1979711854/riscv-cpu-fpga/doc/board/README.md

# 本地板实测证据（盘古 MES2L676-200HP）

> 采集方式：`scripts\serial_monitor.ps1 -Port COM4`
> （COM4 = `Silicon Labs CP210x USB to UART Bridge`，板载 USB-UART；COM12/COM13 是 JTAG 下载器的 FTDI 通道）
>
> 板上资源：`clk=D18`(27MHz 晶振)、`resetn=C22`、`UART=B24/C24`、LED/KEY 见
> `pds/RV32I_1/RV32I_1.fdc` 头部注释。

> [!] **当前口径（2026-10-17）：`feat/mem128k` 交付 = rev1028 单一位流 `b45941d6`**
> 76.5052 MHz（`STATIC_RATIO0=15.0`）+ 顺序双发射 + `EARLY_LD` + `LANEB_MEM=1`、Cache 全关、`A_EXT=0`；
> 每迭代 **217,036.1** 拍（仿真 217,088）⇒ **主分 4.6075 CoreMark/MHz**、经典分 **352.5**
> （ITER=3900，`Total ticks 846,440,591` = 11.0638 s），四 CRC `e9f5/e714/1fd7/8e3a`；
> CPU 域 **+0.304 ns / 0 失败端点（21,135）/ Fmax 78.3269**、LUT **7,740**、`All Constraints Met`。
> 日志 `uart_20261017_190201.txt`；**唯一数字源** `doc/reports/2026-10-17_delivery_rev1028.md`。
> **更优候选 rev1029（`c642c0ac`：LUT 6,932、指标③ +11.7%、拍数逐位不变、已上板）在 `feat/lut`，未合并。**

> **[OK] 2026-10-19 T7 演示线（分支 `feat/coremark-display`）**：combined 位流
> **`6E2D6020…`**（17:01:11，boot + CoreMark + RT，48,270 行 / 24,135 字），76.5052 MHz、
> CPU 域 **+0.304 ns / 0 失败端点（21,135）/ Fmax 78.3269**；RT-Thread 堆 **1,440B**；
> 裸机 CoreMark **352.5**（`Total ticks 846,440,591`，四 CRC 全对）。
> 日志 `uart_20261019_184426.txt`：标题/菜单/AI 完整一局约 195 s 无 TRAP、堆恒定 1440B；
> 复位问题未复现；`vblank timeout` 每次 boot 都打印但画面正常（STATUS 位误报）。
> **注意：RT 终端屏是邮箱成绩重放，不是 RT-Thread 跑 CoreMark。**

> [!] **下面是 2026-10-16 的历史口径（rev1027 / 85.0051 MHz / `c6af65be` / 391.66 分）—— 只作对照，禁止引用到交付页**
> **历史口径（2026-10-16，rev1027 = 1 档）：85.0051 MHz + 顺序双发射 + `EARLY_LD` + A1（乘法器 II=1）
> + RAS(16)/BTB(256) + **`LANEB_MEM=1`（lane B 放 load）**，**A 扩展默认关（`A_EXT=0`）**、Cache 全关** ——
> 每迭代 **217,036.1** 拍（仿真 217,088）⇒ **[OK] 已板上实测 `391.66` 分**（ITER=4332，
> `Total ticks 940,200,316` = **11.0605 s**，四 CRC `e9f5/e714/1fd7/8e3a` 与仿真**逐位一致**、
> `Correct operation validated`，日志 `uart_20261016_155605.txt`；位流 **`c6af65be`** / `RTL=0x20261027`，
> PDS CPU 域 **+0.277 ns / Fmax 87.0549 MHz**，布局**钉 `gplace_seed 5`**）。
> ⇒ **主分（CoreMark/MHz）从 4.3555 升到 4.6064（+5.76%）**；同次运行的经典分从 370.31 升到
> 391.66（= 效率 × 主频，**参考口径、非主分**；赛题公式 `Score = Iterations ÷ Total_ticks`
> 直算主频约掉，见任务书 v12 §0.1）。
> **[OK] 演示档也已切到 1 档（2026-10-16 16:30）—— 两个交付档现在同为 rev1027 / `LANEB_MEM=1`**：
> 位流 **`e51ac9e5`**（`RTL=0x20261027`，CPU 域 **+0.277 ns / Fmax 87.0549 MHz**，同样钉 `gplace_seed 5`），
> 上板四条判据全过（banner / render+AI 两条线程 / `[hb]` 5000→50000 无断 / **真按键接 HDMI 下完一局
> 判出 `WHITE wins`**、`D18` 常亮、显示正常），日志 **`uart_20261016_163009.txt`**（333 行）。
> 0 档演示档 `1e2075e6`（rev1023）降为历史参照，**别再烧**。
>
> **[OK] 2026-10-16 深夜：T6 整合后重出演示档 —— `e51ac9e5` → `5909a2d0`**。
> 队友 T6 改了 gomoku 固件（`mem.hex` 21046→**22028** 行）⇒ 演示档必须重出。
> **[!] 重出前先把 A1（lane B 放 store）从树里退回** —— A1 虽判【不采纳】但实现留在树里，
> 而关档只折叠 FF、没折叠逻辑 ⇒ 净表 LUT +122 ⇒ **钉住的 `gplace_seed 5` 余量作废**
> （实测 `+0.277 → −0.156 ns`，85 MHz 下 5 个失败端点）⇒ 直接重出会出**时序不过**的位流。
> 退回后 **`5909a2d0`**（2026-10-16 23:18:53 综合）：CPU 域 **+0.277 ns / 0 端点（19,114）/
> Fmax 87.0549 MHz**、LUT **7,767**（历史记 7,753，差 14 = 报数抖动）/ FF 3,691 —— **与 `c6af65be` 逐位相同**。
> **`e51ac9e5` 降为"T6 前的前一档"**（16:30 那次上板四条判据全过，留作 T6 前的历史对照）。
> **[ ] `5909a2d0` 板上待验**：原四条判据 + **T6 新增两条**（标题屏竖排菜单可见、↑/↓ 移光标、←/→ 改值；
> 棋盘外框 + 坐标轴 A-O / 1-15、落子后最后一手有红标）。
> **[!] 位流 md5 不是布局指纹**：同一布局两次构建 md5 就不同（`9b58e84c`/`28f8ae6b`、
> `2e966285`/`c1b7e279`/`c6af65be`），而 `RTL` 自证行与 `9b58e84c` **同为 `0x20261027`**
> ⇒ 判"板上烧的是哪颗"**只能靠 md5 + 日志时间**，不能靠 `RTL=` 行。
>
> [!] **上一代口径（2026-10-15，rev1023 = 0 档）：85.0051 MHz + 顺序双发射 + 任务C `EARLY_LD` + A1（乘法器 II=1）
> + RAS(16)/BTB(256)，**A 扩展默认关（`A_EXT=0`）**、Cache 全关** ——
> 每迭代 **229,597** 拍 ⇒ **[OK] 已板上实测 370.31 分**（ITER=4332，
> 跑分档位流 `55fae69e` / `RTL=0x20261023`，日志 `uart_20261015_234123.txt`）。
> 两个交付位流都已板上验证：跑分档 **`55fae69e`**（370.31 分）、
> 演示档 **`1e2075e6`**（RT-Thread 五子棋，四条判据 + HDMI 显示全过，日志 `uart_20261015_233418.txt`）。
> （PLL `STATIC_RATIO0` = 13.5；`cpu_top.v` 的 `DUAL_ISSUE = 1`、`EARLY_LD = 1`、
> `DCACHE_EN` / `ICACHE_EN` 默认 0；见 `doc/board_bringup.md`）。
> [!] **灯（`cpu_top_board.v:178-182`，`DEBUG_LED=1`）**：`led[0]`=pll_locked(**D19**)、
> `led[1]`=video_locked(**D18**)、`led[2]`=done(**D13**)。
> **注意：`D13`(done) 只在跑分档跑完后亮；RT-Thread 演示档不会亮，别误判成挂了。**
> （`D:\riscv-cpu-fpga` 存档仓的 `CLAUDE.md` 约定 26 写的是两年前的 "`led[1]=done`"，
> 那是 62MHz 时代的口径 —— **本仓的约定 26 是对的，别去"修"本仓的**。）
> **下面各节的 MHz 数、位流 md5、以及"当前设计"这类措辞，按【当时那一代】理解。**
>
> **最新两代（2026-10-11/12，本节顶部已单列）**：
> - 85.0051 MHz 双发射 + `EARLY_LD`：CoreMark **351.86**（ITER=4116），位流 `2ddaf32f`（无 Cache）
>   / **`2f7a4d0a`（只开 D-Cache，分数完全相同 —— **评估档**（提交档 = Cache 全关 @85.0051，见论文框架 §0.1））**，日志 `uart_20261011_225624.txt` /
>   `uart_20261012_002541.txt`
> - **I+D Cache 全开 @76.5052 MHz：CoreMark 325.96（A1 后，ITER=3800，位流 `da8ffd31`）；A1 前 313.63 / 位流 `c6b12d95`**，日志 `uart_20261012_155934.txt` / `uart_20261013_195230.txt`
> - ⚠️ I+D 的**前一版 `fa957dbd` 板上失败**（含 bug，只有 banner 循环）：
>   日志 `uart_20261012_010314.txt` / `_010344.txt`
>
> **最新一代（2026-10-14 13:59）**：**RT-Thread + I+D Cache @76.5052 MHz，位流 `90944754`（`RTL=0x20261019`）
> —— 两条根因修完后的第一颗带 Cache 位流，上板串口侧通过**（见本节顶部那节）**。
>
> **最新一代（2026-10-14 18:49）**：**裸机五子棋（T2/T3 菜单+HUD）@76.5052 MHz，位流 `dd4fecb4`
> （`RTL=0x20261019`，+0.773ns/0 端点）—— 两局实测 + 串口 29 快照复盘全合法**（见本节顶部那节）。
>
> 更早的各代见下方各节与 `doc/reports/2026-10-04_coremark_score.md`。

## 【[OK] T7 combined 三路径 + 渲染修复（2026-10-19 18:49，R5）

- 位流 **`6E2D6020…`**（17:01:11，combined：boot + CoreMark + RT），76.5052 MHz；
  RT-Thread 固件 build 16:49:39，`[boot] heap = 1440 bytes`。
- 日志 `uart_20261019_184426.txt`（372 行）：
  - 全日志**无 TRAP**；标题屏、菜单、子菜单、对局正常；
  - AI vs AI `NORMAL vs NORMAL` 完整一局约 **195 s**，每手 depth=4、0.3~1.9 s，
    `[hb]` 每 5 s 不断，**堆恒定 1440B**；
  - 官方 CoreMark：`Total ticks 846440591`、四 CRC 全对、354 iter/s；
  - 多次复位（对局后 / CoreMark 后 / 演示屏后）均正常回到标题页，
    **上次“只有背景色”未复现**；
  - `[!] vblank timeout` 每次 boot 都打印但画面正常 ⇒ **STATUS 位误报**。
- 修复：菜单最后一项金线改画 `row+1`；最后一手棋子用真实黑/白格 + 右上红三角
  （专用 tile 249/252），不再出现木色缺角。
- 关联日志：`uart_20261019_163401.txt`（首次 CoreMark + 演示屏）、
  `uart_20261019_163603.txt`（EASY/NORMAL 对局）。

## 【[ ] 1 档演示档 · **T6 版**重出（2026-10-16 23:18 综合）—— **板上待验**

> 位流 `rtthread_dual_noaext_ms_earlyld_a1_ras_btb_gomoku_g3_lanebmem_85mhz_rev1027_seed5pin_5909a2d0.sbit`
> （md5 **`5909a2d0`**，`RTL=0x20261027`，`LANEB_MEM=1`、Cache 全关、85.0051 MHz，
> **PDS CPU 域 +0.277 ns / 0 端点（19,114）/ Fmax 87.0549 MHz**，布局钉 `gplace_seed 5`；
> `scripts\build_bitstream.ps1 rtthread` 于 23:18:53 出，固件 **`mem.hex` 22028 行 / 11014 字**、sha256 守卫通过）。
> **与跑分档 `c6af65be` 同净表同种子**（LUT 7,767 / FF 3,691 / +0.277 ns 三个数逐位相同）。
> **[!] 烧之前核 md5 = `5909a2d0`**，并把 `generate_bitstream\cpu_top_board.sbit` 与
> `bitstreams\..._5909a2d0.sbit` 对一下 —— 约定 23：那个固定文件名看不出里面是哪一版。

| 判据 | 期望 |
|---|---|
| 版本自证 | `[build] FW=RTTHREAD-GOMOKU-G3 **RTL=0x20261027**` ✓（**rev1027 的 rtthread 位流现在有两颗**：本颗与 T6 前的 `e51ac9e5`，`RTL=` 行分不出来 —— 要靠 **T6 的菜单措辞**区分：新版打 `left/right = change value`，旧版打 `left/right = OK`）|
| 两条线程 | `[boot] gomoku render thread running` + `[boot] gomoku ai thread running` |
| 心跳 | `[hb] alive` 5000→50000 **十条无断** |
| 真下棋 | 接 HDMI 真按键下完一局判出 **`WHITE wins`**；`D18` 常亮、显示正常 |
| **T6 新增①** | **标题屏竖排菜单可见**；↑/↓ 移光标、←/→ 改值、长按确认进 HUMAN 子菜单 |
| **T6 新增②** | **棋盘外框 + 坐标轴（A-O / 1-15）**显示正常；落子后**最后一手有红标** |

> 灯：`D19`(pll_locked) / `D18`(video_locked) 常亮；**`D13`(done) 本变体不亮，别误判**。

## 【[OK] 1 档演示档（RT-Thread 五子棋）上板（2026-10-16 16:30）—— **四条判据全过**（**T6 前的前一档**）

> 位流 `rtthread_dual_noaext_ms_earlyld_a1_ras_btb_gomoku_g3_lanebmem_85mhz_rev1027_seed5pin_e51ac9e5.sbit`
> （md5 **`e51ac9e5`**，`RTL=0x20261027`，`LANEB_MEM=1`、Cache 全关、85.0051 MHz，
> **PDS CPU 域 +0.277 ns / 0 端点（19,114）/ Fmax 87.0549 MHz**，布局钉 `gplace_seed 5`；
> `scripts\build_bitstream.ps1 rtthread` 于 16:19:57 出，固件 `mem.hex` 21046 行 / 10523 字、sha256 守卫通过）。
> 日志 **`uart_20261016_163009.txt`**（333 行，16:30:10–16:31:10）。
> **这一版让"1 档统一定版"成立**：跑分档与演示档现在同为 rev1027 / `LANEB_MEM=1` 的同一份 `rtl/**`。

| 判据 | 实测 |
|---|---|
| 版本自证 | `[build] FW=RTTHREAD-GOMOKU-G3 **RTL=0x20261027**`（app 侧 `FW=GOMOKU RTL=0x20261027` 一致）✓ —— **rev1027 的 rtthread 位流只有这一颗**，旧档 `1e2075e6` 是 rev1023（会打 `0x20261023`）⇒ 自证即"烧对了" |
| render 线程 | `[boot] gomoku render thread running` ✓ |
| AI 线程 | `[boot] gomoku ai thread running` ✓ |
| 心跳（`[hb]`） | `uptime 5000 → 50000 ticks` 共 **10 条、每 5 s 一条、单调递增、无断** ✓（AI 思考 286~609 ms 期间照常）|
| **真按键 + HDMI 下完一局** | 串口镜像：光标 `H8→I8→J8→K8→L8→L9→L10` 逐步移动 + 落子 + AI 应手，**判出 `WHITE wins`**；回 `title` 后**第二局又开了**（`menu=MODE→DIFFICULTY→COLOR→start, level=NORMAL you=BLACK`）✓；**用户接 HDMI 显示器显示正常、`D18`(led[1]=video_locked) 常亮** ✓ |
| 灯 | `D19`(pll_locked) / `D18`(video_locked) 常亮；**`D13`(led[2]=done) 本变体不会亮，别误判** |

> **1 档功能仿真（顺手补上从 P3 起挂账的回归）**：`scripts\gomoku\run_sim.ps1`（端到端，真 CPU + 真 PPU）
> 首行自证 `SIM CONFIG: DUAL_ISSUE=1 EARLY_LD=1 LANEB_MEM=1` ⇒ **6/6 checks、`=== PASS ===`**
> （2026-10-16，24 min 墙钟；日志 `doc/reports/2026-10-16_gomoku_g3_lanebmem1_sim.txt`）。
> ⇒ 1 档现在"仿真 + 跑分上板 + 演示上板"三处证据齐了。

> [!] 同一日志第 31 行的 `[!] vblank timeout -- video not running (check D18 video_locked)`
> 仍是**已知假超时**（0 档 `1e2075e6` 的同款日志也有这句，而当时 D18 亮、画面正常）——**判据看 D18，不看这句话**。
> [!] **应用侧旁证（非受控测量）**：同一开局位置 `nodes=1287 depth=4`，本颗（rev1027 / 1 档 / 85.0051 MHz）
> 是 `t=569ms`；0 档 rev1019 的 RT-Thread 档（76.5052 MHz）是 `t=672ms`。含主频 +11.1% 与 lane B 的效率收益，
> 也含 RT-Thread 调度噪声 ⇒ **只当"应用侧也更快"的旁证，别当性能数字引用**。

## 【[OK] 1 档（lane B 放 load）跑分档上板（2026-10-16 15:56）—— **391.66 分**

> 位流 `coremark_dual_noaext_ms_earlyld_a1_ras_btb_lanebmem_85mhz_rev1027_seed5pin_c6af65be.sbit`
> （md5 **`c6af65be`**，`RTL=0x20261027`，`LANEB_MEM=1`、Cache 全关、85.0051 MHz，
> **PDS CPU 域 +0.277 ns / 0 端点（19,114）/ Fmax 87.0549 MHz**，布局钉 `gplace_seed 5`）。
> 日志 **`uart_20261016_155605.txt`**（20 行，一次跑完）。
> 这一版是 **1 档（`LANEB_MEM=1`）第一次上板**，也是 P3.5/P3.6 的交付候选。

| 判据 | 实测 |
|---|---|
| 版本自证 | 首行 `[build] FW=COREMARK RTL=0x20261027` ✓（**与 `9b58e84c` 同 REV，靠 md5 区分**）|
| `Total ticks` | **940,200,316** ÷ 85,005,100 = **11.0605 s** ⇒ **391.66 CoreMark**（经典分；**主分 = 10⁶ ÷ 217,036.1 = 4.6076 CoreMark/MHz**，`Iterations 4332`）|
| 拍/迭代 | **217,036.1**（仿真 217,088 ⇒ **−0.0239%**，在 ±0.04% 模型口径内 ✓）|
| `Correct operation validated` | ✓ |
| **四 CRC** | **`e9f5 / e714 / 1fd7 / 8e3a`** —— 与 0 档仿真/实测**逐位一致**（`crcfinal 0xa996` 亦同，因为 ITER 相同）✓ |
| 有效性 | 真实秒数 11.0605 s **≥ 10 s** ✓（余量 10.6%，0 档是 17.0%）|
| 得分对照 | **391.66 vs 0 档 370.31 ⇒ +5.76%**（同为 85.0051 MHz；主分口径 4.6076 vs 4.3555 CoreMark/MHz）|

> [!] 口径细节：日志里的 `Iterations/Sec 393` 是 `HAS_FLOAT=0` 的**整数截断假值**
> （4332 ÷ 截断成 11 的秒数），**真实得分 391.66**；`Total time (secs) 11` 同理。
> [!] 计时区间与 0 档完全一致（同一份 CoreMark 固件、ITER=4332），所以 940,200,316 与
> 994,412,748 的差**全是流水线效率**（每迭代 217,036 vs 229,551 拍），**不含任何提频**。

## 【[OK] CoreMark 跑分档对齐 rev1023 上板（2026-10-15 23:41）—— **370.31 分**

> 位流 `coremark_dual_noaext_ms_earlyld_a1_ras_btb_85mhz_rev1023_55fae69e.sbit`
> （md5 **`55fae69e`**，Cache 全关、85.0051MHz、CPU 域 +0.330ns/0 端点，ITER=4332）。
> 日志 **`uart_20261015_234123.txt`**（20 行）。

| 判据 | 实测 |
|---|---|
| 版本自证 | 首行 `[build] FW=COREMARK RTL=0x20261023` ✓ |
| `Total ticks` | **994,412,748** ÷ 85,005,100 = **11.6983 s** ⇒ **370.31 CoreMark**（`Iterations 4332`）|
| `Correct operation validated` | ✓ |
| **四 CRC** | **`e9f5 / e714 / 1fd7 / 8e3a`** —— 与仿真**逐位一致** ✓（最硬的判据）|
| 拍/迭代 | **229,550.5**（仿真 229,597，差 **−0.0203%**，在 ±0.04% 抖动内）|

> `crcfinal 0xa996` **不要比** —— 它是跨迭代累加器，必随 ITER 变（约定 29）。
> 日志里的 `Iterations/Sec 393` 与 `Total time (secs) 11` 都是 `HAS_FLOAT=0` 的**整数截断**，别用。

**意义**：在这之前，板上已验证的最好成绩是 `f64b977`（**rev1022、A 扩展还在**）的 370.23。
本颗把**新的生产口径**（rev1023 / `A_EXT=0`，省 441 LUT / 224 FF）也钉在了板上 ——
分数 370.23 → **370.31** 的 +0.02% 是**抖动**（两代在仿真里周期数逐位相同），
**不是性能变化**。此前的口径分裂就此消除：跑分档与演示档现在**同 RTL、同 DESIGN_REV**。

## 【[OK] RT-Thread 五子棋演示档对齐 rev1023 上板（2026-10-15 23:34）—— **应用场景必备项闭环**

> 位流 `rtthread_dual_noaext_ms_earlyld_a1_ras_btb_gomoku_g3_85mhz_rev1023_1e2075e6.sbit`
> （md5 **`1e2075e6`**，Cache 全关、85.0051MHz、CPU 域 +0.330ns/0 端点）。
> 日志 **`uart_20261015_233418.txt`**（58 行）。

**背景**：上一颗演示档 `176e0028` 是 **rev1022、A 扩展还在**的 RTL，而跑分档已走到
`55fae69e`（rev1023 / `A_EXT=0`）。**直接验 `176e0028` 等于验一颗不交付的位流** ——
正是 rev1017→rev1019 那次踩过的坑。故按新 RTL 重出本颗再验。
**`176e0028` 自此作废，不要再烧。**

| 判据 | 实测 |
|---|---|
| 版本自证 | 首行 `[build] FW=RTTHREAD-GOMOKU-G3 **RTL=0x20261023**` ✓（读 `mimpid`，运行时取 ⇒ 位流权威自证，不是烧成旧的） |
| render 线程 | `[boot] gomoku render thread running` ✓ |
| AI 线程 | `[boot] gomoku ai thread running` ✓ |
| 心跳 | `[hb] alive, uptime 5000 → 25000 ticks` 五条、每 5 s 一条、**单调递增、无断** ✓（`[hb]` 能挤进来 = render 没独占 CPU，**这正是 G3 的前提**） |
| **显示侧** | **用户接 HDMI 显示器下棋正常；板上 `D18`（led[1]=`video_locked`）常亮** ✓ |
| 交互 | 菜单真的走通：`menu=MODE` → `menu=DIFFICULTY` → `menu=COLOR` → `start, level=EASY you=BLACK`；串口棋盘镜像渲染出完整 15×15 + `cursor=H8 you=BLACK turn=BLACK` ✓ |

**[OK] `[!] vblank timeout` 就此定案为【假超时】**：本颗日志同样打这句（第 31 行，
字面是 `video not running`），而 **D18 亮着、显示器画面正常** ⇒ 它**不是"显示坏了"**，
而是软件采样粒度问题（`rt_thread_mdelay(1)` ≈ 1 ms 采样去看 62.7 µs 的 vsync 脉冲，
见本节 T1/G3 那节的完整机制与 A/B/C 三个处理方案）。**判据看 D18，不看这句话。**

**灯**：`D19`(led[0]=pll_locked) 与 **`D18`(led[1]=video_locked) 常亮**；
**`D13`(led[2]=done) 本变体不会亮，别误判**。

## 【[OK] 裸机五子棋 T2/T3 整合版上板（2026-10-14 18:49 / 18:53 两局）—— CPU 侧无问题

> 位流 `gomoku_dual_aext_ms_earlyld_a1_76mhz_rev1019_dd4fecb4.sbit`（md5 `dd4fecb4`，
> Cache 全关、76.5052MHz、CPU 域 +0.773ns/0 端点）。日志 `uart_20261014_184921.txt`（人机局，183 行）/
> `uart_20261014_185341.txt`（AI 对弈局 HARD vs NORMAL，421 行）。

**这是队友 T2/T3 交接包并入 `dualissue`（commit `96e0722`）后的第一颗裸机 gomoku 位流**，
要验三件事：菜单交互、整局规则、CPU 有没有问题。复盘工具：`python scripts\gomoku\replay_log.py <日志>`
（逐快照校验落子合法性/轮色/`*` 标记/五连，29 个快照**零冲突**）。

| 判据 | 实测 |
|---|---|
| 版本自证 | 首行 `[build] FW=GOMOKU RTL=0x20261019` ✓ |
| 菜单 | MODE→(HUMAN)DIFFICULTY→COLOR 三确认开局；每项变化都有串口反馈（`menu=`/`mode=`/`you=`/`black=`/`white=`/`step=`） |
| 整局规则 | 人机局 AI 在 N8 挡住人的四连、随后 G5 成**竖五连 G5-G9** ⇒ `WHITE wins`，相位正确转 GAME_OVER、无续走；AI 对弈局 14+ 手全合法（中途回标题重开也正常） |
| CPU 侧 | **无问题**：零棋子变色、零非法落子、判胜正确、无 `[!] vblank timeout`（接了显示器） |
| 已知显示偏差 | AI `t=` 低约 10%（`CPU_HZ` 写死 85,005,100，任务书 v4 §3.3）；长按阈值约 0.67s |

**[!] 手工复盘踩过的坑**：`WHITE wins` 出现在**人落子之后**曾被人误判"判胜颜色错/游戏没停"——
实际是那一帧人落子 O9、下一帧 AI 在 G5 成五，串口顺序 `cursor=O9` → `WHITE wins` → `AI moved` → 快照。
**手工数列对齐必错，用 replay_log.py。** 三个固件小瑕疵（回标题假 `AI moved` / `AI thinking` 死路径 /
`t=` 偏差）见任务书 v4 §3，归五子棋线。

## 【[OK] RT-Thread + I+D Cache @76.5052 MHz（rev 1019）上板 —— 之前确定性挂死的组合，现在通了（2026-10-14 13:59 / 14:11 两次）

> 两次抓取、同一颗位流：13:59 验"起得来、活过 20 s"；**14:11 验"真按键下完一局 + 接屏下棋正常"**。

日志 `uart_20261014_135935.txt`（抓 27 s / 30 行）。位流
`rtthread_dual_aext_ms_earlyld_a1_gomoku_g3_idcache_76mhz_rev1019_90944754.sbit`（md5 `90944754`）。

**这一颗要验的就是"带 Cache 的 RT-Thread 到底还挂不挂"** —— 同样是 **I+D Cache 全开 @76.5052 MHz**，
修复前那两颗的表现是：`c10a2478` 死在"AI 第一手后的第一张棋盘快照"（只有一行 `?? turn=WHITE`），
`9feaa089` 卡在 `[boot] heap = 9368 bytes` 循环重启（banner 打 3 次）。**现在两条线程都起来、
调度器活过 20 s。**

| 判据 | 实测 |
|---|---|
| **版本自证（权威）** | `[build] FW=RTTHREAD-GOMOKU-G3 RTL=0x20261019` ✓（五子棋侧同句：`FW=GOMOKU RTL=0x20261019`）|
| 两条线程都起来 | `[boot] gomoku render thread running` + `[boot] gomoku ai thread running` ✓ |
| 调度器在跑 / render 没独占 CPU | `[hb] alive, uptime 5000 / 10000 / 15000 / 20000 ticks` —— 每 5 s 一条、**单调递增、全程无断** ✓ |
| 时钟确实是 76.5052 而非 85 | 串口文本在 115200 下**完全可读**（`UART_DIV=664` 只对 76.5 MHz 成立；若真是 85 MHz 会偏 11% ⇒ 乱码）|
| **落子/对局 + 接屏** | **[OK] 追加验证（14:11，见下）：完整下完一局并判出胜负 `WHITE wins`；用户接显示屏下棋正常** |

### [OK] 追加验证 1：**完整对局 + 判定胜负**（2026-10-14 14:11，日志 `uart_20261014_141147.txt`，413 行）

同一颗位流（`RTL=0x20261019`），这次是**真按键下棋**：

| 判据 | 实测 |
|---|---|
| 按键全通 | 光标移动（`cursor=H8/G8/I8/…`）、落子、**难度切换**（`level=0 EASY` / `level=1 NORMAL` / `level=2 HARD`）、`SW3=reset` 都有响应 |
| **人机对局跑完整局** | 人执黑落 H8/G8/I8/L8/N8/N9… → **`WHITE wins`**（含五连判定） |
| **AI 线程真在算**（邮箱往返链） | NORMAL：`AI moved, nodes=1287/756/996/707/435 depth=4 t=398~672ms`；**HARD**：`AI moved, nodes=10592 depth=6 t=5737ms` |
| 调度器 | `[hb] alive, uptime 5000…25000 ticks`，每 5 s 一条、**全程无断**（AI 思考 5.7 s 期间画面/按键仍响应 = G3 的正题）|
| 显示侧（用户口述） | **接 HDMI 显示器下棋正常** —— T1/G3 那节留的"显示侧未验"到此关闭 |

> **[OK] 末尾那 3 次重新启动已确认 = 用户按了 `SW3`（本板设计上的复位键）**，不是异常重启
> （真崩溃是寄存器转储 + `[hb]` 断，不会是这样干净重打 banner）。**这项不再列为待查项。**

### [OK] 追加验证 2：接屏**下棋正常**（用户口述，2026-10-14）
`doc/board/README.md` 里 T1/G3 那节留的"显示侧未测"就此关闭。
（"AI 思考期间画面不卡"属同一现象的正常表现，但**没有逐帧量化** —— 答辩若要引用，
建议补一段录像或计时，别把"没卡"写成"已量化"。）

* [!] **踩到的坑（已修源码，未重出位流）**：横幅第 10 行打的是 `@85.0051MHz`，而本颗跑 76.5052 MHz
  —— 因为 `scripts/rtthread/app/main.c` 把主频**写死在字符串里**了（与位流/时钟无关，看着像烧错位流）。
  已改成从 `BOARD_SYSTEM_CLOCK_HZ` 算（`app/main.c:173` 的 `rt_kprintf`）。**判位流永远看 `RTL=` 那行。**
* [!] **已知噪声（不是失败）**：`[!] vblank timeout -- video not running` —— 同一句在无 Cache 的
  `8894cdcb` 日志里也有，机制见下面 T1/G3 那节（1 ms 采样 vs 63 µs 脉冲）。
  **它不是"显示坏了"**（用户已接屏下棋正常），**而是"vblank 等待变成了一次概率事件"**：
  * 固件（`scripts/gomoku/video_port.c:62`）在等 `VIDEO_STATUS` bit0；RT-Thread 侧
    `video_vblank_yield()` 是 `rt_thread_mdelay(1)` ⇒ **采样周期 ≈1 ms**；
  * 而 `rtl/video/video_core.v:139` 的状态位是 `vs_ph` —— **V_SYNC=2 行 ≈ 62.7 µs** 的脉冲，
    两者**异步时钟域**（tick 由 CPU 侧 1 ms 定时器驱动，脉冲由 pixel PLL 的 16.67 ms 帧驱动）；
  * ⇒ **命中是概率性的**：脉冲宽/采样周期 ≈ **6%**（按"最近一次采样距脉冲 ≤62.7 µs"算 ≈12%/帧）。
    等不到的调用由 **50 ms 超时**（`VIDEO_VBLANK_TIMEOUT_MS`，≈3 帧）兜底返回 ⇒
    **多数等待会走超时路径**，帧率与同步都不是设计意图（告警按设计"只打一次"，所以日志里只有一行）。
  * 裸机版没有 yield（空实现、紧忙等）⇒ 连续轮询必定捕获，所以 23 份裸机日志里从没这句 ✓。
  **怎么处理（三选一，成本递增、鲁棒性递增）**：
  | 方案 | 做什么 | 代价 | 效果 |
  |---|---|---|---|
  | **C（兜底）** | 把这行降级成 `[i]`（或连续 N 次失败才打）+ 文档写清机制 | 零 RTL 改动 | 日志干净了，但**同步依然是失效的** |
  | **B（小改）** | 状态位判据从"vsync 脉冲(62.7 µs)"换成"处于消隐期(后肩 33 行 ≈ 1.04 ms)" | RTL 一行（`video_core.v` 的 `vblank_s` 源）+ 回归 | 1 ms 采样能命中，**但 1.04 ms 窗 vs 1 ms 周期太临界**（`mdelay(1)` 实际可能 >1.04 ms）|
  | **A（推荐）** | **新增一个只读【帧计数器】**（每个 vsync +1，不动旧的脉冲位），固件改成"等帧号变化" | RTL ~4 行 + 固件 ~5 行 + 回归 + 重出位流 | **采样率无关**，`video_wait_vblank` 真正工作；旧位留着不破坏裸机路径 |
  * 归口：`rtl/video/**` 属视频线（**要申请**，见任务书 §5）；固件侧属五子棋线。
    回归 = `tb_video*` / `tb_gomoku` + `scripts\rtthread\run_sim.ps1 -ICache` + 上板。
* 另有一处 **~11% 的软性偏差**（本次未动）：`scripts/demo/addr_map.h:68` 的 `CPU_HZ` 写死 85,005,100u，
  它喂 `hw_ticks_per_ms()` ⇒ 76.5 档下 long-press 的 0.6 s 阈值实际约 0.67 s、AI 打印的 `t=…ms` 约低 10%。
  **纯阈值/显示，不影响功能**；要修得绑到 `BOARD_SYSTEM_CLOCK_HZ`（会同时改裸机五子棋与仿真的去抖口径，需回归）。

## 【[OK]+[!] RT-Thread T1/G3 双线程五子棋首次上板（2026-10-13 22:46）—— 串口侧全通，显示侧未测

日志 `uart_20261013_224652.txt`（抓 60 s / 133 行）。位流
`rtthread_dual_aext_ms_earlyld_a1_gomoku_g3_85mhz_rev1017_8894cdcb.sbit`（md5 `8894cdcb`）。
**板上没接显示屏**，所以只有串口证据。

**这是 T1/G3（render 高优 + AI 低优两条线程）第一次上板。**

### [OK] 通了什么

| 判据 | 实测 |
|---|---|
| 版本自证 | `[build] FW=RTTHREAD-GOMOKU-G3 RTL=0x20261017` |
| 两条线程都起来 | `[boot] gomoku render thread running` + `[boot] gomoku ai thread running` |
| 调度器在跑 | `[hb] alive, uptime 5000 … 50000`（每 5 s 一条、单调递增、全程无断）|
| **两线程之间的邮箱往返** | **[重点] `AI moved, nodes=10592 depth=6 t=5068ms` / `nodes=3894 depth=6 t=2040ms`** |
| 人对局逻辑 | 光标移动、落子、`occupied -- move the cursor and try again` 都对；棋盘快照逐手正确（黑 I8/H8、白 H7/G8，轮次交替、`*` 标最后一手）|

> **[重点] 上表最后一行才是这一版真正要验的。** RT-Thread 固件里链进去的是 `app/main.c` 的
> **强定义** `gomoku_ai_pump`（异步），弱定义（同步）根本没进 ELF（已用 `nm` 确认 ELF 里只剩一份）。
> **子既然落得下来，就说明"派单 → AI 线程算 → 邮箱送回 → render 落子"整条链在真板上走通了。**
> 这正是仿真验不到的那一段（`tb_rtthread.v` 不驱动按键，跑不出一手棋）。

### [!] 没通的：`[!] vblank timeout` —— 显示侧要单独定案

串口第 26 行打出 `[!] vblank timeout -- video not running (check D18 video_locked)`。

* 这句在**归档里是第一次**出现：`doc/board/` 里 **23 份裸机五子棋日志一份都没有**，而那些日志
  晚于这句代码入库（`709446f`，2026-10-10 12:39；最新裸机日志 14:40）——**不是"当时还没这句话"**。
* **机制**：T1 新加的 `video_vblank_yield()` 在 vblank 忙等里 `rt_thread_mdelay(1)`，
  即**每 ~1 ms 才看一次状态位**；而 RTL 里这个位是 `V_SYNC = 2` 行的脉冲
  （`H_TOTAL=810`、pixel clk 25.5 MHz ⇒ **≈63 µs**；`rtl/video/video_core.v:133` 的注释自己写着
  "2 行 …… = 62.7us"）。**拿 1 ms 的采样去看 63 µs 的脉冲，粒度差 16 倍。**
* `scripts/gomoku/video_port.c` 里那句注释假设的是"480p@60 的 **~1.4 ms** vblank 窗"——
  那是**后肩 33 行**（≈1.04 ms），**不是状态位报的那个 vsync 脉冲**；RTL 注释专门区分了这两者。
* **后果（日志无法定量 —— 这句按设计只打一次）**：`video_wait_vblank()` 很可能经常要等满
  50 ms 超时才返回 ⇒ render 主循环从 ~60 fps 掉到 ~20 fps，且 `draw_frame()` 会落在**消隐期之外**写显存。
* **怎么定案（一步）**：看板上 **led[1]（丝印 D18）= video_locked**。
  - D18 **亮** ⇒ 视频在跑、脉冲存在 ⇒ 只可能是被 1 ms 采样漏掉 ⇒ **真问题**；
  - D18 **不亮** ⇒ 视频真没起来（但那样裸机版也该报，却没报）。
  **或者直接接上显示器看画面顺不顺。**

> 这与 T1 的邮箱改动**无关** —— 那一块真通了（见上表）。这是同批改动里的另一处，
> **且正落在 G3 最在意的那条路径上**，所以单列。

## 【[OK] I+D Cache 上板通过】完整 I/D Cache 首次在真板上跑通（2026-10-12 15:59）

位流 `coremark_dual_aext_ms_earlyld_idcache_76mhz_rev1016_c6b12d95.sbit`（md5 `c6b12d95`；
`RATIO0=15.0` → 76.5052 MHz；**`RTL=0x20261016`**，含 `wb_rdata_snap` 根因修复），
ITER=3668，日志 **`uart_20261012_155934.txt`**：

| 项 | 值 |
|---|---|
| 首行 | `[build] FW=COREMARK **RTL=0x20261016**`（修复后的网表自证）|
| `Total ticks` | **894,745,801** → **11.6952 s**（≥10 s，有效）|
| **得分** | **313.63**（`3668 × 76,505,200 ÷ 894,745,801`）|
| 四个 CRC | `e9f5 / e714 / 1fd7 / 8e3a` **与关 Cache 时逐位相同** + `Correct operation validated` |
| `[cache] D` | hits 31,555,354 / miss 22,423 ⇒ **99.929%** |
| `[cache] I` | hits 878,103,971 / miss 9,006,928 ⇒ **98.985%** ← **I-Cache 首次板上计数非 0** |

**判读**：① 逻辑对（四个 CRC + 官方结论行）；② **两个 Cache 都真在跑**（计数都非 0）；
③ 相对 85 MHz 版经典分 **−10.9%**；按 2026-10-16 公式口径裁决（主频约掉）**真实代价 = 效率
**−7.9%**（4.244 vs 4.6076），主频下降只是"I-Cache 在取指关键链上、塞不进 85 MHz 时序"
的实现约束（旧拆账"−10.0% 主频 + −0.95% 周期"已作废，任务书 v12 §0.2 #4）。
全流程见 `doc/reports/2026-10-12_idcache_board_bitstream.md`。

> [!] **上一版 `fa957dbd`（同配置、含 bug）板上只有 banner 循环、两个 cache 计数全 0**
> —— 两节对照，就是"修好了"的证据形态。

## 【二分证据】D-Cache + 降频 76.5 MHz 板上通过 ⇒ 故障锁定 I-Cache（2026-10-12 01:23）

位流 `coremark_dual_aext_ms_earlyld_dcache_76mhz_a69a19b5.sbit`（md5 `a69a19b5`，ITER=3700），
日志 **`uart_20261012_012310.txt`**：`Total ticks 893,885,762` → **11.6842 s**，
**四个 CRC 与仿真逐位相同**、`[cache] D hits=31,739,605 / miss=22,616`（**99.929%**）、
`[cache] I` 全 0、得分 **316.7** ✓。
**判读**：降频口径（RATIO0=15.0 + 4 处常量 + 固件）全部正确 ⇒
**I+D 版（`fa957dbd`）板上的反复重启，故障 100% 在 I-Cache**（同一配置只把 I-Cache 打开就崩）。

## 【Cache 证据】D-Cache 板上实测通过：命中率 **99.93%**、CRC 与关 Cache 时逐位相同（2026-10-12）[OK]

位流 `coremark_dual_aext_ms_stage01_earlyld_dcache_2f7a4d0a.sbit`（md5 `2f7a4d0a`，ITER=4116），
日志 **`uart_20261012_002541.txt`**。这是**高阶任务①（2 路组相联 Cache）真在硬件上跑**的证据：

| 判据 | 实测 | 判读 |
|---|---|---|
| `[cache]` 计数 | **D hits = 35,341,114 / D miss = 25,081** | **非 0 ⇒ Cache 真在工作**；命中率 **99.929%** |
| `[cache]` I 计数 | 0 / 0 | I-Cache 本版**按设计关闭** ✓ |
| 四个 CRC | `e9f5 / e714 / 1fd7 / 8e3a` | **与关 Cache 时逐位相同** ⇒ **Cache 只改周期、不改结果** ✓ |
| `Total ticks` | **994,386,960** → ÷85,005,100 = **11.69797 s** | 关 Cache 那版是 994,362,145（11.69768 s）|
| 拍/迭代 | **241,590.6**（关 Cache 版 241,584.6）| **+6.0 拍（+0.0025%）** |
| 得分 | **351.86**（关 Cache 版 351.86）| **开了不涨也不跌** ✓ |

> [!] **代价可以逐项闭合**：区间内 D-Cache **每迭代 6.09 次缺失**，每次缺失 1 拍 ⇒
> **+6.09 拍/迭代 —— 与实测的 +6.0 拍吻合**。这也再次说明"命中 1 拍 = 零收益"：
> 后端是单周期 BRAM，命中与不命中的**数据路径一样快**，Cache 的全部开销就是那几次缺失。

> [!] **命中率口径别混**（本项目踩过多次这类坑）：
> * **板上 ITER=4116（热态）= 99.929%**（每迭代 6.09 次缺失）← **报告里用这个**
> * 仿真 `-Iter 1` = 93.5%（每迭代 642 次缺失）—— **冷启动占绝大多数**，不是稳态
> * 更早的"98.47%"是**任务 C 之前、全部 load 都过 Cache** 时量的，**口径已经作废**

## 【跑分口径，A1 前】CoreMark **351.8 分**：85.0051 MHz + 双发射 + **任务C（EARLY_LD）**，2026-10-11 晚板上实测通过 [OK]

> [!] **A1（乘法器 II=1，2026-10-13）之后**：同一配置每迭代 241,633 → **232,345** 拍 ⇒
> **已板上实测 365.93 分**（ITER=4280，见 `uart_20261013_184111.txt`）。**本节是 A1 前的板上原始记录，数字按 A1 前读。**

位流 `coremark_dual_aext_ms_stage01_earlyld_2ddaf32f.sbit`（md5 **`2ddaf32f`**，ITER=**4116**），
日志 **`uart_20261011_225624.txt`**。**一次通过**：

| 项 | 值 | 判读 |
|---|---|---|
| 版本自证 | `[build] FW=COREMARK RTL=0x20261015` | 确认跑的是任务C 之后的网表（约定 42）|
| `Total ticks` | **994,362,145** | 预期 994,561,428（= 4116 × 241,633），**差 0.02%** |
| 时长 | 994,362,145 ÷ 85,005,100 = **11.6976 s** | > 10s，CoreMark **valid** |
| 得分 | 4116 ÷ 11.6976 = **351.8** | 上一代板上是 324.5（`4f1b0977`）⇒ **+8.4%** |
| 四个 CRC | `e9f5 / e714 / 1fd7 / 8e3a` | **与仿真逐位相同** ⇒ 真机算得对 |
| `Correct operation validated` | 有 | ✓ |
| 每迭代周期 | 994,362,145 ÷ 4116 = **241,584** | 仿真 241,633 —— **板上快 49 拍（−0.02%）** |

> [!] `Total time (secs)` 打印的是 **11**（整数截断，`HAS_FLOAT=0`）—— 真值是 11.6976 s，
> 一律用 `Total ticks ÷ 85,005,100` 自己算。`crcfinal`（这里 `0x4a0d`）**不比**（跨迭代累加器，见约定 29）。

> [!] **板/仿真差 −0.02%**（板上快 49 拍/迭代），与历史三代的 ±0.003% 同量级、方向仍在抖动带内。
> **"周期数与时钟无关"这条口径在 241,584 这个新数字上继续成立。**

## 视频线板上实测：**视频子系统（HDMI）**（当时 CPU 侧 62.03 MHz），2026-10-01 上板，链条验到第 3/4 段 [OK]

合并后的第一版（CPU 侧 62.03 MHz + 两拍乘法器；视频侧 HDMI 480p60 tile PPU）。
**视频彩条固件已在真板跑通**，日志 `uart_20261001_210608.txt`，位流 md5 `75871d8a`。

| 段 | 状态 | 依据 |
|---|---|---|
| CPU PLL 锁定 | [OK] | 丝印 **D19** 常亮 |
| **视频 PLL 锁定**（÷45 → 25.5MHz 像素 / ÷9 → 127.5MHz 并串）| [OK] | 丝印 **D18** 常亮 |
| CPU → mem_bus → 显存（写/读回）| [OK] | 串口 **`SELFCHECK OK`**（10 个读回值全对）|
| PPU 扫出的像素 | [OK] | 仿真 `tb_video_bars.v` 8 条彩条逐点比对 PASS |
| TMDS 编码/相位 + 显示器认不认时序 | **未验** | **没有 HDMI 线/显示器**，只能等硬件 |

> **灯的读法（`DEBUG_LED=1`，本项目 video 变体的默认值）** —— 板上 LED 丝印（D12~D19）
> 相对开关是**乱序**的，别按手册 LED0..LED7 猜：
>
> | 丝印 | 亮 = 什么 |
> |---|---|
> | **D18** | **视频 PLL 已锁定**（HDMI 黑屏先看这一颗）|
> | **D19** | CPU PLL 已锁定 |
> | D13 | `done`（本变体**不会亮**，别误判）|
> | D12 / D14 / D15 / D16 / D17 | 本变体给 GPIO，**无诊断含义**，忽略 |
>
> 板上另有电源指示灯（**D22**）常亮 —— **它不在我们 8 颗用户灯里**，与设计无关。
> 完整两张表见 `pds/RV32I_1/RV32I_1.fdc` 头部注释。

> [!] **烧录实踩（2026-10-01）**：第一次烧完串口打出的是 **CoreMark**（`727,018,199`），
> 说明烧成了 **CPU 单仓那份 CoreMark 位流**（md5 `3f76e554`）而不是视频位流
> （md5 `75871d8a`）。**两者文件名相同、字节数也相同（9,188,552）**。
> 根因是 Fabric Configuration 记住上次分配的文件、且是在"分配时"读进内存的 ——
> 只点 `Program` 就重烧上次那份。详见 `pds/RV32I_1/bitstreams/README.md`。

## 上一代设计：**49.8927 MHz（PLL 倍频）+ 动态分支预测**，2026-09-25 板上实测通过 [OK]

2026-09-25 起板上时钟为 **49.8927 MHz**（板载 27MHz 经 PLL 倍频，`RATIO0=23`），
并在同一天加了 **256 项带 tag 的 BHT**（动态分支预测）。
**已验证通过**，日志 `uart_20260925_172318.txt`（30 秒内跑 2 轮，`Total ticks` 逐位相同）。

| | 27 MHz | 45 MHz | **49.89 MHz** |
|---|---|---|---|
| ITER | 820 | 1500 | **1663** |
| `Total ticks` | 294,262,913 | 538,285,445 | **588,890,651** |
| 时长算法 | ÷27e6 = 10.898 s | ÷45e6 = 11.9619 s | **÷49,892,700 = 11.8031 s** |
| 每迭代周期 | 358,857 | 358,857 | **354,113** |
| 得分 | 75.24 | 125.40 | **140.89** |
| 板上证据 | [OK] | [OK] | [OK] |

> **累计提升：75.24 → 140.89 CoreMark = +87.3%**（vs 45 MHz 那版 +12.36%）。
>
> **每迭代周期 358,857 → 354,113** 是 2026-09-25 加 BHT 的收益（省 4,727 拍 = 1.32%）。
> 而 27/45 MHz 两代**逐位相同**（都是 358,857）—— 那两代的时钟翻倍而周期数不动，
> 正是"周期数与时钟无关"的直接证据（45 MHz 时用于验证；49.89 MHz 这代因为
> 加了 BHT，周期数才变了，属设计改动而非时钟效应）。

> [!] **板/仿真差会双向抖动**：27/45 MHz 两代是 **+0.0031%**（板上慢 11 拍），
> 49.89 MHz 这代是 **−0.0016%**（板上快 6 拍）。方向相反、量级相同，
> 是仿真模型的抖动范围，**不是趋势**。别拿单次差值下结论。

---

## 历史：**45 MHz（PLL 倍频）**，2026-09-25 上午板上实测通过 [OK]

2026-09-25 上午起板上时钟一度改为 **45 MHz**（板载 27MHz 经 PLL 倍频，见 `doc/board_bringup.md` §2），
当天下午进一步提频到 49.8927 MHz（见上一节）。
**已验证通过**，日志 `uart_20260925_005201.txt`。

| | 27 MHz（历史） | **45 MHz（历史）** |
|---|---|---|
| ITER | 820 | **1500** |
| 每迭代周期 | 358,857（实测） | **358,857（实测，与 27MHz 逐位相同的口径）** |
| `Total ticks` | 294,262,913 | **538,285,445** |
| 时长算法 | ÷ 27e6 = 10.898 s | **÷ 45e6 = 11.9619 s** |
| 得分 | 75.24 CoreMark | **125.40 CoreMark（+66.7%）** |
| 板上证据 | [OK] | [OK] **已完成** |

> **"每迭代周期"在两个时钟下逐位相同（都是 358,857）** —— 这正是
> "周期数与时钟无关"的直接证据，也让"仿真数据可外推到板上"这条推论站得住。

## 证据清单

| 文件 | 内容 | 用途 |
|---|---|---|
| **`uart_20261011_225624.txt`** | [重点] CoreMark ITER=4116 @85.0051 MHz，**任务C（EARLY_LD）**，位流 `2ddaf32f`，**351.8 分** | **A1 前跑分口径**的板上证据 |
| **`uart_20261012_002541.txt`** | [重点] **D-Cache 版**（只开 D）同一配置同一 ITER=4116，位流 `2f7a4d0a`，`[cache]` 计数非 0、命中率 99.93%、四个 CRC 逐位相同、得分 351.86 | **高阶任务① 真在硬件上跑**的证据 |
| `uart_20260923_200337.txt` | 演示程序首次跑通：4 个开关分别给出 `0x01/0x02/0x04/0x08`，复位键重启程序 | GPIO/UART/时钟全链路的首次验证 |
| `uart_20260923_200737.txt` | **从左到右**依次按 4 个开关 → `0x01 → 0x02 → 0x04 → 0x08` | 证明 `key[0..3]` 与开关左右顺序一致 |
| `uart_20260923_201540.txt` | CoreMark v1.0（ITER=820，**27 MHz**） | 27 MHz 时代的板上证据 |
| `uart_20260923_202257.txt` | CoreMark 第二次跑（按复位键重跑，未重烧） | **复现性**：`Total ticks` 与第一次逐位相同（都是 294262913） |
| `uart_20260925_005201.txt` | CoreMark v1.0（ITER=1500，45 MHz） | 45 MHz 时代的板上证据；30 秒内跑了 2 轮，`Total ticks` 逐位相同 |
| **`uart_20260925_172318.txt`** | [重点] **CoreMark v1.0（ITER=1663，49.8927 MHz + BHT）** | **49.89 MHz 那一代的板上证据**；30 秒内跑了 2 轮，`Total ticks` 逐位相同（588,890,651）|
| **`ila_hw_exflush_coremark.vcd`** | ILA 硬件在环抓的逐拍波形（2026-09-25，1024 拍）：CoreMark 里一次分支冲刷，**三种 BHT 行为全在这一份里** | 赛题点名的 ILA 评分项 —— **已完成**（不再是待办）；`.dprj`/`.wdf` 是配套的工程与波形文件 |
| **`ila_hw_halt_loop.vcd`** | ILA 硬件在环抓的逐拍波形：固件停机自旋 `j 38`（`while(1)`） | 验证"预测中的跳转不冲刷" |

## CoreMark 关键数据

### 49.8927 MHz / ITER=1663（**上一代设计**，`coremark_iter1663_pll49mhz_localboard.sbit`）

```
Total ticks      : 588890651
Total time (secs): 11
Iterations/Sec   : 151
Iterations       : 1663
seedcrc 0xe9f5 | crclist 0xe714 | crcmatrix 0x1fd7 | crcstate 0x8e3a
crcfinal         : 0x81c9
Correct operation validated.
```

| 指标 | 数值 |
|---|---|
| 实际运行时长 | 588,890,651 ÷ **49,892,700** = **11.8031 s**（>=10 s 达标）|
| 每迭代周期 | 588,890,651 ÷ 1663 = **354,113** |
| 与仿真（354,119）偏差 | **-6 拍/迭代 = -0.0016%**（板上略快）|
| CoreMark 分数 | 1663 ÷ 11.8031 = **140.89 iterations/s** |
| CoreMark/MHz | 140.89 ÷ 49.8927 = **2.824**（与仿真口径一致）|
| 对比 45 MHz 板 | 125.40 → **140.89 = +12.36%** |
| 对比 27 MHz 板 | 75.24 → **140.89 = +87.3%** |

> 推算值 588,900,000 / 140.89，实测 588,890,651 / 140.89 —— **得分精确命中**。

### 45 MHz / ITER=1500（历史，`coremark_iter1500_pll45mhz_localboard.sbit`）

```
Total ticks      : 538285445      ← 538,285,445 拍 @45MHz
Total time (secs): 11             ← 打印是整数截断，实际 11.9619 s
Iterations/Sec   : 136            ← 同上，136 = 1500/11 的废数，实际 125.40 iter/s
Iterations       : 1500
Correct operation validated.
[0]crclist 0xe714  [0]crcmatrix 0x1fd7  [0]crcstate 0x8e3a   seedcrc 0xe9f5
```

| 指标 | 数值 |
|---|---|
| 实际运行时长 | 538,285,445 ÷ 45 MHz = **11.9619 s**（≥10 s 达标）|
| 每迭代周期 | 538,285,445 ÷ 1500 = **358,857** |
| 与仿真（358,846）偏差 | **+11 拍/迭代 = +0.0031%**（与 27MHz 那次**完全相同**）|
| CoreMark 分数 | 1500 ÷ 11.9619 = **125.40 iterations/s** |
| CoreMark/MHz | 125.40 ÷ 45.0005 = **2.787**（与仿真口径一致）|
| 对比 27 MHz 板 | 75.24 → **125.40 = +66.7%**（= 纯时钟比 45.0005/27）|

### 27 MHz / ITER=820（历史，`coremark_iter820_localboard.sbit`）

```
Total ticks      : 294262913
Iterations       : 820
Correct operation validated.
[0]crclist 0xe714  [0]crcmatrix 0x1fd7  [0]crcstate 0x8e3a   seedcrc 0xe9f5
```

时长 = 294,262,913 ÷ 27e6 = **10.898 s**；每迭代周期 358,857；得分 75.24 CoreMark。

### [!] CRC 怎么比才对：**别拿 `crcfinal` 当判据**

| CRC | 随 ITER 变吗 | 能不能用来比对 |
|---|---|---|
| `seedcrc` / `crclist` / `crcmatrix` / `crcstate` | **不变** | [OK] **这才是判据**，跨 ITER、跨时钟都必须逐位相同 |
| `crcfinal` | **变** | [X] 不能比 |

**依据（读 CoreMark 源码确认，`third_party/coremark/core_main.c` 的 `iterate()`）：**

```c
res->crc = 0;
for (i = 0; i < iterations; i++) {
    crc      = core_bench_list(res, 1);
    res->crc = crcu16(crc, res->crc);      // ← crcfinal 是【跨迭代累加】的
    crc      = core_bench_list(res, -1);
    res->crc = crcu16(crc, res->crc);
    if (i == 0) res->crclist = res->crc;   // ← 子 CRC 只在第 0 轮快照一次
}
```

`[0]crcfinal` 打印的是 `results[0].crc`，即上面那个**累加器** —— 它必然随 ITER 变：

| 运行 | ITER | crcfinal |
|---|---|---|
| 仿真 | 1 | `0xe714` |
| 27 MHz 板 | 820 | `0xbd59` |
| 45 MHz 板 | 1500 | `0x25b5` |
| **49.89 MHz 板** | **1663** | **`0x81c9`** |

**四个都不同，但四个都是正确的。** 判"CPU 算得对"只看
`seedcrc/crclist/crcmatrix/crcstate` 四个 —— 那四个跨 ITER、跨时钟逐位一致。
（CLAUDE.md 早先写"四个 CRC 与仿真逐位一致"措辞不严，已一并更正。）
| **复现性** | 按复位键重跑一次（未重烧），`Total ticks` **逐位相同** —— 板上跑分是确定性的 |

> [!] `Total time (secs)` 与 `Iterations/Sec` 是**整数截断**打印的
> （`HAS_FLOAT=0`，见 `scripts/coremark_port/core_portme.h`），
> 报告里引用请用 `Total ticks ÷ EE_TICKS_PER_SEC` 自己算
> （**49.89 MHz 那一代板上 = 49,892,700**；仿真 = 27,000,000），
> 别直接用打印的 `11` / `151`（45 MHz 时代那版打印的是 `11` / `136`）。

## 硬件现状说明（写报告时用得着）

* **手册是 0 起编号，板上丝印是 1 起编号**：手册 `KEY0..KEY4` = 丝印 `KEY1..KEY5`。
* **LED 丝印相对开关是错位的**，这是板卡硬件现状，不是映射错误：

  | 手册 | FPGA 管脚 | 板上丝印 | 位置 |
  |---|---|---|---|
  | LED0 | A20 | D17 | SW3 下面 |
  | LED1 | C18 | D18 | SW5 下面 |
  | LED2 | C19 | D19 | SW4 下面 |
  | LED3 | E18 | D13 | SW6 下面 |
  | LED4 | A17 | D14 | SW7 下面 |
  | LED5 | A18 | D15 | — |
  | LED6 | C17 | D16 | — |
  | LED7 | B17 | D12 | — |

  所以演示程序（`LED = KEY`）按某个开关时，亮的是**该开关隔壁**的灯，
  而非正下方那个 —— 串口日志里 `KEY=0x08 LED=0x08` 证明写入字节与读到字节
  完全一致，映射本身正确。

---

## 2026-10-10 位流 A/B：`3418c5fc` vs `f00c6659`（两版各跑一局五子棋）

| 日志 | 局 | 读数 |
|---|---|---|
| `uart_20261010_143501.txt` | HARD(6-ply) 开局，**2 手 AI 应手** | 正常：AI 每手 **2,003 / 4,971 ms**、节点数 3,894 / 10,592；棋盘快照与串口镜像一致（人 H8 → AI G7；人 G8 → AI G8）|
| `uart_20261010_144054.txt` | NORMAL(4-ply) 开局，**5 手 AI 应手、下到 `WHITE wins`** | 正常：AI 每手 **390~554 ms**、节点数 696~1,287；终局连线正确（H 列 H6~H10 五连）|

> [!] **两版位流在这批固件上【行为上无法区分】，而这正是预期结果。**
> `f00c6659` 相对 `3418c5fc` 只改了 `imem_addr2` 的位宽（13→14 位），
> 而取指地址 < `0x8000` 时两者逐位等价 —— 五子棋代码 11.5 KB，碰不到那条路径。
> **所以这次 A/B 证明的是「重新综合（多 seed ×8）后的网表没被改坏」**，
> **不是「截位修复生效」**。修复的正确性靠仿真回归背书
> （49/1/0 + 313,886 / 363,515 逐位不变），而它**在生产固件上本来就不可达**。
> 真正的板上验证需要一段**代码 > 32 KB** 的程序，目前没有（2026-10-17 内存扩到 **128 KB** 后这条验证变得可做了，
> 但现有固件仍 < 32 KB，vblank 类历史记录仅作对照）。

> [!] **日志里没有位流标识** —— 哪份对应哪个 md5 只能按烧录先后认（14:35 在前）。
> （当时的 banner 只有 `=== GOMOKU on RV32I ===`，两版一模一样。）
> **[OK] 已解决（2026-10-10 当天）**：固件现在把设计版本号打在串口第一行 ——
> `[build] FW=GOMOKU RTL=0x20261010`。版本号来自 RTL 侧的 `mimpid`（CSR `0xF13`），
> 常量在 `rtl/core/csr_file.v` 的 `DESIGN_REV`，**改 RTL 后综合前必须改它**
> （见 `CLAUDE.md` 约定 42）。旧的位流读出的是 `0x0`，正好当"修复前"的标识。
> CoreMark 与 RT-Thread 两版固件同样打在报告/启动之前。

**画面（2026-10-10 用户确认）**：接了显示器，两版位流**画面都正常**，
HUD/棋盘显示无异常。串口日志覆盖不到这一块，所以单独记一笔。

---

## 2026-10-10 15:35 板上实测：`492714a8`（CoreMark，含 `imem_addr2` 修复 + `mimpid`）

日志 `uart_20261010_153527.txt`，**一次性通过**：

| 项 | 值 | 判读 |
|---|---|---|
| 串口第一行 | `[build] FW=COREMARK RTL=0x20261010` | **版本自证在真机上生效** —— 这就是 `492714a8` 的铁证 |
| `Total ticks` | **994,988,178** | 与修复前的 `d9ee1cfe` **逐位相同** |
| 时长 | 994,988,178 ÷ 85,005,100 = **11.7050 s** | 余量 17%，安全 |
| **得分** | 3170 ÷ 11.7050 = **270.82** | **与修复前分毫不差** |
| `seedcrc / [0]crclist / [0]crcmatrix / [0]crcstate` | `e9f5 / e714 / 1fd7 / 8e3a` | 四个全对 |
| `Compiler flags` | `-O2 -march=rv32im_zicsr -mabi=ilp32` | 与实际命令行一致（`COMPILER_FLAGS` 已同步）|
| `Correct operation validated` | [OK] | |

> [!] `crcfinal = 0xc006` 与 ITER=1 仿真的 `0xe714` 不同 —— **这是对的**，
> 它是跨迭代累加器，必然随 ITER 变（`CLAUDE.md` 约定 29）。

**这一跑同时证明了三件事**（都是之前只有推理、没有实测的）：

1. **`imem_addr2` 宽度修复对生产固件是严格无操作** —— `Total ticks` 逐位相同；
2. **加 `mimpid` 没碰时序、没碰行为**（CPU 域 slack 反而从 +0.236 涨到 +0.525 ns）；
3. **版本自证在真机可用** —— 以后每份串口日志都能自证是哪一版网表。

**尚未做的**：带 `DESIGN_REV` 的 **gomoku** 位流还没综（目前只综了 CoreMark）。
要在新网表上复验五子棋，跑 `scripts\build_bitstream.ps1 gomoku`。

> **[OK] 2026-10-14 已补**（T2/T3 整合，见 `doc/reports/2026-10-14_integrate_t2t3_gomoku.md`）：
> 裸机 gomoku 在新网表（rev1019）上综了两颗 —— 85.0051 MHz 档 `e03c0e6e`
> （CPU 域 **−0.153 ns / 16 端点 ⇒ 勿烧**，与前两颗 rev1019 85MHz 件逐位相同）
> 与 76.5052 MHz 档 **`dd4fecb4`（+0.773 ns / 0 端点，All Constraints Met，上板推荐）**。
> 固件换成队友 T2/T3 版（菜单 + HUD，`mem.hex` 12552 行 / 6276 字）。

---

## 2026-10-10 22:49 板上实测：阶段0 + 阶段1 —— **324.5 分**（里程碑）

日志 `uart_20261010_224932.txt`，位流 `4f1b0977`（ITER=3796）。**一次通过**：

| 项 | 值 | 判读 |
|---|---|---|
| 串口第一行 | `[build] FW=COREMARK RTL=0x2026_1011` | **`DESIGN_REV` 已递增 → 自证是阶段1 之后的网表** ✓ |
| `Total ticks` | **994,437,480** | |
| 拍/迭代 | **261,969.8**（= 994,437,480 ÷ 3796）| 仿真 262,018（ITER=1 口径）—— 见下面的 [!] |
| 时长 | 994,437,480 ÷ 85,005,100 = **11.6976 s** | 余量 17% ✓ |
| **得分** | 3796 ÷ 11.6976 = **324.5** | **270.82 → 324.5（+19.8%）** |
| 四个 CRC | `e9f5 / e714 / 1fd7 / 8e3a` | 全对 ✓ |
| `Correct operation validated` | [OK] | |
| `Compiler flags` | `-O3 -funroll-loops -funroll-all-loops -fpeel-loops -falign-functions=4 -falign-loops=4 -march=rv32im_zicsr -mabi=ilp32` | 与实际命令行一致 ✓ |

> [!] `Iterations/Sec : 345` 是**整数截断的假值**（3796 ÷ 截断后的 11）——
> 真实值一律自己算 `Iterations ÷ (Total ticks ÷ 时钟)`。
> [!] `crcfinal = 0x0dba` 与仿真不同 —— **这是对的**（跨迭代累加器，随 ITER 变）。

### 收益分解

```
313,886（-O2 基线）→ 282,777（阶段0 -O3，−9.91%）→ 262,018（阶段1，−7.34%）
合计 −16.5%   →   得分 270.82 → 324.5（+19.8%）
乘法闭合：1.1100 × 1.0792 = 1.1979
```
**板上与仿真一致**（324.5 vs 仿真口径 324.42，差 +0.03%）。

> [!] **"板/仿真差 48 拍"已查明：是 ITER 效应，不是仿真模型误差。**
> 三个点单调递减并收敛：
>
> | 测量 | 拍/迭代 |
> |---|---|
> | 仿真 ITER=1 | 262,018.0 |
> | 仿真 ITER=20 | **261,983.3**（−34.8）|
> | **板上 ITER=3796** | **261,969.8**（−48.2）|
>
> 原因：`-O3 -funroll-all-loops` 下 `for (i<ITERATIONS)` 有约 **48 拍的一次性
> 循环开销**。ITER=1 时它没被摊掉，全算进"每迭代"；ITER 越大越接近真实
> `iterate()` 成本。**所以板上与仿真是一致的。**
>
> **[重点] 教训：`-O3` 之后，"每迭代周期数"是与 ITER 相关的。**
> 拿它算 ITER（`ITER = 时钟×10 ÷ 每迭代`）时要用**大 ITER 下的值**；
> 用 ITER=1 的信会偏 0.018%（本例无实质影响：两种算法都取 3796）。
> 更稳的做法：**用 `+PROF` 的 `region cycles`**（它框的是 `start_time→stop_time`
> 之间的纯 `iterate()`，不含外层循环开销）—— 判据仍是"必须等于 `Total ticks`"。

## 【[OK] 2026-10-19 ILA 硬件在环 · 92 探针 · 76.5052 MHz · CoreMark】

> 调试位流：`debug_ila_92probe_76mhz_coremark_20261019_a6d0d877.sbit`
> （md5 `a6d0d877f41b1d0c8e2451310b75b86a`，92 data channel + 2 trigger，
> depth 4096 / position 2048，CoreMark 固件 22,728 行）。
> **该位流只用于抓波形，不得作为交付位流。**

### 触发配置

| 触发口 | 信号 | 用途 |
|---|---|---|
| TU0 | `ila_ex_flush` | 分支/跳转冲刷 |
| TU1 | `ila_trig_cm` | `pc ∈ [0x231C, 0x315C)`，即 `core_bench_list` |

### 图片与作用

| 文件 | 触发/位置 | 作用 |
|---|---|---|
| `ila_20261019_tu0_exflush_coremark.png` | TU0，相对 0 | 分支冲刷：`ex_flush=1`，+1 拍 `IFID_PC/IDEX_PC=0000` |
| `ila_20261019_tu1_corebenchlist_coremark.png` | TU1，相对 0（PC=0x24D0） | CoreMark 链表热点区全景 |
| `ila_20261019_tu1_bhthit_coremark.png` | TU1，相对 -5（绝对 2043） | BHT 命中 + 预测 taken + ID 级提前重定向，EX 不冲刷 |
| `ila_20261019_tu1_stall_coremark.png` | TU1，相对 +4（绝对 2052） | load-use 停顿：`stall=1`、`id_ex_mem_read=1`，+1 拍 `IDEX_PC=0000` |
| `ila_20261019_tu1_pair_coremark.png` | TU1，相对 +37（绝对 2085） | 双发射配对成功：`pair_now=1`、`if_id_pair=1`、`ex_mem_b_valid=1` |
| `ila_20261019_tu1_mispred_coremark.png` | TU1，相对 +12（绝对 2060） | 预测误判恢复：`ex_mispred=1`，+1 拍 `IFID_PC/IDEX_PC=0000` |

> [!] 横轴为**触发点相对坐标**（`Negative Time/Samples`），绝对采样 = 相对 + 2048。
> 每张事件图的事件拍数值以左上角 **X 列**为准；O 列为辅助光标，可能停在其他采样点。

### 导出文件格式

- `*.vcd`：全信号存档（5 条总线 + 92 根单 bit），GTKWave 可开。
- `*.txt`：`Waveform Buses` 导出，4096 行 × 5 列，**无表头**。
  列顺序固定为：
  ```
  PC  IFID_PC  IDEX_PC  EXMEM_PC  OPCODE
  ```
  第 N 行 = 绝对采样 N-1（即第 2049 行 = 采样 2048）。
- [!] VCD 头部的 `$timescale 100ns` 是 Fabric Debugger 的**合成刻度**，
  不是真实时钟周期。真实 `clk_sys` 为 76.5052 MHz（13.071 ns）；
  **不要用 VCD 的时间轴计算绝对时间**，只按采样序号（拍）分析。
- `.dprj` / `.wdf` 是 Debugger 的本地工程/波形文件，已被 `.gitignore` 全局忽略，
  不入库；需要恢复视图时用 `File → Open Project` 打开对应 `.dprj`。
