1979711854/riscv-cpu-fpga/doc/reports/2026-10-17_rev1029_入口.md

# 减 LUT 版（rev1029 / `273f6c5a`，seed 29）在哪 · 入口说明

> **本工作树 = 交付线 `feat/mem128k`，只包含 `b45941d6`（rev1028）那一套。**
> 减 LUT 的工作全部在 **`feat/lut`** 分支。提交数会随修订变动，**现查** `git --no-pager log --oneline bd59ce3..feat/lut`；
> 关键几个：`5f94fe9`（L1 UART FIFO）/ `e7c35a2`（L2+L3 预测器）/ `1548b7a`（三轮记录）/ `0695c79`（seed 扫描 + 交接单）/
> `6159147`（rev1029 交付页）/ `98fbab3`（板上日志）/ `97b45cc`（README rev1029 章节 + 性能空间）/ `22ea277`（交接单首屏修正）。
> **两线尚未合并**，所以本线 `doc/reports/` 里没有 `delivery_rev1029.md`，这是**有意的**，不是文件丢了。

---

## 1. 不切分支就能读到（推荐）

```powershell
# 入口文档与交接单
git --no-pager show feat/lut:doc/reports/2026-10-17_delivery_rev1029.md    # 新交付页
git --no-pager show feat/lut:doc/reports/2026-10-17_lut_rounds.md          # 三轮改动全记录
git --no-pager show feat/lut:doc/reports/2026-10-17_handoff_lut.md         # 该分支的交接单（含 §9 性能优化空间）
git --no-pager show feat/lut:pds/RV32I_1/bitstreams/README.md              # 位流索引的 rev1029 章节

# 或者开一个工作树（不碰本线）
git worktree add D:\_lut feat/lut
```

> [!] **本文件只存在于交付线**，`feat/lut` 上没有同名文件（别用 `git show feat/lut:...入口.md`，会报
> "exists on disk, but not in 'feat/lut'"）。

> 会话若只查摘要：`git --no-pager log --oneline bd59ce3..feat/lut`

## 2. 数字速查（与 rev1028 的差异只有 LUT）

| 量 | rev1028 `b45941d6`（本线） | rev1029 `273f6c5a`（`feat/lut`，seed 29） |
|---|---|---|
| LUT | 7,740（logic 7,168 + LUT-RAM 572） | **6,932（6,744 + 188）** |
| FF / DRM | 3,692 / 165.5 | 3,466 / 165.5 |
| WNS / Fmax | +0.304 / 78.3269 | **+0.358 / 78.6596** |
| Total ticks（板上） | 846,440,591 | **846,440,591（逐位相同）** |
| 主分 / 经典分 | 4.6075 / 352.5 | 4.6075 / 352.5 |
| 指标③-A / ③-B | 0.5953 / 45.54 | **0.6647 / 50.85（+11.7%）** |
| 板上日志 | `doc/board/uart_20261017_190201.txt` | `doc/board/uart_20261018_144114.txt`（`273f6c5a`；`c642c0ac` 的记录在 `uart_20261017_233638.txt`） |

## 3. 状态

- ✅ 已上板：`RTL=0x20261028`、`Total ticks 846,440,591`、四 CRC 全对、gomoku banner + menu 正常。
- ✅ 已完成：`bitstreams/README.md` 的 rev1029 章节（2026-10-17 深夜追加 92 行，纯新增）。
  **[!] 更正**：该文件经字节核对是 **UTF-8 无 BOM / CRLF**（首字节 `23 20 E5 BD 92` = `# 归`），
  此前"它是 GBK"的说法是错的 —— 用 UTF-8 工具直接编辑**安全**，**别为它做 GBK 转码**（那才会真写坏）。
- ⬜ 未完成：五子棋**整局**、HDMI 实拍、ILA `.fic`、演示视频。
- ⬜ 待定：是否把 `DESIGN_REV` 升到 `0x2026_1029`（现在新旧两流 banner 都打印 `0x20261028`，只能靠 md5 区分）。

## 4. 什么时候合并、怎么合并（**别在验证没做完时合**）

现在不合，理由：本线的恒定不变量是「**源码 == 已归档位流 `b45941d6`**」，
一旦把 `feat/lut` 并进来，主工作树就再也复现不出已提交的那颗流，且极易重演
「在工作树里跑 PDS、拿到意料之外的网表」那次事故。

等 rev1029 把第 3 节的 ⬜ 全部做完后，按下面一次做完（有记录、可回退）：

```powershell
cd d:\riscv-cpu-fpga_merged
git tag deliver-273f6c5a feat/lut            # 先给候选流锚一个标签（确认提交号后再执行）
git merge --no-ff feat/lut -m "merge feat/lut: rev1029（LUT -808, 指标③ +11.7%, 拍数不变）"
# 合并后：delivery_rev1029.md 成为本线唯一数字源；rev1028 页保留并标"历史"
# bitstreams/README.md 的 rev1029 章节已在 feat/lut 上写好，合并时随分支进来，不要再单独改一遍
```

> [!] `bitstreams/README.md` 是 **UTF-8 无 BOM / CRLF**（字节核对：`23 20 E5 BD 92` = `# 归`），
> 不是 GBK。以后要改它直接按 UTF-8 编辑；**千万别做 GBK 转码**（那才会写坏）。

> 合并是**一个显式动作**，不是顺手。合并前任何人问「现在交付的是哪版」，答案是 **rev1028 `b45941d6`**
> （本线），rev1029 只是"已通过板测的候选"。
