1979711854/riscv-cpu-fpga/doc/reports/2026-10-16_paper_v1.md

# 论文完稿 v1（2026-10-16，接 taskbook_v10 的 T1）

> [!] **2026-10-16 深夜续（提交 `701e0b6`）**：论文又做了两件事——
> ① **P0 公式口径裁决**：赛题公式 `Score = Iterations/(Total_Time × Frequency)` 化简为
> `Iterations/Total_ticks`（CoreMark/MHz，主频约掉）；删掉 §3.2/§6.4 的旧公式残留
> （"降频亏 2.4%" / "盈亏平衡 80.37" / "物理分"），A1 换档账改新口径；
> ② **A1 效率勘误**：4.6084（+0.043%）算术有误，正确 **4.6148（+0.18%）**。
> 交接状态以 `2026-10-16_taskbook_v12.md` 为准。

- 起始 HEAD：`e38564b`（v10 任务书）；本会话里程碑提交 = **`e819963`**（已 push `origin/dualissue`）
- 范围：**只写论文 + 出图**。RTL 一行未动；交付口径（391.66 @85.0051 MHz / 4.6064 CoreMark/MHz /
  Fmax 87.0549 MHz / LUT 7,753 = 4.85% / 四 CRC e9f5·e714·1fd7·8e3a）**一字未动**。

## 1. 做完了什么（对照 taskbook §2 的 T1 判据）

| 项 | 状态 | 落点 |
|---|---|---|
| 第 1 章 引言 | [OK] | §0.1 立论句 + 三句差异化 + 全文导航；不抄 RISC-V 历史 |
| 第 2 章 系统架构 | [OK] | 图 1（SoC 框图）+ 表 1（直接引 `addr_map.vh`）+ `fence_i` 核心叙事 |
| 第 4 章 SoC 与外设 | [OK] | `mem_bus` 唯一译码 + 表 2 + 写零寄存器/one-shot 契约与代价 |
| 第 8 章 局限 | [OK] | 由 §5.5 + §3.8 扩写，8 条 + 本轮三条否证结论（配对率走完 / BTB 扩表无效 / Fmax 到 RTL 边界） |
| 第 9 章 结论 | [OK] | 复述三个口径 + 三条能力 + "每个数字可当场核对" |
| 第 7 章 应用演示 | 框架稿 | 叙事主线 + 已有板级证据写全；**图 6/7 空位显式标注**（等队友新版 app + RTL 冻结后 ILA） |
| 章节顺序 | [OK] | 重排为 1→9；"待写章节框架"脚手架已删 |
| 判据①（数字有出处） | [OK] | 新章节数字全部来自 `论文框架 §0/§0.1` 或正文既有章节；未造新口径 |
| 判据②（五处同步） | [OK] | 交付口径未动 ⇒ 无需五处同步；唯一口径变更是 own_tests 6/0→7/0（A1 新增 `tb_laneb_st`，taskbook §0 已是 7/0），已同步正文 §5.1 + SKILL.md §1/§3 |
| 判据③（图 1~4 空位） | [OK] | **四张全部补齐**，见 §2 |

顺手补了两个框架规划的空位：**表 3（功能正确性汇总，§5.1）**与**图 5 占位说明（§5.4，ILA 待 RTL 冻结）**。

## 2. 四张图的证据链（都可复现）

| 图 | 文件 | 生成方式 | 自证 |
|---|---|---|---|
| 图 1 SoC 框图 | `doc/figures/fig1_soc_overview.svg` | 按 `rtl/top/cpu_top.v` / `mem_bus.v` / `unified_mem.v` / `video_top.v` 实际结构手绘 | 体现级间寄存器 / 唯一译码点 / A·B 双口 / 视频两显存窗口 |
| 图 2 流水线时空图 | `doc/figures/fig2_pipeline_waveform.svg` | 当前 RTL 重编 tb_coremark 跑 `+PROF +TRACE_START=100000 +TRACE_LEN=1500` → `scripts/pick_trace_window.py` 选窗 → `scripts/trace2svg.py` 渲染 | 仿真日志 `doc/reports/fig2_trace_run_20261016.txt`：`Total ticks 217088` + 四 CRC 逐位一致 + `SIM CONFIG: … LANEB_MEM=1 LANEB_ST=0`（= 树上默认档）；窗口 100327~100374：冲刷 1 / 误预测恢复 2 / 重定向 4 / 分支 14 / 前递 13 / 访存 12 / 提交 41 |
| 图 3 双发射配对 | `doc/figures/fig3_dual_issue_pairing.svg` | `tb_riscv.v +PAIRTRACE` 跑 `tb_laneb_ld`（当前树默认档）→ `scripts/fig3_disasm.py` 反汇编对齐 | 运行输出 `=== PASS ===`；含 lane B load 旧通路停顿（同一 PAIR 连续两行）+ BMEM(addr=0x340) + 三类真实拒配（lane B 分支 / rd_b=x0 / RAW x0=x0） |
| 图 4 总线时序契约 | `doc/figures/fig4_bus_timing.svg` | 按 `mem_bus.v` 头部契约注释手绘 | 两条硬约束 + one-shot 选通 |

复现命令（图 2/3）：

```powershell
# 图 2
iverilog -g2012 -DDUAL -DEARLYLD -DLANEBMEM -I rtl\core -I rtl\periph -I rtl\bus -I sim -o sim\tb_cm_fig2.vvp sim\tb_coremark.v (Get-ChildItem rtl\core\*.v,rtl\periph\*.v,rtl\bus\*.v).FullName
cd sim; vvp tb_cm_fig2.vvp "+ITER=1" "+IMEM=programs/imem.hex" "+DMEM=programs/dmem.hex" "+PROF" "+TRACE_START=100000" "+TRACE_LEN=1500" "+TRACE_FILE=programs/trace_fig2_raw.txt"
python scripts/pick_trace_window.py
python scripts/trace2svg.py sim/programs/trace_fig2_win.txt doc/figures/fig2_pipeline_waveform.svg --title "..."
# 图 3
python scripts/elf2mem.py sim/programs/tb_laneb_ld.elf sim/programs   # 会覆写 imem.hex，跑完记得还原 CoreMark hex
cd sim; vvp tb_rv_fig3.vvp "+IMEM=programs/imem.hex" "+DMEM=programs/dmem.hex" "+TOHOST=programs/tohost_addr.hex" "+PAIRTRACE"
```

## 3. 明确没做的事（留给后续会话）

1. **第 7 章终稿**：等队友新版 app（T2 SOP 见 taskbook §2）+ RTL 冻结后 ILA（T5）；
   图 6/7 空位已在正文显式标注，素材一到即可填。
2. **T2/T3/T4/T5 全部未动**（T2 等队友；T3 不建议；T4 可选单综合；T5 等 RTL 冻结）。
3. RTL / 位流 / 板上口径零改动 ⇒ **不需要重跑 `build_bitstream.ps1`**（本会话无上板动作）。

## 4. 给下一会话的一句话

论文正文已完整（1~9 章 + 表 1~6 + 图 1~4 到位，第 7 章框架稿 + 图 5/6/7 占位）；
剩下的边际收益在 **T2（队友 app 到手后的固件 SOP）与 T5（ILA + 录屏）**，
拿到后按 taskbook v10 §2 的判据执行即可，CPU 侧仍不收口。
