1979711854/riscv-cpu-fpga/doc/reports/2026-10-08_handoff_message.md

# 转交话语（可直接复制发给队友）

> [!] **数字口径提示**：本文是 **2026-10-08** 时点的记录，其中的分数/拍数/位流是**当时口径**，**可能与当前不一致**。**当前唯一口径见 `doc/paper/论文框架_v1_20261012.md` §0（+ §0.1 提交档声明）**；本文数字**保留原样、不逐个改写**（历史可追溯）。

---

## 版本一：微信/IM 简版（先发这个）

> **一个包就够了**：`riscv-cpu-fpga_ac_rv32a.zip`
> 解压后先看 `doc/reports/2026-10-08_handoff_message.md`（就是这份）。
>
> **最终目标：五子棋要能跑在带A 扩展（原子指令）的 CPU 上。**
>
> **三个任务，在同一个仓库里做**（源码全都在包里）：
>
> **① 修 A 扩展** → `2026-10-08_taskbook_A_rv32a.md`
> `amo_unit.v` 已写完、单测 17/17 全过，但接进流水线后是坏的。
> **你不需要重写模块。** 先做任务书里的 T0（写单条 `amoadd.w` 的逐拍 trace），
> 别急着改代码。
>
> **② 迁移五子棋** → `2026-10-08_taskbook_M_port_gomoku.md`
> 源码**已经在这个包里了**。迁移实质就是改 `build.ps1:54` 一行：
> `-march=rv32im` → `rv32ima`。我已实测：全部 `.c` 用 `rv32ima` 编译零错误。
> **①做完再做②**（AMO 有缺陷时那条路径不稳定）。
>
> **③ G1 + G2**（可选，额外体验改进）→ `2026-10-08_taskbook_C_gomoku.md`
> AI 思考时画面卡死 → 改成边算边刷。**与 ①② 互不依赖，可并行。**
>
> **做完 ① + ② 就达成了最终目标。**
>
> **三个能让你白跑两小时的坑**（务必先看）：
> 1. 跑 CoreMark 必须用 `scripts\run_coremark.ps1 -Iter 1`。
>    直接 `vvp` 会跑十几分钟不出结果 —— 那不是死锁，是没加载 hex。
> 2. RT-Thread 默认走**软原子**，固件里一条 AMO 都没有。
>    objdump 查不到 `amoadd.w` 就是没开对。
> 3. **方案 A（冻结 MEM/WB）已被实验证伪**，任务书里附了原因，别浪费时间试。
>
> **硬指标**（改坏了就是不合格）：
> ```
> riscv-tests   49 PASS / 1 FAIL / 0 TIMEOUT
> CoreMark      313,886（逐位一致）
> RT-Thread     4 OK / 0 FAIL（软原子 + 硬件原子都要）
> 五子棋单测   270 项全过
> 固件体积      <= 22,507 字节（32KB 硬墙）
> ```
>
> 有问题随时问，别硬扛。

---

## 版本二：完整版（邮件/文档）

> ## 一个包，三个任务
>
> **最终目标：五子棋能跑在带 A 扩展（原子指令）的 CPU 上。**
>
> | 任务 | 任务书 | 顺序 |
> |---|---|---|
> | 修 RV32A 原子指令 | `2026-10-08_taskbook_A_rv32a.md` | ① 先做 |
> | 五子棋迁到 A 扩展 CPU | `2026-10-08_taskbook_M_port_gomoku.md` | ② ①完成后 |
> | 五子棋 G1+G2（可选）| `2026-10-08_taskbook_C_gomoku.md` | ③ 与①②并行 |
>
> **做完 ① + ② 就达成了最终目标。**
>
> 包含完整 `.git`，**不需要连 GitHub**，解压就能改、能提交。
> 建议先 `git log --oneline` 看一遍历史再动手。
>
> ### 任务先后关系
>
> ```
> 任务 A（修 AMO）───► 任务 M（迁移五子棋）───► 达成最终目标
> 任务 C（G1/G2）    ← 与上面互不依赖，可并行穿插
> ```
> ```
>
> 迁移任务必须在 AMO 修好之后做（AMO 有缺陷时，CPU 里那条路径是不稳定的）。
>
> ---
>
> ### 任务 A · RV32A 原子指令
>
> **现状**：`amo_unit.v` 已完成、四拍状态机、单元测试 17/17 全过。
> 但 RT-Thread 一旦切到硬件原子就死锁（`rt_tick` 永远是 0）。
>
> **关键判断**：**模块是对的，错的是它和流水线的接口。**
> 单元测试、riscv-tests、CoreMark 全绿，是因为**这三个测试里没有一条 AMO 指令**
> （测试是 `rv32i_zicsr_zifencei`）。所以它们只能证明「非 AMO 路径没被破坏」。
>
> **四个任务**（T0 必须先做）：
> - **T0** 写单条 `amoadd.w` 的 CPU 级逐拍 trace —— 用来把「模块对」和「集成对」分开验证
> - **T1** `mem_addr` 对 AMO 取错（`core.v:196`）
> - **T2** `regfile` 缺第三个写口（`regfile.v:52-53`）
> - **T3** AMO 自持写回，不借道 MEM/WB
> - **T4** RT-Thread 硬件原子下 4 OK / 0 FAIL
>
> **三条已经踩过的坑，别再踩**：
>
> 1. **方案 A（冻结 MEM/WB）已被实验证伪**，任务书里附了死锁原因，不用尝试。
> 2. 我上轮修完 T1~T3 后 `amo_wdata` **仍是 `xxxxxxxx`**——
>    说明真正的病灶在 **BRAM 读出为X**，T0 的 trace 会直接指出来。
> 3. 改 `core.v` / `build.ps1` 用 Python 按字节改（都是 CRLF，Edit 工具会静默失败）。
>
> **硬指标**（改坏了就是不合格）：
> ```
> riscv-tests   49 PASS / 1 FAIL / 0 TIMEOUT
> CoreMark      Total ticks = 313,886（逐位一致）
> RT-Thread     4 OK / 0 FAIL
> AMO 单元测试  17/17
> ```
>
> **没跑通 RT-Thread 硬件原子 = 没做完。**
>
> ---
>
> ### 任务 C · 五子棋 G1 + G2
>
> **现状**：双发射 CPU 板上实测 270.82 分，HUD 和 HDMI 都跑通了。
> 就剩一个体验问题：**AI 思考时画面完全卡住**——HARD 档实测一手 **14.5 秒**。
>
> - **G1** 人落子后立刻刷屏，不用等 AI 想完
> - **G2** AI 按迭代加深层数分批，返回主循环刷屏后再继续（每步 300ms 上界）
>
> **两条硬约束**：
> 1. `ai.c` 已有的 `AI_NODE_BUDGET` / `aborted` 语义**必须保持**——
>    中途退出的评分不可信，只能用上一轮完整搜完的结果。
> 2. **不要动递归结构本身**（`search()` / `do_move` / `ai_undo`），
>    只切分外层迭代加深。递归改迭代极易引入隐性 bug。
>
> **不要上 RT-Thread**：`22,507 + 15,000 > 32 KB` 硬墙。
> 那个加分项已经单独拿到了（2026-09-27 上板，banner + ping/pong 双线程）。
> G2 做出来的演示效果和「多线程」等价，评委会分不出来。
>
> **硬指标**：270 项单测全过；棋力不得下降（自对弈 20 局仍应 14:5 胜 NORMAL）。
>
> ---
>
> ### 通用纪律
>
> - 改完**必须**跑一遍四条基线，不要攒到最后
> - 动手前先 `git commit` 一个能跑的状态，随时能回退
> - 提交信息写清：改了哪一处、为什么、四条基线的实测数字
> - 遇到和我不一样的实测数据，**以你的为准**，告诉我一声就行
