1979711854/riscv-cpu-fpga/doc/reports/2026-09-25_handoff_rtthread_gameconsole.md

# 交接任务书 —— 应用场景落地：RT-Thread + 掌上游戏机

> 编写：2026-09-25　分支：`feat/ila-probe`（含 ILA 收尾）　仓库：`https://github.com/1979711854/riscv-cpu-fpga.git`
>
> **本文是自包含的** —— 不需要先读别的文档就能开工。需要细节时按文中索引跳转。
>
> **上一份任务书**（`2026-09-25_next_steps_handoff.md`，动态分支预测 + 提频）**两个任务都已完成**
> —— 已删除。它的决策记录与答辩话术已并入 `2026-09-25_progress_report.md`。
>
> [!] **2026-10-12 勘误（先读本文的话）**：本文写于 2026-09-25，以下口径已过时，
> **以勘误单为准**：① RAM 已是 **64 KB**（栈顶 `0xFFF0`，可用 60 KB），不是 32 KB；
> ② **显示外设（tile PPU + HDMI）已完成并上板**，§2 的"买 SPI 屏"作废；
> ③ I/D Cache **已实现并上板**（§0 的"决策不做"作废）；
> ④ CPU 已是顺序双发射 + `EARLY_LD`，85.0051 MHz / **351.86 CoreMark**；
> ⑤ RT-Thread **已上板**。
> 权威记录：`doc/reports/2026-10-12_gomoku_erratum_and_task.md`；
> 给队友的当前任务书在交接文件夹（`RISC-V_五子棋任务书_v1_20261012.md`）。

---

## 0. 一页速览

**当前状态：CPU 本体已经全部做完，性能基线冻结。现在缺的是"让它有用"。**

| 项 | 状态 |
|---|---|
| 基础任务 ①②③（RV32I / ≥3 级流水线 / UART+GPIO）| **[OK] 全部达标** |
| 高阶任务②（动态分支预测 + 完整异常/中断）| **[OK] 已完整**（BTB/BHT 2026-09-25 做完，**有板上波形证据**）|
| 高阶任务①（Cache）| **[X] 已决策不做**（负收益，理由见进度报告）|
| 高阶任务③（边缘 AI）| **[X] 硬件不可行**（见进度报告）|
| **应用场景演示** | **[!] 唯一还没做的大项 ← 本任务书要解决的** |
| ILA 硬件波形 | **[OK] 已抓齐**（分支预测三种行为的逐拍证据）|

**应用场景（本次定的方向）：一个能玩平台跳跃游戏的掌上游戏机，跑 RT-Thread。**

### 任务表

| 任务 | 优先级 | 工作量 | 风险 | 说明 |
|---|---|---|---|---|
| **A. 显示外设** | **P0** | 中 | 低 | 买一块 SPI TFT 小屏最省事；**这是整个场景的地基** |
| **B. RT-Thread Nano 移植** | **P0** | 中 | **中** | 不依赖 A，**可以并行开工**；CSR 已齐（见 §3）|
| **C. 游戏本体** | **P1** | 中 | 低 | 自己做，**不能跑 NES 模拟器**（§5.1）|
| **D. 收尾（报告 + 录像）** | **P1** | 小 | 低 | 交付物 |
| E. 加分项（DDR3 / 音频 / SD 存档）| P2 | 大 | 高 | 有余力再说，**别一上来就做** |

> **推进顺序建议：B → A → C → D。**
> RT-Thread 不依赖显示，先把它跑通，软件栈就立住了；
> 显示和游戏可以并行。
> **不要一开始就碰 DDR3 或 HDMI** —— 见 §4.4 为什么。

---

## 1. 开工前必须知道的现状

### 1.1 CPU 能力边界（**这些是硬约束，先记牢**）

```
RV32I + M 扩展 · 5 级流水线（IF/ID/EX/MEM/WB）
前递（EX/MEM、MEM/WB 两级）+ load-use 停顿 + 多拍除法器
统一存储器（指令+数据共用一块双端口 BRAM）
完整异常/中断（CSR + mret + 六类同步异常 + CLINT 定时器中断）
[!] 只支持 M 模式（MPP 硬连线为 11）—— 没有 S/U 模式
集成 UART（收发）/ GPIO / 存储总线
```

> [!] **只支持 M 模式**，这一条决定了 RT-Thread 必须用 **M 模式 port**（§3.2）。

### 1.2 内存与地址映射（**32 KB 是本次最大的约束**）

来源：`rtl/bus/addr_map.vh`（SoC 唯一真相，改这里要同步改另外两处）

| 区域 | 地址 | 说明 |
|---|---|---|
| **RAM** | `0x0000_0000` ~ `0x0000_7FEF` | **32 KB**（8192 word × 32 bit）**← 硬上限** |
| 兼容区 | `0x0000_7FF0` ~ `0x0000_7FFF` | 0x7FF4 周期计数器 / 0x7FF8 done / 0x7FFC UART 发字符（CoreMark 硬编码，**不可移动**）|
| GPIO | `0x8000_0000` | W LED[7:0] / R {key[7:0], led[7:0]} |
| UART_TX | `0x8000_0008` | W 发一个字符 |
| UART_RX | `0x8000_000C` | R {valid, 23'b0, data[7:0]}，读清 valid |
| MTIME | `0x8000_0010` | R 周期计数器 [31:0] = `mtime` |
| MTIMECMP | `0x8000_0014` | W/R，复位值全 1；`mtime >= mtimecmp` → MTIP 拉高 |

> [!] **32 KB 装不下帧缓冲。** 240×240 的 16bpp 帧缓冲要 **115 KB**。
> 所以游戏必须像 NES 那样 **tile/sprite 实时合成，不存整帧** —— 详见 §5.2。
>
> 栈顶必须 ≤ `0x7FF0`（CoreMark 用 0x7000）。给 RT-Thread 划内存区时注意别压到兼容区。

### 1.3 已实现的 CSR（**RT-Thread 移植可行性全系于此**）

来源：`rtl/core/csr_file.v`

| CSR | 地址 | RT-Thread 用途 | |
|---|---|---|---|
| `mstatus` | 0x300 | 中断使能 / mret 恢复（MIE、MPIE 已实现，MPP 恒 11）| ✓ |
| `misa` | 0x301 | 只读（MXL=RV32, I+M）| ✓ |
| `mie` | 0x304 | **MTIE / MEIE** —— 定时器与外部中断使能 | ✓ |
| `mtvec` | 0x305 | 异常向量 —— **[!] 只支持 direct 模式**（低 2 位强制 00）| ✓ |
| **`mscratch`** | 0x340 | **M 模式上下文切换必需**（存 SP）| ✓ |
| `mepc` | 0x341 | 返回地址（写入时强制指令对齐）| ✓ |
| `mcause` | 0x342 | 异常/中断原因 | ✓ |
| `mtval` | 0x343 | | ✓ |
| `mip` | 0x344 | MTIP / MEIP | ✓ |
| `mcycle` / `mcycleh` | 0xB00/0xB80 | 64 位周期计数器 | ✓ |
| `minstret` / `minstreth` | 0xB02/0xB82 | **读 0（未实现）** | 不影响 |
| `mvendorid`/`marchid`/`mimpid`/`mhartid` | 0xF11~0xF14 | 读 0 | 不影响 |

> **结论：RT-Thread 需要的东西全都有，尤其 `mscratch`。** 移植的主要工作量在**软件侧**（汇编上下文切换 + 链接脚本 + `rtconfig.h`），不在 RTL。

> [!] `mtvec` **只支持 direct 模式**，所以中断入口里要自己读 `mcause` 分发。
> RT-Thread 的 RISC-V port 本来就是 direct 模式，**不用改**。

### 1.4 中断现状（**有一个已知空白，别踩**）

| 中断源 | 状态 |
|---|---|
| **MTIP**（CLINT 定时器）| [OK] 已实现、**有测试**（`sim/tests/timer_irq.S`）—— **RT-Thread 的 tick 就用它** |
| MEIP（外部中断，接了 UART RX 非空）| [!] **通路具备，但没有测试** —— **不得当作已验证能力对外承诺** |

### 1.5 性能与资源基线（**改动后要能回到这里**）

| 指标 | 值 | 来源 |
|---|---|---|
| 每迭代周期 | **354,119** | 仿真 `+PROF` |
| 测试台总周期（ITER=1）| **1,457,776** | 同上 |
| CPI | **1.2294** | 354,119 / 288,056 |
| CoreMark/MHz | **2.824** | |
| riscv-tests | **49 PASS / 1 FAIL / 0 TIMEOUT** | rv32ui 42 + rv32um 8 |
| 板上（49.8927 MHz，ITER=1663）| `Total ticks 588,890,651` → **11.8031 s / 140.89 CoreMark** | `doc/board/uart_20260925_172318.txt` |
| LUT / FF / DRM / APM | **3,721 / 2,441 / 16 / 11**（LUT 仅用 2.3%）| `multiseed_summary.csv` |
| 时序 | 约束 49.8927 MHz，可达 **54.0745 MHz**，slack **+1.550 ns** | `report_timing/cpu_top_board.rtr` |

> **余量巨大** —— LUT 只用了 2.3%，还有约 4.2 MHz 的频率空间。
> **加显示外设、加 RT-Thread 的内存占用都不用担心面积，只需要担心那 32 KB。**

### 1.6 板卡资源（**这次要重点用起来**）

盘古 **MES2L676-200HP**（核心板 PG2L200H-6FBB676 + 扩展底板）

> [!] **板卡手册不在仓库里**（厂商文档，未入库）——
> 《MES2L676-200HP 硬件使用手册 v1.2》。**要找具体引脚号就向我要一份。**
> 下面表格里的"有/没有"是我已经从手册里核对过的结论，可以直接用。

| 资源 | 数量 | 本次用不用 |
|---|---|---|
| **HDMI 输出接口** | 1 | 可选（§4.3，工作量大）|
| HDMI 输入接口 | 1 | 不用 |
| **10/100/1000M 以太网**（RTL8211F）| 1 | 可选（传画面到 PC）|
| **SD 卡接口** | 1 | P2（存档/读游戏资源）|
| **音频模块接口** | — | P2（声音）|
| **DDR3** | **1 GB**（2×4Gbit，32-bit，1066 Mbps）| **P2，别先做**（§4.4）|
| 用户按键 | **5** | **用**（游戏手柄）|
| LED | 8 | 用（状态指示）|
| USB 转 UART | 1 | **用**（console + 调试）|
| **FMC 扩展口 / 扩展 IO** | 1 | **用**（接小屏）|
| PCIe x4 / SFP / SMA_HSST | — | 不用 |

> [!] 板载 **125 MHz 差分晶振（N3/N2）是给 DDR3 做参考时钟的**，
> 单端 **27 MHz（D18）** 才是系统时钟源（经 PLL 倍频到 49.89 MHz）。
> 别把两者搞混。

---

## 2. 任务 A【P0】显示外设 —— 先定方案

**当前设计一个显示外设都没有**（只有 GPIO/UART）。这是"游戏机"最大的缺口。

### 2.1 四条路线的对比（**先看完再决定**）

| 方案 | 要买什么 | RTL 工作量 | 效果 | 风险 | 建议 |
|---|---|---|---|---|---|
| **A1. SPI TFT 小屏** | **30~60 元**（2.4"/2.8" ILI9341 或 ST7789 模块）| **小**：SPI 主控（几十行）+ 初始化序列 + 刷屏 | 240×320 或 240×240 彩色，**够玩游戏** | **低** —— SPI 时序宽松，几 MHz 随便跑 | **[重点] 推荐** |
| **A2. 板载 HDMI 输出** | 不用买 | **大**：TMDS 编码 + 像素时钟 + 时序发生器（或调 IP）| 720p/1080p，最"游戏机" | **中高** —— 时序收敛难，参考设计少 | 有余力再说 |
| **A3. 串口传帧到 PC** | 不用买 | **很小**：MCU 侧把帧数据写 UART，PC 端 Python 显示 | 低分辨率、帧率受波特率限 | **低** | **先用它把游戏逻辑跑通** |
| **A4. 以太网传帧到 PC** | 不用买 | 中：需要 MAC（PHY 是 RTL8211F）| 中等 | 中 | 不如 A1 |
| A5. 只用现有 LED/按键 | 不用买 | 零 | 只能玩"贪吃蛇"级 | 无 | 保底演示 |

> **推荐组合：A3（先把游戏跑通）→ A1（上真屏）。**
> A3 不需要任何硬件，一两天就能看到东西在动；A1 是最平衡的"真游戏机"方案。

### 2.2 A1 的具体做法（SPI TFT）

1. **买**：ILI9341（2.4"/2.8"，320×240）或 ST7789（1.3"/2.0"，240×240）模块。
   选带 **电平转换/3.3V 兼容**的（FPGA IO 是 3.3V，屏多是 3.3V，一般直连）。
2. **接线**：`SCLK` / `MOSI` / `CS` / `DC`（数据/命令）+ `RST`，共 5~6 根
   —— 从 **扩展 IO / FMC 扩展口** 里挑空闲引脚（手册 §2.2.8 扩展 IO、§3.6 FMC 连接器）。
3. **RTL**：新增 `rtl/periph/spi_master.v`，挂到 `mem_bus` 上（照抄 `uart_tx.v` 的挂法）
   —— 地址映射要在**三处同步改**（`rtl/bus/addr_map.vh`、`scripts/demo/addr_map.h`、`doc/spec.md`）。
4. **`.fdc`**：给新引脚加约束（照抄现有 LED/KEY 的写法）。
5. **软件**：写 ILI9341 初始化序列 + 画点/画矩形/贴图函数。

> [!] **别做"全屏帧缓冲"** —— 32 KB 装不下（§1.2）。
> 用 **tile + sprite 实时合成**：屏幕按行扫描，每行现算该行属于哪些 tile/角色，
> 算完直接推给屏。这样内存只需要 **tile 表 + 角色表**（几 KB）。详见 §5.2。

### 2.3 A2（HDMI）为什么标"工作量大"

- HDMI 要 **TMDS 差分编码**，通常用 FPGA 的 **HSST 高速收发器**（本板有 8 路，6.6 Gbps）
- 需要**像素时钟**（720p = 74.25 MHz > 我们 54 MHz 的可达频率）→ 要么降分辨率，要么再提频
- Pango 的 IP Compiler 里有没有现成 HDMI IP，**先查**；没有就得手写，那是另一个项目的工作量
- **结论：除非时间非常充裕，不要选它。**

### 2.4 A5（保底方案）—— 别小看它

如果屏买不到/来不及，**LED + 按键也能做出可演示的游戏**：
贪吃蛇、打砖块（8×8 LED 点阵）、猜数字。**先保证有东西能演示**，再谈体验。

---

## 3. 任务 B【P0】RT-Thread Nano 移植（**可以并行开工，不依赖显示**）

### 3.1 为什么是 **Nano** 不是标准版

| | Nano | 标准版 |
|---|---|---|
| ROM | **~3 KB** 起 | 几十 KB 起 |
| RAM | **~1.2 KB** 起 | 几十 KB 起 |
| 组件 | 只有内核（线程/调度/IPC/内存）| + 文件系统/网络/设备框架 |
| 我们 32 KB 能不能装 | **[OK] 能** | **[X] 装不下** |

**选 RT-Thread Nano（3.1.5 或 4.0.x 的 Nano 版），并按需裁剪。**

### 3.2 [!] 必须用 **M 模式** port

我们的 CPU **只支持 M 模式**（`mstatus.MPP` 硬连线为 `2'b11`），
所以：
- 用 RT-Thread 的 `libcpu/riscv/rv32` 里 **M 模式** 的移植（不是 S 模式的）
- 上下文切换用 `mscratch` 存 SP —— **我们的 `mscratch` 实现了** [OK]
- 不需要 PMP / 不需要机器模式与用户模式切换

### 3.3 要写/要改的东西（清单）

| # | 内容 | 说明 |
|---|---|---|
| 1 | **链接脚本** | 内存布局：代码从 `0x0` 起，数据/堆/栈落在 32 KB 内，**栈顶 ≤ `0x7FF0`**，**避开 `0x7FF0~0x7FFF` 兼容区** |
| 2 | `rt_hw_stack_init` | 初始化线程栈帧（RISC-V 的 `mepc`/`mstatus` 初值）|
| 3 | **汇编上下文切换** | `rt_hw_context_switch_to` / `_from` / `_interrupt`，用 `mscratch` 暂存 SP |
| 4 | `rt_hw_interrupt_enable/disable` | `csrrs/csrrc mstatus, MIE` |
| 5 | **`rt_hw_board_init`** | 时钟初始化（`mtimecmp`）、console（UART）、堆初始化 |
| 6 | **tick 中断 `rt_hw_tick_isr`** | 挂在 MTIP 上，调 `rt_tick_increase()` |
| 7 | **中断入口** | `mtvec` 只支持 direct → 入口读 `mcause` 分发（tick / 异常）|
| 8 | `rtconfig.h` | 裁剪：只留内核需要的 |
| 9 | `libcpu` 里的 `__rt_ffs` 等 | 若目标 port 用到了就补上 |

### 3.4 内存预算（**必须先算再写，不然一定超**）

| 项 | 估计 | 说明 |
|---|---|---|
| RT-Thread Nano 内核（代码）| ~3~6 KB | 裁剪后 |
| 内核 RAM（就绪表/对象/定时器）| ~1.5~3 KB | |
| 主线程栈 | ~1~2 KB | |
| 游戏逻辑 + 渲染（代码）| ~4~8 KB | |
| **tile 表 + 角色表 + 关卡数据** | **~2~6 KB** | 见 §5.2，**这是关键项** |
| 串口缓冲 / 其他 | ~0.5~1 KB | |
| **合计** | **~12~26 KB** | 32 KB 内可行，**但没有太多富余** |

> [!] **写之前先用 `riscv-none-elf-size` 盯着看**，别等链接报错才发现超了。
> 超了的应对顺序：① 裁 RT-Thread 组件 → ② 缩关卡/素材 → ③ 降分辨率。

### 3.5 验收判据

| 判据 | 期望 |
|---|---|
| 能起来 | 串口打印 RT-Thread 版本 banner + 线程列表 |
| 调度正常 | `msh`/`list_thread` 能看到主线程在跑，`rt_tick` 在涨 |
| 多线程 | 两个线程用信号量/邮箱同步，交替打印 —— **交替顺序正确 = 上下文切换对** |
| **回归不破** | 原有 `riscv-tests 49/1/0`、CoreMark **354,119 拍** 保持不变（**改 RTL 才需要管这条；纯加软件不影响**）|

---

## 4. 任务 C【P1】游戏本体

### 4.1 [!] **不能跑 NES 模拟器**（先说清楚，别走弯路）

- NES 模拟器 + ROM 至少要 **几百 KB 内存**，我们只有 **32 KB** —— **装不下**
- 板子上的 **1 GB DDR3 是另一个项目的工作量**（§4.4）
- **所以：自己写一个精简的平台跳跃游戏。** NES 上跑《超级马力欧》是 40 KB ROM + 2 KB RAM，
  那是**专用硬件 + 手写汇编 + tile 渲染**的结果 —— 我们可以借鉴它的**架构**，
  但要用 C 重写一个**规模和难度都小得多**的版本。

### 4.2 游戏的技术架构（**照 NES 的思路，这是 32 KB 下唯一可行的做法**）

```
不用帧缓冲，用 tile + sprite 实时合成：

  背景层：一张 tile 地图（比如 16×16 像素的 tile，屏幕 240×240 = 15×15 个 tile）
          → 存"每个位置放哪个 tile"的索引表（15×15 = 225 字节！）
          → tile 图案本身存在 ROM 里（几个 tile 合起来几 KB）
  角色层：几个 sprite（16×16 或 16×24），每个存 位置(x,y) + 图案号 + 状态
          → 5 个角色 × 8 字节 = 40 字节

  渲染：按扫描线输出时，现算该行属于哪些 tile、有没有角色覆盖 → 直接推给屏
        （SPI 屏有自己的显存，所以"推过去"就完事）
```

**内存占用可以压到几 KB**，而不是 115 KB。

### 4.3 建议的游戏规模（**先做小，做完了再加**）

| 阶段 | 内容 |
|---|---|
| **v0（先跑通）** | 一个方块在屏幕上左右移动 + 跳跃受重力。**验证显示链路和定时** |
| **v1（可演示）** | 加滚动地图、平台碰撞、1~2 个敌人、能吃的东西 |
| **v2（像样）** | 多关卡、得分、音效（P2）、SD 卡存进度（P2）|

> **v0 一定要先做** —— 它把"显示 + 输入 + 定时 + 渲染"四件事一次验证掉，
> 后面全是加内容。

### 4.4 [!] 素材版权 —— 这是竞赛提交物，注意一下

- **不要**用任天堂的原版美术/音乐/角色形象/ROM 数据
- **自己画像素图**（Aseprite / GIMP 都行），或者用明确开源许可的素材（CC0 等）
- 游戏名字、角色形象也**别用"马里奥"** —— 叫"平台跳跃游戏"或自己起个名
- **理由**：竞赛作品会公开提交、可能展出；带第三方的 IP 会有麻烦，而自己做美术并不难
  （16×16 的像素图，画几个就够用了）

### 4.5 相关：**别把 CoreMark 删了**

`scripts/run_coremark.ps1` / `build_bitstream.ps1 coremark` 那条链**要保持可用** ——
那是我们唯一的性能评分依据（140.89 CoreMark）。游戏是**另一个固件变体**，
建议照 `scripts/demo/` 的样子新建 `scripts/game/`。

---

## 5. 加分项【P2，有余力再说】

| 项 | 为什么先不做 |
|---|---|
| **DDR3 扩展内存** | 板上有 1 GB DDR3（1066 Mbps、32-bit），但**要写/调一个 DDR3 控制器**（Pango 有 IP，但集成涉及新总线、仲裁、1066 Mbps 时序收敛）—— **本身就是另一个项目的工作量**。32 KB 够跑 RT-Thread + 小游戏，**先证明场景成立，再考虑扩内存** |
| HDMI 输出 | 见 §2.3 |
| 音频 | 板上音频模块接口，需要 PWM/DAC + 音频数据流 |
| SD 卡存档 | 需要 SPI/SD 控制器 + 文件系统，Nano 里没有文件系统 |
| 以太网 | 需要 MAC，工作量中偏大 |

---

## 6. 环境与命令速查

```powershell
# 跑仿真回归（改 RTL 后必须）
scripts\run_riscv_tests.ps1              # 期望 49 PASS / 1 FAIL / 0 TIMEOUT
scripts\run_coremark.ps1 -Iter 1         # 期望计时区间 354,119 拍 / 总周期 1,457,776

# 上板（唯一入口，别手工分步）
scripts\build_bitstream.ps1 coremark     # 跑分版
scripts\build_bitstream.ps1 demo         # 演示版

# 看串口（零依赖，自动落盘 doc\board\uart_<时间戳>.txt）
scripts\serial_monitor.ps1 -Port COM4

# 自写汇编测试
scripts\run_own_tests.ps1
```

**工具链**：`riscv-none-elf-gcc 15.2.0`（`D:\riscv-toolchain\xpack-riscv-none-elf-gcc-15.2.0-1\bin`）
**PDS**：`D:\pango\PDS_2022.2-SP6.4`（紫光同创，**不是 Vivado**）
**仿真**：iverilog 14 + GTKWave

**先读这三份**：
- `CLAUDE.md` —— 项目总览 + **29 条关键约定（都是踩过的坑）**
- `doc/board_bringup.md` —— 上板教程（**要插两根 USB 线**那条）
- `doc/reports/2026-09-25_progress_report.md` —— 进度与决策记录

---

## 7. 卡住了怎么办（**先看这张表**）

| 现象 | 原因（都是踩过的）|
|---|---|
| 板上跑的还是旧程序 | **PDS 不检查 `mem.hex` 时间戳**。用 `scripts\build_bitstream.ps1`，它带 sha256 校验。别手工 `run_coremark` + `sync_firmware` 两步走 |
| 串口没输出 | **只插了 Jtag，没插 USB-UART** —— 是两块独立接口，要插**两根** USB 线 |
| 烧完是别的程序 | Programmer 会记住上次分配的文件；**每次都要重新 `Operations → Assign New Configuration File`**（见 `doc/board_bringup.md`）|
| 综合报 `pll` 是黑盒 | PLL IP 必须以 **IP 源文件**形式加进 `.pds`（`wgt_my_ips_src`），不能当普通 `.v` 加 |
| 板上什么都不跑、零报错 | PDS 工程目录里 `mem.hex` 缺失或过期。PDS 只报一行 `Cannot open specified data file` 然后**照常出比特流** |
| 加了新外设后地址对不上 | 地址映射要在**三处同步改**：`rtl/bus/addr_map.vh` + `scripts/demo/addr_map.h` + `doc/spec.md` |
| 外设把 X 放上总线 | X 被 CPU 读走会污染分支比较，控制流会走错。**外设任何时候都不该输出 X** |
| RT-Thread 起来就崩 | 先查 `mtvec` 的 direct 模式假设、`mstatus.MIE` 的切换、栈顶是否越过 `0x7FF0` |

**更全的坑见 `CLAUDE.md` 的「关键约定」29 条。**

---

## 8. 有问题怎么找我

- 先在 `doc/` 里搜关键字 —— 这个项目**每个坑都有留档**，`CLAUDE.md` 是关键约定的索引
- 波形/性能问题看 `doc/ila_analysis.md`（含**板上实测波形**的逐拍解读）
- 上板问题看 `doc/board_bringup.md`
- 还不行就带着**具体现象 + 原始报错**来问，别只说"跑不起来"
