1979711854/riscv-cpu-fpga/doc/contest/技术文档_v1_数据来源.md

# 技术文档_v1 数据来源对照

> 对应文档：`doc/contest/技术文档_v1.docx`（20 页，2026-10-20 更新：§3.3 新增第 7 条 ILA 硬件在环波形验证，图 9~14）
> 生成脚本：`doc/contest/tools/build_doc.py`；自检：`doc/contest/tools/verify_doc.py`
> 原则：正文里每个数字后面用括号标短码来源，短码与本表的对应关系如下。

## 1. 来源短码

| 短码 | 实际文件 | 说明 |
|---|---|---|
| （源：交付页 rev1028） | `doc/reports/2026-10-17_delivery_rev1028.md` | **唯一交付数字源**，位流 `b45941d6`，2026-10-17 18:11:33 |
| （源：T7） | `doc/reports/2026-10-19_t7_coremark_demo_handoff.md` | T7 演示线，位流 `6E2D6020…`，2026-10-19 17:01:11 |
| （源：spec §x） | `doc/spec.md` | 架构、模块清单、总线时序、地址映射、已知限制 |
| （源：board README） | `doc/board/README.md` 顶部 T7 节 | 板上判据、LED 含义、历史线对照 |
| （源：doc/test_report_riscv-tests.md） | `doc/test_report_riscv-tests.md` | 指令级回归 49 PASS / 1 FAIL / 0 TIMEOUT |
| （源：位流索引 README） | `pds/RV32I_1/bitstreams/README.md` | 各档位流 md5、镜像字数、综合时间 |
| （源：doc/figures/fig1_soc_overview.svg 改写） | `doc/figures/fig1_soc_overview.svg` | 系统框图底稿；仅改时钟域 85.0051→76.5052、DESIGN_REV 1027→1028、路径笔误 |

## 2. 逐项对照（正文出现的数字）

### 2.1 官方交付线（b45941d6，全文唯一"交付/当前"口径）

| 数字 | 含义 | 来源位置 |
|---|---|---|
| `b45941d6` | 位流 md5（9,188,552 B，2026-10-17 18:11:33） | 交付页 rev1028 §1 |
| 76.5052 MHz | 生产主频（STATIC_RATIO0=15.0，UART_DIV=664） | 交付页 rev1028 §3 |
| 352.5 | CoreMark 经典分（ITER=3900，11.0638 s） | 交付页 rev1028 §2 |
| 846,440,591 | Total ticks（板上串口原值） | 交付页 rev1028 §2 |
| 4.6075 | 主分 CoreMark/MHz（352.5 ÷ 76.5052） | 交付页 rev1028 §2 |
| 217,036 | 每迭代拍数（846,440,591 ÷ 3900） | 交付页 rev1028 §2 |
| 217,088 | 仿真每迭代拍数 | 交付页 rev1028 §2 |
| 0xe9f5 / 0xe714 / 0x1fd7 / 0x8e3a | seedcrc / crclist / crcmatrix / crcstate | 交付页 rev1028 §2 |
| +0.304 ns | CPU 域 WNS | 交付页 rev1028 §3 |
| 0 / 21,135 | 失败端点 / 总端点 | 交付页 rev1028 §3 |
| 78.3269 MHz | Estimated Fmax（请求 13.0710 ns） | 交付页 rev1028 §3 |
| All Constraints Met | Design Summary 结论 | 交付页 rev1028 §3 |
| 7,740 / 159,800（4.84%） | LUT 用量 | 交付页 rev1028 §4 |
| 3,692（1.16%） | FF 用量 | 交付页 rev1028 §4 |
| 165.5（39.88%） | DRM 用量 | 交付页 rev1028 §4 |
| +6.484 ns / 0-21 | CPU→pix_clk 跨域 WNS / 失败端点 | 交付页 rev1028 §3 |
| gplace_seed 10 | 布局 seed | 交付页 rev1028 §1 |

> 口径陷阱（文中已按此处理）：串口打印的 `Iterations/Sec 354` 是"Total ticks 先截成整数秒"的结果，**全文不用**，只用 352.5 / 4.6075（交付页 rev1028 §2 [!] 段）。

### 2.2 T7 演示线（6E2D6020…，仅作演示，不做第二套成绩）

| 数字 | 含义 | 来源位置 |
|---|---|---|
| `6E2D6020…` | combined 位流，17:01:11 | T7 §0.3、位流索引 README |
| 30 / 11,364 / 12,741 字 | boot / CoreMark / RT-Thread 镜像 | T7 §0.3 |
| 48,270 行 / 24,135 字 | 合并后 mem.hex | T7 §0.3 |
| 59,980 / 61,424 B | RT-Thread 固件占用 / 上限（97.6%） | T7 §0.2 |
| 1,440 B | 堆大小（`[boot] heap = 1440 bytes`） | T7 §0.2.1 |
| 352.5 / 846,440,591 / 四 CRC | 与交付位流逐位同分（裸机档实测） | T7 §0.4、board README |
| 0.3~1.9 s | AI 单步耗时 | T7 §0.2 |
| 1,000 Hz | 系统节拍（RT_TICK_PER_SECOND） | T7 §0.2 |

> 表述纪律：RT 终端屏是"官方裸机成绩的**重放展示**"（读 0xFF00 邮箱），**不是** RT-Thread 再跑一次 CoreMark。正文 §2.3.1、§3.3、图 7/8 图注均按此写法，自检脚本已禁止 "RT-Thread 跑 CoreMark" 一类表述。

### 2.3 历史线（只作演进对照，出现在 §1.5 与表 7）

| 数字 | 含义 | 来源 |
|---|---|---|
| 229,597 | rev1023（2026-10-15）每迭代拍数 | board README 历史节 |
| 85.0051 MHz / `c6af65be` / 391.66 / 4.6064 / +0.277 ns / Fmax 87.0549 / LUT 7,753 | 2026-10-16 历史 1 档 | board README 历史节 |
| 85.0051 MHz / `bcd8fdd2` / 365.93 / 4.304 | 85 MHz 中间档 | T7 / 历史对照 |
| 76.5052 MHz / `da8ffd31` / 325.96 | 历史 I+D Cache 档 | 交付页 rev1028 / board README |

表中"定位"列逐条写明"仅对照"，自检脚本会检查历史数字所在段落/行是否带"历史/对照"字样。

### 2.4 Cache 证据（§3.3 第 6 条）

| 数字 | 含义 | 来源 |
|---|---|---|
| DCACHE_EN=0 / ICACHE_EN=0，网表 0 个 cache 实例 | 交付位流功能上无 Cache | 交付页 rev1028、T7 |
| 4 KB/侧、2 路组相联 | RTL 内可选 I/D Cache 规格 | spec §4.4 |
| `FF322E3D…` / +0.071 ns / Fmax 76.9231 / g_dcache 560 处、g_icache 0 处 | D-Cache-only 独立证据位流 | 交付页 rev1028 |
| −0.750 ns / Fmax 72.3537 | I+D 同开在 76.5052 MHz 时序不过 | 交付页 rev1028 |

> 全文无"当前交付带 I+D Cache"的表述；只在 §3.3 与 §4.1 作为"未采纳/可扩展"出现。

### 2.5 界面图（图 2、3、7、8）

| 图 | 文件 | 生成方式 |
|---|---|---|
| 图 2 | `doc/board/preview_t7_title.png` | 仓库内 640×480 帧缓冲取像（PPU 图块渲染） |
| 图 3 | `doc/board/preview_t7_game.png` | 同上，对局中（AI 思考态） |
| 图 7 | `doc/board/preview_t7_cm_running.png` | 同上，CoreMark 终端屏运行中 |
| 图 8 | `doc/board/preview_t7_cm_pass.png` | 同上，PASS 态 |

> 图 8 屏显 `352.49 / 4.6074` 是两位小数截断，正文统一按 352.5 / 4.6075 计，图注已注明。
> 图 7/8 的 `HEAP FREE : 0.0K` 为旧固件"KB 取整"显示；新固件已改为"剩余/总量 B"（见 `技术文档_v1_待补清单.md` 第 2 节），截图待重出位流后替换。

### 2.6 ILA 硬件在环波形（图 9~14，2026-10-20 插入）

| 图 | 文件（doc/board/） | 内容 |
|---|---|---|
| 图 9 | `ila_20261019_tu0_exflush_coremark.png` | TU0 触发，分支冲刷（ex_flush=1 次拍两级清零） |
| 图 10 | `ila_20261019_tu1_bhthit_coremark.png` | BHT 命中 + 预测 taken + ID 级提前重定向，EX 不冲刷（X=−5 / 绝对 2043） |
| 图 11 | `ila_20261019_tu1_mispred_coremark.png` | 预测误判恢复（ex_mispred=1，代价两拍）（X=+12 / 绝对 2060） |
| 图 12 | `ila_20261019_tu1_stall_coremark.png` | load-use 停顿（stall=1，代价一拍）（X=+4 / 绝对 2052） |
| 图 13 | `ila_20261019_tu1_pair_coremark.png` | 双发射配对成功（pair_now / if_id_pair / ex_mem_b_valid）（X=+37 / 绝对 2085） |
| 图 14 | `ila_20261019_tu1_corebenchlist_coremark.png` | TU1 触发点（PC=0x24D0）热点区全景 |

> 数字与信号名来源：调试位流 `a6d0d877`（md5 `a6d0d877f41b1d0c8e2451310b75b86a`，92 data + 2 trigger，
> depth 4096 / position 2048）、触发区间 `0x231C~0x315C`（core_bench_list）、探针信号名
> （ex_flush / bht_hit_p / bht_taken_p / p_redirect / ex_mispred / stall / id_ex_mem_read /
> pair_now / if_id_pair / ex_mem_b_valid）均出自 `doc/board/README.md` ILA 节与
> `rtl/core/ila_probes.vh`（2026-10-19 抓取批次）。
> 正文位置：§3.3 特性成果新增第 7 条"ILA 硬件在环波形验证"（无字数上限节）。

## 3. 字数与限额（build_doc.py `--count` 输出）

| 章节 | 汉字数 | 模板上限 | 结论 |
|---|---|---|---|
| 摘要 | 约 600（字符数 774） | 800 | OK |
| 1.1 功能与特性 | 约 210 | 400 | OK |
| 1.2 应用领域 | 约 250 | 400 | OK |
| 1.3 主要技术特点 | 约 190 | 400 | OK |
| 1.4 主要性能指标 | 52 + 表 2 | 200 | OK |
| 1.5 主要创新点 | 约 160 | 200 | OK |
| 1.6 设计流程 | 约 70 | 200 | OK |
| 4.1 可扩展之处 | 约 160 | 300 | OK |
| 4.2 心得体会 | 约 620 | 1000 | OK |

全文（含表格）汉字约 5,000，Word 统计字数 7,489，共 17 页。
