1979711854/riscv-cpu-fpga/doc/reports/2026-10-17_delivery_rev1028.md

# 交付页 · rev1028 单一位流（`b45941d6`）

> 这一页是**答辩与报告的唯一数字源**。所有数字都在 2026-10-17 板上或 PDS 日志里可复查，
> 带「[!]」的是**口径陷阱**，带「[?]」的是**还没核实、不许写进 PPT** 的项。
> 上游文档：`2026-10-17_handoff_mem128k_cpu.md`（过程与坑）、`2026-10-17_qa_compliance.md`（官方答疑对表）、
> `doc/resource_efficiency.md`（资源效率三种口径的历史沿革）。

---

## 0. 一句话

128KB 统一存储器 + 零级 boot selector，**一颗位流**里同时驻留 CoreMark 与 RT-Thread 五子棋，
复位后按 SW6 二选一；板上实测**两条路径都通**，主分 **4.6075 CoreMark/MHz**、Fmax **78.3269 MHz**、
资源 **LUT 4.84% / FF 1.16% / DRM 39.88%**，`All Constraints Met`。

---

## 1. 交付物身份

| 项 | 值 |
|---|---|
| 位流 | `pds/RV32I_1/generate_bitstream/cpu_top_board.sbit` |
| md5 | **`b45941d6`**（9,188,552 B，2026-10-17 18:11:33） |
| 器件 | PG2L200H-FBB676，速度等级 **-6**，PDS 2022.2-SP6.4 |
| 布局 | 钉 `gplace_seed 10`（`.pds` 内固定） |
| 镜像 | **一份** `mem.hex`：19,710 字 / 39,420 行 |
| └ boot | `0x00000~0x00043`，17 字（复位入口，选路） |
| └ CoreMark | `0x01000~0x09a67`，8,552 字（ITER=3900） |
| └ RT-Thread | `0x10000~0x1b23f`，11,141 字（五子棋） |
| 选路 | 复位后读 GPIO `key[2]`（丝印 **SW6**，低有效）：按住 → `0x1000`，松开 → `0x10000` |
| 状态 | **已上板**：默认进五子棋、按住 SW6 进 CoreMark，同一颗位流先后跑通 |

---

## 2. 指标一：执行效率（主分）

赛题口径：**主分 = Iterations ÷ Total_ticks（×1e6 得 CoreMark/MHz）**，与频率无关。

| 量 | 值 | 来源 |
|---|---|---|
| Iterations | 3,900 | `core_portme.c` |
| Total ticks | **846,440,591** | 板上串口 `Total ticks` 行 |
| 每迭代拍数 | **217,036** | 846,440,591 ÷ 3,900 |
| 时长 | **11.0638 s** | 846,440,591 ÷ 76,505,200 |
| 经典分（Iterations/秒） | **352.5** | 3,900 ÷ 11.0638 |
| **主分** | **4.6075 CoreMark/MHz** | 352.5 ÷ 76.5052 |

正确性：`Correct operation validated`，四 CRC —— `seedcrc 0xe9f5` / `crclist 0xe714` /
`crcmatrix 0x1fd7` / `crcstate 0x8e3a`（与仿真 ITER=1、ITER=3900 三处一致）。

### [!] 口径陷阱：串口打印的 `Iterations/Sec 354` 不能用

本移植的 `ee_printf` 没有浮点，CoreMark 走 `%d` 分支（`third_party/coremark/core_main.c:367`）：
`Total time (secs)` 先把 **11.0638 截成 11**，再算 `3900 ÷ 11 = 354` —— **高报 0.4%**。
报告与答辩一律用 **352.5 / 4.6075**（按 `Total ticks ÷ EE_TICKS_PER_SEC` 复算），
并在数字旁注"串口打印为整数秒口径"。
**不要为了改这个 printf 重出位流**（15 分钟 + `b45941d6` 作废，收益为零）。

### 与预测的偏差

| 项 | 预测（仿真） | 板上 | 差 |
|---|---|---|---|
| Total ticks | 846,643,200 | 846,440,591 | −202,609（−0.024%） |
| 每迭代 | 217,088 | 217,036 | −52 拍 |

来源：首迭代的 warm-up（Cache 关、无预热）被 3,900 次迭代摊薄，属正常；不是测量误差。

---

## 3. 指标二：Fmax

| 域 | WNS | 失败端点 | Fmax | 说明 |
|---|---|---|---|---|
| **CPU 域**（`clk\|u_pll/u_gpll/CLKOUT0`） | **+0.304 ns** | **0 / 21,135** | **78.3269 MHz** | 主口径，只认 `report_timing/cpu_top_board.rtr` |
| CPU → pix_clk（跨域） | **+6.484 ns** | **0 / 21** | — | 该布局未出现 CDC 伪影 |
| Design Summary | — | — | — | **All Constraints Met** |

请求周期 13.0710 ns（PLL STATIC_RATIO0 = 15.0），Estimated 12.7670 ns。

### [!] 三个不能再犯的引用错误

1. **不要引用 multiseed 日志里的 `Setup (Slow)`** —— 那是跨域口径（含 21 条 CDC 伪影），
   与 CPU 域不是一回事；项目历史上因此把 87 MHz 的"跨域可行"误读成"CPU 可收敛"。
2. **不要用 `capture_seed_timing.ps1` 的旧硬编码算 Fmax**（原按 11.764 写死，解析 76.5 报告
   会打印 87.26）。已修为**从报告读请求周期**，双档验证：76.5 档 → 78.3269 / 85 档 → 87.0549。
3. **85.0051 MHz 路线已用 8 个 seed 证伪**（最好 seed 10 = −0.796 ns，Fmax 79.62，极差 0.513 ns）。
   别再尝试 85/80 MHz；指标② 定为 78.33。

### 为什么指标② 从 87.05 降到 78.33

统一存储器从 64KB 扩到 128KB 后，RAM 阵列与地址/数据选择树变大，关键路径回到"取指 → 存储阵列 → 回写"。
代价是**指标② −10.0%**，换来的是**指标① 不变**（主分只由拍数决定）和**合规第 53 问成立**。
这个交换是主动做的，不是收敛失败。

---

## 4. 指标三：资源效率

`pds/RV32I_1/run.log` `Total LUTs / Total Registers / Total DRM` 段（**逻辑口径**）：

| 资源 | 用量 | 总量 | 精确占比 |
|---|---|---|---|
| LUT | **7,740** | 159,800 | **4.84%** |
| FF | **3,692** | 319,600 | **1.16%** |
| DRM（块 RAM） | **165.5** | 415 | **39.88%** |
| 分布式 RAM | 572 | — | — |

### [!] 两张资源表不是一回事

同一份日志末尾的 `Device Utilization Summary` 会写 `CLMA LUT 6,497 + CLMS LUT 2,265 = 8,762`、
`LUT-FF pairs 2,274` —— 那是**物理站点口径**。报告只引**逻辑口径 7,740**，并注明出处段落。

### 两种效率口径（沿用 `doc/resource_efficiency.md` §4.2 的算法）

| 口径 | 计算式 | rev1028（本交付） | rev1027（I+D Cache, 85MHz 时代） |
|---|---|---|---|
| **A（主口径）**：归一化性能 / 千 LUT | 4.6075 ÷ 7.740 | **0.595** CoreMark/MHz 每千 LUT | 0.524 |
| B：完整得分 / 千 LUT | 352.5 ÷ 7.740 | **45.54** CoreMark 每千 LUT | 44.56 |

⇒ **关掉 I+D Cache 后：资源 −156 LUT，口径 A +13.6%、口径 B +2.2%。**
分母是**整个上板顶层**（含 HDMI/PPU/显存），不是 CPU 核 —— 对评委最保守。

---

## 5. 合规页（对应 `2026-10-17_qa_compliance.md`）

| # | 官方要求 | 本设计 | 证据 |
|---|---|---|---|
| R99（第 53 问） | 跑分和应用必须**同一个 bit 流** | ✅ **一颗位流 + 运行时选路**（128KB 里装两个程序，SW6 二选一） | `b45941d6` 板上双路径；§1、§2 |
| 第 25 问 | 跑分时可关外设 | ✅ 跑分档**不启动** RT-Thread / HDMI 应用负载（不是另做一颗流） | 同上 |
| 第 31 问 | 不能只停留在仿真 | ✅ 板上实拍 + 串口 + ILA | `doc/board/uart_20261017_185444.txt` |
| R112（板卡） | 推荐型号是 200K MINI | ⚠️ 按 R104 第 2 条做**资源证明页**（§6） | `run.log` 资源段 |
| R38 / R106（Cache） | 一条未答、一条谈延时 | ✅ 默认**关 Cache**，交付数据不依赖 Cache；不声称"能开" | 带 Cache 时主分 4.291（−6.9%），只作对照 |
| R127（频率限制） | 未答复 | ✅ 78.3269 是**本设计 P&R 收敛结果**，不表述为官方限制 | §3 |
| 高阶①（总线突发） | — | ❌ **如实写未做**：只有片上 BRAM，无 DDR3/AXI 突发 | 不申报该项 |

---

## 6. 2L200H 资源证明页（一页 A4）

**要回答的问题**：官方 R112 推荐板卡是「200K MINI」，我们用 PG2L200H-FBB676，是否"超档"？

**结论：不超档，且占用远低于档位容量。**

| 项 | 本设计 | 说明 |
|---|---|---|
| 器件 | PG2L200H-FBB676，速度 **-6** | 与"200K"同属 200K 资源档 |
| LUT | 7,740 / 159,800 = **4.84%** | 余量 95.2% |
| FF | 3,692 / 319,600 = **1.16%** | 余量 98.8% |
| DRM | 165.5 / 415 = **39.88%** | 余量 60.1%；其中 73KB 是视频显存、64KB×2 是 CPU 统一存储器 |
| APM | 4 / 740 = 0.54% | 乘法器 |

论证三段：
1. **同档**：2L200H 与"200K MINI"同属 200K 级逻辑容量；差异在封装/引脚/温度等级，不改变资源上限档位。
2. **余量**：三项占用 4.84% / 1.16% / 39.88%，最紧的 DRM 仍有 60% 余量，
   **即使换成容量更小的同档板卡也能装下**（这是对"是否超推荐档"最直接的回答）。
3. **可移植性**：全部 RTL 行为模型化，无手工布局约束（除一个 seed 钉定），换板只需重跑综合。

> [?] **待核（不许直接写进 PPT）**：官方对"200K MINI"的**具体 LUT/DRM 数量**未在本仓库留证。
> 交材料前需从官方器件手册或答疑补充材料确认一次；若其 LUT 总量低于 159,800，
> 把 §6 表格换成对方手册的数字再算占比（我们的**绝对用量 7,740 LUT** 不变）。

---

## 7. 报告叙事顺序（R104 第 4 条）

官方要求"场景特性指标 → 同等指标条件下资源/时序 → CoreMark"，**别按我们自己的优化史写**：

1. **场景**：RV32IMA 双发射顺序 CPU，跑分与五子棋共存的单一位流（为什么必须 128KB）
2. **指标① 执行效率**：4.6075 CoreMark/MHz（352.5 / 11.0638 s / 846,440,591 拍）
3. **指标② 频率**：78.3269 MHz，CPU 域 +0.304 ns / 0 失败端点，`All Constraints Met`
4. **指标③ 资源效率**：LUT 4.84%，口径 A 0.595 / B 45.54
5. **合规**：R99 同一 bit 流（板上双路径）、R112 资源证明、Cache 默认关
6. **附录**：85 MHz 8-seed 证伪过程、CDC 伪影说明、IR Drop 未做、高阶① 未做

---

## 8. 复现（一条命令链）

```powershell
# 出交付位流（boot + CoreMark(ITER=3900) + RT-Thread 合并）
scripts\build_bitstream.ps1 combined

# 合并镜像的两条路径（ITER=1 快速仿真，判路由与 CoreMark 正确性）
scripts\run_combined_sim.ps1

# 读时序（只认 CPU 域那一行）
powershell -File scripts\capture_seed_timing.ps1 -Parse pds\RV32I_1\report_timing\cpu_top_board.rtr

# 上板：烧 sbit -> 串口
scripts\serial_monitor.ps1 -Port COM4 -Seconds 120
```

---

## 9. 数字速查（答辩时只背这 8 个）

| 数字 | 含义 |
|---|---|
| **4.6075** | 主分（CoreMark/MHz） |
| **352.5** | 经典分（Iterations/秒），不是 354 |
| **846,440,591** | Total ticks（ITER=3900） |
| **78.3269** | Fmax（CPU 域，+0.304 ns 余量） |
| **7,740** | LUT（逻辑口径，4.84%） |
| **165.5** | DRM（39.88%） |
| **b45941d6** | 交付位流 md5，一颗流两份程序 |
| **17 / 8,552 / 11,141** | 镜像三段字数（boot / CoreMark / RT-Thread） |
