1979711854/riscv-cpu-fpga/doc/reports/2026-10-17_handoff_128k.md

# 交接任务书 · 128KB 单一位流（2026-10-17）

> 发：甲（RT-Thread + 五子棋）、乙（CPU 优化）
> 背景与依据：`doc/reports/2026-10-17_qa_compliance.md`；完整分工：`doc/reports/2026-10-17_three_way_split.md`。
> 本文自包含，拿到压缩包即可开工。截止按仓库记录 **2026-11-04**。
>
> **[!] 2026-10-17 17:10 补两条（已实测）**
> 1. **§5 的「分数 = CoreMark/MHz × 频率」是经典分**；赛题主分 = `Iterations ÷ Total_ticks`，
>    **与频率无关**（见 `2026-10-16_taskbook_v12.md` §0.1）。⇒ 降频不亏主分，只掉指标②。
> 2. **85.0051 MHz 已判死**（8 seed 最好 −0.796 ns），实际按 **76.5052 MHz** 出流：
>    CPU 域 +0.304 ns / Fmax 78.33 / 位流 `6074c89c`（未上板）。
>    ⇒ §6 时间表里的「B5 重扫 seed」已完成，新入口是 `2026-10-17_handoff_mem128k_cpu.md`。

---

## 0. 为什么做这件事（一句话）

赛题答疑第 53 问明确：**跑分和应用必须在同一个 bit 流**。
我们现在是两颗位流（跑分 `c6af65be` / 演示 `5909a2d0`），严格按字面不合规。
64KB 装不下两个完整程序，所以扩到 **128KB**，做**一颗位流 + 运行时二选一**。

已定：

- 跑 CoreMark 时**不启动应用**（RT-Thread 不跑、HDMI 无输出），UART 与周期计数器保持工作；
- **不做总线突发**（单周期 BRAM 没有可省的握手开销，纯功能分、负收益）；
- **128KB 必须在 ILA 抓波形之前完成**（`.fic`/`.sbit` 必须同源）。

---

## 1. 统一内存地图（128KB，15 位字地址）

| 区间（字节） | 用途 | 说明 |
|---|---|---|
| `0x00000~0x00FFF` | **boot selector** | 复位入口 `0x0` |
| `0x01000~0x0EFFF` | **CoreMark** | 镜像 34,208 B；栈顶 `0x0F000` |
| `0x0F000~0x0FFFF` | 兼容区 + 间隙 | 兼容区仍在 `0xFFF0~0xFFFF`，CoreMark literal 不动 |
| `0x10000~0x1FFEF` | **RT-Thread + 五子棋** | 镜像 ≈44,056 B + `.bss` 10,696 B；栈顶 `0x1FFF0` |
| `0x1FFF0~0x1FFFF` | 保留 | 不许当 RAM 用 |

### [!] 最容易静默错的一处

兼容区判决现在是 `addr[15:8]==0xFF && addr[7:4]==0xF`。
**`0x1FFF0` 的 `addr[15:8]` 也是 `0xFF`**，扩到 128KB 后会被误判成兼容区 MMIO，
而它正好在 RT-Thread 栈顶附近。**必须加 `!addr[16]`**，只匹配低 64KB 的 `0xFFF0~0xFFFF`。

---

## 2. 甲（RT-Thread + 五子棋）

### A0 今天就能做（不依赖乙）

- 完成界面美术：8×8 字库、棋盘 2×2 图块、HUD 框。只动 `scripts/gomoku/**`。
- 每改必跑：
  - `scripts\gomoku\run_test.ps1`（x86 228 项）
  - `scripts\gomoku\run_sim.ps1`（端到端，真 CPU + 真 PPU）
- **不碰** `rtl/`、`pds/`、`scripts/build_bitstream.ps1`。

### A1 等乙的交货（约第 1 天下午）

乙交付「新内存地图 + `addr_map.vh` + 可跳转的 selector 骨架」后：

1. 改 `scripts/rtthread/bsp/link.ld`：
   - `. = 0x10000`
   - `__stack_top = 0x1FFF0`、`__rt_rvstack = 0x1FFF0`
   - `__heap_end = 0x1FFF0`
   - 注释里的旧地址全部改掉
2. 搜索并清掉 `scripts/rtthread/**` 里与 RAM 布局相关的硬编码地址。
3. 重新编译：`scripts\rtthread\build.ps1 -Firmware`
4. **实测并回报** `[boot] heap = N`；N < 8 KB 先报集成方，不要自己动栈。

### A2 验收

| 项 | 判据 |
|---|---|
| x86 单测 | 228/228 |
| `scripts\gomoku\run_sim.ps1` | 端到端 PASS |
| `scripts\rtthread\run_sim.ps1` | RT-Thread 启动、两线程、`[hb]` 无断 |
| 固件大小 | 报给集成方更新 `expectLines` |
| 板上 | 合并位流里选五子棋，HDMI 下完一局 |

---

## 3. 乙（CPU 优化）

### B1 RTL 地址宽度 14→15 位

**一个都不能漏**：

| 文件 | 改什么 |
|---|---|
| `rtl/core/core.v` | `imem_addr` / `imem_addr2` / `ld_addr` 端口宽度；`14'd1`→`15'd1`；所有字索引切片 |
| `rtl/top/cpu_top.v` | 例化端口宽度、切片 |
| `rtl/bus/mem_bus.v` | `ram_word` 切片、`ram_hit` → `0x00000~0x1FFEF`、**兼容区加 `!addr[16]`**、未映射读返回 0（不许 X） |
| `rtl/mem/unified_mem.v` | RAM 深度 16,384 → 32,768 word |
| `sim/mem_model.vh` | `[0:16383]` → `[0:32767]` |
| `sim/tb_riscv.v` / `tb_coremark.v` / `tb_amo_int.v` / `sim/tools/tb_debug_trap.v` | 字索引宽度与常量 |
| `rtl/bus/addr_map.vh` | `RAM_LAST_BYTE`、注释、扩容清单 |

判据：`scripts\run_sim.ps1 -NoWave` 全过。

### B2 CoreMark 重定位 + boot selector

- `scripts/coremark_port/link.ld`：`. = 0x1000`；`_stack_top=0xF000`、`_tohost=0xFFF8` **不动**。
- 新增 `scripts/boot/boot.S`：
  - 链接在 `0x0`，≤4KB；
  - 读 GPIO `0x8000_0000` 的 key 位（低有效）：**复位时按住 KEY_UP（key[2]）→ `0x1000`（CoreMark）**，否则 → `0x10000`（RT-Thread）；
  - 直接 `j` 目标入口，目标 `start.S` 自己设 SP；
  - 不初始化外设，不依赖 `.data`。

### B3 新回归 `hi_fetch.S`

- 新增 `sim/tests/hi_fetch.S`：代码/数据跨 `0x10000` 取指与访存，走到 PASS。
- **必须做"弄坏能 FAIL"验证**：把 `imem_addr2` 位宽改回 14 位，测试必须 FAIL。
- 这是本次扩容唯一的直接覆盖。

### B4 全套回归（改完立刻跑）

| 探针 | 期望 |
|---|---|
| `scripts\run_riscv_tests.ps1` | 49 PASS / 1 FAIL / 0 TIMEOUT |
| `scripts\run_own_tests.ps1` | 6 PASS / 0 FAIL |
| `scripts\run_sim.ps1 -NoWave` | 全过（含 `tb_multiplier` 840 项） |
| CoreMark 仿真 | 四 CRC `e9f5/e714/1fd7/8e3a` 逐位一致；**217,088 拍/迭代不变** |
| `hi_fetch` | PASS；改回 14 位必须 FAIL |

### B5 PDS + 重扫 seed

- 在**独立副本**里跑 multiseed，按 **CPU 域**（不是全设计最差）选 seed。
- 目标：85.0051 MHz 下 CPU 域 **WNS > 0、Fmax ≥ 85.01、0 失败端点**。
- 交付：选中 seed、`report_timing/cpu_top_board.rtr`、候选位流路径 + md5。
- [!] 跨域 `CPU→pix_clk` 的 −1.07 ns 是既有伪影，不要当回归。

---

## 4. 交界约定（两个人 + 集成方）

| 谁 | 交付什么 | 交给谁 |
|---|---|---|
| 乙 | 新内存地图、`addr_map.vh`、selector 骨架 | 甲、集成方 |
| 乙 | 选中 seed + 候选位流 + 时序报告 | 集成方 |
| 甲 | RT-Thread 固件、`[boot] heap` 实测值、最终固件大小 | 集成方 |
| 集成方 | 合并镜像脚本、`combined` 构建变体、最终位流 | 甲、乙 |

**纪律**：

1. **同一个 PDS 工程目录不能并发综合**。乙在副本里扫 seed，集成方在主仓出最终位流。
2. 任何 RTL 改动都跑四个探针：riscv-tests 49/1/0、own_tests 6/0、CoreMark 217,088 + 四 CRC、`run_sim.ps1` 全过。
3. **甲不碰 `rtl/`，乙不碰 `scripts/gomoku/**`**；交界改动由集成方裁决。
4. 128KB 定稿前不抓 ILA、不拍最终视频。

---

## 5. 扩容会不会掉分（回答队友最常问的）

- **CoreMark 周期数不变**：BRAM 仍是 1 拍读，深度变大不增延迟；程序平移不改 BHT 索引（`PC[9:2]`），预测行为逐位不变。预期 **217,088 拍/迭代、四 CRC 不变**。
- **分数 = CoreMark/MHz × 频率**：85.0051 MHz 保持则 **391.66** 保持；若 Fmax 掉到 80 MHz，约 **368.5（−5.9%）**。
- 历史：2026-10-10 32→64KB 后 CPU 域 Slack +0.064→+0.236 ns、Estimated 85.63→86.75 MHz，周期不变。但这次 14→15 位、余量只有 +0.277 ns，必须实测。
- 应对：保持窄加法 → 重扫 seed → 先修路径，最后才降频。

---

## 6. 时间表（硬闸门：10-23 前单一位流上板）

| 日期 | 乙 | 甲 |
|---|---|---|
| 10-18 | B1 改完 + 单测 | A0 界面美术 |
| 10-19 | B2/B3 + 交付地图 | A1 重定位 |
| 10-20 | B4 全套回归 | A2 验收 |
| 10-21 | B5 seed 扫描 | 板上联调 |
| 10-22 | 修时序（如需） | 修应用问题 |
| 10-23 | 支援 | — |

做完一项就在群里回一句「Bx 完成 + 判据数字」，别等最后一起说。
