1979711854/riscv-cpu-fpga/doc/reports/2026-10-17_session_state.md

# 会话状态 —— 2026-10-17（T6 上板验证 / A1 退回 / 界面修复 / ILA 探针重建）

> 接 `2026-10-16_taskbook_v13.md`。**本文件是下一个会话的入口**，取代 v13 §2 的"剩余路径"。
> 分支 `dualissue`，HEAD **`373772e`**，工作树**干净**，**未 push**。

> **[!] 本文件已过期（2026-10-17 17:30）**：128KB 决策已落地并出了候选位流，
> 新入口是 **`2026-10-17_handoff_mem128k_cpu.md`**（分支 `feat/mem128k`，HEAD `f239cff`）。
> 现状：85 MHz 判死（8 seed 最好 −0.796），按 **76.5052 MHz** 收敛（+0.304 ns / Fmax 78.33 / `6074c89c`，未上板）。
> 本文件 §4 之后关于"两颗位流"的排期**作废**。

---

## 1. 一句话

**T6 演示档已在板上验证通过（功能全过）**；A1 已从树里退回，交付口径回到 **rev1027 / +0.277 ns**；
界面按用户上板反馈修了 3 条；ILA 探针已重建并验证 **91/91 综合存活**。
**唯一悬着的大决策是"要不要扩到 128KB"—— 它必须先于 ILA 抓波形定下来。**

> **[重点] 2026-10-17 晚已定（依据赛题一答疑对照，见 `doc/reports/2026-10-17_qa_compliance.md`）：**
> ① 采用「**同一颗位流 + 运行时选择**」，跑分时不启动应用（满足答疑第 53 问「同一个 bit」）；
> ② **不做总线突发**（单周期 BRAM 无可省的握手开销，纯功能分，负收益）；
> ③ **128KB 要做**，且必须在 ILA 抓波形之前完成（`.fic`/`.sbit` 同源）。
> 执行顺序与风险见该文 §8。

---

## 2. 本会话的提交（7 个，全部实跑验证过）

| 提交 | 内容 |
|---|---|
| `3157826` | **退回 A1（lane B 放 store）** rev1028→rev1027，救回钉住的 seed 5 余量 **−0.156 → +0.277 ns** |
| `3713162` | **五处同步**：演示档 `e51ac9e5` → **`5909a2d0`**（T6 版），7 个文件 |
| `a793072` | 附失败证据 + 菜单 FAIL 快速失败（3.4h → 15min 反馈）|
| `1cc316a` | **还原 press_short 的 2 帧时序**（我上轮改成 1 帧是错的，见 §6）；加固件输入状态机探针 |
| `6b8d5c5` | **STEP 行闪烁**（幂等写）+ **主菜单逐项居中** |
| `dbffd60` | **AI VS AI 下不画光标**（红色圈圈闪烁）|
| `938785d`/`373772e` | **ILA 探针束** `ila_probes.vh`（91 根）+ Inserter TCL + 上板日志 |

---

## 3. [重点] 未决大事项：**要不要扩到 128KB**

### 用户为什么要（2026-10-17 明确）

> "我们想让**同一颗 CPU 同时跑 CoreMark 和五子棋**（拍视频演示时要同时展示跑分）。"

### 数字（已核实）

| 项 | 大小 |
|---|---|
| RT-Thread 五子棋（T6）静态 | **54,749 B** |
| CoreMark 镜像（`mem.hex` 17,104 行）| **34,208 B**（8,552 字）|
| **合计** | **88,957 B** |
| 现在可用程序区 `0x1000~0xF000` | **61,440 B** |
| **超出** | **27,517 B** |

⇒ **64KB 装不下，128KB 才装得下（余约 38KB）。**

### 改起来的代价（诚实估计 **1.5~2 天**）

1. **RTL**：地址 14→15 位 —— `core.v`（`imem_addr`/`imem_addr2`/`ld_addr` 三个端口 + 内部切片）、
   `mem_bus.v`、`unified_mem.v`、`sim/mem_model.vh`（`[0:16383]`→`[0:32767]`）
   - [!] **`imem_addr2` 就在关键路径上**（…→`if_addr_d`→`imem_addr`→`imem_addr2`→BRAM 地址口），
     而它现在是 P3.5 专门修过的 14 位（13→14 修"64KB 取指回绕"）
2. **内存映射 + 链接脚本**：`addr_map.vh`/`addr_map.h`、`scripts/rtthread/bsp/link.ld`、
   `scripts/demo/link.ld`（`0xF000` → `0x1F000`）等
3. **所有固件重编 + 全套回归**
4. **重扫 `gplace_seed`**（净表一变，钉住的 seed 5 余量作废 —— A1 实测：LUT +122 就把
   +0.277 打成 −0.156）。A1 文档判"40 跑量级 ≈ 数小时机时"
5. **两颗位流重出 + 板上重验** + 文档五处同步

### [!] 顺序约束（最容易搞错）

```
① 定 128KB 做不做 → ② 做（改 RTL + 重扫 seed + 重出两颗位流）→ ③ 抓 ILA 波形
```

**不能反过来** —— `.fic` 与 `.sbit` 必须来自同一次综合，RTL 一变通道映射全错位。
用户说 ILA 后面在 GUI 抓，**所以 128KB 的决定必须先做**。

### 替代方案（若规则不要求"同一颗位流"）

**视频两段**（先烧跑分档 `c6af65be` 看 391.66 分，再烧演示档 `5909a2d0` 玩五子棋）—— **0 成本**，
而且旁白能强调"**同一份 `rtl/**`、两个固件**"，更贴合"不是两颗 CPU"的答辩口径。
**建议先向用户确认赛题原文对演示的要求，再决定花不花这 2 天。**

> 其他方案都不可行：裸机五子棋+CoreMark 合并 = 25.1+34.2 = 59.3 KB / 61.4 KB，
> 只剩 2 KB 给栈，而 AI 递归要用栈 ⇒ 实际塞不下；且会丢掉 RT-Thread。

---

## 4. 下一步优先级

| 优先级 | 事项 | 状态 |
|---|---|---|
| **P0** | **128KB 决策**（见 §3）—— 用户拍板 | 待定 |
| **P1** | **界面美术**（见 §5）—— 用户已明确"继续修界面" | 未开工 |
| **P1** | **ILA 抓波形**（见 §6）—— 用户自己在 GUI 抓 | 探针已备好 |
| P2 | 拍演示视频（§3 的方案定了才好拍）| 等 |

---

## 5. 界面：已修 3 条，剩 3 条（用户 2026-10-17 上板反馈）

### 已修（`6b8d5c5` / `dbffd60`）

| 意见 | 修法 |
|---|---|
| "AI 下棋时中间有红色圈圈光标闪烁" | `game_cursor_shown()` 加 `mode != HUMAN ⇒ 不画`。人机模式行为不变 |
| "AI vs AI 时 STEP 那一行字闪烁" | `render_text_dedup()` **幂等写**：内容（含列）没变就跳过。`render_clear()` 里作废缓存 |
| "主菜单 HUMAN VS AI / AI VS AI 居左不好看" | `render_menu()` 改**逐项按长度居中**，选中图标跟文字走 |

### 剩 3 条 —— **都有具体的技术拦路虎，不是"调个参数"**

**③ 字距太大**
根因：字模 **5×7 放大 2× = 10×14** 塞进 **16×16 图块** ⇒ 横向空 6px。
**必须换 8×8 字模**（放大 2× 正好 16×16 填满）。横向拉 3 倍会让字又扁又胖，不行。
代价：要重画 ~96 个字符的点阵（或导入公有领域 8×8 字库）。改 `gen_tiles.py` → 重新生成 `font.h`。

**② 棋盘拉满 + 右侧 HUD 框**（用户已定方案：**棋盘靠左、上下拉满、保持正方 + 右侧 HUD 框放统计**）
- 屏 = **40 列 × 30 行图块 × 16px = 640×480**
- 棋盘拉满 = 每格 **2×2 图块** = 30×30 图块 = **480×480px**（正好占满高度、正方）
- 右侧剩 **10 列**（160px）做 HUD —— 只有 10 字/行，统计要拆短行
- [!] **要重做棋盘美术**：现在是"一格一图块"的 16×16，按 2×2 摆会变成"四个小棋子"。
  必须让 `gen_tiles.py` 生成 **32×32 格子再切 4 象限**（空/黑/白/星位/最后一手红标/光标，各一套）

**⑦ 界面单调、没有区分感**
纯设计活：标题条、选中项高亮、分区底纹。**只能上板看效果反复调。**
T6 已有 23 个装饰 tile（`RENDER_TILE_*`）可用，目前只用在了棋盘边框。

> **建议合并成一次"美术重做"**（③ 的字库和 ② 的棋盘美术都走 `gen_tiles.py` 这条生成链，
> 分开做要反复重生成 + 多次上板）。估计 **3~5 小时 + 上板迭代 2~3 轮**。
>
> [!] **界面改动全在 `scripts/gomoku/`（固件+美术），不碰 CPU RTL** ⇒ 与 128KB / ILA 都不冲突。

---

## 6. ILA：探针已备好，抓波形由用户在 GUI 做

### 现状

- **`rtl/core/ila_probes.vh`** —— **91 根单 bit 探针**（+1 时钟通道 +2 触发口）
- 属性用**精确形式** `PAP_MARK_DEBUG="<0/d0/N>"`（**只写 `<N>` 会让通道映射整体错位**）
- **实测 91/91 综合存活**（网表 `synthesize/cpu_top_board_syn.vm` 里 92 个唯一 `ila_` 网络），
  属性也写进了网表
- 触发口：`ex_flush`→`t0`、`stall`→`t1`（由标记显式指定，不靠通道号排序）

### 启用步骤（**默认不包含**，当前 core.v 里没有这行）

1. 在 `rtl/core/core.v` 的 `endmodule` 之前加一行：
   ```verilog
   `include "ila_probes.vh"
   ```
2. PDS → Synthesize（产出 `synthesize/cpu_top_board_syn.adf`）
3. **Fabric Inserter**（GUI：`TOOL → Inserter`，JtagHub 下选 DebugCore）
   - 或试 `scripts/ila_inserter.tcl`（全脚本，`cdt_ins.exe -device PG2L200H -package FBB676
     -speedgrade -6 -netlist <adf> -file ila_inserter.tcl`）
     **[!] 该 TCL 必须纯 ASCII** —— 带中文会中止：`Flow-0120: ... only English characters`
   - 采样参数：Depth 1024 / Rising / Basic w/edges / multi-window 关 / capture position 512
4. 登记 `.fic` 进 `.pds` → P&R → 出调试位流
5. 烧板 → 连 JTAG Server（`127.0.0.1:65420`）→ Fabric Debugger 抓波形
6. **采完必须**：删掉 `include` 那行 → 重出生产位流 → 复核 **+0.277 ns**

### [!] 老资料为什么不能用

- 归档的 debug 位流**不在盘上**
- 现有 ILA 波形 VCD 是 **10-01** 的（比 rev1027 落后好几代）
- **旧 86 根探针从来没进过 git**（`git log -S PAP_MARK_DEBUG` 零命中）—— 只能重建

---

## 7. tb_gomoku 的 FAIL：**已定性为仿真口径假象，别再追**

- **板上实测全过**（日志 `doc/board/uart_20261017_144449.txt`）：
  `menu=MAIN→item=HUMAN→item=AI→menu=AI→item=BLACK/WHITE/STEP/START→black=HARD`、
  `AI moved nodes=… depth=6 t=…ms` 连续多手、`[hb]` 5000→55000+ 无断
- **仿真为什么 FAIL**（探针从固件 RAM 的 `g_input` 直接读出来的）：
  仿真里视频帧周期 **4.2525 ms**，而 `long_ticks` = **4.25025 ms** ⇒ **帧比长按阈值只长 2.25 µs**
  ⇒ 去抖一认账，下一拍就自动变长按 ⇒ **短按在仿真里物理上不可能**。
  板上一帧 16.67 ms、长按 600 ms（36 帧），窗口宽得很 ⇒ 没问题。
- 另外 `CPU_HZ=85,005,100` 写死而仿真跑 100 MHz ⇒ 仿真阈值再短 17%（**板子是对的**）

**处置建议**：把 `tb_gomoku` 标成**已知失败**，别再拿它当交付闸门；要修的话方向是
`-Sim` 的 `INPUT_LONG_MS` 从 5 提到 ~20 + `FRAME_NS` 改成实测的 4,252,500 + `press_long` 按住时长相应加长。

---

## 8. 关键数字（引用前先核对）

| 项 | 值 |
|---|---|
| **交付跑分档** | `c6af65be`(rev1027) —— 板上 **391.66 经典分 / 4.6064 主分**、ITER=4332 |
| **交付演示档** | **`5909a2d0`**(rev1027, T6) —— **已板上验证** |
| 每迭代周期数 | **217,088**（仿真）/ 217,036.1（板上）|
| CPU 域时序 | **+0.277 ns / 0 失败端点（19,114）/ Fmax 87.0549 MHz**（钉 `gplace_seed 5`）|
| 资源 | LUT **7,767**（历史记 7,753，差 14 = 报数抖动）/ FF 3,691 / DRM 101.5 |
| 回归 | CoreMark 217,088 + 四 CRC `e9f5/e714/1fd7/8e3a`；riscv-tests **49/1/0**；own_tests **7/0**；x86 六轨道全过 |
| 主分口径 | `Iterations ÷ Total_ticks` = 1÷每迭代周期数，**主频约掉**（任务书 v12 §0.1）|

---

## 9. 本会话踩过的坑（值得记住）

1. **`press_short` 按住 1 帧 ≠ 短按**：`input.c` 的去抖是**电平稳定**判据，`t_edge` 在"发现变化那拍"
   置零 ⇒ 那一拍永远判不过，必须等**下一采样拍**电平仍是新值才认账。
   而且**长按计时的基准是【认账时刻 `down_at`】不是物理按下时刻** —— 所以"物理按住 6.9ms"不能
   拿去和"长按阈值 5ms"比。（我上轮就这么算错了，改成 1 帧反而彻底没反应。）
2. **`PAP_MARK_DEBUG` 必须写精确形式** `<核号/端口/通道号>`，只写数字会让通道映射全错位。
3. **`cdt_ins.exe` 的 TCL 必须纯 ASCII**，中文注释直接中止。
4. **A1 的残留不止 `LANEB_ST`**：它还在 `tb_coremark.v` / `tools/tb_icache_dbg.v` 里留了层级探针
   （`u_core.id_ex_b_mem_write`），退回后 `run_coremark` **编译直接挂**。只 grep `LANEB_ST` 抓不全。
5. **vvp 块缓冲 stdout** ⇒ 重定向到文件时可能跑几小时都看不到一行。`tb_gomoku` 已加每帧 `$fflush`
   + 进度行；其它长仿真也照办。
6. **`.log` 后缀被 gitignore**，抓的日志用 `.txt`。

---

## 10. 命令速查

```powershell
cd D:\riscv-cpu-fpga_merged ; git log --oneline -5 ; git status

# 固件
scripts\gomoku\build.ps1 -Sim          # 仿真口径
scripts\gomoku\run_test.ps1            # x86 六轨道（含渲染层，直接编译 render.c）

# 上板
scripts\build_bitstream.ps1 coremark   # 跑分档（唯一入口）
scripts\build_bitstream.ps1 rtthread   # 演示档（唯一入口）

# ILA（启用后）
D:\pango\PDS_2022.2-SP6.4\bin\cdt_ins.exe -device PG2L200H -package FBB676 -speedgrade -6 `
    -netlist D:\riscv-cpu-fpga_merged\pds\RV32I_1\synthesize\cpu_top_board_syn.adf `
    -file D:\riscv-cpu-fpga_merged\scripts\ila_inserter.tcl
```

---

## 11. 一句话交接

> **T6 演示档已上板验证通过、A1 已退回、口径统一在 rev1027 +0.277 ns。**
> 下一个会话第一件事：**问用户 128KB 做不做**（做 = 1.5~2 天 + 重扫 seed，必须先于 ILA 抓波形）；
> 然后做界面美术（字库 8×8 + 棋盘 2×2 + HUD 框，只动 `scripts/gomoku/`，不碰 CPU RTL）。
> ILA 探针已备好（91/91 存活），用户自己在 GUI 抓。
