1979711854/riscv-cpu-fpga/doc/reports/2026-10-16_taskbook_v13.md

# 任务书 v13（2026-10-16 深夜 · T6 已整合待验证 · 接 v12）

> **入口**：本文件是**下一个会话的唯一入口**。上一篇 `2026-10-16_taskbook_v12.md` 的
> P0（公式口径裁决）已完成；本会话（v12→v13）完成了：T3 证伪、活跃文档旧口径大扫除、
> IPC 口径修正、**T1（队友 T6 五子棋）整合**。剩余路径 = 4 步（§2），全部有判据。
>
> **公式口径不变**（v12 §0.1/§0.2 继续有效，读任何旧文档前先读它）：
> 主分 = `Iterations ÷ Total_ticks` = 4.6064 CoreMark/MHz（板上 4.6076）；391.66 是经典分（参考）；
> 主频约掉 ⇒ 提频不涨分；唯一涨分手段 = 降每迭代周期数。

---

## [重点] 勘误与后续执行记录（2026-10-16 深夜，接手会话补）

**本文 §2/§3 有两处前提已变，执行时以本节为准：**

1. **[!] 必须先做 A1 退回，才可能满足 §2 第 3 步的判据④。** 本文 §0 写着仓库 RTL 是
   `DESIGN_REV=0x2026_1028`（A1 代码入树、`LANEB_ST=0`），而 §3 的不变项期望
   `RTL=0x20261027` / `LUT 7,753` / `+0.277 ns` —— **拿不到**。原因：
   **A1 的关档只折叠了 FF、没折叠逻辑**（净表 LUT +122）⇒ **钉住的 `gplace_seed 5` 余量作废**
   （实测 `+0.277 → −0.156 ns / 85 MHz 下 5 个失败端点`）。照原样跑第 3 步会出一颗
   **时序不过**的演示位流，且与跑分档形成 rev1027/rev1028 口径分裂。
   ⇒ **已执行**：把 A1 从树里退回（提交 `3157826`），RTL 回到 rev1027。
   退回后回归逐位对上：CoreMark **217,088** + 四 CRC、riscv-tests **49/1/0**、own_tests **7/0**。
   > 退回时踩到一个 §2 没提到的坑：A1 还在 **两个测试台里塞了层级探针**去镜像 `core.v` 的
   > `ld_bad_st`（`u_core.id_ex_b_mem_write`）—— 信号一没，`run_coremark` **编译直接挂**
   > （`Unable to bind`）。`tb_coremark.v` 与 `tools/tb_icache_dbg.v` 各一处，已一并回退。
   > **教训：只 grep `LANEB_ST` 抓不全，得靠编译暴露。**

2. **[!] 第 1 步（`tb_gomoku`）的判据要带上"可观测性"。** 原样跑这个台子是个**黑盒**：
   vvp 块缓冲 stdout，重定向到文件时**跑几小时一行都看不到**，也没有 VCD 可看。
   上一个进程就这样跑了 **125 min 墙钟 / CPU 894 s / 日志 0 字节**，最后只能杀掉、什么都没学到。
   ⇒ **已在 `tb_gomoku.v` 加纯观测的进度检查点**（每帧 `$fflush` + 每 60 帧打一行
   `[进度] t=… 帧=… checks=… errors=…`，不碰任何判据）。加完 2 分钟内日志就有内容 ✓。
   另：按 `scripts/gomoku/run_sim.ps1` 自己的标定（iverilog 20~50 万拍/秒）+ 本文 §5.1 记的
   ~10× 节流 ⇒ **这个台子正常跑完就是 1~3 小时量级**，不是卡住，别按"应该很快"去催它。

**本文 §0 表格、§2 第 2/3 步的期望值**，凡涉及 `RTL=0x20261027` / `+0.277 ns` / `LUT 7,753` 的，
**在 A1 退回之后都成立**（本文写的时候还没退）。`LUT` 实测是 **7,767**（差 14 = 报数抖动）。

**执行结果**：第 2 步 `tb_rtthread` 四自检 **PASS**（banner 实测 `RTL=0x20261028` —— 退回前跑的，
判据只看文本、不比对 RTL 值，故不受影响）；第 3 步演示档重出 **`5909a2d0`**，
CPU 域 **+0.277 ns / 0 失败端点（19,114）/ Fmax 87.0549 MHz**，与跑分档 `c6af65be` **逐位相同**。

---

## 0. 现状（HEAD = `5d55074`，已 push `origin/dualissue`）

| 项 | 值 |
|---|---|
| **交付跑分档（未换）** | `coremark_dual_noaext_ms_earlyld_a1_ras_btb_lanebmem_85mhz_rev1027_seed5pin_c6af65be.sbit`（391.66 分 / 4.6064 / Fmax 87.0549 / +0.277 ns / LUT 7,753）——**T6 不影响跑分档**（coremark 固件不引用 gomoku 源码），一个字不动 |
| **交付演示档（已换）** | **`…_seed5pin_5909a2d0.sbit`**（2026-10-16 23:18:53 综合，CPU 域 **+0.277 ns / Fmax 87.0549 MHz**，`mem.hex` **22028** 行）；旧 `…_seed5pin_e51ac9e5.sbit`（T6 前）**降为前一档**。**[ ] 板上待验** |
| 仓库 RTL | `DESIGN_REV=0x2026_1027` —— **[!] 与本文 §0 原记的 `0x2026_1028` 不同：A1 已从树里退回**（见下）|
| CPU 侧 | 已收口（v12 §0.1/§0.2 结论继续有效；IPC 口径已修正为 **1.265**，见 §1.3） |
| 论文 | 完稿 + 口径裁决版；第 7 章仍为框架稿（等 T6 演示素材 + RTL 冻结后 ILA） |

## 1. 本会话（v12→v13）已完成，别重做

### 1.1 T3（A1′）已执行并【证伪】

`p_b_rd_ok` 结构化门控单综合对照（日志 `pds/RV32I_1/_t3_baseline.log` / `_t3_gated.log`）：
逻辑 LUT **7,317 → 7,314（只 −3）**，距目标 7,195 差 119 ⇒ “122 悬案”不在这份锥里。
仿真判据全绿（217,088 + 四 CRC）但 LUT 判据未达标 ⇒ **已回滚**（RTL 与 `.pds` 均已
`git checkout`，`gplace_seed 5` 复核在位）。详见 `2026-10-16_a1_laneb_store.md` §5。
**若将来再追这 122 LUT**：唯一剩下的路 = 逐处改动静态对照（每次只还原 A1 六处中的一处
跑单综合比 LUT，须同会话对照防 ±14 报数抖动）——优先级低。

### 1.2 活跃文档旧口径大扫除（提交 `3ab954d`）

SKILL.md §1 口径锚（主分/经典分角色分离）、board/README（3 处）、CLAUDE.md（2 处 I+D 拆账）、
bitstreams/README（1 处）、论文框架 §0/§0.1（5 处）、A1 报告 §7（降频论证重写、结论不变）、
v10 任务书（行内警示）、获奖策略文档（补 P3.6+ 横幅）。历史档案按惯例不动。
判据 = 检索“成正比/亏 2.4%/score ∝ 频率”在活跃文档零残留（仅存“已作废”标注）。

### 1.3 IPC 口径修正 + 跨组对比（提交 `0e0f281`）

`tb_coremark.v` 新增 `region instr`（提交指令条数，一对到 WB 计 2；纯观测、回归逐位不变）
⇒ 指令级 IPC **0.899 → 1.265**（旧 0.899 是“提交拍占比”被误读成 IPC）。新脚本
`scripts/coremark_perf_report.py` 解析 `+PROF` 输出打印同口径报表（证据
`doc/reports/2026-10-16_coremark_perf_profile.txt`）。对比结论：**主分排第二**
（4.6064 vs 组① 4.957 / 组② 4.215），差距根因 = 发射效率（CPI 0.790 vs 0.622）**而非 RVC**。
已落论文框架 §0.2 + 正文 §6.6。

### 1.4 T1（队友 T6 五子棋）整合完成（提交 `5d55074`）

队友 T6 阶段 1（竖排多级菜单 + 23 个装饰 tile 运行时合成 + 帧同步短按）经
`riscv-cpu-fpga_dualissue_20261016_t6gui.rar` 到手并按 SOP 整合：

* 快照含完整 `.git` ⇒ 查得其 RTL=**rev1019（旧）**，我们=rev1028 ⇒ **rtl/ 零改动**；
* 他的 gomoku 基线与我们当前**逐位相同**（仅行尾）⇒ 7 个文件直接覆盖，
  `tb_gomoku.v` 用“他的工作区版 + 补回我方 SIM CONFIG 自证 8 行”合并；
* **接口面守住**：`gomoku_run`/`VIDEO_*`/视频寄存器/PPU tile 格式在 diff 中零命中
  （`hw_port.c`/`video_port.c`/`input.c` 三个接口文件他没动）；
* **x86 六轨道单测全过**（`doc/reports/2026-10-16_t6_x86_unittest.txt`；`test_render`
  两条旧断言随 T6 同步修：天元改星位、装饰 tile 131–153 占旧“字库后禁写”区）；
* **修复队友代码一个从未编译过的错误**：`tb_gomoku.v` 对函数返回值直接位选
  （`nt_byte(tr,tc)[0]`）⇒ Verilog 非法，改取模；
* **影响面**：`scripts/rtthread/build.ps1` 显式引用 T6 改过的 `game.c`/`render.c`/`main.c`
  ⇒ **演示固件变**（text 41,901→43,865 B，mem.hex 21,046→**22,028** 行），
  `build_bitstream.ps1` 的 `expectLines[rtthread]` 已按实测更新（BOM/CRLF 保持）；
* rtthread 侧影响面细查（读代码，结论见 §4）：**干净**。

## 2. 剩余路径（4 步，按序；每步判据）

### 第 1 步：tb_gomoku 端到端 PASS【进行中】

本会话 21:06 启动（21:06 那个进程被误杀过两次，**当前进程是 21:06:58 重启的第三版**），
截至交班 CPU ~374s / 墙钟 ~76 min。**判据**：日志 `_t6_gomoku_sim.log` 出现
`=== PASS ===`（checks 全过、errors=0）+ 首行 `SIM CONFIG: DUAL_ISSUE=1 … LANEB_MEM=1 LANEB_ST=0`。
若 FAIL：先看失败断言段落——两大嫌疑点按序排查：
① **`press_short` 帧同步假设与仿真口径不匹配**（队友把板上 600ms/10ms 的帧数关系误套到
   仿真的 1ms/5ms：合法短按窗口只有 ~4ms ≈ 0.24 帧，而 `press_short` 按 2 帧松手会被当
   长按）——现象是菜单导航不动/直接开局/长按行为；修法 = 按住时长改亚毫秒级；
② 天元/最后一手断言与新渲染优先级不符（`render_tile_for`：cursor > 棋子+最后一手 > 星位 > 空）。
若 TIMEOUT：查 `pc=` 停在哪个固件函数（串口镜像 + pc 对照）。

### 第 2 步：tb_rtthread 四自检【已预编译】

`tb_rtthread.vvp` 已编好（板上口径 `-DDUAL -DEARLYLD -DLANEBMEM`），固件是 `-Sim` 口径
（`scripts/rtthread/build/`，22,024 行，`.sim_build_ok` 已补）。**判据**：四自检全过——
banner `[build] FW=RTTHREAD-GOMOKU-G3 RTL=0x20261027` / `[boot] gomoku render thread running` /
`[boot] gomoku ai thread running` / `[hb] alive`（tb 用小写 "gomoku" 匹配，T6 的
`FW=GOMOKU` 大写不会误触，见 main.c 注释）。

### 第 3 步：重出演示位流（唯一入口）

```
scripts\build_bitstream.ps1 rtthread        # 约 7~10 min；expectLines 已更新为 22028
```
**判据**：①  mem.hex sha256/22028 行守卫过；② 新 `.sbit` 时间戳新于启动时刻；
③ PDS 跑完 `git checkout -- pds/RV32I_1/RV32I_1.pds` 并复核 `gplace_seed 5` 在位；
④ 用 `scripts\capture_seed_timing.ps1 -Parse pds\RV32I_1\report_timing\cpu_top_board.rtr`
收 CPU 域时序——**期望 +0.277 ns / 0 失败端点（19,114）/ Fmax 87.0549 MHz 不变**
（同 RTL、同 seed；若变了 = 净表被动过，先查为什么）；
⑤ 新 md5（前 8 位）+ 归档文件名 + 串口 banner 自证（上板后）。

### 第 4 步：五处同步 + 上板（用户执行上板）

按 §3 模板改文档；commit + push；然后用户烧板（**只烧自己出的 .sbit**）。
上板判据（演示档四条 + T6 新增两条）：banner `RTL=0x20261027` / render+ai 两条线程 /
`[hb]` 5000→50000 无断 / **接 HDMI 真按键下完一局判 `WHITE wins`**；
**T6 新增**：标题屏竖排菜单可见、↑/↓ 移光标、←/→ 改值、长按确认进 HUMAN 子菜单、
棋盘外框 + 坐标轴（A-O / 1-15）显示正常、落子后最后一手有红标。

## 3. 五处同步待填模板（第 3 步后执行；跑分档 `c6af65be` 一行不动）

新位流命名规则（同配置只换 md5）：
`rtthread_dual_noaext_ms_earlyld_a1_ras_btb_gomoku_g3_lanebmem_85mhz_rev1027_seed5pin_<NEWMD5>.sbit`

**不变项（同步时明确写“不变”，防手滑）**：`RTL=0x20261027`、`gplace_seed 5`、
CPU 域 +0.277 ns / Fmax 87.0549 MHz / 0 失败端点 19,114、LUT 7,753 / FF 3,691、
DEBUG_LED=1、`RATIO0=13.5`、`UART_DIV=738`。
**变化项**：md5 `<NEWMD5>`、综合时间、mem.hex 22,028 行（旧 21,046）、
板级日志 `doc/board/uart_<新时间戳>.txt`（上板后补）、T6 菜单/外框/红标描述。

| # | 文件 | 位置 | 动作 |
|---|---|---|---|
| 1 | `CLAUDE.md` | 119（结论区①）、148（★提交档表）、156/176（结论区） | 演示档 `e51ac9e5` → 新 md5；148 行补“T6 后重出”+ 新日志占位 |
| 2 | `doc/paper/论文框架_v1_20261012.md` | 100（§0 横幅）、127（§0.1 ★提交档（演示）行） | 换新 md5；**新增一行“前一档（T6 前演示）”** 把 `e51ac9e5` 降级（位流清单是追加式，不删旧档） |
| 3 | `doc/board/README.md` | 19（顶部横幅）、60-61（演示档条目） | 换新 md5 + mem.hex 22,028 行 + 日志占位 |
| 4 | `pds/RV32I_1/bitstreams/README.md` | 5-6（顶部横幅）、66（演示档长条目） | **新增 T6 条目**（复制 66 行改：md5/时间/mem.hex 行数/T6 描述），旧条目标注“T6 前的前一档” |
| 5 | `doc/skills/riscv-cpu-fpga/SKILL.md` | 46（交付位流行）、54（旧→新映射） | 换新 md5；54 行补 `e51ac9e5`→新 md5 的 T6 映射 |
| 6 | `doc/paper/正文_v0_20261016.md` | 610（§5 板级证据链）、834（第 7 章板级证据） | 换新 md5；第 7 章终稿时一起补 T6 菜单描述 |
| 7 | `doc/reports/2026-10-16_taskbook_v13.md`（本文件） | §0 演示档行 | 换新 md5 |

（历史档案 `taskbook_v10/v11`、`a1_laneb_store.md`、`p3_7_demo_lanebmem1.md` 不动。）

## 4. rtthread 侧影响面结论（读代码已查，T6 后无需再查）

* `gomoku_run()` 契约不变（签名、`for(;;)` 不返回、弱函数 `gomoku_ai_pump` 默认实现仍在，
  rtthread 强覆盖机制不动）；
* tb_rtthread 四自检文本全部来自 `scripts/rtthread/app/main.c`（**T6 未动该文件**）⇒ 不受影响；
* `game_ai_snapshot`/`game_ai_level`/`game_ai_finish` 三个 API 在 T6 版 game.h 中都在；
* 栈：render 线程 4KB（T6 新增局部 ~100 B + `line[41]`/`line[36]` 栈缓冲，旧版同量级）、
  AI 线程 4KB 不变；**静态占用 54,749 / 61,440 B ⇒ 余 6,691 B**（比 T6 前窄 ~2 KB，
  后续加功能先看这个数）；
* T6 新增的 `render_board_frame()`/`render_board_labels()` 在 render 线程里上电画一次，无时序风险。

## 5. 环境坑（本会话新踩，重要）

1. **本环境对 `vvp` 有 ~6-9% 的 CPU 节流**：所有 iverilog 仿真的墙钟 ≈ 满载 CPU 时间 × 10
   （五子棋端到端 ≈ 24 min 墙钟是节流下的历史值，不是机器慢）。**长仿真只能真实时间等**，
   不要以为“卡住”就杀进程——先用“同方式跑 tb_coremark ITER=1 探针”（2.2 min 可完成）对照。
2. **`Start-Process`/`Start-Job` 后台跑 vvp 都不可靠**（job 随工具会话消亡；Start-Process 版
    stdin 阻塞假象）。可用姿势：`cmd /c "vvp … < NUL > log 2>&1"` 经 .NET Process 启动，
   进程可跨工具调用存活；**轮询用长间隔（≥4 min）**，密集轮询会触发工具循环检测。
3. **PowerShell 5.1 把 gcc/ld/vvp 的 stderr 警告当中断**（`$ErrorActionPreference=Stop` 下
   NativeCommandError 直接终止脚本）——`build.ps1 -Sim`/`-Firmware` 都会中断在链接步
   （ld 的 RWX 警告）。**ELF 已生成，手动补跑即可**：
   `python scripts\elf2mem.py <elf> <outdir>`；rtthread `-Sim` 还要补
   `scripts\rtthread\build\.sim_build_ok` 标记（内容写明手动补的原因）。
4. **PS 双引号里 `$` 被展开**——python -c 内联脚本写含 `$expectLines` 的字符串会被吃，
   改文件用临时 .py 文件（本会话 `_fix_expectlines.py` 模式）。
5. **python 改 CRLF 文件必须先 `replace('\r\n','\n')` 再编辑、最后统一转回**——
   本会话直接 `replace('\n','\r\n')` 把 CRLF 双改成 `\r\r\n`，全文件 diff + ps1 语法错，
   已用 `git checkout` 恢复重做。**改完必跑** `git diff --stat` 核对行数。

## 6. 纪律（v12 §4 继续有效，摘要）

* `gplace_seed` 只对某一版净表成立；“关档⇒逐位不变”只在仿真层成立。
* PDS 每跑都重写 `.pds` ⇒ 跑完 `git checkout -- pds/RV32I_1/RV32I_1.pds` 并复核 seed 5。
* 改 `scripts\*.ps1` 保持 UTF-8 BOM；`.sbit` 的 md5 不是布局指纹，引用给“md5+报告+日志时间”。
* 动任何对外数字 ⇒ 五处同步（§3 表）；commit 后 push `origin/dualissue`。
* **绝不烧队友给的 `.sbit`**；RTL 没动 ⇒ CPU 域仍 +0.277 ns，别顺手改时序数字。
* T2（ILA/录屏 ⇒ 第 7 章终稿）仍等 RTL 冻结——第 3 步若发现净表被动过（时序判据④不过），
  T2 继续推迟并先查原因。

## 7. 命令速查

```powershell
# 第 1 步（若进程还活着就等；死了按第 5 节姿势重启，hex 都在）
cmd /c "vvp tb_gomoku.vvp "+IMEM=programs/gomoku_sim/imem.hex" "+DMEM=programs/gomoku_sim/dmem.hex" < NUL > _t6_gomoku_sim.log 2>&1"   # cwd=sim
# 第 2 步（vvp 已编译好）
cmd /c "vvp scripts\rtthread\build\tb_rtthread.vvp "+IMEM=scripts\rtthread\build\imem.hex" "+DMEM=scripts\rtthread\build\dmem.hex" < NUL > _t6_rtthread_sim.log 2>&1"
# 第 3 步
scripts\build_bitstream.ps1 rtthread
scripts\capture_seed_timing.ps1 -Parse pds\RV32I_1\report_timing\cpu_top_board.rtr
git checkout -- pds/RV32I_1/RV32I_1.pds
```

---

## 8. 一句话交接

> 公式口径已钉死（v12 §0.1）；CPU 侧收口 + IPC 口径已修正（1.265，排第二）；
> **T6 五子棋已整合提交（`5d55074`，rtl/ 零改动、接口面守住、x86 全过）**，
> 剩下 4 步全是“跑验证 + 重出演示位流 + 五处同步 + 上板”——
> 每一步的判据和坑都写在 §2/§3/§5，照着走即可；唯一的时间成本是 vvp 节流（等）。
