1979711854/riscv-cpu-fpga/doc/reports/2026-10-16_a1_laneb_store.md

# A1：lane B 放 store（`LANEB_ST`）—— 实现 + 量化评估 + 换档建议

- 会话日期：2026-10-16（接 P3.7 收口之后）
- 起点 HEAD：`39eb537`（P3.7 里程碑提交 = `a806d8e`；两个交付档 = rev1027 / `LANEB_MEM=1`）
- 本报告**只讲 A1 这一刀**；论文侧进展见 `doc/paper/正文_v0_20261016.md`
  （已写 **第 3 章微架构（8 节）+ 第 5 章验证（4 层体系/5 条纪律/6 个案例/板级证据链）+ 第 6 章性能分析**；
  剩第 1/2/4/8/9 章与等素材的第 7 章）
- 关键产物：`rtl/core/core.v`（`parameter LANEB_ST`）、`rtl/top/cpu_top.v`（透传）、
  `sim/tests/tb_laneb_st.S`（**新增**，8 个 store 定向用例）、
  `sim/tb_coremark.v` + `sim/tools/tb_icache_dbg.v`（+LDANAL 模型的判据③ 同步）、
  `sim/tb_riscv.v` / `tb_coremark.v` / `tb_rtthread.v` / `tb_gomoku.v`（SIM CONFIG 自证加 `LANEB_ST`）、
  `scripts/build_bitstream.ps1`（读 `LANEB_ST` → 每迭代拍数/得分预期）、`rtl/core/csr_file.v`（`DESIGN_REV=0x2026_1028`）

---

> [!] **2026-10-16 深夜勘误（论文完稿会话）**：§4 的"效率 4.6064 → **4.6084** CoreMark/MHz"
> **算术有误** —— 正确为 **4.6064 → 4.6148（+0.18%）**（效率 = 10⁶ ÷ 每迭代拍数：
> 10⁶ ÷ 216,695 = 4.6148；与 `scripts/build_bitstream.ps1` 的"216,695 拍 / 392.3 分"交叉一致：
> 4.6148 × 85.0051 = 392.3）。**拍数 216,695、LUT/时序结论与"不采纳"判定全部不变**；
> 论文正文已按正确值修订（历史数字按纪律留原样，以本横幅为准）。

## 1. 一句话结论

> **A1 功能全绿、收益实测 −393 拍（217,088 → 216,695 = **−0.181%**）；但代价是
> 净表 LUT **+122**、且 **钉住的 `gplace_seed 5` 余量不再复现**（**+0.277 → −0.156 ns**，
> 85 MHz 下 **5 个失败端点 / Fmax 83.8926 MHz**）。
> ⇒ **本轮不换交付档**（跑分 `c6af65be` / 演示 `e51ac9e5` 保持 rev1027）：
> A1 作为"已实现 + 已量化评估"的能力留在 RTL，**默认 `LANEB_ST=0`**，与 I/D Cache、
> `A_EXT` 的处置同款。**要换档的前提是先做一轮 seed 重扫（40 跑量级）+ 两条板级判据重测。**

立项预期 +1~3%，**实测 +0.18%**（原因见 §4）；而**代价侧不是"多几块 LUT"这么简单**——
它连带作废了 P3.6 花 40 个 seed 挣回来的那 +0.277 ns（见 §6）。

---

## 2. 实现（改动面 = 6 处，全在 `rtl/core/core.v`；`control.v` 一行未改）

| # | 落点 | 改动 | 为什么必须改 |
|---|---|---|---|
| ① | `p_opcode_b_ok` / 配对白名单 | 加 `p_st_b`（`OP_STORE`）+ `p_mem_b = (LANEB_MEM!=0) && (p_ld_b \|\| ((LANEB_ST!=0) && p_st_b))` | lane B 放 store 的准入 |
| ② | **新增 `p_b_rd_ok`** | `!p_b_writes_rd \|\| ((p_rd_b != 0) && (p_rd_a != p_rd_b))` | **store 的 `instr[11:7]` 是 S 型立即数低 5 位、不是 rd**。沿用 `rd_b!=0` 会把 `sw x1,0(x2)`（imm[4:0]=0）整类静默拒掉；沿用 `rd_a != rd_b` 是拿 rd 与立即数比 |
| ③ | "每对最多一条访存" | `!(p_mem_a && p_mem_b)` | 写口只有一套（`mem_bus` 单写口）⇒ 同拍不可能两条 store，也不需要仲裁器 |
| ④ | 写口三条腿 | `mem_we \|= b_st_sel`；`mem_addr` 的 mux 加 `b_st_sel`；`mem_wdata`/`mem_byte_en` 各加 lane B 分支 + **新增 `ex_mem_b_wdata`** | **`ex_mem_wdata` 是 lane A 的 rs2，不能借用**（借用 = 把 lane A 的操作数写进内存） |
| ⑤ | **判据③ `ld_bad_st`** | `id_ex_mem_write \|\| ((LANEB_MEM!=0)&&(LANEB_ST!=0)&&id_ex_b_mem_write)` | lane B 的 store 与 ID 级那条 load 的**提前读口是同一沿读写** ⇒ 漏了 = 静默读旧值 |
| ⑥ | 异常 | 新增 `store_misaligned_b`，并入 `ex_exception_b` / `exc_cause=6` / `exc_tval=alu_result_b` / `trap_from_b` | lane B 的未对齐 store 必须精确陷阱；`b_mem_unaligned` 与 `b_addr_low` 与 load **共用**（S 型与 I 型低 3 位编码一致），A1 不新增取指路径逻辑 |

补充（**不改但必须点名**）：
* `stall` 里**没有**任何 lane B store 的子句 —— store 不产生写回值、数据/地址都在 EX 级取，
  这是"A1 改动面小"的根本原因；
* `ex_mem_b_valid` 已含 `!ex_flush` ⇒ 被冲刷的对里 lane B 的 store 天然不写（不回退这条承重门控）；
* trap 清 ID/EX 与 EX/MEM ⇒ **既陷异常又改了内存**不可能发生（同 2026-09-23 的老坑）。

## 3. 判据矩阵（全部实跑）

| 判据 | 关档 `LANEB_ST=0` | 开档 `LANEB_ST=1` |
|---|---|---|
| CoreMark 计时区间 | **217,088**（= rev1027 逐位相同） | **216,695** |
| 四 CRC（seedcrc/crclist/crcmatrix/crcstate） | `e9f5 / e714 / 1fd7 / 8e3a` 逐位一致 | **同样逐位一致** |
| riscv-tests（`-EarlyLd -LanebMem`） | **49 PASS / 1 FAIL(`ma_data` 哨兵) / 0 TIMEOUT** | **49 / 1 / 0** |
| own_tests | **7/0**（含新增 `tb_laneb_st`） | **7/0** |
| `tb_laneb_st.S` 八个定向用例 | PASS（store 退化成顺序执行，语义不变） | PASS |
| **反例对照**（把 `ld_bad_st` 的 lane B 项摘掉再跑） | — | **用例 1 FAIL**（读到旧值）⇒ 用例有牙齿、且证明 store 真的落在 lane B |

`tb_laneb_st.S` 覆盖：字/字节/半字 store 的写口三腿（三种错法各有不同的期望值可区分）、
相邻两条 store 必须不配对、`lane A load + lane B store` 必须不配对、被冲刷的对里不写、
未对齐 store 的 `mcause=6/mtval/mepc`、lane A 写回不被污染。
**纪律：先写用例、再翻开关**（用例先在关档跑 PASS，再翻 `LANEB_ST=1` 跑 PASS）。

## 4. 收益（为什么只有 0.18%，不是 1~3%）

`217,088 → 216,695` = **−393 拍 = −0.181%**（效率 4.6064 → 4.6084 CoreMark/MHz）。
按"一对省 1 拍"折算，等于每迭代多配到约 393 对。远小于预期的原因（都可核对）：

1. **`lane A` 是访存时不能配对**（每对至多一条访存）—— CoreMark 的 store 前一条常常也是访存；
2. **同对 RAW 判据**（`rd_a ∉ {rs1_b, rs2_b}`）—— store 需要 base 与 data 两个操作数，
   命中"lane A 刚写这两个寄存器之一"的概率是纯 ALU 指令的两倍；
3. store 在 CoreMark 里的**绝对条数**远少于 load，且其中一部分已被"更值钱的配对"占掉。
> 结论口径：**"lane B 放 store"本身没有错，是 CoreMark 给它留的窗口本来就窄**。
> 这条要写进论文（"设计—收益—代价"闭环），也是 A2（配对率扩展）必须先统计再动的原因。

## 5. 代价（PDS 实测）

| 项 | rev1027（交付档，历史值）| rev1027 **原样 RTL 今天重跑**（E2）| A1 代码在位但**关档** `LANEB_ST=0`（rev1028）|
|---|---|---|---|
| LUT | 7,753（4.85%）| **7,767（4.86%）** = 逻辑 7,195 + dram 572 | **7,889（4.94%）** = 逻辑 7,317 + dram 572 |
| FF | 3,691 | **3,691** | **3,691（完全相同）** |
| DRM / APM / IO | 101.5 / 4 / 24 | 101.5 / 4 / 24 | 101.5 / 4 / 24（相同）|
| CPU 域 WNS（钉 `gplace_seed 5`）| **+0.277 ns / Fmax 87.0549 MHz / 0 失败端点 / totalEP 19,114** | **+0.277 ns / 87.0549 MHz / 0 失败端点 / 19,114（逐位复现）** | **−0.156 ns / 83.8926 MHz / 5 个失败端点 / 20,221** |
| 位流 md5 | `c6af65be` | `fefc16ae`（同网表同种子的另一颗构建）| `447c1261` |

**三个必须记住的读数**：
1. **E2 逐位复现历史值**（+0.277 ns / 端点 19,114）⇒ **流程本身是确定性的**，
   同网表 + 同 seed ⇒ 同余量（这一条让 A1 的"嫌疑"变得确定，也让 P3.6 的选种结论站得更稳）；
2. **FF 完全没变（3,691）** ⇒ 新增的三个寄存器（`id_ex_b_mem_write` / `ex_mem_b_mem_write` /
   `ex_mem_b_wdata[31:0]`）在关档下**确实被综合裁掉了**（FF 层面折叠成立）；
3. 但 **逻辑 LUT +122（7,195 → 7,317）、端点 +1,107、余量 −0.433 ns** ⇒
   **净表仍然变了**（同一颗器件、同一 seed、同一流程，只有 RTL 不同）。
   ⇒ **`gplace_seed 5` 的余量只对某一版净表成立**：净表一动，同一个 seed 就不是同一件事。
   这是本次最重要的方法论发现（落进 §6 的纪律）。

> 注：LUT 历史值 7,753 与 E2 实测 7,767 差 14（0.18%）——同一份 RTL 的两次构建在**报数层面**
> 有一点点抖动（而时序端点数是逐位相同的），所以**用 LUT 数做 100 LUT 量级的对比时，
> 要用"同一天的两次构建"做基准（本报告用 E2 = 7,767 作基准）**，别跨会话比。

**【未解项，如实记录】** 我逐一核对过 A1 的每一处改动，都对 `LANEB_ST` 做了门控，
且 FF 数证明寄存器确实被裁掉；但**关档下仍多出 122 个逻辑 LUT，我没能定位到具体的门级来源**。
~~最大嫌疑是 `p_b_rd_ok` 里那份与 `p_opcode_b_ok` 同构的"是否写 rd"判据锥
（`!p_b_writes_rd || (...)`，在 0 档与 `p_opcode_b_ok` 恒等，但需综合器做掉吸收律化简）。~~
**不影响本次结论**（现象确定且可复现），若下一条线想拿回这 122 LUT，可试：
把 0 档写成**结构化门控**（`(LANEB_ST==0) ? (rd_b!=0 && rd_a!=rd_b) : ...`），
再跑一次单综合对比 LUT（~2 分钟量级，不必全流程）。

> **[!] 2026-10-16 深夜：T3（任务书 v12 §3）已执行 —— 上面的"最大嫌疑"被【证伪】，如实记录：**
> 按上述写法改写 `core.v` 的 `p_b_rd_ok` 后，同一天两次单综合对照
> （`pds_shell -run synthesize`，日志 `pds/RV32I_1/_t3_baseline.log` = 改前 / `pds/RV32I_1/_t3_gated.log` = 改后）：
>
> | 口径 | 逻辑 LUT | dram | Total |
> |---|---|---|---|
> | 改前（rev1028 关档原样） | 7,317 | 572 | **7,889** |
> | 改后（结构化门控） | **7,314** | 572 | **7,886** |
> | 目标（E2 pristine rev1027 基准） | 7,195 | 572 | 7,767 |
>
> ⇒ **只拿回 3 个 LUT；122 悬案的 119 个不在这份锥里，"最大嫌疑"排除。**
> 仿真层判据全绿：关档 CoreMark **217,088** + 四 CRC `e9f5/e714/1fd7/8e3a` 逐位一致
> ⇒ 改写本身功能无害，但判据（LUT 回 7,767）未达标 ⇒ **已回滚**
> （`git checkout -- rtl/core/core.v`；`.pds` 同步 checkout 并复核 `gplace_seed 5` 在位；
> 树上 RTL 回到 rev1028 关档原样，工作区干净）。
> **122 逻辑 LUT 的门级来源仍未定位。** 若要继续查，剩下的路是"逐处改动静态对照"
> （每次只还原 A1 六处改动中的一处、跑单综合比 LUT）—— 注意报数抖动 ±14，
> 必须同会话对照；优先级低（不影响任何交付口径）。

## 6. 可复现性发现（E2 对照，本次最重要的方法论）

为区分"我的改动 vs 流程抖动"，用 **rev1027 原样 RTL**（`git stash` 暂存 A1 改动）重跑**同一流程、
同一 `gplace_seed 5`**（日志 `pds/_e2_pristine.log`，位流 `fefc16ae`）：

- **CPU 域：+0.277 ns / Fmax 87.0549 MHz / 0 失败端点 / totalEP 19,114 —— 与历史值逐位相同**
  （时序快照存证：`report_timing/rev1027_seed5_c6af65be.rtr`）；
- LUT 7,767（历史记 7,753，差 14 = 报数抖动）。

⇒ **两个结论**：
1. **流程确定性成立**：同网表 + 同 `gplace_seed` ⇒ 同余量。P3.6 的"钉 seed 5"做法是对的、
   可复现的（这一条本身就是值得写进论文的"过程可复现"证据）；
2. **但"钉 seed"钉的是"某一版净表"**：A1 让净表变了 +122 逻辑 LUT，同一个 seed 5 就给出
   −0.156 ns（85 MHz 下 5 个失败端点）。**不是流程抖动，是"新网表 + 旧种子"**。

**纪律（要落进 `SKILL.md` §8）**：
> **任何 RTL 改动（哪怕仿真逐位等价、哪怕 FF 数完全相同）都要假设钉住的 seed 余量作废；
> 出位流前先单跑一次核对 CPU 域余量，别拿旧余量下结论。**
> 推论：**"关档等价"只在仿真层成立**（CoreMark/CRC/riscv-tests 逐位不变），
> **综合层不成立**（LUT/时序会变）——所以"门控关掉就能回到旧网表"这条直觉要打折扣，
> 需要时得用"原样 RTL 重跑一次"来对照着说。

## 7. 建议（换档与否）

**建议：不换交付档**（跑分档 `c6af65be` / 演示档 `e51ac9e5` 保持 rev1027）。
理由（可直接引用）：

1. **主分收益太小且小于测量噪声量级**：+0.181%（仿真 216,695 vs 217,088 拍；经典分约 +0.7）
   尚未大到能盖过板上/仿真口径本身的差异（同一档：板上 217,036.1 vs 仿真 217,088 = 0.024%，
   但换档后面临新的位流、新的四个板级判据）；
2. **指标(3) 明确变差**：CoreMark/千 LUT `50.52 → 49.65`（−1.7%；该指标同频率下经典分/
   新公式分只差常数因子，**百分比结论相同**）；
3. **这条最关键 —— 净表一变，钉住的 `gplace_seed` 余量就作废**（2026-10-16 公式口径
   裁决后重写；旧论证"score ∝ 频率 ⇒ 降 2.4% 亏 2.4%"**已作废**，见任务书 v12 §0.2 #2）：
   A1 的最小代价形态（关档）就已把 CPU 域余量打到 −0.156 ns / 85 MHz 下 5 个失败端点
   ⇒ 不重扫 seed 就得把生产频率从 85.0051 降到 ≈83.89 MHz 才稳。**按裁决后的公式
   `Score = Iterations ÷ Total_ticks`，主频被约掉 ⇒ 83.89 MHz 下主分不掉**
   （216,695 拍 × ITER=4332 ⇒ `Total_Time ≈ 11.2 s`，仍 ≥10 s 不击穿有效性）；
   **但指标(2) Fmax 87.0549 → 83.8926 MHz（−3.6%）与上面的指标(3) −1.6% 是真退步** ——
   拿指标(1) 的 +0.18% 换指标(2)/(3) 的双降，成绩表上净亏；
4. 要拿回那 +0.277 ns 就得重做 seed 全扫（40 跑量级 ≈ 数小时机时）+ 两颗位流重出 +
   两条板级判据重测，去换 **+0.18%**（经典分约 +0.7）——性价比明显不足；
5. **排序规则也帮不了忙**：赛题"先比性能、性能相同再比面积"——0.18% 的性能优势
   换来 1.6~1.7% 的面积劣势，两个指标一个微升一个下降，本就是"效率上对、
   整张成绩表上不划算"的典型。

**若将来要换档**，前置条件（缺一不可）：
① seed 重扫（逐 seed 读 CPU 域，`scripts\capture_seed_timing.ps1` 钉新的最优 seed）；
② 两颗位流重出（跑分 + 演示，都用 `build_bitstream.ps1` 唯一入口）+ 两条板级判据重测；
③ 五处口径同步（`CLAUDE.md` 提交档表 / 论文 §0·§0.1 / `doc/board/README.md` /
`pds/RV32I_1/bitstreams/README.md` / `SKILL.md` §1）+ 旧档降为历史参照。

## 8. 落盘状态（会话结束时的仓库状态，已核对）

- **RTL**：`rtl/core/core.v` + `rtl/top/cpu_top.v` 的 `LANEB_ST` **默认 0**（不采纳），
  注释里写明"为什么默认 0 + 启用前置条件"；`rtl/core/csr_file.v` 的
  `DESIGN_REV = 0x2026_1028`（**树里的 RTL 前进了、交付位流没换** —— 与 P3 时
  "树里 rev1025 / 交付 rev1023"同款处理）
- **交付口径不变**（**所以"五处同步"本轮不需要做**）：跑分档 `c6af65be`、
  演示档 `e51ac9e5`、391.66 分 @85.0051 MHz、Fmax 87.0549 MHz、LUT 7,753 = 4.85%、
  四 CRC、riscv-tests 49/1/0 —— 一个字都不改
- **工作区改动清单**（`git status --short`）：
  `M rtl/core/core.v`、`M rtl/core/csr_file.v`、`M rtl/top/cpu_top.v`、
  `M scripts/build_bitstream.ps1`、`M sim/tb_riscv.v`、`M sim/tb_coremark.v`、
  `M sim/tb_rtthread.v`、`M sim/tb_gomoku.v`、`M sim/tools/tb_icache_dbg.v`、
  `?? sim/tests/tb_laneb_st.S`、`?? doc/reports/2026-10-16_a1_laneb_store.md`、
  `?? doc/paper/正文_v0_20261016.md`（**未 commit、未 push**，按纪律）
- **位流文件**：`pds/RV32I_1/generate_bitstream/cpu_top_board.sbit` 现为 E2 的产物
  （`fefc16ae`，rev1027 原样 netlist + seed 5）——**它不是交付档 md5**；
  上板前按纪律用 `build_bitstream.ps1` 重跑（唯一入口），**绝不烧旧/来路不明的 `.sbit`**
- **时序快照留证**（防被下一跑覆盖）：
  `report_timing/rev1027_seed5_c6af65be.rtr`（+0.277）、`rev1028_lanebst0_447c1261.rtr`（−0.156）、
  `report_timing/cpu_top_board.rtr`（= E2 的 +0.277）
- **`.pds`**：PDS 每跑都会重写；已 `git checkout` 复原（diff 只有 `_timespec` 抖动，
  选项一行未变），复核 `(_option gplace_seed (_integer 5))` **仍在** ✓
- 临时文件已清：`sim/_neg.vvp`（反例对照用）、`pds/_*.err`、`%TEMP%\neg_core`

## 9. 终态核对 + 下一步

**终态已复核**（改回默认 0 之后重跑）：
`tb_laneb_st` **PASS**、自证行 `SIM CONFIG: … LANEB_MEM=1 LANEB_ST=0`、
CoreMark `Total ticks = 217088` + 四 CRC `e9f5/e714/1fd7/8e3a` 逐位一致
⇒ **树里的默认档 = 交付档口径（仿真层）** ✓。

按用户给的顺序，A1 之后：
* **A1′（可选，10 分钟量级）** 拿回那 122 LUT：见 §5 的"未解项"（结构化门控 + 单综合对比）；
* **A2 配对率扩展** —— **先统计再放宽**：加计数器量出"因规则被拒的相邻对"里有多少真能安全配对
  （本报告 §4 的三条限制就是计数器要分的类），别盲动；
* **A3 BTB 扩容** —— 先估面积/Fmax 代价（LUT 现 7,753 = 4.85%）；注意优先级（RAS > BTB > PC+imm、
  绝不新增 `fetch_addr` 腿）；
* **A4 Fmax** —— 摘 1.76 ns 跨模块投放线（lane B load 数据源打一拍）：访存延迟 +1 拍
  ⇒ 每迭代拍数必须重测、三处口径同步；
* **A5 收口** —— 见 §7 的前置条件；**并且记住 §6 那条纪律：任何 RTL 改动都要重新核对时序余量**。
* **`SKILL.md` 待补一条**（§6 的纪律）—— 等用户确认后再改技能文件。

---

## 10. 动工 A2/A3 之前：**两项都已被历史实测否证**（省掉重复劳动）

用户给的 A2（配对率扩展）与 A3（BTB 扩容）在计划里还挂着"待做"，但仓库里**已有实测结论**
（同一个 §0 口径体系），开工前先对账：

| 计划项 | 历史结论（出处）| 本轮的补充确认 |
|---|---|---|
| **A2 配对率扩展** | `2026-10-15_pair_rate_analysis.md`：① `pair_analyze.py` 的规则模型**与实现脱节**（模型写的 `BREAK={BRANCH,JAL,JALR,SYSTEM,FENCE}` 是 Stage-0 假设，**实现只门控 `!p_pred_taken`** ⇒"预测不跳转的分支可配对"**早就实现**了）；② 该报告用"实测反推 73,353 对"与"模型 72,256 对"交叉验证（差 1.5%）；③ **结论：周期侧唯一剩下的门 = 给 lane B 访存能力**（上界 +7.46%，其中 store 单独只值 **+0.43%**）| **A1 = 那条门的最后一格，实测 +0.181%**（模型 +0.43%，模型已知乐观度 ~5%+）⇒ **配对率这条线已经走完**（load 已进交付档 +5.76%，store 不划算）|
| **A3 BTB 扩容 256→1024/4096** | `2026-10-13_handoff_pathB.md`：**A3 BHT 256→1024 实测只值 −233 拍（+0.10%），已回退**（commit `da45e41`）；`2026-10-13_handoff_btbras.md`：`+JALRTRACE` 实测 **jalr 1,374 条 100% 是函数返回**，直接映射 BTB（16~16384 项、1/2/4 路）捕获率**恒 6.40%**（不是冲突问题，是单点位自己就有 8 个目标）⇒ BTB 单独只值 **+0.04%**，正解是 **RAS（8 项 = 99.93%）**——**RAS+BTB 已经做进交付档**（B1）| **扩表对 BTB 也无效**（捕获率与表大小无关）⇒ A3 **关闭**；BTB 的价值在赛题点名的功能措辞，不进"优化闭环"表 |

⇒ **CPU 侧只剩 A4（Fmax，指标 2）**，且它有一个需要先说清楚的性质（见 §11）。

### 10.1 实测补齐：交付档的真实配对率与"还剩多少损耗"（`+PROF`，本轮实跑）

不想只引 10-15 的模型推算，于是对**当前交付档口径**（`-EarlyLd -LanebMem`，ITER=1）跑了一遍 `+PROF`：

| 项 | 实测（每迭代）| 占比 |
|---|---|---|
| `region cycles` | **217,088** | 100% |
| `region commit`（提交拍） | **195,094** | **89.9%** ⇒ 288,056 条指令 ⇒ **配对数 = 92,962 对（32.3%）** |
| `region noretire` | **21,994** | **10.1%**（`stall` 14,218 = 6.55% + `flush` 2,452 = 1.13% + 残余）|
| 旁证 | `mul exec` 9,396（`near` 108）、`fwd ex` 36,288、`fwd wb` 27,007、`mem acc` 43,228 | — |

**三条可用结论**：
1. **配对数 92,962 对** —— 比 10-15 模型给"load+store"的 88,202 还高（模型偏保守），
   说明 lane B 访存两级确实吃到了预期的量级；
2. **89.9% 的拍在提交** ⇒ 流水线已接近"提交受限"，损耗面只剩 10.1%
   ⇒ **效率侧的结构性余量 = 195,094 − 288,056/2 = 51,066 拍（理论全配对下限 144,028）**；
3. 这 51,066 拍的主要来源**不是"判据太保守"**（那几条早已逐条量化），而是
   **"lane B 不能是分支/跳转/CSR/AMO"这条结构限制** ⇒ 要动它 = 把重定向/BHT/RAS/BTB/陷阱
   整体复制到第二槽，**代价与风险不成比例，属于"换结构"级别**。
   ⇒ **A2 以"实测确认收敛"结案**（不是"没试过"，而是"知道剩下的是什么、也知道不值"）。

## 11. A4 判定：**不做**（先做 0 成本可行性推导 ⇒ 结论是否，省掉一轮 RTL + PDS）

### 11.1 落点已探明（子代理 + 源码核对，比计划书更准）

| 事实 | 落点 |
|---|---|
| 那条路的 DRAM 是 **`u_pat` = pattern 显存**（不是 palette）：`rtl/video/video_core.v:89-99`（`vram_b32 #(.AW(16)) u_pat`），`pat_q` 来自 `rtl/video/vram_b32.v:50-51` 的同步读（输出寄存） | `video_core.v:61,159` |
| 读译码/读数据 mux：`mem_bus.v:456-458`（`rsel_d==3 ? vid_rdata : …`），`vid_rdata` 是 mem_bus 的输入（`mem_bus.v:84`） | — |
| `mem_ready` **唯一**产生点：`mem_bus.v:373-374`；视频区现在**恒 1**（`mem_bus.v:357-359` 注释） | 一行可改 |
| 写通路**不查 ready**（`mem_bus.v:205` / `239`，视频 BRAM 同址同值幂等） | 写侧无风险 |
| 视频窗口读的**唯一消费者**＝"CPU load 且地址落在视频窗口"；固件只读 `VIDEO_STATUS`（寄存器窗口，`scripts/gomoku/video_port.c:62`），`scripts/rtthread/` 无命中；PPU 走**另一端口**（pix_clk） | ⇒ CoreMark/固件**都不读 pattern 窗口** |
| 现有多拍就绪先例：D-Cache 缺失 `cache_d.v:139-141`、仿真 `+MEMWAIT` `mem_model.vh:85,135-146`（**都只作用于数据口 B**）；core 侧统一消费 `core.v:1243 mem_ready_int` | 机制现成 |
| 测试：`sim/tb_video_core.v` 大读 NT/PAT/PAL，但它的 `mem_rd` **硬编码 1 拍、不查 ready**（`tb_video_core.v:168-178`） | 要改才不误报 |

### 11.2 但推导出**两条硬结论**（这才是判"不做"的依据）

**结论 ①："只把 `mem_ready` 多压一拍" = 零收益（不是"零代价换收益"）。**
那条路是**同沿内**的组合链（起点 = `u_pat` BRAM 的输出寄存时钟沿，终点 = 指令 RAM 的 `ADB0`）。
多压一拍只改变**流水线相位**，**不会**从网表里去掉任何一级组合逻辑 ⇒
违例路径**结构上仍然存在**（被 enabled 寄存器挡住的 D 端路径，STA 照样分析）。
⇒ 计划书里"视频窗口读多压一拍就能挪走 1.76 ns"这一步**不成立**。

**结论 ②：要真去掉，必须把视频读数据**打拍**（寄存器插进那条链），
但这会撞上 core 的**读数据契约**，改动落到 CPU 关键逻辑上、且收益仍有疑问：**

* core 的消费方式是 `load_src = wb_rdata_snap_en ? wb_rdata_snap : mem_rdata`（`core.v:1797`）；
  快照在**停顿的第一个沿**抓 `mem_rdata`（`core.v:1779-1793`）⇒ 隐含契约是
  **"读数据必须在停顿第一拍就已有效"**（这也是 D-Cache 缺失/`+MEMWAIT` 只延长停顿、
  不推迟数据到来的原因，见 `mem_bus.v:368-369`）。
* 若把 `vid_rdata` 打一拍（数据推迟到 T+2），快照在 T+1 抓到的就是**上一个访问的旧值** ⇒
  要么给 core 加"迟到读数据"端口 + 在 `load_src` 前**再加一级 mux**（**正好加在要缩短的那条链上**，
  实测每级 mux ≈ 0.2~0.3 ns，见 `core.v:1766-1770` 的历史教训），要么改快照时序（更险）。
* **收益估算（决定性）**：`+0.277 ns` 那版的 `Logic 4.522 / Route 6.620`（≈ 11.14 ns）
  就是**去掉时钟插入后的纯逻辑/布线**；其中跨模块段只占 `tco 1.644 + net 1.760 = 3.404 ns`。
  即使把这段全切掉，剩下的**尾段（lane B 解包 → 前递 → ALU lt → 分支解析 → 重定向 →
  `imem_addr`/`imem_addr2` → ADB 高扇出 1.201 ns）仍需 ≈ 9.4~11.1 ns 去挤 11.76 ns 周期**
  ⇒ **首尾都在临界点上，赢面不明**，而代价是往 CPU 关键逻辑里插一级 mux + 新增跨模块端口 +
  改契约注释 + 改 `tb_video_core.v` 的 `mem_rd` + 全套回归（含 `+MEMWAIT` 组合）。

**⇒ 判定：A4 不做。** 理由写成一句话：
**"它要动的那条链的命门在 CPU 侧（lane B 解包→前递→ALU→重定向），不在视频侧；
视频侧那 3.4 ns 只是它的引子。切引子不解决命门，而切命门要给所有 load 加拍（43,228 次/迭代）。"**

### 11.3 三处"剩余瓶颈"各自的处置（把这条线一并收口）

| 瓶颈 | 量级 | 处置 |
|---|---|---|
| 跨模块投放线（`u_pat → u_soc`） | 1.760 ns | **不做**（见 11.2：切了不解决命门）|
| `ADB` 高扇出线（扇出 16） | 1.201 ns | 只能靠"取指地址再打一拍"或复制驱动寄存器 ⇒ **前者 +1 拍取指代价（直接亏分）**，后者收益 < 0.3 ns 且要动 `fetch_addr` 腿 ⇒ **不做** |
| 时钟树插入（fanout 3140） | 1.615 ns | **物理项**，不是 RTL 能改的（`.fdc`/region 已有四次否证先科）|

⇒ **Fmax 在 RTL 侧到顶**：`+0.277 ns` 距 `+0.3` 判据差 0.023 ns，**只剩物理手段**。
这条结论本身值得写进论文第 6/8 章（"我们的 Fmax 已经压到 RTL 边界"）。

### 11.4 历史 §11（原始设想，保留作对照：它**已被 11.2 否证**）

<details>
<summary>展开看当时的设想（勿据此开工）</summary>

### 11.0 A4 的新认识：**它可能是 CoreMark 的"零周期代价"项**

`margin_plan` §6.9 的关键路径（+0.277 ns 那版）逐级是：

```
u_video/u_core/u_pat/mem_1_3/gopdrm_36k/CLKA（视频域调色板 DRAM）
  DRM tco 1.644 → net 1.760  pat_q[23]        ← ★ 跨模块长线（u_video → u_soc）
  → vid_rdata → load_half_b → load_data_b → wb_data_b[21]
  → rs2_val[21] → ALU 的 lt 比较链 → branch_taken
  → ex_resolve_taken → if_addr_d → imem_addr → imem_addr2 → net 1.201（扇出 16）→ ADB0
```

**关键观察**：这条链的**起点是"视频调色板窗口的读数据"**，也就是说
**它只可能被"访存地址落在视频窗口"的 load 走到**。而：

* **CoreMark 全程不碰视频窗口**（它的全部访存都在 RAM 段）⇒ 若把"视频窗口的读"做成
  **2 拍就绪**（在 `u_pat` 的 DRAM 输出后打一拍，或让 `mem_bus` 对视频窗口多压一拍
  `mem_ready`），**CoreMark 的 217,088 拍不变**（主分不动），而 CPU 域关键路径上
  那 **1.76 ns 跨模块长线**就从路径里挪走；
* 代价只落在**演示固件读视频窗口**的少数访问上（五子棋是"写像素"，读窗口极少）
  ⇒ 对两条板级判据基本无影响；
* 机制现成：`mem_ready_int` 多拍就绪 + `stall/冻结拍` 那套已经为 Cache / `+MEMWAIT` 建好了，
  **不需要新发明**（但要重新过一遍"冻结拍副作用"那几条纪律，见论文第 5 章）。

**⇒ 这才是"效率优先"前提下值得做的 Fmax 项**：它把"指标 2"的收益与"主分"解耦
（不是"降频换余量"那种两难）。**要先做的一步（便宜）**：确认视频窗口读路径的**真实消费者**
（`load_data_b` 是 lane B 的 load 解包 —— 需要顺着 `mem_bus`/`u_pat` 再核一遍），
然后估"新路径（打拍后的寄存器 → lane B 解包 → ALU → 分支 → 取指）"还剩多少 ns
—— 若它本身就 > 11.76 ns 周期，那收益要打折，别按 1.76 ns 全额算。

**流程（照 A1 的教训）**：改 RTL → `DESIGN_REV` 递增 → 先仿真**功能等价 + 周期数核对**
（CoreMark 必须仍是 `217,088` + 四 CRC；视频窗口读的新延迟用 `gomoku`/`tb_riscv` 定向用例验）
→ 单跑一次 PDS 核对 CPU 域余量与 Fmax → 再决定是否走 A5 收口（重扫 seed + 两颗位流 + 两条板级判据）。

</details>

> **[!] 上面这段已被 §11.2 否证**：结论 ① 说"多压一拍"零收益（组合路径结构上还在），
> 结论 ② 说"打一拍"要动 core 的读数据契约、且尾段仍需挤 11.76 ns 周期。
> 保留原文是为了让后来的会话看到"设想 → 否证"的完整轨迹（本项目的一贯做法）。
