1979711854/riscv-cpu-fpga/doc/reports/2026-10-16_handoff_p3_6.md

# 交接文件：P3.6 已收口（1 档余量 → `+0.277 ns`，板测 **391.66 分**）

> 写于 2026-10-16 晚。上一会话入口：`doc/reports/2026-10-16_handoff_p3.md`（P3.5）。
> 本文件是**下一会话的唯一起手指南**；数字口径以 `doc/paper/论文框架_v1_20261012.md` §0/§0.1 与
> `CLAUDE.md` 的提交档表为准（本会话已同步）。
> 详细过程与全量数据：`doc/reports/2026-10-16_p3_6_margin_plan.md`。

---

## 0. 一句话

**1 档（`LANEB_MEM=1`）跑分档已定版并上板**：位流 `c6af65be`，CPU 域 **+0.277 ns** / Fmax **87.0549 MHz**，
板上 **`391.66` 分**（`Total ticks 940,200,316` = 11.0605 s，四 CRC 逐位一致）——
比 0 档（370.31）**+5.76%**，是**历史最好成绩**。判据 `≥ +0.3 ns` **差 0.023 ns 未达**（方向② 已到顶）。

---

## 1. 现在的状态（精确）

| 项 | 值 |
|---|---|
| HEAD | `92d09d9`（**本会话未提交、未 push**） |
| RTL | **未改**（`DESIGN_REV=0x2026_1027`）；`git status` 只有 `.pds` 与文档 |
| 跑分档位流 | `pds/RV32I_1/bitstreams/coremark_dual_noaext_ms_earlyld_a1_ras_btb_lanebmem_85mhz_rev1027_seed5pin_c6af65be.sbit`（**已上板验证**）|
| 演示档位流 | `…_rev1023_1e2075e6.sbit`（**仍是 0 档 rev1023**，见 §3(A)）|
| `RV32I_1.pds` | `cmd_pnr` 里 **`(_option gplace_seed (_integer 5))`**（单 seed 模式，**故意钉住的**）+ `parallel 4`；`_timespec` 有例行变动 |
| 本会话改过的文档 | `CLAUDE.md`（提交档表 + 四条纪律 + P3.6 块）、`doc/paper/论文框架_v1_20261012.md`（§0/§0.1 + 口径纪律）、`doc/board/README.md`（新增 1 档上板节 + 顶部口径横幅）、`pds/RV32I_1/bitstreams/README.md`（登记 `c6af65be`）、`doc/reports/2026-10-16_p3_6_margin_plan.md`（新建，含全部数据）、`doc/reports/2026-10-16_session_state_p3_5.md`（§7 回填） |
| 证据目录 | `pds/_capture_p36/`（40 份逐 seed `.rtr`、route 扫描 8 份、`seed_cpu_wns_summary.csv`、构建日志；**未跟踪**）|

---

## 2. 本会话做了什么（**不用重查**）

1. **方向② 四条路走完，封顶 `+0.277 ns`**：40 个 place seed（max +0.277，软顶 ≈ +0.28）、
   同一布局扫 8 个 route seed（max +0.277）、官方 5 个优化开关显式全开（**逐位不变** ⇒ 本来就生效）、
   `place_ignore_high_fanout_net=OFF`（逐位不变，且该键被 PDS 丢弃）。
2. **交付**：`.pds` 钉 `gplace_seed 5` ⇒ 走 `scripts\build_bitstream.ps1 coremark` 完整体出位流 `c6af65be`
   ⇒ 上板 **391.66 分**（日志 `doc/board/uart_20261016_155605.txt`）。
3. **方法论（下次换档/换版直接复用）**：
   * 逐 seed 读 CPU 域的正确姿势：**P&R 跑动中每 4 s 抢拷 `place_route/seed_*/cpu_top_board.rtr`**
     （拷之前判 `Length > 1KB` 防竞态；跑完再从被保留的 `seed_<best>/` 重拷）。
     **`saved_outcome` 无效**（PDS 跑完把键删掉，日志逐条 `Work directory … has been removed`）。
   * **`gplace_seed` = 起始 seed**，可钉死布局：`gplace_seed 5`（单 seed，结果直接落 `place_route/`）
     ⇒ 复现 +0.277 逐位相同；`gplace_seed 8` + `gplace_times 8` ⇒ 得到 seed_8..15。
   * `report_timing/cpu_top_board.rtr` 在整个 P&R 期间**不更新**，只在最后出 —— 排 seed 必须读 `seed_*/` 那份。
4. **三个新坑（已写进 CLAUDE.md 与论文框架 §0）**：
   * **PDS 选种口径错**：按"全设计最差"= **跨域 CPU→`pix_clk` 伪影**排序，4 批默认挑到 CPU 域
     **+0.014 / +0.166 / −0.111 / −0.091 ns**（**后两批时序不过**）⇒ 1 档出位流**必须**逐 seed 读 CPU 域再钉 seed。
   * **`.sbit` 的 md5 不是布局指纹**：同一布局两次构建 md5 就不同（`9b58e84c`/`28f8ae6b`；
     `2e966285`/`c1b7e279`/`c6af65be` 同一布局）⇒ 引用位流给"md5 + 来源报告 + 日志时间"三件套。
   * **PDS 每次跑完重写 `.pds`**（含 `_timespec`，并会把我手工加的非默认项删掉/改写）
     ⇒ **改选项必须在流程空闲时做，跑完复核**。
5. **`build_bitstream.ps1` 的口径 bug（待修）**：`$cpiCycles` 只按 `DUAL_ISSUE` 取值、**不看 `LANEB_MEM`**
   ⇒ 它会打"期望 994,614,204 ticks / 370.2 分"，而 1 档真实是 **940,425,216 / 391.6**。

---

## 3. 下一会话的第一件事（按优先级）

### (A) 把演示档切到 1 档（**性价比最高**，~1 小时）
目标：RT-Thread 五子棋用 1 档 RTL（rev1027）出位流 + 上板，让"统一定版"成立。
1. **先补 1 档功能仿真**（`scripts/gomoku/run_sim.ps1` 从 P3 起就挂着没做 1 档回归；
   RT-Thread 四配置在 P3.5 已过 `LANEB_MEM=1`，但 **gomoku（G3）没有记录**）。
2. 出位流：`scripts\build_bitstream.ps1 rtthread`（判据看 `expectLines` + sha256 守卫）。
3. 上板判据（照抄 `build_bitstream.ps1` 输出）：banner / `[boot] gomoku render thread running` /
   两条线程 + `[hb]` 无断 / **真按键接 HDMI 下完一局**（`led[2]=done` 在本变体**不会亮**，别误判）。
4. 顺带：`doc/board/README.md` 顶部横幅里"演示档仍是 0 档"那句要改成实际结果。

### (B) ① region/floorplan（补最后那 0.023 ns，**需要你进 GUI**）
- 卡点：`pce.exe` 的 CLI 未通、器件 `.eval` 加密、`.adf` 二进制 ⇒ **`def_region` 坐标只能 PCE GUI 框选**
  （做法见 `2026-10-15_pce_region_attempt.md` §1/§2；双 pcf 的 `target_file ON` 技巧 + region pcf 里
  **不能有 `def_port`**，否则 8/8 seed 全失败）。
- 负面前科（**确定性**）：把 `u_core + u_mem` 框进 **29% die** 的区域 ⇒ u_pll slack `+0.034 → −0.755 ns`，
  连区域外的 `u_video` 都被搅动。⇒ 只能做**定向窄**约束，**只跑一轮就止损**。
- 可动的三处（`p3_6_margin_plan.md` §6.9）：跨模块投放线 **1.76 ns**（`u_video/u_pat` 调色板 DRAM → CPU lane B）、
  ADB 高扇出线 **1.20 ns**（fanout=16 → `u_mem` 的 16 个 BRAM）、时钟树插入 **1.62 ns**（fanout=3140，基本无解）。

### (C) 脚本口径修复（小活，防下次再被误导）
- `build_bitstream.ps1`：从 `rtl/top/cpu_top.v` 读 `LANEB_MEM`，为 1 时 `$cpiCycles = 217088`。
  **改 `.ps1` 必须保持 UTF-8 BOM**。
- `run_coremark.ps1` 在 PS 5.1 下被 vvp stderr 警告打断（P3.5 §6，一直挂着）。

### (D) 把"抢拷逐 seed 报告"固化成 `scripts\` 里的工具
（`place_route/seed_*/cpu_top_board.rtr` 轮询拷贝 + 自动打印 CPU 域表格）——
下次换档/换版还要用，别每次现写。

### (E) 提交与清理
本会话的 `.pds` + 文档**还没 commit**（项目纪律：按里程碑提交、不 push）。
`pds/_capture_p36/`（~28 MB，未跟踪）建议保留（是"40 个 seed"的唯一原始证据），
或把 `.rtr` 压成摘要后删掉 —— **由你定**。

---

## 4. 优化方向候选（下一层的账本，含量级/成本/风险）

| # | 方向 | 预期 | 成本 | 风险 | 依据 |
|---|---|---|---|---|---|
| 1 | **演示档切 1 档**（§3A） | 统一定版 + 演示口径一致 | 1 小时 | 低（纯重出 + 上板） | 1 档功能仿真已过（rtthread 四配置）|
| 2 | **① 定向窄 region**（§3B） | 最多 +0.02~0.05 ns（只差 0.023） | 每轮 10 min + GUI 取坐标 | **高**：大区域已判死；坐标靠手框 | 10-15 报告 + §6.9 三处瓶颈 |
| 3 | **RTL：把 `imem_addr2` 的 `+1` 折进 `fetch_addr` 各腿** | 可能省 0.1~0.2 ns（去掉 ADB 前那级） | 半天 + 覆盖全部腿的全量回归 | **高**（P3.5 §5 已标"风险高"；漏一条腿就功能错） | `p3_5` §4.1 / §5 |
| 4 | **RTL：lane B 的 load 数据源打一拍**（`vid_rdata`/`wb_data_b` 侧） | 打断 **1.76 ns** 跨模块投放线，可能 +0.3~0.5 ns | 半天 + 访存延迟 +1 拍要算账 | 中（吃掉部分"早读"收益；需重测 217,088） | §6.9 第一处瓶颈 |
| 5 | **RTL：ALU `lt` 比较链减级**（`N590.eq` 那串，ALU 内 ~0.8 ns） | +0.1~0.2 ns | 1 天 | 中 | `p3_5` §4.1 |
| 6 | **更多 place seed** | 软顶 ≈ +0.28，命中 +0.3 概率低 | 每 8 个 ≈ 10 min 墙钟 | 无 | 40 样本分布 |
| 7 | **提频（85.0051 → 87 MHz）** | +2.4% 分 | PLL 三处联动 + 重测 | **不值**：Fmax 87.0549 只剩 0.055 MHz 余量 | §6.9 |
| 8 | **效率侧（主分）**：双发射配对率、lane B 放 store、RAS/BTB 深度、`EARLY_LD` 扩展面 | 主分 = CoreMark/MHz，**这是唯一主战场** | 每次要全量回归 | 中 | 赛题新公式（§0 更新块 1）|
| 9 | **面积侧**：LUT 7,753（`CoreMark/LUT` 是第三指标） | 第三指标 | 低 | 低 | 赛题三项指标 |
| 10 | **工程/材料**：论文表 6 优化闭环补 lane B 这一级、**录像/照片至今为零** | 评审材料 | 半~1 天 | 无 | P3.5 §7 |

---

## 5. 关键数字速查（1 档 = 当前口径）

| 项 | 值 |
|---|---|
| 得分（跑分档） | **391.66 @ 85.0051 MHz**（ITER=4332，`Total ticks 940,200,316` = 11.0605 s）|
| 拍/迭代 | **217,036.1**（板上）/ **217,088**（仿真）⇒ **4.6076 / 4.6064 CoreMark/MHz** |
| 时序 | CPU 域 **+0.277 ns / 0 失败端点（19,114）**；Fmax **87.0549 MHz**；跨域伪影 −1.074 ns（**不是回归**）|
| 资源 | LUT **7,753 = 4.85%**、FF 3,691、DRM 101.5、APM 4 |
| RTL | `DESIGN_REV=0x2026_1027`；判据 217,088 + 四 CRC `e9f5/e714/1fd7/8e3a` |
| 位流 | 跑分 `c6af65be`（在 `bitstreams/`）；演示 `1e2075e6`（0 档，待换）|
| 主频 | 85.0051 MHz（`STATIC_RATIO0=13.5`）|

---

## 6. 本会话踩过的坑（勿重蹈）

1. **`saved_outcome` 无效**（想保留全部 seed 目录的唯一可行办法是"跑动中抢拷"）。
2. **PDS 跑完会重写 `.pds`** —— 我在流程还在跑时改的 `gplace_seed 16` 被它冲回 8；`gplace_times 1` 会被删。
3. **抢拷要用独立目录**：我第一次把 route 扫描的 `seed_0..7` 拷进跟第一批同名的目录，
   脚本判"文件已存在"就跳过了 ⇒ **每轮跑用新的子目录**。
4. **位流 md5 不是布局指纹**，`RTL=` 自证行也不是（`9b58e84c` 与 `c6af65be` 同为 `0x20261027`）。
5. **PDS 出位流期间会删旧文件**：脚本写位流时 `Get-Item` 会报"文件不存在"，属正常。
6. 读被占用的日志/文件要用 `FileShare.ReadWrite`，否则 `Get-Content` 报"正被另一进程使用"。
7. 本地 `Select-String`/`Get-Content` 偶被安全策略拦，加 `-Encoding UTF8` 即可放行。
8. **`.ps1` 必须是 UTF-8 BOM**（PS 5.1 否则按 GBK 读，中文注释会吃掉引号配对）。
9. **钉 `gplace_seed` 后 `place_route/multiseed_result.csv` 不再产生**（单 seed 模式没有多布局结果，
   PDS 顺手把 `.pds` 里那条输出项也删了）—— 想要那份 csv 就把 `gplace_seed 5` 换回 `gplace_times 8`。
   **也就是说：`c6af65be` 这一版的 `multiseed_summary.csv` 是多 seed 时代的产物，别拿它当本次交付的证据。**

---

## 7. 未决 / 遗留

* 演示档 1 档位流（§3A）；`scripts/gomoku/run_sim.ps1` 的 1 档回归（从 P3 就挂着）。
* ① 的 region 坐标（要 GUI）；`pce.exe` CLI 那条路没通。
* `build_bitstream.ps1` 的 `cpiCycles`/得分口径（1 档应 217,088 / 391.6）。
* 0 档 `55fae69e` 的定位：论文里作为"同设计关掉 lane B 访存"的对照档保留（不要删）。
* 本会话未 commit / 未 push；`pds/_capture_p36/` 的取舍。
* 论文：表 6 优化闭环补 lane B 这一级（已在 §0 行里加）；**录像/照片仍为零**。

---

## 8. 下一会话开场提示词（**直接复制粘贴即可**）

```
接 P3.6（HEAD 以 `git log --oneline -1` 为准；P3.6 里程碑提交 = `e8426dd`）。上一会话已收口：
1 档（LANEB_MEM=1）跑分档定版并上板 ——
位流 c6af65be（CPU 域 +0.277 ns / Fmax 87.0549 MHz，P&R 钉了 gplace_seed 5），
板上 391.66 分（Total ticks 940,200,316，日志 doc/board/uart_20261016_155605.txt），
比 0 档 370.31 高 +5.76%；判据 ≥+0.3 ns 差 0.023 ns 未达（layout 软顶 ≈ +0.28）。

先读（按顺序）：
1) doc/reports/2026-10-16_handoff_p3_6.md   ← 状态 / 已做完不用重查 / 下一件事 / 优化方向账本 / 坑
2) doc/reports/2026-10-16_p3_6_margin_plan.md ← ② 的全量数据与结论（含关键路径三处瓶颈）
3) doc/paper/论文框架_v1_20261012.md §0/§0.1 ← 全项目唯一口径（已更新到 1 档）

本会话目标（按优先级做，做完一个就落盘）：
(A) 演示档切 1 档：先补 gomoku(G3) 在 1 档下的功能仿真（scripts/gomoku/run_sim.ps1，从 P3 起就挂着），
    再 scripts\build_bitstream.ps1 rtthread 出位流，上板按"banner / [boot] gomoku render thread running /
    两线程 + [hb] 无断 / 真按键接 HDMI 下完一局"四条判据验（此变体 led[2]=done 不会亮，别误判）；
    完成后把 doc/board/README.md 顶部横幅里"演示档仍是 0 档"那句改成实际结果。
(B) 若还要补时序余量：① 定向窄 region（需要你进 PCE GUI 框坐标 —— pce.exe CLI 未通、器件 .eval 加密、
    .adf 是二进制；框好后我按 2026-10-15_pce_region_attempt.md 的双 pcf 做法跑，region pcf 里不得有 def_port），
    只跑一轮、不改善就停（29% die 的大区域已有确定性负面前科：+0.034 → −0.755 ns）。
(C) 小活：build_bitstream.ps1 的 $cpiCycles 口径（1 档应 217088 / 391.6，现在打的是 0 档的 994,614,204 / 370.2）；
    把"P&R 跑动中抢拷 place_route/seed_*/cpu_top_board.rtr + 打印 CPU 域表格"固化成 scripts\ 工具。改 .ps1 保持 UTF-8 BOM。

纪律与坑（务必遵守，细节见交接 §6）：
- 本项目数字口径以 论文框架 §0/§0.1 + CLAUDE.md 提交档表 为准；改数字必须三处同步。
- PDS 的多 seed 选种口径按"全设计最差"（= 跨域 CPU→pix_clk 伪影）排序，会挑错布局
  （4 批默认挑到 CPU 域 +0.014/+0.166/−0.111/−0.091 ns，后两批时序不过）⇒
  出 1 档位流必须"逐 seed 读 CPU 域 → 钉 gplace_seed 5"（pds/RV32I_1/RV32I_1.pds 的 cmd_pnr 已钉）。
- .sbit 的 md5 不是布局指纹（同一布局两次构建 md5 不同）；引用位流给"md5 + 来源报告 + 日志时间"三件套。
- PDS 每次跑完都会重写 .pds（含 _timespec，会删/改我手工加的选项）⇒ 改选项必须在流程空闲时做、跑完复核。
- saved_outcome 无效；逐 seed 取证只能"跑动中抢拷"，且每轮用独立子目录。
- 交付纪律：上板前重跑 build_bitstream.ps1（唯一入口，含 mem.hex sha256 + 行数守卫）、
  下板/换时钟后必须重跑脚本、commit 不 push（本次已按你要求 push）。
```
