1979711854/riscv-cpu-fpga/doc/reports/2026-10-15_session_state_p0p1.md

# 会话状态 —— 2026-10-15（下午场：P0 / 砍 RV32A / 修 Run All / P1）

> [!] **2026-10-16：P2 已完成**（§6 的"下个会话第一件事"已交付）——
> 任务书 §4 的 A~L 全部落地、`LANEB_MEM=0`、**四条基线逐位不变**。
> 本文件 §6 的起手指引作废，改看 **`2026-10-16_session_state_p2.md`**（含两处对任务书的勘误）。

> 接 `2026-10-15_session_state.md`（上午场：演示档 rev1022 / 约定45 评估 / PCE 区域约束实验）。
> **本文件取代它 §6 的「下个会话起手」**。
> **本会话一条任务线都没做完的：lane B 的 P2（RTL）—— 那是下一个会话的第一件事。**
> 本会话完成的是 P0、一项面积优化、两处测试基建、以及 P1。

---

## 1. 一句话

**赛题规则变了**（用户 2026-10-15 转述）：`Score = Iterations/(Total_Time×Frequency)`，
**化简即 CoreMark/MHz ⇒ 主频与面积都不进主分**，三项指标是 (1) 执行效率 (2) Fmax
(3) CoreMark/LUTs，排序 **先比性能、性能相同再比面积**。
据此先做掉了一项**零性能代价的面积优化**（砍 RV32A：LUT −441、余量 +0.034→+0.330 ns），
然后回到 lane B 线：P0 基线复现、P1 配对模型 —— **P1 与任务书的模型差 1.7 倍，见 §5**。

---

## 2. [OK] P0：四条基线复现（提交 `d12598c` / `19d53d9`）

**判据按字面不通过 —— 但偏差已定量归因，是文档陈旧不是 RTL 问题。**
全文见 **`2026-10-15_laneb_mem_p0_baseline.md`**。要点：

| 配置 | 文档值 | **实测（当前 RTL）** | 差 |
|---|---|---|---|
| dual + `EARLY_LD`（默认）| 229,597 | **229,597** | 0 [OK] |
| dual + `EARLY_LD=0` | 252,730 | **249,982** | −2,748 |
| 单发射（无 `EARLY_LD`）| 303,140 | **300,392** | −2,748 |
| dual + I+D Cache | 235,628 | **233,013** | −2,615 |

* −2,748 **恰好**是 `23ff4b3`（B1-RAS）提交信息里记的收益 ⇒ 文档那三条是 **pre-RAS 口径**
  （`CLAUDE.md:138` 自己标注过"后三个均未含 RAS，未重测"，任务书 §6 照抄了进去）。
* 四 CRC `e9f5/e714/1fd7/8e3a`，**五条配置逐位一致**。
* **[!] 另发现**：任务书 §6/§9 的时序闸门 **79.1 MHz 是方案 B 的盈亏平衡点**，
  方案 A 应为 **82.09 MHz**；且"余量 +0.034 ns"换算成新增延迟预算是 **+0.45 ns，不是零**。

---

## 3. [OK] 砍 RV32A（提交 `b05bb82` / `e6ae9bf`）—— 位流 `55fae69e`

用户批准（"RV32A 可以砍"）。依据：两个交付固件**都不含原子指令**
（CoreMark `-march=rv32im_zicsr` 编译器发不出；RT-Thread 档 ELF 实测 0 条 ——
反汇编 0 命中、原始机器码扫 opcode `0101111` 只命中 2 个 ASCII 字符串）
⇒ **零性能代价，纯省面积**。

| | 之前 `f64b977` | 现在 `55fae69e` |
|---|---|---|
| LUT | 8,104 | **7,663**（−441 / −5.44%）|
| FF | 3,899 | **3,675**（−224）|
| DRM | 101.5 | 101.5 |
| CPU 域 slack | +0.034 ns | **+0.330 ns**；可达 **87.4585 MHz** |

**回归全部逐位不变**：CoreMark 五配置（229,597 / 249,982 / 287,056 / 300,392 / 233,013）、
四 CRC、riscv-tests 49/1/0、own_tests 5/0、RT-Thread 仿真两配置 PASS、`tb_amo_int` T0 PASS。

**实现要点**（都在 `rtl/core/core.v`）：
* `parameter A_EXT = 0`（默认关）；`amo_unit` 用 **`generate` 包住不例化**
  —— 只把 `start` 接 0 **不够**（单元内部锁存/状态机寄存器不依赖 start 的常量性，
  综合器不会证明它们恒为常量，面积省不下来）。
* `A_EXT=0` 时 AMO 的 opcode **补一条 `illegal`**（RISC-V 规定未实现扩展 ⇒ mcause=2）。
  **已单独验证**：拿 `amoadd.w` 的程序跑，`RAM[0x2000]` 不被改写、`ST_LATCH=0`、
  pc 钉在 `0x00000004` 反复走 trap 向量 ⇒ 判非法陷入，**不是静默执行、不写坏内存**。
* `DESIGN_REV` → `0x2026_1023`（约定 42）。
* **验证口径保住**（"RV32A 实现并验证过"的证据链不断）：`tb_amo_int` 写死 `A_EXT=1`；
  `run_own_tests.ps1` 传 `-DAEXT`（套件含 `tb_amo_cpu`，不传会 testnum 668 FAIL，
  **那是预期行为**）；`rtthread\run_sim.ps1 -Atomic` 传 `-DAEXT`（硬件原子固件）；
  `run_riscv_tests.ps1` **不传**（回归集无 rv32ua，`A_EXT=0` 才是板上口径）。

---

## 4. [OK] 修 Run All 的两个洞（提交 `61dab03`）

1. **`tb_ppu.v` 不在排除表里** ⇒ Run All 走到它就抛异常中断，**排在它后面的一律不跑**。
   排序上 `tb_ppu` 之后是 `tb_rvc` / `tb_uart_fifo` / `tb_uart_rx` ⇒
   **这三个自 `tb_ppu` 存在以来从没跑过**。已把四个视频台补进 `$externalProgramTbs`。
2. **`tb_multiplier.v` 840 项全 FAIL**（与本次改动无关，单独编它就挂）。根因：
   `7ad11de`（A1）给 `multiplier.v` 加了 `en` 端口，这个测试台没跟着改 ⇒
   `en` 悬空 = Z ⇒ 流水线永不使能 ⇒ done 永不高。**已修，840/0 PASS**。
3. **`tb_rvc.v` 32 项里 10 项 FAIL** —— 首次真正跑到它才发现。但 RVC 已评估为【不做】
   （同命令行只换 `-march=rv32imc`，静态指令数 **+0.7%**，收益≈0），且
   `rvc_expand.v` **全仓无人例化** ⇒ 对交付物零影响，**死代码**。
   已单列 `$knownFailingTbs` 并**每次跑都打印告警**。**处置未决**：修 10 个位域，还是连模块一起删？

---

## 5. [!] P1：配对模型给出 +6.0%，但**与任务书差 1.7 倍**（提交 `36cb43b`）

`scripts/pair_analyze.py` 加了 ④ 档「lane B 可放 load + 每对最多一条访存」。

| 档 | k | Δ | 周期 | Score |
|---|---|---|---|---|
| ③ 现状近似（= 当前实现的忠实模型）| 73,647 | — | 229,597 | 4.3555 |
| ④ +lane B load | **87,429** | **+13,782** | **215,815（−6.00%）** | **4.6336（+6.4%）** |

* **正面证据**：③ 档 k=73,647 与实测反推（`region commit` 214,703 拍 ⇒ 288,056−214,703
  = **73,353 对**）只差 **0.4%** —— 比任务书 §2 记的 1.5% 还紧 ⇒ **基线可用**。
* **[!] 与任务书 §1 对不上**：任务书说 A 档 k=80,122、Δ=+7,866（+3.5%），
  本模型 87,429 / +13,782（+6.0%）。任务书那张表出自一份**「临时变体脚本」，没有入库**，
  无法逐条对差。**⇒ P1 只给量级与方向，不能当判据。**
* **模型的两个盲区（都让 +6.0% 偏乐观）**：① 看不到 **lane B load 的 load-use 停顿**
  （lane B 不走 `EARLY_LD` 快通路，其后继依赖指令要多停一拍；`STALL_CYCLES` 是常数）；
  ② 任务书 §3 自己记的"模型对实现乐观 ~5%"。
* [重点] **别拿 6.0% 做 go/no-go。** P3 的判据仍是任务书 §6 的
  **"cycles 显著下降且四 CRC 不变"**。

---

## 6. [重点] 下个会话起手：P2

```powershell
cd D:\riscv-cpu-fpga_merged ; git log --oneline -6 ; git status    # 分支 dualissue
# 【第一件事】读 doc\reports\2026-10-15_laneb_mem_plan.md 的 §4（改动清单 A~L）+ §6（P2 判据）
```

**P2 = 把 §4 的 A~L 全部落地，但 `LANEB_MEM=0`。判据：四条基线逐位不变。**

用**本会话 §2 的实测值**当对照（不是文档的旧值）：
`229,597 / 249,982 / 300,392 / 233,013` + 四 CRC `e9f5/e714/1fd7/8e3a`。

三条会咬人的（任务书 §7 自己列的，我复核后确认都成立）：
* **R1** 四个 `fwd_*_exb` 没排除 `wb_sel==01` ⇒ lane B 的 load 会把**地址**当前递值
* **R2** `ld_bad_base` 只查 `id_ex`/`id_ex_b`/`ex_mem`，**漏了 `ex_mem_b`**
* **R4** 四处级间寄存器的**清/保持/锁存**每个分支都要加新字段，漏一处就是静默错
* 另：**不加 `!ex_flush` 给 lane B 的 read**，靠 `ex_mem_b_valid` 门控 `b_mem_sel`
  —— 这一点**必须写进注释**（否则后人会当冗余清掉，任务书 R6）

**P2 之后先量时序再翻开关**（任务书 §9 的闸门），但注意本会话 §3 已把余量从
**+0.034 抬到 +0.330 ns** ⇒ **闸门比任务书写的宽**。且按新公式，**时序只影响指标(2)**，
不影响主分 ⇒ 这个闸门已从"作废闸门"降级为"看掉多少、值不值"。

---

## 7. 仍未验证 / 悬着的

* ~~**`55fae69e` 板上待验**~~ → **[OK] 已上板（2026-10-15 23:41）：370.31 CoreMark**，
  四 CRC `e9f5/e714/1fd7/8e3a` 与仿真逐位一致、拍/迭代 229,550.5（仿真 229,597，−0.0203%），
  日志 `doc/board/uart_20261015_234123.txt`。
  **⇒ 口径分裂消除**：跑分档 `55fae69e` 与演示档 `1e2075e6` 现在是**同 RTL、同 DESIGN_REV(1023)**，
  且两颗都板上验证过。板上最好成绩 `f64b977`(rev1022) 的 370.23 升为 **`55fae69e` 的 370.31**
  （+0.02% 是抖动，仿真周期数逐位相同，不是性能变化）。
* ~~**`176e0028`（RT-Thread 五子棋演示档）仍没上过板**~~ → **[OK] 已闭环（2026-10-15 23:34）**。
  但**验的不是它**：`176e0028` 是 **rev1022、A 扩展还在**的 RTL，而跑分档已到 `55fae69e`
  （rev1023 / `A_EXT=0`）⇒ 直接验它等于**验一颗不交付的位流**（rev1017→rev1019 踩过的坑）。
  故按新 RTL 重出了 **`1e2075e6`**（rev1023）再验，**四条判据全过 + 用户接 HDMI 下棋正常 +
  `D18` 常亮**（日志 `doc/board/uart_20261015_233418.txt`）。**`176e0028` 自此作废。**
  同一份日志里的 `[!] vblank timeout` 就此**定案为假超时**（D18 亮 + 画面正常 ⇒ 不是显示坏了，
  是 1 ms 采样看 62.7 µs 脉冲的粒度问题）。
* **`tb_rvc` 的处置未决**（修 10 个位域 / 连 `rvc_expand.v` 一起删）。
* **RT-Thread 的 `vblank timeout`**、**录像/照片**（赛题"应用场景演示"至今无视觉证据）。
* **未 push**：本会话所有提交都在本地（按项目纪律不自动 push）。
