1979711854/riscv-cpu-fpga/doc/reports/2026-10-15_laneb_mem_p0_baseline.md

# P0 记录：四条基线在当前 RTL 上的复现（2026-10-15）

> 承接 `2026-10-15_laneb_mem_plan.md` §6 的 **P0**。
> **结论：P0 判据按字面【不通过】—— 但偏差已完全归因，是文档陈旧而非 RTL 有问题。
> 本文给出的四个数就是后续 P2/P3 应当对照的口径。**

---

## 1. 一句话

`252,730` / `303,140` / `235,628` 三条**都是 B1-RAS 之前的陈旧口径**（计划书 §6 把它们当成
当前值抄了进去）；当前 RTL 实测为 **229,597 / 249,982 / 300,392 / 233,013**。
四条配置的四个 CRC **逐位一致**且与历史记录（2026-10-12）**逐位相同**。

---

## 2. 实测（当前 `dualissue` HEAD = `7d05aae`，ITER=1）

```powershell
cd D:\riscv-cpu-fpga_merged
scripts\run_coremark.ps1 -Iter 1 -SkipSim                      # 固件只编一次
scripts\run_coremark.ps1 -Iter 1 -SkipBuild -EarlyLd                        # ① 默认/板上口径
scripts\run_coremark.ps1 -Iter 1 -SkipBuild                                 # ② 双发射 EARLY_LD=0
scripts\run_coremark.ps1 -Iter 1 -SkipBuild -Single                         # ③ 单发射（无 EARLY_LD）
scripts\run_coremark.ps1 -Iter 1 -SkipBuild -DCache -ICache -EarlyLd        # ④ 带 Cache
```

| # | 配置（`SIM CONFIG` 自证行） | 文档值 | **实测** | 差 |
|---|---|---|---|---|
| ① | `DUAL=1 DCACHE=0 ICACHE=0 EARLY_LD=1 BTB=1` | 229,597 | **229,597** | **0** [OK] |
| ② | `DUAL=1 DCACHE=0 ICACHE=0 EARLY_LD=0 BTB=1` | 252,730 | **249,982** | **−2,748** |
| ③ | `DUAL=0 DCACHE=0 ICACHE=0 EARLY_LD=0 BTB=1` | 303,140 | **300,392** | **−2,748** |
| ④ | `DUAL=1 DCACHE=1 ICACHE=1 EARLY_LD=1 BTB=1` | 235,628 | **233,013** | **−2,615** |

测试台总周期（含约 130 万拍一次性串口打印开销，**不是**判据）：
1,539,287 / 1,560,649 / 1,615,317 / 1,544,346。
全部打印 `Errors detected` —— 那是 ITER=1 触发的 **10 秒有效性检查**（`HAS_FLOAT=0` 的已知行为），
**不是**算错。真判据是 CRC。

## 3. 四 CRC（**四条配置完全一致**）

| 项 | 值 |
|---|---|
| `seedcrc` | **`0xe9f5`** |
| `crclist` | **`0xe714`** |
| `crcmatrix` | **`0x1fd7`** |
| `crcstate` | **`0x8e3a`** |

> `crcfinal` 一律不记（跨迭代累加器，必随 ITER 变）—— 约定 29。
> [OK] 这四个值与 `10edfd0`（2026-10-13 带 Cache 版 A1 结果）里记的
> `e9f5/e714/1fd7/8e3a` **逐位相同** ⇒ 固件、编译器、判据口径没漂移。

---

## 4. 差异归因（已定量闭合，不是"大概齐"）

### ②③ 的 −2,748 = **B1-RAS 的收益，逐位精确**

`23ff4b3` 的提交信息原文：**「region cycles 232,345 → 229,597（−2,748 / −1.18%）」**。
② 与 ③ 是两条**互相独立**的配置，却**各自**恰好差 2,748 —— 与文档记载的 RAS 收益
**一位不差**。而 ① 就是 post-RAS 的值、实测分毫不差。
⇒ ②③ 的文档值与实测值之间**只隔一个 B1-RAS**（2026-10-14）。

### ④ 的 −2,615：同因，量不同（**不要当成异常**）

④ 的文档值 `235,628` 是 **A1 之后**（`10edfd0`："A1 前 244,849 → A1 后 235,628"）、
**RAS 之前**的。所以它的差 = RAS 在**带 I-Cache 配置下**的收益 = 2,615
（比无 Cache 配置的 2,748 少 133 拍，I-Cache 改变了 RAS 所在取指路径的行为）。
**量级与方向都对，只是不必逐位相同。**

### 为什么文档会陈旧 —— 文档自己警告过

`CLAUDE.md:138` 原文：
> 其他配置：`EARLY_LD=0` → 252,730；单发射 → 303,140；I+D Cache（76.5 MHz）→ 235,628
> **（后三个均未含 RAS，未重测）**。

**计划书 §6 的 P0 判据把这四条（含被标注为陈旧的后三条）照抄成了"当前基线"。**
本 P0 就是来抓这个的。

---

## 5. [!] 另一个发现：**单发射行的 `EARLY_LD` 口径是歧义的**

`CLAUDE.md:297` 写「单发射（回退版口径）| **上面加 `-Single`**」，"上面"是默认行（**含**
`-EarlyLd`）⇒ 按字面应是 `-Single -EarlyLd`。但实测：

| 单发射口径 | 实测 |
|---|---|
| `-Single`（无 `-EarlyLd`） | **300,392** ← **+2,748 = 303,140**，对得上文档 |
| `-Single -EarlyLd` | **287,056** ← 文档里**没有这个数** |

⇒ **文档记的 `303,140` 是"单发射 + `EARLY_LD=0`"**，那句"上面加 `-Single`"的措辞是错的
（`EARLY_LD` 在单发射下同样有效，省 13,336 拍，不是无效开关）。

**给 P1~P5 的口径**：文档"单发射"那一行一律按 **`-Single` 不带 `-EarlyLd`** 理解；
`287,056`（`-Single -EarlyLd`）是**文档外的新配置**，不作为判据，但别误当成"单发射基线"。

---

## 6. 对计划书的影响

| 计划书位置 | 原文 | 应改成 |
|---|---|---|
| §6 P0 判据 | 229,597 / 252,730 / 303,140 / 235,628 全对上 | **判据本身不成立**（后三个是 pre-RAS 值）。见 §2 表 |
| §5 | 那两条"必然会变" | **仍然成立**，且**现在就已经变了**（RAS），P2/P3 的对照基线要用 §2 的实测值 |
| §6 P2 判据 | 四条基线逐位不变 | 照 **§2 实测值** 逐位不变：229,597 / 249,982 / 300,392 / 233,013 |
| §6 P3 判据 | 4 CRC 逐位一致 | **§3 的四个值**，四条配置同源 |

**计划书的方法论没有被推翻**：P0 的作用就是"先把对照口径钉死"，它成功完成了
（只是钉出来的是四个新数，而不是抄来的四个旧数）。§1 的配对收益模型、§9 的时序闸门
都还没有被触及。

---

## 7. [!] 顺手复核出的第二个问题：**P4 的时序闸门用的是"方案 B"的数**

计划书 §6 的 P4 判据写「Fmax ≥ **79.1 MHz**（break-even）」，§9 又写「若综合后 WNS < 0
或 Fmax < **79.1 MHz**，本方案作废」。**79.1 MHz 是方案 B（不限同拍访存）的盈亏平衡点，
不是方案 A 的。** 复算（`f=85.0051 MHz`、`c=229,597`）：

| 方案 | k | 周期 | **盈亏平衡 Fmax** |
|---|---|---|---|
| **A（只放 load，本方案）** | 7,866 | −3.43% | **82.09 MHz** |
| A'（load+store，同约束） | 8,399 | −3.66% | 81.90 MHz |
| B（load+store，不限） | 15,942 | −6.94% | **79.10 MHz** ← 计划书抄的这个 |

⇒ **按计划书原样执行，会放行一个"周期省了、但频率掉得更多"的净亏设计。**
**P4 的闸门必须收紧到 ≥ 82.1 MHz**（含 §6 提到的 ~5% 模型乐观度折扣则约 **82.5 MHz**）。

### 但这两个数不都是坏消息 —— 真实的时间预算是 **+0.45 ns**，不是 0

"CPU 域余量只有 +0.034 ns"很容易被读成"再加一级 LUT 就必死"。换算成绝对值：

```
请求周期 11.7640 ns（85.0051 MHz） − slack 0.034 ns = 可达 11.7300 ns（85.2515 MHz）
方案 A 盈亏平衡周期 = 1000 ÷ 82.09 MHz = 12.1818 ns
⇒ 允许新增的路径延迟 = 12.1818 − 11.7300 = +0.451 ns
```

**+0.45 ns 不是零预算。** §9 说新条件只加"一级 LUT"，而关键路径的构成是
逻辑 ≈4.5 ns / 走线 ≈6.7 ns —— 单看逻辑，一级 LUT 占不到 +0.45 ns。**真正的风险不是
逻辑深度，而是新增逻辑会把网表布局搅动、让那条 route 占 60% 的链变长**（这正是
2026-10-15 的 PCE 区域约束实验想解决而未果的问题）。
⇒ **§9 的闸门在方案 A 下是"可能过、但确实悬"，不是"先验必死"。值得做 P1+P2。**

---

## 8. 本阶段**没做**的事（别当成已完成）

* **riscv-tests 的四条配置回归没跑**（文档各标 49/1/0）。P0 的字面判据只点名了 CoreMark
  周期数，故本轮未跑。建议把它并进 **P2** 的"逐位不变"检查里一起做，那里本来就要跑。
* **`pair_analyze.py` 未动**（那是 P1）。
* **RTL 一行未改**（符合计划书"P2 之前不动行为"的分工）。
