1979711854/riscv-cpu-fpga/doc/reports/2026-10-14_taskbook_v11_cpu.md

# RISC-V CPU 优化任务书 v11（2026-10-14 立）

> 接 **v10**（`doc/reports/2026-10-13_taskbook_v10_cpu.md`）。
> **本文只写"v10 之后发生了什么 + 你的任务表怎么变"**；每条任务的详细设计、接法、坑
> **仍在 v10 里**（B1-RAS 见 v10 §5、BTB 见 §6、目标校验见 §7、代码勘察见 §8）——**别丢 v10**。
>
> 一句话：**v10 的 P0 缺陷（Cache 挂死）已经修完并上板验证了，不占你的时间**；
> 你的任务表回到 覆盖 A/B → RAS → BTB，但**多了一条必须遵守的回归义务**（见 §4）。

---

## 0. 三十秒版
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
