1979711854/riscv-cpu-fpga/doc/board/baseline_human.bmp

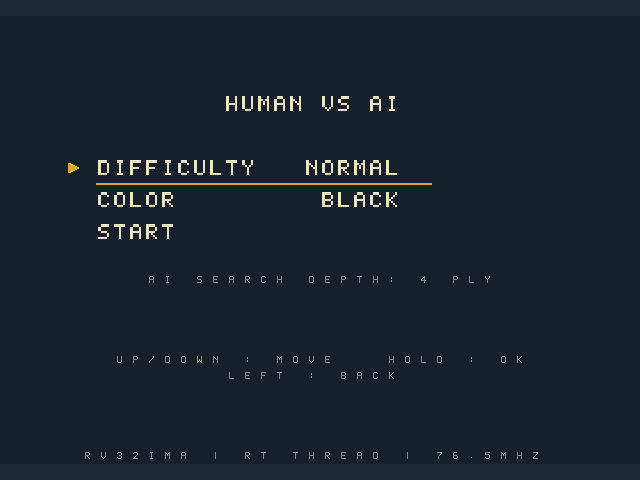
doc/board/baseline_human.bmp
