1979711854/riscv-cpu-fpga/doc/board/baseline_over.bmp

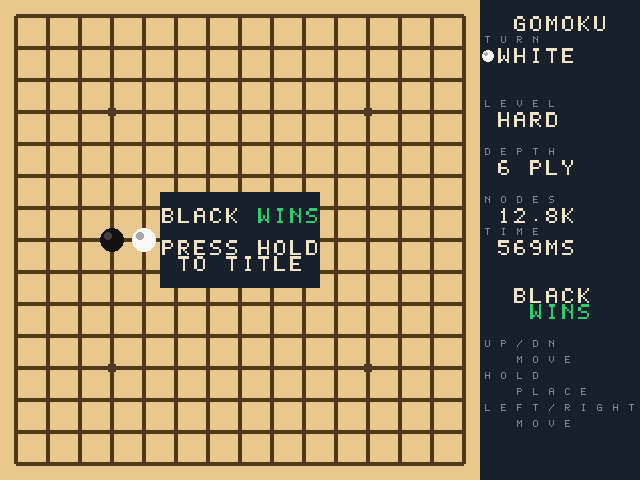
doc/board/baseline_over.bmp
