1979711854/riscv-cpu-fpga/doc/board/baseline_submenu.bmp

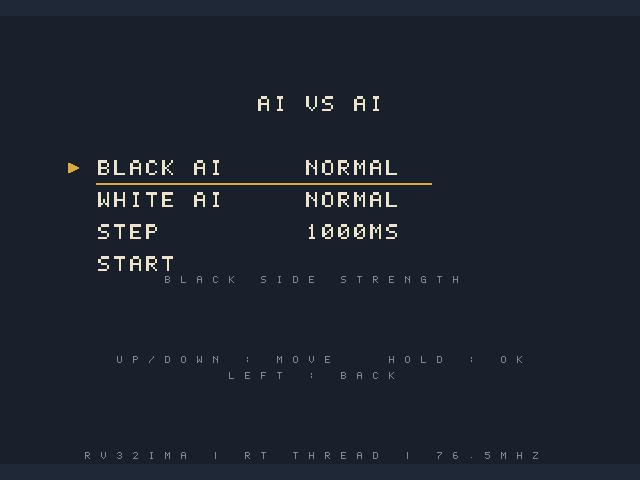
doc/board/baseline_submenu.bmp
