1979711854/riscv-cpu-fpga/doc/board/baseline_title.bmp

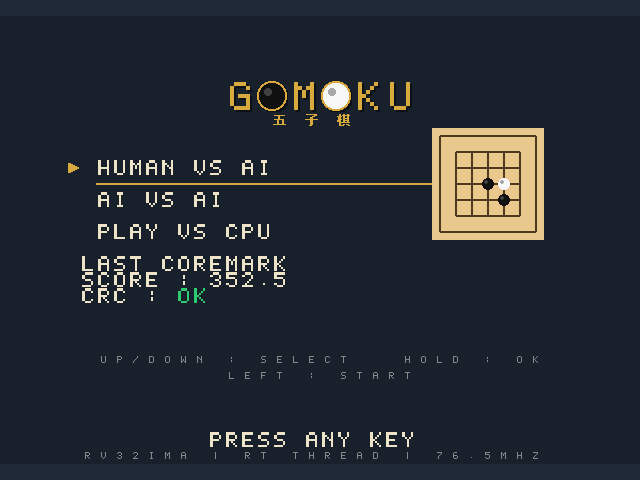
doc/board/baseline_title.bmp
