1979711854/riscv-cpu-fpga/doc/board/preview_cm_report.bmp

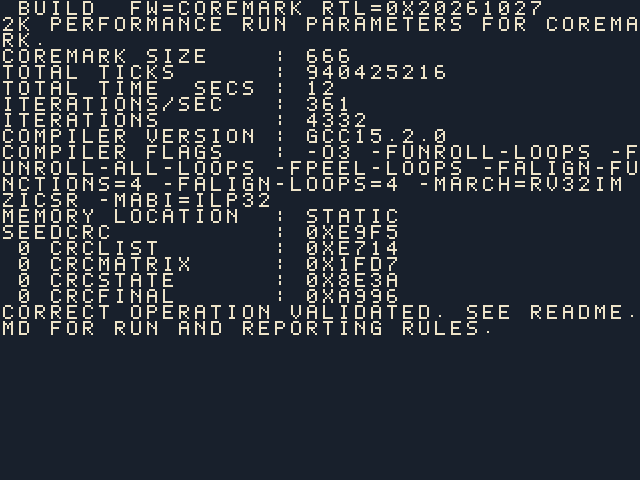
doc/board/preview_cm_report.bmp
