1979711854/riscv-cpu-fpga/doc/board/preview_human.bmp

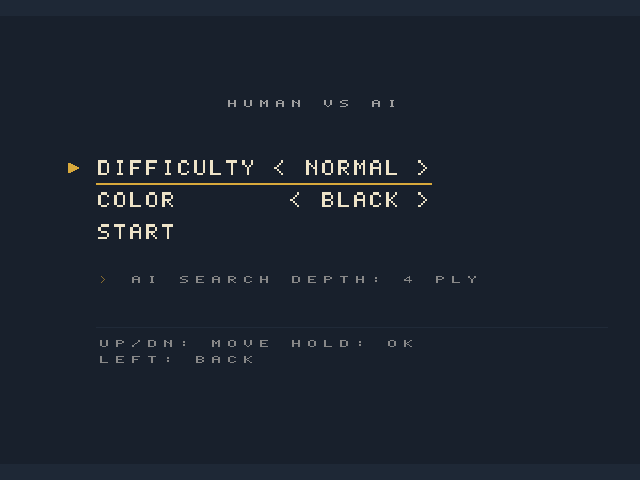
doc/board/preview_human.bmp
