1979711854/riscv-cpu-fpga/doc/board/preview_over.bmp

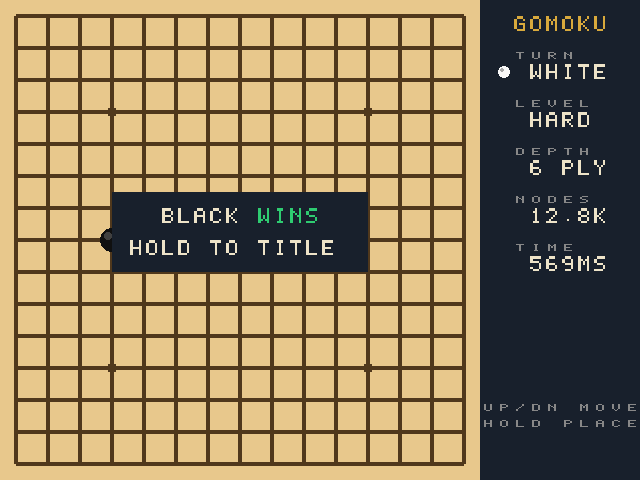
doc/board/preview_over.bmp
