1979711854/riscv-cpu-fpga/doc/board/preview_submenu.bmp

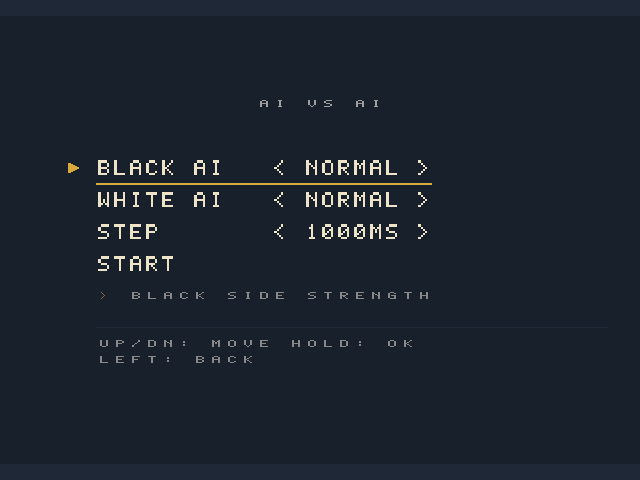
doc/board/preview_submenu.bmp
