1979711854/riscv-cpu-fpga/doc/board/preview_submenu_ai.bmp

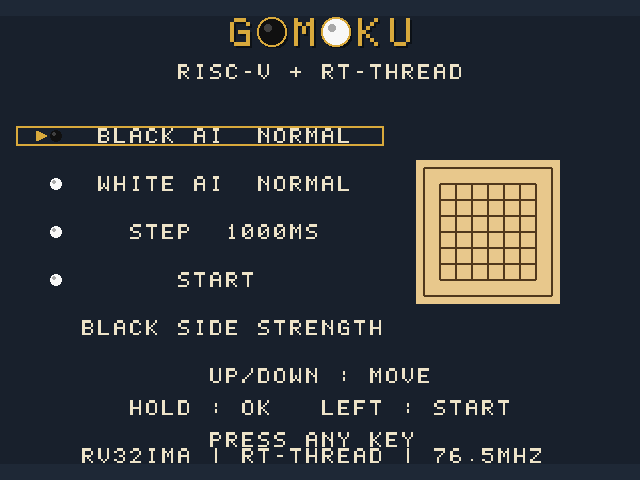
doc/board/preview_submenu_ai.bmp
