1979711854/riscv-cpu-fpga/doc/board/preview_t6r4_human.bmp

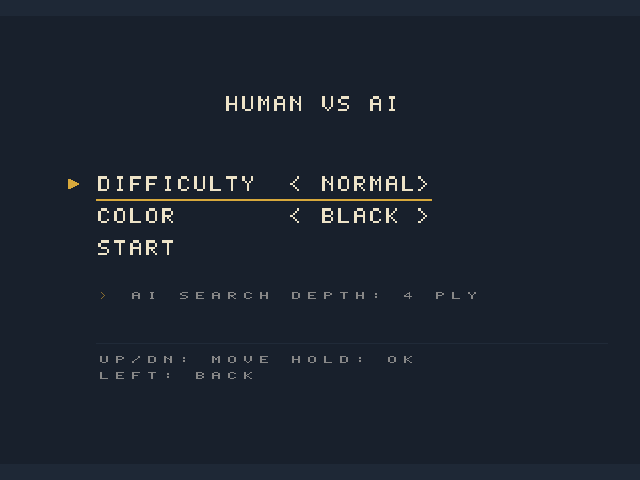
doc/board/preview_t6r4_human.bmp
