1979711854/riscv-cpu-fpga/doc/board/preview_title.bmp

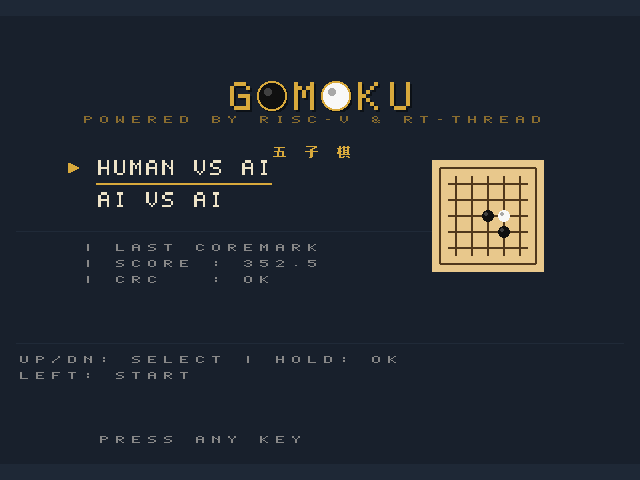
doc/board/preview_title.bmp
