1979711854/riscv-cpu-fpga/doc/board/v3_check_submenu.bmp

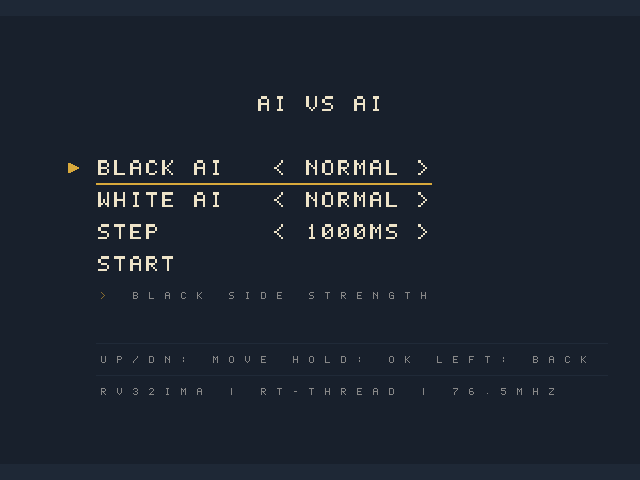
doc/board/v3_check_submenu.bmp
