1979711854/riscv-cpu-fpga/doc/figures/pipeline_matrix_loop.png

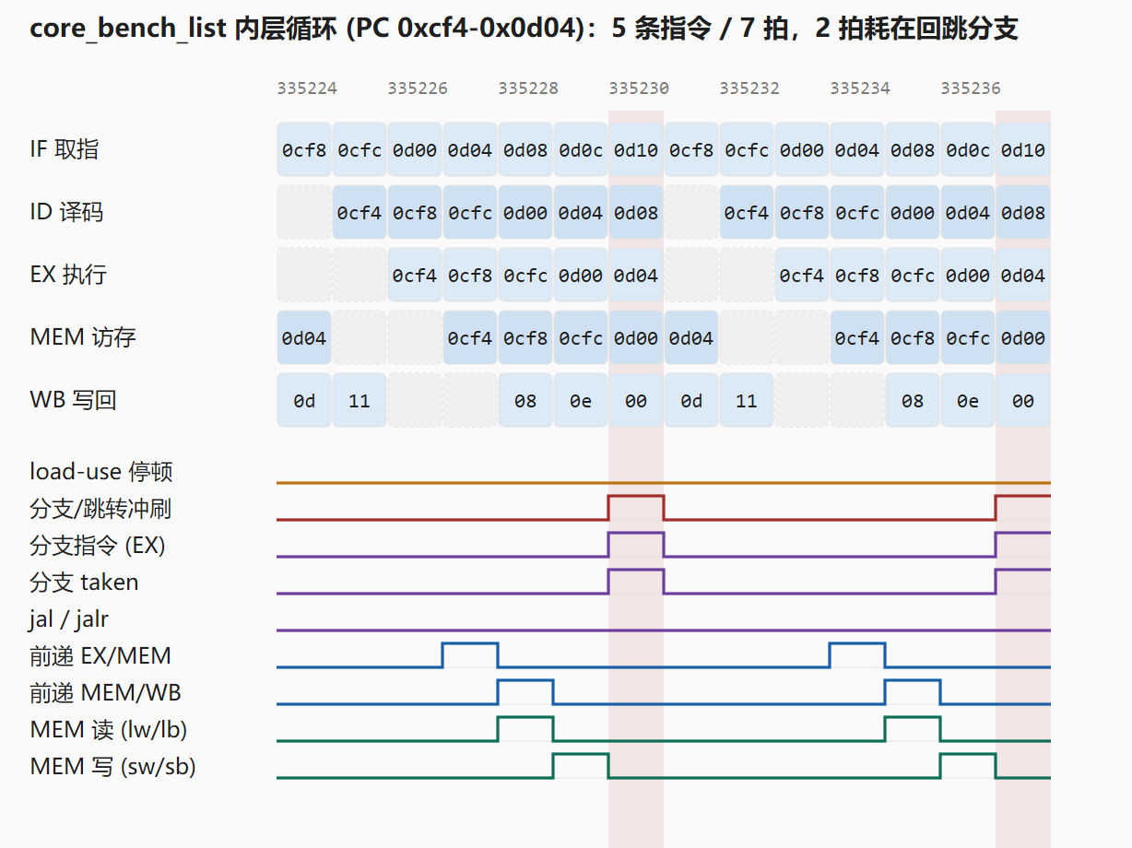
doc/figures/pipeline_matrix_loop.png
