1979711854/riscv-cpu-fpga/doc/contest/技术文档_v1_待补清单.md

# 技术文档_v1 待补清单

> 对应文档：`doc/contest/技术文档_v1.docx`
> 分两类：**A 类 = 缺素材（必须补拍/补图）**；**B 类 = 改了固件后的联动更新**。
> 文档正文里凡未补齐处均已标【待补】，不会用假图或假数据占位。

## A 类：缺素材（正文已留【待补】标记）

| 编号 | 文档位置 | 需要什么 | 建议规格 | 现状 |
|---|---|---|---|---|
| A1 | 图 4（§3.1） | 系统实物**正面**全局照 | ≥3000×2000，白底或素色桌面，显示器亮屏（标题屏） | 仓库内 0 张实物照片 |
| A2 | 图 5（§3.1） | 系统实物**斜 45°** 全局照 | 同上角度，能同时看到开发板、HDMI 线、显示器 | 同上 |
| A3 | 图 6（§3.2.2） | 电路成果照：开发板 + 外围连接（HDMI、USB-UART、按键位号可见） | 局部特写，能看清 PG2L200H 主器件与接口 | 同上 |
| A4（可选） | §3.3 | 仪器测试照：频率计/示波器测 76.5052 MHz 或 HDMI 眼图 | 若答辩现场要求"仪器佐证"再补；否则时序以 PDS 报告为准 | 缺 |
| A5（可选） | §3.2.3 | 现场演示照（按键操作 + 屏幕 PASS） | 答辩现场补拍 | 缺 |

> 拍照建议：同一机位拍一组（正面 / 45° / 局部），统一背景与光线；插入文档时宽度建议 12–14 cm，图注沿用"图 x 系统实物……"格式。

## B 类：固件改动后的联动更新（重要）

### B1 已改的代码

`scripts/gomoku/coremark_screen.c`：监控区堆余量由"KB 取整"改为**字节制**

- 旧：`HEAP FREE : 0.0K`（本系统堆仅 1,440 B，取整后恒为 0.0K，容易被误读成假数据/分配失败）
- 新：`HEAP FREE : <剩余>/<总量>B`，例如 `1240/1440B`
  - 剩余字节用 GREEN8（8×8 亮绿）绘制
  - `/1440B` 用通用 8×8 灰字补（GREEN8 子集只有 `0-9 . K S E C`，不含 `/` 与 `B`）
  - `cm_mon_heap_free()` 增加 `total_out` 出参，值仍全部来自 `rt_memory_info()`
- 编译验证：`scripts\gomoku\preview.ps1 -Scene title` 已通过（x86 gcc 15.2.0）

> 注意：主机预览走裸机分支（无 RT-Thread 堆），**无法**渲染出真实堆值，新截图必须来自板上（或 RT 固件的仿真）。

### B2 重出位流的步骤（会改变位流 md5）

```powershell
# 1) 重新编译 RT 固件并出 mem.hex
scripts\rtthread\build.ps1 -Firmware

# 2) 重出 combined 位流（boot + CoreMark + RT-Thread，约 15 分钟）
scripts\build_bitstream.ps1 combined

# 3) 上板复验三条路径（默认五子棋 / 按住 SW6 跑分 / SW6+SW7 终端屏）
#    判据：串口 [boot] heap = 1440 bytes、CoreMark 四 CRC、监控屏字节制堆值
```

| 影响项 | 说明 |
|---|---|
| 位流 md5 | 由 `6E2D6020…` 变为新值，需同步 `pds/RV32I_1/bitstreams/README.md` 的 T7 行 |
| mem.hex 字数 | boot 30 字不变，RT 段可能 ±数十字（改的是打印逻辑），表 4 的 12,741 字需按实际改 |
| 文档侧引用 | `技术文档_v1.docx` §2.3.1 表 4、§3.3 第 4 条、图 7/8 图注、`技术文档_v1_数据来源.md` §2.2 |
| 数据卡 | `doc/reports/2026-10-19_t7_coremark_demo_handoff.md` 需追加一行"T7-R6：堆显示改字节制" |

### B3 截图替换

| 编号 | 文件 | 说明 |
|---|---|---|
| B3-1 | `doc/board/preview_t7_cm_running.png` | 重出位流后重新取像（运行中） |
| B3-2 | `doc/board/preview_t7_cm_pass.png` | 重出位流后重新取像（PASS） |
| B3-3 | 文档中两处【待补：……字节制堆显示……】灰字 | 换图后删除 |

### B4 换图后重新生成文档

```powershell
python doc/contest/tools/build_doc.py     # 重建 docx（会重新统计字数）
powershell -File doc/contest/tools/export_pdf.ps1   # 导 PDF 看分页
python doc/contest/tools/verify_doc.py    # 口径自检
```

## C 类：交付前需要人工确认的点

1. **页码与页眉**：模板 first/even 页眉为空，本次已删除这两类引用，全篇统一使用带 logo 的默认页眉；确认打印时 logo 与页码连续。
2. **表 2 跨页**：已设置整表不跨页（cantSplit + keepNext），若最终排版改动导致大块留白，可放宽为允许跨页并重复表头。
3. **图 1 来源**：由 `doc/figures/fig1_soc_overview.svg` 改写（时钟域 76.5052 MHz、DESIGN_REV 1028、修正 `rtl/bus` 笔误并删除"见第 3 章"的旧章节引用）；如需完全重画，替换 `doc/contest/figs/fig1_soc.png` 即可。
4. **作品名称**：`RV32IMA 顺序双发射 SoC：一颗位流三路径的 FPGA 实现`（用户确认稿）；如需改字，只需改 `build_doc.py` 的 `TITLE` 常量。
5. **参考文献**：16 篇，未含具体 DOI/页码的条目已按标准格式给出可核查信息；提交前按赛事要求核对是否需要补齐出版地/页码。
