1979711854/riscv-cpu-fpga/doc/User_Constraint_Editor_User_Guide_文本提取.txt

===PAGE 1===
UserConstraintEditor
用户手册
(Version1.7)
深圳市紫光同创电子有限公司
版权所有 侵权必究
===PAGE 2===
1/126
文档版本修订记录
版本号 发布日期 修订记录
V1.0 2022.7.12 初始版本
V1.1 2022.8.5 增加properties窗口功能描述
V1.2 2022.8.5 增加查看Schematic 功能描述
V1.3 2022.8.19 增加selectleafcells 功能描述
V1.4 2022.8.19 增加showconnectivity功能描述
V1.5 2022.8.19 增加Bundlenets 功能描述
V1.6 2022.8.19 增加Selection窗口功能描述
V1.7 2022.10.26 增加Region资源过滤功能描述
===PAGE 3===
2/126
目录
UCE界面功能介绍............................................................................................................................. 9
1.1 启动UCE................................................................................................................................ 9
1.2不同类型工程的UCE...........................................................................................................10
1.3UCE 主界面功能...................................................................................................................11
1.3.1 右键菜单....................................................................................................................... 12
1.3.2 UCE 的搜索工具.............................................................................................................13
1.3.3 UCE 的按钮.....................................................................................................................15
1.3.4 Timing Constraints界面................................................................................................. 16
1.3.5 Attribute 表格.................................................................................................................37
1.3.6 Compile Points界面....................................................................................................... 41
1.3.7 Device 界面.................................................................................................................... 42
1.3.8 Schematic界面...............................................................................................................62
1.3.9 Hierarchy界面................................................................................................................63
1.3.10 Selection 界面.............................................................................................................. 63
1.3.11 Properties 界面............................................................................................................ 64
1.4 解析差异造成的FDC 修改................................................................................................. 66
2.UCE 约束命令介绍........................................................................................................................ 68
2.1 对象描述规则....................................................................................................................... 68
2.2 时序约束...............................................................................................................................72
2.2.1 Clocks命令..................................................................................................................... 72
2.2.2 Inputs/outputs命令....................................................................................................... 79
2.2.3 Assertio 命令.................................................................................................................. 81
2.2.4 Exception命令............................................................................................................... 82
2.2.5 Other 约束命令..............................................................................................................87
2.3 逻辑约束...............................................................................................................................88
2.3.1 define_attribute命令.....................................................................................................88
2.3.2 define_global_attribute 命令.........................................................................................89
2.3.3 define_compile_points命令.......................................................................................... 90
2.3.4 UCE 中属性的设置.........................................................................................................90
===PAGE 4===
3/126
2.3.5 Device 中的 I\O Table 相关配置....................................................................................98
2.3.6 IP FDC 支持指定子 module......................................................................................... 103
2.3.7 Fdc 约束文件逻辑约束支持通配符............................................................................103
2.3.8 UCE 属性使用实例.......................................................................................................103
2.4 查询命令.............................................................................................................................105
2.4.1 get_cells........................................................................................................................ 105
2.4.2 get_nets........................................................................................................................ 106
2.4.3 get_pins........................................................................................................................ 106
2.4.4 get_clocks..................................................................................................................... 107
2.4.5 get_ports.......................................................................................................................107
2.5 常见约束错误.....................................................................................................................107
2.6 通用IO 属性默认值...........................................................................................................108
2.6.1 Compact(PGC2KG)........................................................................................................ 108
2.6.2 Logos(PGL50H)..............................................................................................................109
2.6.3 Logos2(PG2L100H)........................................................................................................112
2.6.4 Titan(PGT180H).............................................................................................................115
2.6.5 Titan2(PG2T390H).........................................................................................................117
===PAGE 5===
4/126
图目录
图 1-1 UCE 主界面...........................................................................................9
图1-2 工具栏UserConstraintEditor(TimingandLogic)图标..........................9
图1-3 Tools下的UserConstraintEditor(TimingandLogic).........................10
图1-4 UCE 全量配置界面..............................................................................12
图1-5 UCE 右键菜单......................................................................................13
图 1-6 IOtable右键........................................................................................13
图1-7 UCE 的search 工具..............................................................................13
图1-8 UCE 的网表搜索工具..........................................................................14
图1-9 PreSynthesizeUCE 的按钮.................................................................15
图1-10 DesignBrowser 的结构......................................................................15
图1-11 TimingConstraints 表格.....................................................................16
图1-12 CreateClock示例...............................................................................17
图1-13 CreateClock窗口...............................................................................18
图1-14 CeateClock 表格................................................................................18
图1-15 CreateGeneratedClock 示例..............................................................19
图1-16 CeateGeneratedClock 窗口...............................................................19
图1-17 CreateGeneratedClock 表格..............................................................20
图1-18 CreateGeneratedClock 参数.............................................................20
图1-19 SetClockLatency 窗口......................................................................22
图1-20 SetClockLatency 表格......................................................................22
图1-21 SetClockUncertainty 窗口................................................................23
图1-22 SetClockUncertainty 表格.................................................................23
图1-23 SetClockGroups 示例........................................................................24
图1-24 SetClockGroups 窗口........................................................................25
图1-25 SetClockGroups 表格........................................................................25
图1-26 set_external_delay 窗口......................................................................26
图1-27 set_external_delay 表格......................................................................26
图1-28 SetInputDelay 示例..........................................................................27
===PAGE 6===
5/126
图1-29 SetInputDelay 窗口..........................................................................28
图1-30 SetInputDelay 表格..........................................................................28
图1-31 SetMaxSkew 窗口............................................................................29
图1-32 SetMaxSkew表格.............................................................................30
图1-33 SetMaxDelay 窗口...........................................................................31
图1-34 SetMaxDelay 表格............................................................................31
图1-35 SetMinDelay 窗口............................................................................32
图1-36 SetMinDelay 表格.............................................................................32
图1-37 SetMulticyclePath 窗口....................................................................33
图1-38 SetMulticyclePath 表格....................................................................34
图1-39 SetFalsePath 窗口.............................................................................35
图1-40 SetFalsePath 表格.............................................................................35
图1-41 Set_disable_timing 窗口.....................................................................36
图1-42 set_disable_timing表格......................................................................36
图1-43 Attribute表格......................................................................................37
图 1-44 AttributesTable窗口..........................................................................37
图 1-45 SpecifyObject 窗口...........................................................................38
图 1-46 Attributestable中的attribute行.......................................................39
图 1-47 Attributestable中的Value行...........................................................39
图 1-48 Attributestable中的commond 栏.....................................................39
图 1-49 保存的逻辑约束................................................................................40
图 1-50 新增空白行........................................................................................40
图1-51 Attribute表格的Object 列.................................................................40
图1-52 Attribute表格的Attribute列.............................................................41
图1-53 Attribute表格的value相关列...........................................................41
图1-54 CompilePoints表格...........................................................................42
图1-55 Device 界面.........................................................................................42
图1-56 Device 界面工具栏.............................................................................43
图1-57 DeviceBroswer界面Design 窗口.....................................................44
===PAGE 7===
6/126
图 1-58 EditColor功能..................................................................................45
图1-59 IOTable表格......................................................................................45
图1-60 搜索框...................................................................................................46
图1-61 Device 查看实例.................................................................................46
图1-62 IO 约束................................................................................................47
图1-63 区域约束...............................................................................................49
图 1-64 新建region.........................................................................................49
图1-65 区域约束资源弹窗...............................................................................50
图1-66 区域约束取消勾选结果.......................................................................51
图 1-67 查看实例区域约束............................................................................52
图 1-68 region 中General 栏属性..................................................................52
图 1-69 region 中Statistics 栏属性................................................................53
图 1-70 region 中Instances 栏属性................................................................53
图1-71 preserve约束.......................................................................................54
图1-72 exclusiveregion 约束..........................................................................54
图1-73 clockregion 显示................................................................................55
图 1-74 选中对象............................................................................................56
图 1-75 第一次showconnectivity..................................................................56
图 1-76 扇出效果............................................................................................56
图 1-77 showcellconnections 窗口................................................................56
图 1-78 bundlenets 显示.................................................................................57
图 1-79 bundlenet 选中..................................................................................57
图 1-80 bundlenet 设置..................................................................................57
图 1-81 SelectLeafCells.................................................................................58
图 1-82 HighLightSelection...........................................................................59
图 1-83 ShowHighlightList...........................................................................59
图 1-84 选中device 右键..................................................................................60
图 1-85 mark 效果...........................................................................................60
图 1-86 markbrowser......................................................................................61
===PAGE 8===
7/126
图 1-87 mark 浏览器界面...............................................................................61
图 1-88 Select 功能..........................................................................................62
图 1-89 schametic窗口...................................................................................62
图 1-90 Schematic选项..................................................................................62
图 1-91 ShowHierarchy..................................................................................63
图 1-92 Hierchay 界面....................................................................................63
图 1-93 selection 按钮.....................................................................................64
图 1-94 selection 窗口显示.............................................................................64
图 1-95 Selection 窗口右键功能....................................................................64
图 1-96 Properties 按钮...................................................................................65
图 1-97 Properties 界面显示...........................................................................65
图 2-1 Attribute表格.......................................................................................88
图 2-2 I\OTable表格......................................................................................98
图 2-3 具体操作............................................................................................101
===PAGE 9===
8/126
表目录
表 1-1 Properties 属性显示.............................................................................66
表 2-1 属性......................................................................................................99
表 2-2 PAP_IO_PREEMP、PAP_IO_OUTPUT_IMPEDANCE 作用........101
表 2-3 PGT180H 的IOB 驱动器P管/N管finger 数量的电流对应表.....103
表 2-4 Compact(PGC2KG)...........................................................................109
表 2-5 Logos(PGL50H).................................................................................112
表 2-6 Logos2(PG2L100H)...........................................................................115
表 2-7 Titan(PGT180H).................................................................................117
表 2-8 Titan2(PG2T390H)hrio.....................................................................120
表 2-9 Titan2(PG2T390H)hpio.....................................................................126
===PAGE 10===
1.UCE 界面功能介绍
9/126
1.UCE 界面功能介绍
该文档详细描述了UserConstraintEditor（以后简称UCE）的使用方法和各
项功能。UCE 能够对实例和IO 进行时序约束和逻辑约束。UCE 主界面，如下图
所示。
图 1-1UCE 主界面
1.1 启动UCE
打开软件，新建工程，SynthesisTool 选择ADS，选择添加add.v；或者不使
用综合工具，选择添加add.vm，然后在新建的工程里，可采用以下三种方式启
动UCE：
1、点击工具栏图标UserConstraintEditor(TimingandLogic)，如下图所示。
点击按钮后二级菜单会有两个选项：PreSynthesizeUCE(综合之前打开约束编辑
器)、PostSynthesizeUCE(综合之后打开约束编辑器)。根据选择进行打开。
图1-2 工具栏UserConstraintEditor(TimingandLogic)图标
===PAGE 11===
1.UCE 界面功能介绍
10/126
2、点击菜单栏“Tools”下的“UserConstraintEditor（TimingandLogic）”，如
图所示。
图1-3Tools 下的UserConstraintEditor(TimingandLogic)
3、当已经在工程中添加了fdc 约束文件时，文件会显示在 PDS 主界面的
“Navigator”窗口的“Sources”标签页下面的“Constraints”目录下面，双击fdc
约束文件，则可以以文本编辑器的方式打开约束文件。
目前该目录下，支持添加多个fdc 文件，均显示在Constraints目录下方。右
键功能SetAsTargetFile，targetfile将会保存UCE 中新增的约束，切换targetfile，
则切换保存新增约束的约束文件。未修改的约束，将保存在原约束文件中。保存
时，如果没有指定targetfile，则会弹窗提醒用户选择targetfile。
目前只支持初步简单的多约束文件，即多个约束文件的内容彼此之间独立
（如时序约束、IO 约束等等放在不同的约束文件中）。若多约束文件中的约束
信息有关联，有可能会造成先使用后定义的情况出现，导致约束检查报错或者约
束被覆盖没有生效等等。目前Constraints 层级下，多约束文件按照显示的顺序进
行读取，即顺序读取。若有约束文件中的约束是其他约束文件中约束信息的前置
条件，请将该约束文件显示顺序调至靠前。
1.2 不同类型工程的UCE
根据是否有综合工具，以及综合工具的类型，对应的UCE 及后续约束的流
程也有所不同，具体的区别如下：
1、综合工具为ADS 时：PreSynthesizeUCE 读写和编辑的是综合前的约束，
即读取和保存的约束文件为fdc（FPGADesignConstraint）文件。保存的fdc 约
束文件会在综合时使用。PostSynthesizeUCE 读写和编辑的是综合后的约束，即
读取和保存的约束文件为 lcf（Logical Constraint File）文件和 scf（Synthesis
ConstraintFile）文件。保存的lcf和scf 约束文件会在MAP 时使用。
===PAGE 12===
1.UCE 界面功能介绍
11/126
2、综合工具为OEM 时：PreSynthesizeUCE 读写和编辑的是综合前的约束，
即读取和保存的约束文件为fdc 文件。保存的fdc 约束文件会在综合时使用。综
合后OEM 会生成两个约束文件lcf 和scf，作为MAP 一步的输入文件。(目前不
支持综合工具为OEM 时，打开PostSynthesizeUCE)。
3、没有使用综合工具时：PostSynthesizeUCE 读写的约束文件为sdc（即
SynthesisDesignConstraint，里面包含timing 约束信息），和lcf（逻辑约束信息，
目前为attribute信息）；
1.3UCE 主界面功能
打开UCE(针对PreSynthesizeUCE和PostSynthesizeUCE，后续统称为UCE)
后，其主界面为一系列表格，这些表格分为不同的Tab项，这些表格分为Timing
约束和 Logical 约束两类，其中 Timing Constraints Tab 为 Timing 约束相关，
Attribute和Device 为Logical 约束相关，Logical 约束在约束文件里皆以attribute
命令的形式体现；CompilePoints 表格用来设置CompliePoints（OEM 场景特有）。
UCE 的输入文件为用户设计文件、约束文件和器件信息。打开UCE 时会经
过约束检查后将正确的约束内容显示在UCE 中。错误的约束将被过滤，不显示
在UCE 界面上。
在UCE 界面上进行修改删除等操作后，可以通过【saveconstraints】按钮保
存约束文件。
当前UCE 界面约束保存fdc处理规则：
（1）新增约束以增量形式添加到fdc文件中。
（2）修改约束在原有行的基础上修改约束命令。
（3）删除约束将客户约束直接注释掉。
（4）原有约束文件中的注释需要保留。
在PDS主界面中Edit下拉选项的Preferences中，可以在UserConstraintEditor
选项中设置进入PreSynthesizeUCE（综合工具为OEM）时,是全量解析网表还
是只解析顶层端口，配置界面如下：
Generatealldesignnetlistobjects：全量解析，解析整个网表，检查网表中所
有约束的合法性；
===PAGE 13===
1.UCE 界面功能介绍
12/126
Generatedesignportsonly：非全量解析，只解析顶层网表中的端口。由于没
有解析网表，无法根据端口的类型来进行检查，只根据端口的方向和电平标准文
件进行检查。
图1-4UCE 全量配置界面
1.3.1 右键菜单
在UCEattribute界面右键会弹出来一个菜单框，如下图所示，菜单内容分别
有：InsertRow、RemoveRow、ClearConstraint、ClearAllConstraint，对应的是
操作UCE 表格的方法。

===PAGE 14===
1.UCE 界面功能介绍
13/126
图1-5UCE 右键菜单
【InsertRow】：在该表中插入一个空白行；
【RemoveRow】：删除光标所在的行；
【ClearConstraint】：清空光标所在行；
【ClearAllConstraint】：清空该表的所有约束。
UCE 的I/Otable界面右键弹出来通用操作的菜单框，如下图所示：
图 1-6IOtable 右键
【ClearConstraint】：清空光标所在行；
【ClearAllConstraint】：清空该表的所有约束；
【Copy】：复制选择框内容；
【Paste】：粘贴；
【Mark】：对选中对象进行标记；
【Unmark】：取消标记；
【Schematic】：打开原理图；
1.3.2UCE 的搜索工具
1.3.2.1UCE 界面 search 工具
UCE中为Attribute表格和CompilePoints表格提供了search工具来帮助搜索
当前表格中的信息，使用”Ctrl+F”可以打开，位置处于UCE 界面下方，如下图
所示：
图1-7UCE 的search工具
其中第一个下拉列表用来选择将要搜索哪一个表格，第二个指定搜索的列，
后边紧接着输入要搜索的内容，点击search 就可以在UCE 中定位到对应的行了。
===PAGE 15===
1.UCE 界面功能介绍
14/126
1.3.2.2UCE 的网表搜索工具
UCE 中为Attribute 表格和TimingConstraints 界面提供了网表搜索工具来帮
助搜索当前网表中的内容，该搜索工具的入口统一表现为窗口或者表格中的按
钮，在需要输入网表内容的地方点击即可。
该搜索工具的显示窗口，如下图所示：
图1-8UCE 的网表搜索工具
该搜索工具分上下两部分，上半部分为搜索条件，下半部分为搜索结果。搜
索条件基于该搜索工具入口处支持的搜索类型，并提供正则匹配/忽略大小写/搜
索hierarchy 结构等搜索方式；用户也可以增加对不同类型的不同匹配方式，比
如：搜索ports 时可以指定direction 的类型为in/out/inout 中的某种。下半部分中
左侧为搜索结果的显示，右侧为用户挑选的搜索结果。
该搜索工具可以在网表中搜索insts/ports/nets/pins/clocks 五种类型的信息。
在Attribute和TimingConstraints 界面中，均只显示入口处支持的Object 类型。
===PAGE 16===
1.UCE 界面功能介绍
15/126
1.3.3UCE 的按钮
PreSynthesizeUCE 界面的上方有5 个按钮，如下图所示：
图1-9 Pre SynthesizeUCE 的按钮
依次为【DesignBrowser】【Region】【Properties】【Selection】【MarkBrowser】
【Save】【CheckConstraints】。
【DesignBrowser】按钮可以打开UCE 的网表查看工具，通过该工具可以查
看该阶段设计网表的结构和内容。网表的内容大致分为三类：Ports、LeafCells
和Nets，由于UCE 阶段会有hierarchical 结构的，所以若有该种结构也会显示。
点击按钮以后会在UCE 左侧显示树型结构，如下图所示。
图1-10DesignBrowser 的结构
【Region】按钮可以打开Region 窗口来进行修改、创建、修改region。
【Properties】按钮可以打开Properties 窗口来查看选中对象的属性。
【Selection】按钮用来打开Selection 界面，可查看选中对象信息。
【MarkBrowser】按钮用来打开MarkBrowser 列表，其中能够定位某个已
mark 的资源位置，并且能够将不需要mark 的资源移除markbrowser。
【Save】按钮用来将当前UCE 中填写的所有约束保存到约束文件targetfile
中，不会过滤掉检查报告中的错误约束。所以，若想生成的约束文件全部正确，
请先查看检查报告。
【CheckConstraints】按钮用来检查UCE 中所填写的约束的正确性，约束检
===PAGE 17===
1.UCE 界面功能介绍
16/126
查报告 ccr 以文本框的形式，并列在 UCE Tab 栏。
【Currentdevice】UCE 界面显示当前使用的器件信息。
接下来几个小节介绍UCE 的各个窗口，UCE 表格里所填写的内容都对应于
各自的约束命令的各个option，下面在介绍时会指明其对应的命令的option，为
了方便描述表格内容与约束命令的对应关系，我们先将约束命令简要说明一下，
对于约束命令的详细描述，在第二章的约束命令介绍里会有说明。
1.3.4TimingConstraints 界面
TimingConstraints 界面是处理Timing 时序命令的界面，如下图所示。
图1-11TimingConstraints 表格
TimingConstraints 界面分为左右两部分，左边的树型结构显示命令及命令的
数量。树型结构可以通过树型结构上面的按钮来实现折叠或者展开。右侧表格显
示每种命令的内容。每条命令对应着一个表格。
树型结构显示支持的时序命令，共六类：Clocks、Inputs、Outputs、Assertions、
Exceptions、Others，一共14 条时序命令。树型结构中的Summary，是预览命令
的界面。单击命令则切换表格，双击命令、表格空白处双击，是弹出创建命令窗
口界面。双击已存在命令，打开修改该条命令的窗口。点击Summary，查看UCE
中已设置的全部Timing 命令。Summary 上部分为从文件中读取进来的已保存的
命令。unsaved_constraint 标签中为在UCE 中新创建的命令。保存以后命令状态
则改变为已保存。
每条命令均有独立的创建命令窗口界面，界面中对命令的每个option均提供
输入操作。点击OK，若窗口界面的命令错误，则会弹出错误信息。只有命令正
确才能通过窗口界面传递到表格中。
===PAGE 18===
1.UCE 界面功能介绍
17/126
1.3.4.1CreateClock窗口及表格
CreateClock 窗口和对应的create_clock 命令一般用于创建基准时钟，基准时
钟一般是通过输入port 输入用户设计的板上时钟；因为会被其他的时序约束命令
所涉及，基准时钟需要首先被定义，且只能通过create_clock 命令设置。
图1-12CreateClock 示例
如上图所示，板上时钟通过clkport 进入器件，clk时钟信号驱动FD0 和FD1
寄存器。为了保证从FD0/C 到FD1/D 路径的时序分析准确，需要在输入portclk
处创建基准时钟。
CreateClock 窗口可创建create_clock 命令，窗口上部为该条命令的简介；中
间为创建该条命令的操作，command 一行可以显示创建的命令的形式以及参数；
下部中点击Reset 按钮则重置该界面。在输入portclk 处创建名字为clk 的基准时
钟，对应窗口界面如下：

===PAGE 19===
1.UCE 界面功能介绍
18/126
图1-13CreateClock 窗口
CreateClock表格用来显示该条命令，表格如下：
图1-14CeateClock 表格
其各列介绍如下：
Enable 列：该列是一个复选框，默认勾选，如果不勾选，则在保存约束文
件时会在该条约束最后加上-disable，除了IOTable，其它表格都有Enable，其用
法是一样的，不再赘述；
Clock name 列：创建的时钟的名字，它对应于 create_clock 命令的-name
<clock_name>参数；
SourceObjects 列：对应create_clock 命令创建时钟的源，如port，pin 等，
必须通过get_pins、get_ports 等命令获得，当其为空时，表示创建一个虚拟时钟；
它对应于create_clock 命令的<source_objects>参数；
Period 列：对应create_clock 命令所创建时钟的周期；它对应于create_clock
命令的-period<period_value>参数；
Waveform 列：对应create_clock 命令所创建时钟上升沿和下降沿的位置；
它对应于create_clock 命令的-waveform<edge_list>参数；
Add 列：是否允许在同一个 source object 上定义多个时钟；它对应于
create_clock 命令的-add 参数；
该表格所填写的值在保存约束文件时会体现为create_clock 命令。
1.3.4.2CreateGeneratedClock 窗口及表格
CreateGeneratedClock窗口和对应的create_generated_clock命令用于创建生
成时钟，生成时钟在设计内部被pll 或某些用户逻辑所驱动。生成时钟和主时钟
相关联，主时钟可以是基准时钟或者是其他的生成时钟。
相较于直接指定生成时钟的周期或者波形属性，生成时钟的属性由主时钟变
换而来，只需要描述相对于主时钟的变换关系。 主时钟和生成时钟之间的关系
可以是下列这些情况分频、倍频、相位移动、波形反转和占空比转换以及他们的
任意组合。
===PAGE 20===
1.UCE 界面功能介绍
19/126
图1-15CreateGeneratedClock 示例
如上图所示，经输入port clk 输入的基准时钟clk 周期为10ns，经过FDIV
二分频驱动FD0，对应的生成时钟为clkdiv2。
CreateGeneratedClock 窗口创建create_generated_clock 命令，窗口上部为该
条命令的简介；中间为创建该条命令的操作，command 一行可以显示创建的命
令的形式以及参数；下部中点击Reset 按钮则重置该界面。窗口界面如下：
图1-16CeateGeneratedClock 窗口
CreateGeneratedClock 表格用来显示该条命令，表格如下：
===PAGE 21===
1.UCE 界面功能介绍
20/126
图1-17CreateGeneratedClock 表格
CreateGeneratedClock 表格指定的内容分两类：指定sourceclock，指定如何
进行变换，其各列介绍如下：
Enable列：同上；
Clockname 列：对应表格在sourceclock 的基础上产生的generatedclock 的
名字；它对应于create_generated_clock 命令的-name<clock_name>参数；
MasterPin(Source) 列：用于描述产生该generatedclock 的sourceclock 所
在的source；它对应于create_generated_clock 命令的-source<master_pin>参数；
SourceObjects 列：用于描述产生该generatedclock 所作用的sourceobject；
它对应于create_generated_clock 命令的<source_objects>参数；
MasterClock 列：用于描述产生该generatedclock 的sourceclock，如果上面
的Source 列填写的source 上只有一个clock，本处可以不写，反之，如果source
上有多个clock 的话，MasterClock 必须填写，否则会报错，至于报错的内容在
第三章约束检查部分会有说明；它对应于 create_generated_clock 命令的-
master_clock<clock>参数；
上面三个参数都是描述该generatedclock 的源头和作用对象的；下面的参数
用于描述如何在sourceclock 的基础上通过变换来产生generatedclock，如下图所
示：
图1-18CreateGeneratedClock 参数
MultiplyBy 列：multiply_by 参数：也是用来变换sourceclock 的频率值，
描述倍频系数，sourceclock的频率值乘以multiply_by参数值得到generatedclock
的频率值；它对应于create_generated_clock 命令的-multiply_by<factor>参数；
DivideBy 列：顾名思义，divide_by 是“被除以”之意，这里指的是sourceclock
的频率“被除以”，所以本参数描述分频系数，sourceclock 的频率值除以divide_by
参数值得到 generated clock 的频率值；它对应于 create_generated_clock 命令的
-divide_by<factor>参数；
===PAGE 22===
1.UCE 界面功能介绍
21/126
Duty Cycle 列：用于描述高电平在整个周期中所占比例，需要配合
multiply_by 一起使用；它对应于 create_generated_clock 命令的-duty_cycle
<percent>参数；当multiply_by 参数未指定时，duty_cycle 参数如果指定了会告警
并忽略过去；
Edges 列：表示从sourceclock 引用的边沿序号，数目必须为3，它对应于
create_generated_clock 命令的-edges<edge_list>参数；
EdgeShift 列：配合edges 使用，用于描述每条边的偏移量，单位是时间；
它对应于create_generated_clock 命令的-edge_shift<shift_list>参数；当edges 参数
未指定时，edge_shift 参数指定了也会告警并忽略过去；
Invert 列：用于将sourceclock 的信号取反，它对应于create_generated_clock
命令的-invert 参数；
Add 列：用于描述当有多个clock 扇入到某sourceobject 时如何处理；当指
定-add 参数时，当某sourceobject 已经存在clock 时，则还会加到上面，不过需
要指定不同的名字；否则就先去掉 source object 上面的 clock；它对应于
create_generated_clock 命令的-add 参数；
1.3.4.3SetClockLatency 窗口及表格
SetClockLatency 窗口创建set_clock_latency 命令，窗口上部为该条命令的
简介；中间为创建该条命令的操作，command 一行可以显示创建的命令的形式
以及参数；下部中点击Reset 按钮则重置该界面。窗口界面如下：
===PAGE 23===
1.UCE 界面功能介绍
22/126
图1-19SetClockLatency 窗口
SetClockLatency 表格内容如下图所示：
图1-20SetClockLatency 表格
其各列介绍如下：
Enable列：同上；
RelativeClocks 列：指定Clock，对应命令的-clockclock_name 选项；
ClockTransition 列：指定是否为clockriselatency、clockfalllatency，对应
命令的-rise/-fall 选项；
Min/MaxCondition 列：指定max、min 参数，对应命令的-max/-min 选项；
Source Latency 列：指定 latency 的类型，为 source latency，对应命令的
-latency_type 选项；
===PAGE 24===
1.UCE 界面功能介绍
23/126
Early/LateCondition 列：指定souce 类型的latency 的参数early、late，对
应命令中的-early/-late选项，该option只有在latency 类型为source 才能指定；
LatencyValue 列：指定latency 的value，对应命令的latency_value选项；
Objects 列：指定objects，类型为clock/port/pin，对应命令中的source_objects
选项；
1.3.4.4SetClockUncertainty 窗口及表格
SetClockUncertainty 窗口创建set_clock_uncertainty 命令，窗口上部为该条
命令的简介；中间为创建该条命令的操作，command 一行可以显示创建的命令
的形式以及参数；下部中点击Reset 按钮则重置该界面。窗口界面如下：
图1-21SetClockUncertainty 窗口
SetClockUncertainty 表格内容如下图所示：
图1-22SetClockUncertainty 表格
其各列介绍如下：
Enable列：同上；
===PAGE 25===
1.UCE 界面功能介绍
24/126
UncertaintyValue 列：指定value值，对应命令中的uncertainty_value 参数；
Setup/Hold 列：表示进行的是setup/hold 分析，对应命令中的-setup/-hold；
From Transition 列：指定 from 的 transition，-rise/-fall，对应命令中的
-rise_from/-fall_from;
From Clock 列：指定 clock，对应命令中的<from_list>/ <rise_from_list>/
<fall_from_list>;
To Transition 列 ： 指 定 to 的 transition ，-rise/-fall ， 对 应 命 令 中 的
-rise_to/-fall_to;
To Clock 列 ： 指 定 clock ， 对 应 命 令 中 的<to_list >/ <rise_to_list> /
<fall_to_list>;
Objects 列 ： 指 定 objects ， 类 型 为 clock/port/pin ， 对 应 命 令 中 的
<source_objects>参数；
1.3.4.5SetClockGroups 窗口及表格
SetClockGroups 窗口和对应的set_clock_groups 命令用于设置时钟组，设置
时钟组可以不进行不同时钟组之间的时序分析，同时对时钟组内的分析没有影
响。不同于set_false_path 约束忽略单向的时序分析，设置时钟组后会忽略双向
的时序分析。
如下图所示，clkA 驱动触发器FD0，clkB 驱动触发器FD1A 和FD1B；clkA
和clkB从不同的输入端口输入，因此他们是异步的。为了保证从FD0到FD1A
的路径被正确分析，需要设置clkA和clkB 之间的时钟组。
图1-23SetClockGroups示例
SetClockGroups 窗口创建set_clock_groups 命令，窗口上部为该条命令的简
===PAGE 26===
1.UCE 界面功能介绍
25/126
介；中间为创建该条命令的操作，command 一行可以显示创建的命令的形式以
及参数；下部中点击Reset 按钮则重置该界面。窗口界面如下：
图1-24SetClockGroups窗口
SetClockGroups 表格内容如下图所示：
图1-25SetClockGroups表格
其各列介绍如下：
Enable列：同上；
Groupname 列：时钟组clockgroup 的名字，它对应于set_clock_groups 命
令的-namegroup_name 参数；
ClockGroupRelationship列：时钟组clockgroup 的类型，有asynchronous、
-logically_exclusive和-physically_exclusive三种；
ClockGroups 列：指定的时钟组，它对应于set_clock_groups 命令的-group
<group_list>参数；
===PAGE 27===
1.UCE 界面功能介绍
26/126
1.3.4.6Set_External_Delay 窗口及表格
SetExternalDelay 窗口创建set_external_delay 命令，窗口上部为该条命令的
简介；中间为创建该条命令的操作，command 一行可以显示创建的命令的形式
以及参数；下部中点击Reset 按钮则重置该界面。窗口界面如下：
图1-26set_external_delay窗口
Set_external_delay 表格内容如下所示：
图1-27set_external_delay表格
其各列介绍如下：
Enable列：同上；
Outputport列：指明该delay 作用的外反馈路径的输出端口，对应命令的 -
from<Outputport>项；
Inputport列：指明该delay 作用的外反馈路径的输入端口，它对应命令的-
to<Inputport>项；
Min/Max Condition 列：指明这个 delay 是最小还是最大值，对应命令的
-min/-max 项；
Delayvalue列：指定外反馈路径的延时值，对应命令的-delay_value 项；
Add 列：是否允许在同一条外反馈路径上定义多个延时值；它对应于
set_external_delay 命令的-add 参数；
===PAGE 28===
1.UCE 界面功能介绍
27/126
1.3.4.7SetInput/OutputDelay 窗口及表格
SetInputDelay 和SetOutputDelay 命令的option 完全一样的，创建命令的窗
口也完全一样，只有两条命令的名字不一样，所以以下只对SetInputDelay 来做
说明。
图1-28SetInputDelay 示例
SetInputDelay 窗口创建set_input_delay 命令，窗口上部为该条命令的简介；
中间为创建该条命令的操作，command 一行可以显示创建的命令的形式以及参
数；下部中点击Reset 按钮则重置该界面。窗口界面如下：
===PAGE 29===
1.UCE 界面功能介绍
28/126
图1-29SetInputDelay 窗口
SetInputDelay 表格内容如下图所示：
图1-30SetInputDelay 表格
其各列介绍如下：
Enable列：同上；
Clock 列：指明该delay 作用的clock 名，对应命令的-clock <clock_name>
项；
ClockEdge列：指明该delay作用于clock的下降沿，它对应命令的-clock_fall
项；
DelayTransition 列：指定该delay 只在rising/fallingtransition 时有效，对
应命令的-rise/-fall项；
Max/MinDelayPath 列：指明这个delay 作用于最长路径/最短路径，对应
命令的-max/-min 项；
Add Delay 列：指定是否将当前 delay 覆盖已有的 delay，对应命令的-
===PAGE 30===
1.UCE 界面功能介绍
29/126
add_delay 项；
LatenciesIncluded 列：该option表示时延值包含的时间，该值的含义为：
-source_latency_included 表示该延时值（数据路径的延迟）已经包含了时序
路径的时钟源延迟时间；对应命令中的-source_latency_included
DelayValue 列：指定delay 值，对应命令的<delay_value>项；
Objects 列：指明该delay 作用的port，对应于命令的<objects>参数。
1.3.4.8SetMaxSkew窗口及表格
SetMaxSkew 窗口创建set_max_skew命令，窗口上部为该条命令的简介；
中间为创建该条命令的操作，command 一行可以显示创建的命令的形式以及参
数；下部中点击Reset 按钮则重置该界面。窗口界面如下：
图1-31SetMaxSkew 窗口
SetMaxSkew 表格内容如下图所示：
===PAGE 31===
1.UCE 界面功能介绍
30/126
图1-32SetMaxSkew 表格
其各列介绍如下：
Enable列：同上；
Specifymaxskew列：设置skew值，对应命令中的skew_value；
Transiton(Start) 列：表示path 的transition，对应命令中的-from 参数；
StartPoints 列：表示path 的startpoint，对应命令中的<from_list>参数；
Through PointsAndTransition 列：表示path必须经过的中间点，
对应命令中的-through<through_list>参数；
Transiton(End) 列：表示path 的transition，对应命令中的-to 参数；
EndPoints 列：表示path 的endpoint，对应命令中的<to_list>参数；
1.3.4.9SetMaxDelay 窗口及表格
SetMaxDelay 窗口创建set_max_delay 命令，窗口上部为该条命令的简介；
中间为创建该条命令的操作，command 一行可以显示创建的命令的形式以及参
数；下部中点击Reset 按钮则重置该界面。窗口界面如下：
===PAGE 32===
1.UCE 界面功能介绍
31/126
图1-33SetMaxDelay 窗口
SetMaxDelay 表格内容如下图所示：
图1-34SetMaxDelay 表格
其各列介绍如下：
Enable列：同上；
DataPathOnly: 设置datapath,对应命令-datapath_only
DelayValue列：设置delay 值，对应命令中的<delay_value>；
Transiton(Start) 列：表示path 的transition，对应命令中的-from 参数；
StartPoints 列：表示path 的startpoint，对应命令中的<from_list>参数；
ThroughPointsAndTransition 列：表示path必须经过的中间点，
===PAGE 33===
1.UCE 界面功能介绍
32/126
对应命令中的-through<through_list>参数；
Transiton(End) 列：表示path 的transition，对应命令中的-to 参数；
EndPoints 列：表示path 的endpoint，对应命令中的<to_list>参数；
1.3.4.10SetMinDelay 窗口及表格
SetMinDelay 窗口创建set_min_delay 命令，窗口上部为该条命令的简介；
中间为创建该条命令的操作，command 一行可以显示创建的命令的形式以及参
数；下部中点击Reset 按钮则重置该界面。窗口界面如下：
图1-35SetMinDelay 窗口
SetMinDelay 表格内容如下图所示：
图1-36SetMinDelay 表格
其各列介绍如下：
===PAGE 34===
1.UCE 界面功能介绍
33/126
Enable列：同上；
DelayValue列：设置delay 值，对应命令中的<delay_value>；
Transiton(Start) 列：表示path 的transition，对应命令中的-from 参数；
StartPoints 列：表示path 的startpoint，对应命令中的<from_list>参数；
Through PointsAndTransition 列：表示path必须经过的中间点，
对应命令中的-through<through_list>参数；
Transiton(End) 列：表示path 的transition，对应命令中的-to 参数；
EndPoints 列：表示path 的endpoint，对应命令中的<to_list>参数；
1.3.4.11SetMulticyclePath 窗口及表格
SetMulticyclePath 窗口创建set_multicycle_path 命令，窗口上部为该条命令
的简介；中间为创建该条命令的操作，command 一行可以显示创建的命令的形
式以及参数；下部中点击Reset 按钮则重置该界面。窗口界面如下：
图1-37SetMulticyclePath 窗口
===PAGE 35===
1.UCE 界面功能介绍
34/126
SetMulticyclePath 表格内容如下图所示：
图1-38SetMulticyclePath 表格
其各列介绍如下：
Enable列：同上；
PathMultiplier 列：设置pathmultiplier的值，对应命令的<path_multiplier>；
Setup/Hold 列：表示进行的是setup/hold 分析，对应命令中的-setup/-hold；
Start/End 列：Start 表示 launch clock 右移的 clock 周期数目，End 表示
captureclock 右移的 clock 周期数目，对应命令中的-start/end；
Transiton(Start) 列：表示path 的transition，对应命令中的-from 参数；
StartPoints 列：表示path 的startpoint，对应命令中的<from_list>参数；
Through PointsAndTransition 列：表示path 必须经过的中间点，对应
命令中的-through<through_list>参数；
Transiton(End) 列：表示path 的transition，对应命令中的-to 参数；
EndPoints 列：表示path 的endpoint，对应命令中的<to_list>参数；
1.3.4.12SetFalsePath 窗口及表格
SetFalsePath 窗口创建set_false_path 命令，窗口上部为该条命令的简介；
中间为创建该条命令的操作，command 一行可以显示创建的命令的形式以及参
数；下部中点击Reset 按钮则重置该界面。窗口界面如下：
===PAGE 36===
1.UCE 界面功能介绍
35/126
图1-39SetFalsePath 窗口
SetFalsePath 表格内容如下图所示：
图1-40SetFalsePath 表格
其各列介绍如下：
Enable列：同上；
Setup/Hold 列：表示进行的是setup/hold 分析，对应命令中的-setup/-hold；
Transiton(Start) 列：表示path 的transition，对应命令中的-from 参数；
StartPoints 列：表示path 的startpoint，对应命令中的<from_list>参数；
Through PointsAndTransition 列：表示path 必须经过的中间点，对应
命令中的-through<through_list>参数；
Transiton(End) 列：表示path 的transition，对应命令中的-to 参数；
===PAGE 37===
1.UCE 界面功能介绍
36/126
EndPoints 列：表示path 的endpoint，对应命令中的<to_list>参数；
1.3.4.13Set_Disable_Timing 窗口及表格
SetDisableTiming 窗口创建set_disable_timing 命令，窗口上部为该条命令的
简介；中间为创建该条命令的操作，command 一行可以显示创建的命令的形式
以及参数；下部中点击Reset 按钮则重置该界面。窗口界面如下：
图1-41Set_disable_timing 窗口
SetDisableTiming 表格内容如下图所示：
图1-42set_disable_timing 表格
其各列介绍如下：
Enable列：同上；
Source pin 列 ： 指 明 该 timing arc 的 起 点 ， 对 应 命 令 中 的 -from
<from_pin_name>参数；
Destination pin 列 ： 指 明 该 timing arc 的 终 点 ， 对 应 命 令 中 的-to
<to_pin_name>参数；
Objects 列：，对应命令中的<object_list>参数；
===PAGE 38===
1.UCE 界面功能介绍
37/126
1.3.5Attribute表格
Attribute表格内容如下图所示：
图1-43Attribute 表格
Attribute表格用来设置UCE 功能中的逻辑约束，目前逻辑约束是以attribute
形式体现在约束文件里的，下面分别介绍该Attribute表格各功能。
点击左上角或右键的InsertRow按钮，弹出AttributesTable窗口，如下图所
示:
图 1- 44 Attributes Table 窗口
Object 栏 ： 表示 该 attribute 标 注到 的 object ，attribute 可 以标 注 到
port/pin/instance/net 上，可以手动输入也可以选中单个或多个对象，当鼠标点击
Object 栏右侧选择按钮会弹出SpecifyObject 窗口，下图所示：
===PAGE 39===
1.UCE 界面功能介绍
38/126
图 1- 45 Specify Object 窗口
Attribute 栏：表示所约束的attribute 类型，可下拉进行选择attribute，如下
图所示：
===PAGE 40===
1.UCE 界面功能介绍
39/126
图 1- 46 Attributes table 中的 attribute 行
Value栏：表示所约束的attribute 类型的属性值，可下拉进行选择或者手动
输入，如下图所示：
图 1- 47 Attributes table 中的 Value 行
command 栏：显示所设置的约束命令，如下图所示：
图 1- 48 Attributes table 中的 commond 栏
===PAGE 41===
1.UCE 界面功能介绍
40/126
此窗口中还存在reset 按钮用于清空设置，点击ok 后会进行约束检查，若存
在错误，会出现弹窗提示，并且约束无法保存到attribute表格中。若在窗口选择
多个对象做逻辑约束并点击ok 后约束检查通过，多个对象的逻辑约束会逐条显
示在attribute表格中，如下图所示：
图 1- 49 保存的逻辑约束
若在Attributestable 中不进行操作，直接点击ok，attribute 表格中会增加空
白行（如下图所示），并对可以对空白行进行操作。
图 1- 50 新增空白行
Enable列：同上；
Object 列 ： 表示 该 attribute 标 注到 的 object ，attribute 可 以标 注 到
port/pin/instance/net 上，当鼠标点击该列，会出现下图所示：
注:在Attribute 表格中的Obejct 栏中只能选择或输入一个对象，若输入多个
对象此命令无效。
图1-51Attribute 表格的Object 列
===PAGE 42===
1.UCE 界面功能介绍
41/126
点击上图中的按钮，会弹出UCE 的网表搜索工具。通过网表搜索工具来搜
索相应的内容。
Object 列的object 在表格中会加上一个前缀来表示其类型，其中，instance
类型前缀为“i:”，net 类型为“n:”，port 类型为“p:”，pin 类型为“t:”。
Attribute列：表示所约束的attribute类型，如下图所示：
图1-52Attribute 表格的Attribute 列
这里的attribute 类型会根据“Object”列选择的不同而提供不同的可选值，
如上图所示，当“Object”类型选择 instance 时，“Attribute”列可选值为
PAP_GROUP/PAP_IO_REGISTER 等属性。
剩下的列如下图所示：
图1-53Attribute 表格的value 相关列
Value列：用于描述该attribute的值，其格式和值本身的要求跟具体attribute
有关系，不符合的会在约束检查中报错或者警告，在第二章会介绍各个属性的值
的要求；
ValueType/Description/Comment 列：用于进一步描述该attributevalue 相关
的特性，目前忽略；
1.3.6CompilePoints界面
CompilePoints界面内容如下图所示：

===PAGE 43===
1.UCE 界面功能介绍
42/126
图1-54CompilePoints 表格
CompilePoints 表格用来在UCE 设置CompilePoints，目的是为增量式编译
服务（综合工具为OEM 是才存在CompilePoints界面）。
Enable列：同上；
View列：Modulename，该选项下拉列表中为用户设计文件中的所有Module
名称。
Type列：CompilePoints 类型，共分为black-box/hard/locked/soft 四种类型；
Comment 列：用于进一步描述该CompilePoints相关的特性，目前忽略；
1.3.7Device 界面
Device 界面内容如下图所示：
图1-55Device 界面
Device 界面主要用来处理以下约束：
(1)对用户design 的顶层port 进行约束，比如其位置、电平标准等；
(2)对区域进行约束，包括某些design 约束到区域中；
(3)对预留的位置进行标记，并传递到后续步骤中。
1.3.7.1Device 界面工具栏
Device 界面工具栏如下图所示：
===PAGE 44===
1.UCE 界面功能介绍
43/126
图1-56Device界面工具栏
从左到右依次为：
DeviceBrowser：显示DeviceBrowser。
I/OTable：显示I/OTable表格。
Zoom：ViewAll、ZoomIn、ZoomOut 三个按钮，点击分别有显示资源整体
布局、放大、缩小的功能。
History：显示PreviousView和NextView，用于切换floorplanview或package
view历史操作的视图。
Mode：RegionMode按钮，点击切换region 模式。
Auto-FitSelection：自适应选中功能。
ShowDifferentialIO：差分按钮，点击在packageview中显示差分信息。
SearchInst：搜索按钮，点击以后通过搜索框在Device 界面搜索Device 信息。
ViewAllWidget：该窗口可以实时显示deviceview 界面所在芯片的位置以及
选中的designnet，该窗口通过点击滚动条之间的按钮，在deviceview 界面右下
角显示。
ShowCellConnections:该窗口可以设置showconnectivity功能的显示规则。
1.3.7.2Device 界面窗口
Device 界面窗口根据布局分为floorplanview窗口、packageview 窗口。
floorplanview 窗口用来显示芯片的资源位置，四周为IO 资源，中间为逻辑
资源。用户可以通过拖放、取消约束等进行界面约束操作。拖放进floorplanview
窗口的实例(primitives)会高亮显示。packageview 窗口用来显示芯片的管脚封装
位置，拖放约束的IO 会高亮显示。
floorplanview 窗口和packageview 窗口可以通过Device 界面下方的按钮进
行切换，可以通过鼠标滑轮或者工具栏中的Zoom 按钮进行缩放操作。
另外，DeviceBroswer、IOTable、搜索窗口分别通过工具栏相应的按钮控制
显示或者隐藏，其界面显示如下所示：
===PAGE 45===
1.UCE 界面功能介绍
44/126
图1-57DeviceBroswer 界面Design 窗口
Design 窗口的下半部分为Selectsavemode设置项，包含三个选项分别为：
Usethedefaultmode、Usethemulti-linemode、Usethesingle-linemode,默认选中
Usethedefaultmode，可对ADS 流程下UCE 的文件的IO 约束命令进行转换，规
则为：Usethedefaultmode-如果当前fdc/lcf 文件中的命令为全部是单行多属性形
式，则新增约束按单行多属性命令形式增加。如果当前fdc/lcf 文件中的命令为全
部是单行多属性形式，则新增约束按单行多属性命令形式增加。如果当前fdc/lcf
文件中的命令为单行多属性形式和多行单属性形式混合，则新增约束按多行单属
性命令形式增加；Usethemulti-linemode-将当前的fdc/lcf 文件中的IO 约束命令
转换为多行单属性形式；Usethesingle-linemode-将当前的fdc/lcf 文件中的IO 约
束命令转换为单行多属性形式；
Design 窗口的中部为General 窗口存在配置项-Addcommenttoerrorcmds，
默认不勾选，当勾选该框时，激活PCE保存时，pcf 中会将错误、无效的约束命
令注释并在console 打印报告信息；未勾选时，激活PCE 保存时，pcf 中不会将
错误、无效的约束命令注释并在console打印报告信息
Device 窗口上部展示硬件上的信息，主要为Design、Device、I/OBanks。三
种类型下分别为约束的object、Bundlenets、硬件上的device、硬件上的I/O。若
相应类型的前面状态为被选中，则表示该种类型在floorplanview/packageview中
显示。若没有被选中，则表示该种类型在floorplanview/packageview 中不会显示。
在DeviceBrowser中选中BundleNets及其下子项右键存在EditColors功能。
===PAGE 46===
1.UCE 界面功能介绍
45/126
图 1- 58 Edit Color 功能
点击Edit Color 后可以打开Preferences –Bundle Nets 页进行 Bundle nets 颜
色、范围和线宽的编辑和修改工作，保存编辑后重新打开UCE，更改的配置生
效。
另外，Device 窗口中有ClockPad、RefPin、SharePin、PLLPad 四类pin 脚
的可选项，代表四种不同类型的管脚（打开界面时，四种类型均默认为不勾选状
态）。勾选某种类型，则在PackageView中画出对应标识的管脚（PackageView
画图中，C 表示ClockPad，R 表示RefPin，S 表示SharePin，P 表示PLLPad）。
图1-59IOTable 表格
IOTable表格可以对I/O进行设置，其约束效果也是实时反馈到packageview
和DesignBrowser 中。Device 界面工具栏中点击按钮“I/OTable”，可以显示IO
Table 。再次点击，则隐藏IOTable。
IOTable工具栏依次功能为：
搜索功能：对port 名称进行过滤显示；
折叠功能：对树型结构显示的IOTable进行折叠；
展开功能：对树型结构的IOTable进行展开；
切换视图功能：对IOTable 显示效果进行切换，表格视图和树型结构视
图两者切换显示。两个视图显示的数据均同步。
另外：
点击IOTable表头，可以进行行排序；
===PAGE 47===
1.UCE 界面功能介绍
46/126
移动IOTable表头，可以改变列的位置；
树型结构中支持对portbus 类型进行批量操作。
图1-60 搜索框
搜索框提供在芯片资源界面搜索具体DeviceInstance 的功能，搜索结果会跳
转到floorplanview 窗口具体位置上。
1.3.7.3Device 界面操作
（一）约束实例
点击按钮【DesignBrowser】，点击某primitives 实例名，例如T_GTP_LUT2，
按住鼠标左键，拖至Floorplanview上某位置，若约束成功，则该位置资源高亮，
实例名前图标消失。该操作对应PAP_LOC 属性。
若某实例已约束，则名称前无图标（未约束的显示绿色图标）。点击该名称
后，右侧高亮并显示该实例，如下图所示。
同时，可以在实例名处右键选择undoconstraint，或者鼠标在Floorplanview
上拖出已经约束的instance，进行取消约束。
图1-61Device 查看实例
===PAGE 48===
1.UCE 界面功能介绍
47/126
（二）IO 约束
通过IOTable表格对IO 进行编辑约束、取消约束。也可以通过PackageView
对DesignBroswer 的IO 拖放操作进行约束。约束的IO 信息会在DesignBroswer
和Packageview中实时显示，如下图所示：
图1-62IO 约束
IOTable在约束文件里也是以attribute的形式表示，其各列介绍如下：
I/ONAME 列：用于描述该port 的名字；
I/ODIRECTION 列：显示I/O 类型input、output、inout；
LOC 列：约束的管脚；
BANK 列：该管脚所在的bank；
VCCIO 列：IO 输入输出电压；
IOSTANDARD列：IO 电平标准；
DISABLE_DRIVE 列：DRIVE 使能（仅 TITAN 系列支持，该列用于使能
DRIVE，勾选则表示可以设置PMOS/NMOS，不勾选则表示可以设置DRIVE，
界面默认为不勾选状态，该参数不会写入约束文件中）；
DRIVE 列：驱动电流；
PMOS_FINGER：单端驱动器的PMOS 驱动能力(仅TITAN 系列支持)；
NMOS_FINGER：单端驱动器的NMOS驱动能力(仅TITAN系列支持)；
BUS_KEEPER 列：设置上拉下拉电阻；
===PAGE 49===
1.UCE 界面功能介绍
48/126
SLEW 列：转换速率；
OFF_CHIP_TERMINATION：外接电阻；
HYS_DRIVE_MODE 列：输入迟滞模式；
VREF_MODE 列：参考电压VREF模式；
VREF_MODE_VALUE列：内部产生VREF和专用VREF输入管脚模式设置；
DDR_TERM_MODE 列：DDRmemory 应用输入匹配电阻设置；
DIFF_IN_TERM_MODE 列：差分输入的输入匹配电阻设置；
OPEN_DRAIN 列：驱动模式选择；
IN_DELAY列：输入延迟；
OUT_DELAY列：输出延迟；
CP_IPT 列：修正poly 电流的default 值；
CAL_MODE 列：DDR 模式输入内置端接电阻校准功能控制；
DDR_RES列：使用校准功能使能时的内置电阻值
差分端口：差分对设置属性时，其IOSTANDARD/VCCIO 等配置应该一致。
且P端和N端的LOC约束应该也与device的P端和N端一致，如果约束的LOC
相反，运行流程时会在ADS 流程的Synthesize 报错，OEM 流程的Device Map
报错。
IOTable 表格右键中，有菜单帮助编辑IO 约束。其中对已有的单行端口约
束，可右键选择多个属性值进行复制，然后选择其他端口右键粘贴。达到复制多
个的效果。对于点击的单行端口，可以右键清楚约束，或者清楚所有端口的约束。
（三）区域约束
目前支持做区域约束的资源有APM/DRM/CLMA/CLMS，其他资源推荐
做PAP_LOC 约束。该操作对应PAP_REGION 属性，具体操作方法如下：
1） 进入打开region 窗口，右键可选择New Region、Delete Region，下方
General 显示区域支持device，Statistics（已有区域约束）可显示选中区域的中含
有的资源，DesignInstance 中可以看到已经约束到region 中的inst。如下图所示。
===PAGE 50===
1.UCE 界面功能介绍
49/126
图1-63区域约束
2） 也可在 floorplan view 窗口中进行区域约束，点击工具栏中的 region
mode进入region 模式，在floorplanview 窗口右键选择DrawRegion，弹框New
Region 窗口，该窗口支持编辑区域支持的device 和显示区域支持的device 的数
量和类型，鼠标变换为十字行后画出区域约束的范围即可。
对于在floorplan 中画出的区域，可以根据弹窗中的操作对区域的范围进
行调整。比如通过鼠标画出一个区域。在绘制的过程中鼠标出可以试试显示目前
有的资源，供用户进行判断。然后会弹出新建region 框来进一步显示region 中资
源状况
图 1- 64 新建 region
===PAGE 51===
1.UCE 界面功能介绍
50/126
图1-65区域约束资源弹窗
下图是右键drawregion 画出了相同的区域范围，region1 是根据LUT、FF、
DTM 画出的范围，region2 是根据DRM(在弹窗中取消勾选了LUT、FF)画出的
范围。Region 范围内画图样式为45 度网格线阴影类型，范围内由红色线条覆盖，
下方黑体显示该Region 的名称。
创建region 后，在regionmode下，在floorplan 上可以通过拖动的region 的
位置的方式来更改region 位置，也可以通过拖拽region 边框的方式更改region
的大小范围。
===PAGE 52===
1.UCE 界面功能介绍
51/126
图1-66 区域约束取消勾选结果
创建出区域约束之后，可将instance 或module 约束到区域当中，具体操作
方法如下：
1）点击按钮【DesignBrowser】，点击某primitives 实例名或module名，按
住鼠标左键，拖至Floorplanview上的区域中，若约束成功，则该被约束的instance
或module 高亮，实例名或module 名前图标消失。存在两种冲突场景处理：子
module 存在约束时，父module 约束区域会有弹框提示子module 会被移除；父
module已存在约束时，约束子module存在弹框提示子module会被忽略约束。
2）也可选中的 instance 或 module 右键 Assign to Region/Unassign from
Region，将选中的instance 或module约束到指定的区域中或取消区域约束。
FloorplanView、Schematic 与Hierarchy 界面中选中instance 或module 也支
持AssigntoRegion/UnassignfromRegion 功能。
===PAGE 53===
1.UCE 界面功能介绍
52/126
图 1- 67 查看实例区域约束
将designinst 约束到region 中，在打开Properties 窗口，在Properties 窗口下
可以查看到region 的各种属性。
在General 栏中可以查看该region 中可使用资源类型，并通过勾选对region
中可使用资源进行过滤。
图 1- 68 region 中 General 栏属性
在Statistics 也可以查看各类型资源的使用数量以及使用率，在Postsynuce
中region 中资源使用率若超限，对应项会标红显示。
===PAGE 54===
1.UCE 界面功能介绍
53/126
图 1- 69 region 中 Statistics 栏属性
在Instances 栏中可以查看到该region 中的约束对象。
图 1- 70 region 中 Instances 栏属性
（四）preserve约束
在floorplanview 窗口中，选择需要预留的位置（某个DeviceInstance），
右键选择SetPreserve，此Instance 即变为预留的状态。在此DeviceInstance 位置
右键选择unsetpreserve，则是取消预留位置。该操作对应PAP_SITE_PRESERVE
属性。
下图所示为预留位置以后的device 图形，右键菜单分别为设置preserve 和取
消preserve。预留以后该device 框样式为45 度网格线阴影类型，范围内由白色
线条覆盖。下方黑体显示该device 的名称。
===PAGE 55===
1.UCE 界面功能介绍
54/126
图1-71preserve 约束
（五）exclusiveregion 约束
在floorplanview 窗口中，选择某个region，右键选择SetExclusiveRegion
和 Unset Exclusive Region，对应为将 region 设置为 Exclusive region 和取消
Exclusiveregion。该操作对应PAP_EXCLUSIVE_REGION 属性。
下图为设置该属性后的Region 图形，设置该属性的Region 样式为密集实粒
阴影类型，范围内由白色粒子高度密集覆盖。下方黑体显示该Region 的名称，
Region 前有标示“RM：”表明该属性用于局部动态重配。
图1-72exclusiveregion 约束
（六）clockregion 显示
在floorplanview 视图上，根据时钟区域进行划分，标出clockregion 的范围，
并实时绘制在floorplanview 视图上。方便确认位置、编辑区域约束等操作。
===PAGE 56===
1.UCE 界面功能介绍
55/126
图1-73clockregion显示
ClockRegion 画图显示如上图右侧所示。不同ClockRegion 有颜色上的区分，
边框的颜色不一样。每个ClockRegion 左下角，会标记出ClockRegion 的名字。
上图左侧的DeviceBrowser 对应有ClockRegion 项，用于过滤右侧floorplanview
中的实时绘制。默认状态下是全部勾选，表示实时绘制所有的ClockRegion。可
通过单个或者全部取消勾选的方式，来控制是否实时绘制某个ClockRegion 或者
全部的ClockRegion。
为避免区域重叠等显示问题，画图时只按照CLMA/CLMS 资源类型来进行
划分，所以ClockRegion 的范围有一定的调整。
（七）ShowConnectivity 功能
在floorplan 上选中位置约束对象后，该对象高亮，且floorplan 上若存在与
该对象有连接关系的位置约束对象，会存在connectivity 显示，如下图:

===PAGE 57===
1.UCE 界面功能介绍
56/126
图 1- 74 选中对象
箭头方向为输出方向。
选中该对象右键点击showconnectivity，floorplan 上与该对象存在连接关系
的对象也被高亮选中，如下图：
图 1- 75 第一次 show connectivity
多次点击showconnectivity，存在扇出效果，如下图：
图 1- 76 扇出效果
并且showconnectivity 的显示规则，可以device 界面工具栏中的ShowCell
Connections来进行设置（注：重新打开组件后，该项会恢复默认设置）
图 1- 77 show cell connections 窗口
【showInputConnections】控制是否显示输入连接关系
【showoutputConnections】控制是否显示输出连接关系
【MaxCellCount】设置最大计数个数
===PAGE 58===
1.UCE 界面功能介绍
57/126
【ShowAll】显示所有连接关系
【HideAll】隐藏所有连接关系
（八）BundleNets 功能
floorplan 上的区域约束之间会显示bundlenets，以此来显示区域之间的紧密
程度，如下图：
图 1- 78 bundle nets 显示
选中显示的bundlenets，打开selection窗口中，可以看到Name栏显示bundle
nets(*)，其中*代表bundlenet 数量，如下图：
图 1- 79 bundle net 选中
可以在DeviceBrowser中的bundlenets项来控制各个等级的bundlenets是否
显示。
图 1- 80 bundle net 设置
（九）selectleafcells 功能
===PAGE 59===
1.UCE 界面功能介绍
58/126
在designbrowser 或者floorplan 上选中对象，若对象存在leafcell，可以查
看右键selectleafcells 高亮可选
图 1- 81 Select Leaf Cells
点击此项和可以选中该对象下所有的leafcell，并在selection 窗口中刷新
显示。
（十）Highlight 功能
Floorplanview支持用户设置自定义device高亮颜色，右键新增菜单选项如下
设置：
1. HighLightSelection(当有devcie选中时高亮，设置颜色可设置一个或多个
选中的device)
===PAGE 60===
1.UCE 界面功能介绍
59/126
图 1- 82 HighLightSelection
2. UnHighLight （存在设置高亮的device时高亮，可以取消一个或多个设置
高亮的device的高亮颜色）
3. Show Highlight List （存在显示高亮配置界面且界面上有设置高亮的
device时，该选项高亮显示）
图 1-83ShowHighlightList
（十一）Mark 功能
===PAGE 61===
1.UCE 界面功能介绍
60/126
在floorplan 中，支持对instance资源进行mark，mark 后会有“菱形”标识。
与此同时，在markbrowser 会同步mark 信息，并以颜色区分。在markbrowser
能够定位某个以 mark 的资源位置，并且能够将不需要 mark 的资源移除 mark
browser。
具体操作如下所示：
1.对于选中资源，右键选择Mark/Unmark
图 1- 84 选中device 右键
2. Mark 资源效果如下
图 1-85mark 效果
3. 在工具栏有按钮菱形控制是否显示Markbrowser 窗口
===PAGE 62===
1.UCE 界面功能介绍
61/126
图 1-86markbrowser
4. 显示Markbrowser 如下
图 1-87mark 浏览器界面
5. 在Markbrowser 能够移除掉不需要的资源，具体做法是选中资源右键菜
单选中Unmark 功能，或者点击Unmarkall 清除全部的mark 标记。
支持mark 操作的视图还有designbrowser、packageview、IOtable，且mark
具有通信功能。即在designbrowser 中选中inst进行mark，markbrowser 中会显
示改inst名，再将该inst进行LOC 约束，floorplan 界面中给inst 上存在相同的
mark 标记，且在其中一处禽畜mark 标记，其他相关通信界面该inst的mark 标
记同样清除。（IOtable、IOtree、packageview、markbrowser 的mark 通信同理）
（十二）Select 功能
在floorplan上可以通过点击右键select功能来选中切换鼠标处位置的选中对
象。
===PAGE 63===
1.UCE 界面功能介绍
62/126
图 1-88 Select 功能
1.3.8Schematic界面
Schematic界面主要用来查看对象的原理图，如下图
图 1- 89 schametic 窗口
在designbrowser、IOtable、floorplan 中选中单个或者多个同层级designinst，
右键菜单中存在schematic选项，点击后可以在UCE 中打开选中对象的原理图。
图 1- 90 Schematic 选项
===PAGE 64===
1.UCE 界面功能介绍
63/126
Schematic页面的功能与综合网表中功能相同，可以查阅：
《ADS_Synthesics_User_Guide》手册中的第3 章，ADS 综合网表分析
1.3.9Hierarchy 界面
UCE 中新增showhierarchy 功能，该功能会添加新的tab 页到UCE 中，并显
示hierarchy 内容。具体显示moduleinst 内的instance数量及hierarchy 层级关系。
如下图所示，Designbrowser 中右键，新增右键菜单showhierarchy 。
图 1- 91 Show Hierarchy
点击右键showhierarchy，则在UCE中新增tab页。该界面显示选中的module
inst 或者顶层内的所有hierarchy 结构。该界面右边可根据design 资源进行过滤
显示。该界面上面有功能栏，可切换显示模式等。
图 1- 92 Hierchay 界面
1.3.10Selection 界面
UCE 中提供了Selection 界面，供用户查询，筛选选中的对象。可以在UCE
===PAGE 65===
1.UCE 界面功能介绍
64/126
的工具栏中点击selection 按钮打开Selection 界面，见下图：
图 1- 93 selection 按钮
打开selection 窗口后在designbrowser，Devcie，IOtable 等界面选中单个或
者多个对象，选中对象的类型以及名称会以表格形式显示在selection 窗口中，若
存在Name 太长无法显示完全鼠标悬浮于该栏可出现冒泡窗口显示全名，见下
图：
图 1- 94 selection 窗口显示
在Selection 窗口中点击其中一个选中对象，点击右键存在以下功能：
图 1- 95 Selection 窗口右键功能
【ShowProperties】显示该选中对象的Properties
【Unselect】取消该对象的选中
【UnselectAll】取消全部对象的选中
【UnselectAllExport】取消除了该选择对象外其他对象的选中
1.3.11Properties 界面
UCE 中提供了Properties 界面，供用户查看选中对象的基本属性值。可以在
===PAGE 66===
1.UCE 界面功能介绍
65/126
该窗口在UCE 的工具栏中点击Properties 按钮打开Properties 界面，见下图：
图 1- 96 Properties 按钮
Properties 界面会显示选中对象的基本属性，如下图：
图 1- 97 Properties 界面显示
且Properties的工具栏提供了一些操作工具共用户保持，切换查看Properties，
这些工具从左到右依次为previousobject，nextobject，Automaticallyupdate。
【previousobject】切换显示上一个对象的Properties
【nextobject】切换显示下一个对象的Properties
【Automaticallyupdate】自动更新成选中对象的Properties，默认为开启状态
不同的对象Properties 页面中显示的属性不同，具体划分见下表：
选中对象 显示页面 子页面显示内容
region
General 显示 region中资源类型（可选择）
Statstics 显示 region中各类型资源数量
Instances 显示约束在 region中的design inst
preserve
region
Statstics 显示 region中各类型资源数量
Exclusive
region
Statstics 显示 region中各类型资源数量
gate devcie
inst
General
显示 name，unit，cell，view，site(x,y),（x,y）像素
坐标
prim device
inst
General 显示 name，parent,unit,cell
top view
General
显示 name，reference name，type，designinstnumber，
net numbr，child module number
Statstics 显示该设计所用基本资源数量
===PAGE 67===
1.UCE 界面功能介绍
66/126
module inst
General
显示 name，reference name，type，designinstnumber，
net nunmber，child module number
Statstics 显示该 module所用基本资源数量
inst
General
显示 CellParamarters，name，unit，cell，view，file，
connected，pin out信息
nets 显示该 module的pin 以及连接的nets
port General 显示 name，file，direction
port bus General
显示 name，file，direction，left_index,right_index，
size
net
General 显示 name，file，pin port count
Connectivity 显示该 net连接的 pin或 port
net bus General 显示 name，file，left_index,right_index，size
pin pad General 显示 name，unit，cell，view，site(x,y),（x,y）
bank
General 显示 name，(ref pin size)，pin size，(ref pin name)
Site 显示 bank中各Pin 的pin name，Instancename，Padname
Bundle nets General 显示 name
Clock Region General 显示 name，unit，cell，view，site(x,y),（x,y）
表 1- 1 Properties 属性显示
1.4 解析差异造成的FDC 修改
该节用于说明解析的差异造成的必要的FDC 文件的修改，以及对该部分修
改的一致指导意见。
综合工具为OEM 时，UCE 读写和编辑的是综合之前的约束，此时打开UCE
是使用ADS 对网表进行解析。由于当前ADS 和SynplifyPro 均作为独立的综合
工具，其解析结果存在差异。存在的差异可能会导致以下场景的发生。
1.在UCE中用搜索工具进行搜索对象并确保将搜索到的对象保存到FDC文
件中。流程中的Synthesize会报错不识别该对象或该对象不存在，导致约束失败。
该种情况下，需要先确认是否是解析差异造成的。可以在综合后的vm 文件中进
行搜索，确认是否有约束的对象。若没有该约束对象，则认为是解析差异导致，
可根据vm文件或者RTLview 手动调整约束的内容。
另外，synthesize/synplify_impl/synplify_cck.rpt 文件是OEM 给出的约束检查
报告文件，该文件中可以查看约束检查的报错信息，便于定位问题。修改后通过
该文件确认约束是否修改正确。
例如：形式如宽位寄存器等对象，在UCE 中搜索的结果是rdt_len[6:0]，无
===PAGE 68===
1.UCE 界面功能介绍
67/126
法搜索出具体的单个对象。此时约束rdt_len[6:0]在流程中会报对象不存在。所以
需要查看综合后的vm 文件，找出具体的单bit 名称。通常名称的前面部分都是
一样的，可以通过搜索rdt_len 来进行查找。一般SynplifyPro 对宽位instance 展
开后名称并不一定是rdt_len[1]，可能形式会类似于rdt_len_1[6]。找到然后替换
掉约束文件中错误的对象名称即可。
2.流程中能跑通，没有ERROR。但是打开UCE，会报对象不识别或者对象
不存在。
该种情况下，在UCE 的搜索工具中对报错的对象进行搜索，如果没有搜索
到，说明是差异造成，此时可以忽略打开UCE 时的报错。
===PAGE 69===
2.UCE约束命令介绍
68/126
2.UCE 约束命令介绍
本章所描述的都是保存在约束文件里的约束命令，这些命令的各个option
与界面表格里填写内容的对应关系在第一章UCE 界面功能介绍里有说明。
2.1 对象描述规则
1、集成版： 在fdc 或UCE 中构建约束对象时，instance 名字与子module
实例的名字之间用分隔符“.”来区分，instance名字和pin脚的名字之间用分隔符
“.”或者“/”来区分。
例：
create_generated_clock -name {CLKA} -source [get_ports {clka_in}] [get_pins
{pllx8_u1.I_GTP_PLL/CLKOUT0}]-master_clock{CLKA_IN}-multiply_by{16}
2、后端版：在sdc 或lcf 中构建约束对象时，instance 名字与子module实例
的名字之间用分隔符“/”来区分， instance 名字和pin 脚的名字之间用分隔符“:”
来区分。
例：
create_generated_clock -name {CLKA} -source [get_ports {clka_in}] [get_pins
{pllx8_u1/I_GTP_PLL:CLKOUT0}]-master_clock{CLKA_IN}-multiply_by{16}
3、如果对象名字有重复，如net 名与instance 名一样，为了区分指定对象，
可以加前缀来区分：
“p:” 表示port
“n:” 表示net
“t:” 表示pin
“i:” 表示instance
4、如果约束对象位于generate 循环过程中，对于 begin 后面有 ":label" 的
情况，externalname 就是 label[idx] 的形式；
对于 begin 后面没有label 的情况，规定默认前缀是 genblk, 后面加上当前
===PAGE 70===
2.UCE约束命令介绍
69/126
是第几个 generateblock，如 genblk1,genblk2，对于 generatefor，则再加上 [idx]，
合起来就是类似genblk2[1]。例如：
genvari;
for(i=0;i<PORTNUM;i=i+1)
begin:mod_loop
always@(posedgeclk_bmu)
if(cs==1'b0&&addr[15:12]==i)
mod_cs[i]<=#11'b0;
else
mod_cs[i]<=#11'b1;
ge_mod_pango#(
.JUMBO_MODE(JUMBO_MODE[i]),
.ETH_MODE(ETH_MODE[i]),
.MANAGEMENT_INTERFACE("TRUE"),
.AUTO_NEGOTIATION("TRUE"),
.CLOCKING_LOGIC("TRUE"),
.CLOCKEN("TRUE"),
.SIM_MODE(SIM_MODE),
.WR_SLOT(WR_SLOT),
.RD_SLOT(RD_SLOT),
.TA_SLOT(TA_SLOT),
.TX_POLARITY(TX_POLARITY),
.RX_POLARITY(RX_POLARITY)
)u_ge_mod_pango(
.clk_bmu(clk_bmu),
.cs(mod_cs[i]),
===PAGE 71===
2.UCE约束命令介绍
70/126
.we(we),
.oe(oe),
.data_in(data_in),
.addr(addr[11:0]),
.data_out(data_out_mod[16*i+15:16*i]),
.ta(mod_ta[i]),
.debug_rxin_out(),//O
.debug_rxout_out(),//O
.pcs_clk_bufg(pcs_clk_bufg[i]),
.external_rstn(external_rstn),//I
.tx_rstn(tx_rstn[i]),//I
.status_vector(status_vector[7*i+6:7*i]),
.phy_link(phy_link),//I
.phy_duplex(phy_duplex),//I
.pin_cfg_en(pin_cfg_en),//I
.sgmii_clk(sgmii_clk[i]),
.sgmii_rx_clk(sgmii_rx_clk[i]),
.tx_tdata(tx_tdata[8*i+7:8*i]),
.tx_tfirst(tx_tfirst[i]),
.tx_tvalid(tx_tvalid[i]),
.tx_tlast(tx_tlast[i]),
.tx_areset(tx_areset[i]),
.tx_tready(tx_tready),//O
.rx_tdata(rx_tdata[8*i+7:8*i]),
===PAGE 72===
2.UCE约束命令介绍
71/126
.rx_tfirst(rx_tfirst[i]),
.rx_tvalid(rx_tvalid[i]),
.rx_tlast(rx_tlast[i]),
.rx_areset(rx_areset[i]),
.rx_tready(rx_tready[i]),
//pcsrx
.pcs_rxk(pcs_rxk[i]),
.pcs_rdispdec_er(pcs_rdispdec_er[i]),
.pcs_rxd(pcs_rxd[8*i+7:8*i]),
.lsm_synced(lsm_synced[i]),
.pcs_rx_clk_bufg(pcs_rx_clk_bufg[i]),
//pcstx
.pcs_txk(pcs_txk[i]),
.pcs_tx_dispctrl(pcs_tx_dispctrl[i]),
.pcs_tx_dispsel(pcs_tx_dispsel[i]),
.pcs_txd(pcs_txd[8*i+7:8*i]),
.tx_clken(tx_clken[i]),
.rx_clken(rx_clken[i]),
.p_cfg_clk(p_cfg_clk),
.paddr(5'd0),
.pwrite(1'b0),
.psel(1'b0),
.penable(1'b0),
.pwdata(16'd0),
.prdata(),
.hsst_ch_ready(hsst_ch_ready[4*i+3:4*i])
===PAGE 73===
2.UCE约束命令介绍
72/126
);
end//mod_loop
上面例子中，如果想对for 循环中的u_ge_mod_pango 对象做PAP_REGION
约束，对象预构建写成上面红色部分的字样加上index 坐标，即：
mod_loop[index]. u_ge_mod_pango 其 中 index 是 循 环 遍 历 的 下 标(0~
PORTNUM)
如果没有写第三行begin 后面的mod_loop，则构建标准为：
genblk1[index].u_ge_mod_pango
其中genblk 是默认前缀，1 表示第1 个循环，index 表示循环内的第几个对
象的坐标(0~PORTNUM)。
5.对象支持tcl 内置命令、支持变量替换
for{seta0}{$a<10}{incra}\
{
define_attribute"i:T_GTP_LUT5_$a"{PAP_GROUP}"group$a"
}
上面的命令会生成10 条命令，$a会被依次替换为0~9
此命令在UCE 界面若有修改或删除一条属性，回写到fdc，for 循环展开显
示命令，展开时做变量子命令替换（时序命令子命令会保留子命令的形式）。
2.2 时序约束
2.2.1Clocks命令
在 树 型 结 构 Clocks 中 有 create_clock 、 create_generated_clock 、
set_clock_latency、set_clock_uncertainty 和set_clock_groups 五条命令：
===PAGE 74===
2.UCE约束命令介绍
73/126
2.2.1.1create_clock
在Clocks 窗口中可以设置create_clock 命令的参数，这个命令的作用是为时
序分析创建一个时钟。需要注意的是用户在使用其他命令有引用clock 的时候需
要先定义该clock。命令格式如下：
create_clock
-period<period_value>
[-name<clock_name>]
[-waveform<edge_list>]
[-add]
[<source_objects>]
[-disable]
命令中各个参数的含义说明如下：方括号表示该参数为可选值，尖括号表示
参数值或参数列表。
-period ：定义创建时钟的周期，为浮点数，单位是ns。
[-name] ：创建的时钟的名字，如果未定义，则一定要指定source_objects，
同时名字和 source_objects 中第一个参数的名字相同；如果用户未定义 source
objects，则用户必须定义-name，此时创建的clcok 是一个虚拟时钟。
[-waveform] ：定义时钟上升沿和下降沿的位置，其中上升沿在前，下降沿
在后，成对存在，格式为：[-waveform]{time_risetime_fall}。
[-add] ：在同一个引脚上定义多个clock，如果不加这个参数，那么后面定
义的clock 会将已定义的clock 覆盖掉，同时软件将会给出警告。
[<source_objects>] ：创建的时钟的源，可以是pin 或port（必须通过get_pins、
get_ports 得到），当其为空时，创建虚拟时钟。
[-disable] ：使本条约束不生效。
2.2.1.2create_generated_clock
在GeneratedClocks 窗口中可以设置create_generated_clock 命令的参数，该
命令的格式如下：
create_generated_clock
[-name<clock_name>]
===PAGE 75===
2.UCE约束命令介绍
74/126
-source<master_pin>
[-master_clock<clock>]
[-multiply_by<factor>][-divide_by<factor>]
[-duty_cycle<percent>]
[-edges<edge_list>][-edge_shift<shift_list>]
[-invert]
[-add]
<source_objects>
[-disable]
命令中各个参数的含义说明如下：方括号表示该参数为可选值，尖括号表示
参数值或参数列表。
[-name] ：创建的时钟的名字。
-source：指定sourceclock 的pin 或者port，驱动该generatedclock。
[-master_clock] ：指定sourceclock，在masterpin 上面有多个sourceclock，
而generatedclock 只来自于其中一个clock 时使用；当masterpin 上面只有一个
sourceclock 的时候，可以不指定该参数。
[-multiply_by] ：倍频系数，倍频系数是一个大于0的整数，将时钟周期缩小
指定倍数，倍频不止引起周期的变化，波形也将等比例缩小。
[-divide_by] ：分频系数，分频系数是一个大于0的整数，将时钟周期扩大指
定倍数。分频不止引起周期的变化，还会导致波形的变化；在PDS里，当分频系
数为2以及2的指数倍时会将占空比设置为50%，其他系数值则保持原占空比不
变。
-divide_by 和-multiply_by 可以同时使用以做到非整数倍的频率变换，即小数
分频。
[-duty_cycle] ：单位是percent（%），描述占空比，即高电平占整个周期的
比例；占空比只能在使用-multiply_by 的时候使用。
[-edges] ：表示从sourceclock 引用的边沿的列表，每一个edge 不能小于1
且不能小于上个edge，和create_clock 中waveform 的格式一致；不同的是最后
还要加上第二个周期开始的位置，PDS 要求edge_list 中参数个数一定为3 个，
===PAGE 76===
2.UCE约束命令介绍
75/126
里面不仅包含了第一个周期的上升沿和下降沿，还包含第二个周期的上升沿，软
件能从中计算出generatedclock 的周期；例如-edges{246}，其中“2”表示source
clock 的第二个edge，“4”表示source 的第四个edge……依次类推；在generated
clock 里，“2”对应第一个上升沿位置，“4”表示第一个下降沿的位置，“6”表示下
一个上升沿的位置。
[-edge_shift] ：指定了一系列浮点数，来表示每条边的偏移量，单位是ns，
必须和-edges 一起使用；如果generatedclock 需要实现相移功能，那么就需要用
到“-edge_shift”，“-edge_shift”里面的列表元素个数必须和“-edges”里面的个数一
致。
[-invert] ：表示相对于sourceclock，generatedclock 的clock 信号被取反。
[-add] ：在同一个引脚上定义多个clock，如果不加这个参数，那么后面定
义的clock 就会将前面的覆盖掉。
<source_objects> ：被创建generatedclock 的pin，port 或者是net。
[-disable] ：使本条约束不生效。
注：
1.-edges/-edge_shift 不能和-multiply_by、-divide_by、-duty_cycle 同时使用。
2. 对于用户在PLL 上创建的create_generated_clock 约束，如果PLL 配置了
相移，那么约束命令就需要通过-edges/-edge_shift 选项将PLL 的相移信息体现在
generatedclock 的波形上；软件自动在PLL 上infer 的时钟也通过上述方法体现
PLL 的相移延时。另外，用户需要注意时序分析路径上的时钟边沿对，有时可能
需要通过set_multicycle_path 约束进行调整。
3. create_generated_clock 命令支持 rename 功能，即用户只需要指定
create_generated_clock 中的-name，source_objects，软件会自动infer 出该时钟的
周期和波形，同样也可以指定-source|-master_clock 来筛选source 时钟，该功能
只支持PLL 和CLKDIV 的时钟输出端口。如果用户想要使用此功能，则不能指
定 如 下 选 项 ： [-edges edge_list] [-edge_shift shift_list] [-divide_by factor]
[-multiply_byfactor][-duty_cyclepercent][-invert]。用户可使用该功能重命名软件
infer 的generatedclock，并基于指定的名字进行后续的时序约束。命令示例如下：
create_generated_clock-namepll_clk[get_pins{pll.clkout1}]
===PAGE 77===
2.UCE约束命令介绍
76/126
1.2.1.3 set_clock_latency
在SetClockLatency 窗口中可以设置set_clock_latency 命令的参数，该命令
的格式如下：
set_clock_latency
[-clock<clock_list>]
-source
<latency_value>
[-early][-late]
[-max][-min]
[-rise][-fall]
<object_list>
[-disable]
命令中各个参数的含义说明如下：方括号表示该参数为可选值，尖括号表示
参数值或参数列表。
[-clock] ：该条命令作用的clock。
-source：指定latency的类型，目前只支持sourcelatency，必须定义-source参
数。
<latency_value> ：延时值，为浮点数，单位是ns。
[-min] ：在bc_wc的环境下，-min表示fastcorner；-min和-max不能同时指定；
不指定-min和-max，默认fastcorner和slowcorner命令都会生效。
[-max] ：在bc_wc的环境下，-max表示slowcorner；-min和-max不能同时指
定；不指定-min和-max，默认fastcorner和slowcorner命令都会生效。
[-early] ：表示该latency是clock的左偏移量；-early和-late不能同时指定；不
指定-early和-late，默认clock的左右偏移量都会生效。
[-late] ：表示该latency是clock的右偏移量，-early和-late不能同时指定；不指
定-early和-late，默认clock的左右偏移量都会生效。
[-rise] ：表示该latency只应用在触发时钟边沿为上升沿的情况。
[-fall] ：表示该latency只应用在触发时钟边沿为下降沿的情况。
<object_list> ：时钟定义点。可以通过get_pins、get_ports等方式获取对应
===PAGE 78===
2.UCE约束命令介绍
77/126
pin/port上定义的时钟，也可以直接将latency定义在clock上。
[-disable] ：使本条约束不生效。
2.2.1.4set_clock_uncertainty
在SetClockUncertainty 窗口中可以设置set_clock_uncertainty 命令的参数，
该命令的格式如下：
set_clock_uncertainty
[<uncertainty_value>]
[-setup][-hold]
[<object_list>|
-from<from_clock>
|-rise_from<rise_from_clock>
|-fall_from<fall_from_clock>
-to<to_clock>
|-rise_to<rise_to_clock>
|-fall_to<fall_to_clock>]
[-disable]
命令中各个参数的含义说明如下，方括号表示该参数为可选值，尖括号表示
参数值或参数列表，| 表示或符号，同级和它的下一级中的几个选项只能使用一
个：
[<uncertainty_value>] ：uncertainty 值，为浮点数，单位是ns。
[-setup] ：表示uncertaintyvalue 只用在setup 分析中。
[-hold] ：表示uncertaintyvalue 只用在hold 分析中。
[<object_list>] ：如果触发器时钟端的pin 或者port 上面定义了多个时钟，
而用户只想为其中的一个时钟定义uncertainty，那么object 可以是用户定义的一
个clock；如果用户想为触发器时钟端的pin 或者port 上面的所有clock 定义同一
个uncertainty，那么object 可以是一个pin 或者port。
[-from] ：表示launchclock，不考虑clock 的极性。
[-rise_from] ：表示只考虑launchclock 为上升沿的情况。
===PAGE 79===
2.UCE约束命令介绍
78/126
[-fall_from] ：表示只考虑launchclock 为下降沿的情况。
[-to] ：表示captureclock，不考虑clock 的极性。
[-rise_to] ：表示只考虑captureclock 为上升沿的情况。
[-fall_to] ：表示只考虑captureclock 为下降沿的情况。
[-disable] ：使本条约束不生效。
2.2.1.5set_clock_groups
在SetClockGroups 窗口中可以设置set_clock_groups 命令的参数，该命令的
格式如下：
set_clock_groups
[-namegroup_name]
[-asynchronous|-logically_exclusive|-physically_exclusive]
[-group<clock_list>]*
[-disable]
2.2.1.6set_external_delay
Set_external_delay 命令用于设置一个Outputport 和一个Inputport 之间的外
反馈路径延时，这个延时被用于PLL 的外反馈路径延时计算。可以指定最大或
最小值，默认情况下这个延时可以同时适用于最小（hold）和最大（setup）分析。
命令格式如下：
set_external_delay
-from<Outputport>
-to<Inputport>
[-min][-max]
[-add]
<delay_value>
[-disable]
命令中各参数含义说明如下，方括号表示该参数为可选值，尖括号表示该参
数为必选值。
-from：PLL 芯片外外反馈下的Outputportname。
===PAGE 80===
2.UCE约束命令介绍
79/126
-to：PLL 芯片外外反馈下的Inputportname。
[-min]：表示设置的延时值是最小值。
[-max]：表示设置的延时值是最大值。
[-add]：表示可以在同一个外反馈路径上设置多个延时值，如果之前该路径
上面已经定义了一个延时值，并且用户未加-add 参数，那么后面的定义的延时值
就会将前面的覆盖掉。
<delay_value>：延时值，为浮点数，单位是ns。
[-disable]：使本条约束不生效。
2.2.2Inputs/outputs命令
在SetInputDelay 和SetOutputDelay 的创建命令窗口和表格中，均可以设
置“set_input_delay”和“set_output_delay”命令的参数。
2.2.2.1set_input_delay
在SetInputDelay 窗口中可以设置set_input_delay 命令的参数，该命令的格
式如下：
set_input_delay
-clock<clock_name>
[-clock_fall]
[-rise][-fall]
[-max][-min]
[-add_delay]
[-source_latency_included]
<delay_value>
<port_list>
[-disable]
命令中各个参数的含义说明如下，方括号表示该参数为可选值，尖括号表示
参数值或参数列表：
-clock ：表示其关联的capture 时钟的名字。
===PAGE 81===
2.UCE约束命令介绍
80/126
[-clock_fall] ：表示只考虑触发时钟为下降沿的情况。
[-rise] ：即只考虑input 处的输入信号为上升沿的情况。
[-fall] ：即只考虑input处的输入信号为下降沿的情况。
注意：如果用户二者都没有定义，那么软件将同时考虑input处的输入信号
的上升沿和下降沿情况。
[-max] ：表示用户定义的延时值是最大值。
[-min] ：表示用户定义的延时值是最小值。
注意：如果用户二者都没有定义，那么软件将用户定义的延时值同时在最大
和最小延时分析时使用。
[-add_delay] ：如果用户之前已经对该inputport做了set_input_delay的约束，
那么加这个参数表示软件将保留之前的设定的约束值。
[-source_latency_included] ：表示clocksourcelatency已经算在value之内了，
不用再计算。
<delay_value> ：延时值，为浮点数，单位是ns。
<port_list> ：inputport，必须通过get_ports 得到。
[-disable] ：使本条约束不生效。
2.2.2.2set_output_delay
在SetOutputDelay 窗口中可以设置set_output_delay 命令的参数，该命令的
格式如下：
set_output_delay
-clock<clock_name>
[-clock_fall]
[-rise][-fall]
[-max][-min]
[-add_delay]
[-source_latency_included]
<delay_value>
<port_list>
[-disable]
===PAGE 82===
2.UCE约束命令介绍
81/126
命令中各个参数的含义说明如下，方括号表示该参数为可选值，尖括号表示
参数值或参数列表：
-clock ：表示其关联的launch 时钟的名字。
[-clock_fall] ：表示只考虑触发时钟为下降沿的情况。
[-rise] ：只考虑output 处的输入信号为上升沿的情况。
[-fall] ：只考虑output处的输入信号为下降沿的情况。
注意：如果用户二者都没有定义，那么软件将同时考虑output处的输入信号
的上升沿和下降沿情况。
[-max] ：表示用户定义的延时值是最大值。
[-min] ：表示用户定义的延时值是最小值。
注意：如果用户二者都没有定义，那么软件将用户定义的延时值同时在最大
和最小延时分析时使用。
[-add_delay] ：如果用户之前已经对该outputport 做了set_output_delay 的约
束，那么加这个参数表示软件将保留之前设定的约束值。
[-source_latency_included] ：表示clocksourcelatency已经算在value之内了，
不用再计算。
<delay_value> ：延时值，为浮点数，单位是ns。
<port_list> ：outputport，必须通过get_ports 得到。
[-disable] ：使本条约束不生效。
2.2.3Assertio 命令
2.2.3.1set_max_skew
在SetMaxSkew 窗口中可以设置set_max_skew 命令的参数，该命令的格式
如下：
set_max_skew
[-from<from_list>|-rise_from<rise_from_list>|-fall_from<fall_from_list>]
[-through<through_list>]*
[-to<to_list>|-rise_to<rise_to_list>|-fall_to<fall_to_list>]
<skew_value>
===PAGE 83===
2.UCE约束命令介绍
82/126
[-disable]
命令中各个参数的含义说明如下，方括号表示该参数为可选值，尖括号表示
参数值或参数列表，*表示该参数可以重复，| 表示或符号，同级的多个选项只
能使用一个：
[-from] ：<from_list>表示path 的startpoint，可以通过get_ports、get_cells、
get_pins、get_clocks 得到。
[-rise_from] ：该参数只能指定为时钟clocks，表示该时序路径起点被时钟
上升沿触发，此处的时钟上升沿指的是时钟定义点的上升沿。
[-fall_from] ：该参数只能指定为时钟clocks，表示该时序路径起点被时钟下
降沿触发，此处的时钟下降沿指的是时钟定义点的下降沿。
[-to] ：<to_list>表示path 的endpoint，可以通过get_ports、get_cells、get_pins、
get_clocks 得到。
[-rise_to] ：该参数只能指定为时钟clocks，表示该时序路径终点被时钟上升
沿触发，此处的时钟上升沿指的是时钟定义点的上升沿。
[-fall_to] ：该参数只能指定为时钟clocks，表示该时序路径终点被时钟下降
沿触发，此处的时钟下降沿指的是时钟定义点的下降沿。
[-through] ：<through_list>表示 path 经过的中间点，可以通过 get_cells、
get_pins、get_nets 得到。
<skew_value> ：指定这条命令约束的一组path 的最大skew 值，为浮点数，
单位是ns。
[-disable] ：使本条约束不生效。
2.2.4Exception命令
在树型结构Exception中有set_max_delay、set_min_delay、set_multicycle_path
和set_false_path 四条命令：
2.2.4.1set_max_delay
在SetMaxDelay 窗口中可以设置set_max_delay 命令的参数，该命令的格式
如下：
set_max_delay
===PAGE 84===
2.UCE约束命令介绍
83/126
[-from<from_list>|-rise_from<rise_from_list>|-fall_from<fall_from_list>]
[-through<through_list>]*
[-to<to_list>|-rise_to<rise_to_list>|-fall_to<fall_to_list>]
[-datapath_only]
<delay_value>
[-disable]
命令中各个参数的含义说明如下，方括号表示该参数为可选值，尖括号表示
参数值或参数列表，*表示该参数可以重复，| 表示或符号，同级的多个选项只
能使用一个：
[-from] from_list ：from_list 表示 path 的 startpoint，可以通过 get_ports、
get_cells、get_pins、get_clocks 得到。
[-rise_from] ：该参数只能指定为时钟clocks，表示该时序路径起点被时钟
上升沿触发，此处的时钟上升沿指的是时钟定义点的上升沿。
[-fall_from] ：该参数只能指定为时钟clocks，表示该时序路径起点被时钟下
降沿触发，此处的时钟下降沿指的是时钟定义点的下降沿。
[-through] ：<through_list>表示 path 经过的中间点，可以通过 get_cells、
get_pins、get_nets 得到。
[-to] ：<to_list>表示path 的endpoint，endpoint 可以通过get_ports、get_cells、
get_pins、get_clocks 得到。
[-rise_to] ：该参数只能指定为时钟clocks，表示该时序路径终点被时钟上升
沿触发，此处的时钟上升沿指的是时钟定义点的上升沿。
[-fall_to] ：该参数只能指定为时钟clocks，表示该时序路径终点被时钟下降
沿触发，此处的时钟下降沿指的是时钟定义点的下降沿。
[-datapath_only] ：表示指定的maxdelaypath 不关心时钟的skew 和jitter，
只考虑datapath，包括第一个触发器的CLK->Q延时，第二个触发器的setuptime，
以及两个触发器之间的组合路径延时。
<delay_value> ：延时值，为浮点数，单位是ns。
[-disable] ：使本条约束不生效。
===PAGE 85===
2.UCE约束命令介绍
84/126
2.2.4.2set_min_delay
在SetMinDelay 窗口中可以设置set_min_delay 命令的参数，该命令的格式
如下：
set_min_delay
[-from<from_list>|-rise_from<rise_from_list>|-fall_from<fall_from_list>]
[-through<through_list>]*
[-to<to_list>|-rise_to<rise_to_list>|-fall_to<fall_to_list>]
<delay_value>
[-disable]
命令中各个参数的含义说明如下，方括号表示该参数为可选值，尖括号表示
参数值或参数列表，*表示该参数可以重复，| 表示或符号，同级的多个选项只
能使用一个：
[-from] from_list ：from_list 表示 path 的 startpoint，可以通过 get_ports、
get_cells、get_pins、get_clocks 得到。
[-rise_from] ：该参数只能指定为时钟clocks，表示该时序路径起点被时钟
上升沿触发，此处的时钟上升沿指的是时钟定义点的上升沿。
[-fall_from] ：该参数只能指定为时钟clocks，表示该时序路径起点被时钟下
降沿触发，此处的时钟下降沿指的是时钟定义点的下降沿。
[-through] ：<through_list>表示 path 经过的中间点，可以通过 get_cells、
get_pins、get_nets 得到。
[-to] ：<to_list>表示path 的endpoint，endpoint 可以通过get_ports、get_cells、
get_pins、get_clocks 得到。
[-rise_to] ：该参数只能指定为时钟clocks，表示该时序路径终点被时钟上升
沿触发，此处的时钟上升沿指的是时钟定义点的上升沿。
[-fall_to] ：该参数只能指定为时钟clocks，表示该时序路径终点被时钟下降
沿触发，此处的时钟下降沿指的是时钟定义点的下降沿。
<delay_value> ：延时值，为浮点数，单位是ns。
[-disable] ：使本条约束不生效。
===PAGE 86===
2.UCE约束命令介绍
85/126
2.2.4.3set_multicycle_path
在SetMulticyclePath 窗口中可以设置set_multicycle_path 命令的参数，该命
令的格式如下：
set_multicycle_path
[-setup][-hold]
[-start][-end]
[-from<from_list>|-rise_from<rise_from_list>|-fall_from<fall_from_list>]
[-through<through_list>]*
[-to<to_list>|-rise_to<rise_to_list>|-fall_to<fall_to_list>]
<path_multiplier>
[-disable]
命令中各个参数的含义说明如下，方括号表示该参数为可选值，尖括号表示
参数值或参数列表，*表示该参数可以重复，| 表示或符号，同级的多个选项只
能使用一个：
[-setup] ：表示setup 分析时，时钟周期使用指定的倍数。Setup指定之后，
hold也会受到影响。默认情况下，是使用setup。
[-hold] ：表示hold 分析时，时钟周期使用指定的倍数。
[-start] ：表示这个多周期的设置是和launchclock 相关的。
[-end] ：表示这个多周期的设置是和captureclock 相关的。
[-from] from_list ：from_list 表示 path 的 startpoint，可以通过 get_ports、
get_cells、get_pins、get_clocks 得到。
[-rise_from] ：该参数只能指定为时钟clocks，表示该时序路径起点被时钟
上升沿触发，此处的时钟上升沿指的是时钟定义点的上升沿。
[-fall_from] ：该参数只能指定为时钟clocks，表示该时序路径起点被时钟下
降沿触发，此处的时钟下降沿指的是时钟定义点的下降沿。
[-through] ：<through_list>表示 path 经过的中间点，可以通过 get_cells、
get_pins、get_nets 得到。
[-to] ：<to_list>表示path 的endpoint，endpoint 可以通过get_ports、get_cells、
===PAGE 87===
2.UCE约束命令介绍
86/126
get_pins、get_clocks 得到。
[-rise_to] ：该参数只能指定为时钟clocks，表示该时序路径终点被时钟上升
沿触发，此处的时钟上升沿指的是时钟定义点的上升沿。
[-fall_to] ：该参数只能指定为时钟clocks，表示该时序路径终点被时钟下降
沿触发，此处的时钟下降沿指的是时钟定义点的下降沿
<path_multiplier> ：表示设置的周期数目，是一个大于等于0 的整数。当设
置为0 时，表示指定的path 为zerocyclepath。
[-disable] ：使本条约束不生效。
2.2.4.4set_false_path
在SetFalsePath 窗口中可以设置set_false_path 命令的参数，该命令的格式
如下：
set_false_path
[-setup][-hold]
[-from<from_list>|-rise_from<rise_from_list>|-fall_from<fall_from_list>]
[-through<through_list>]*
[-to<to_list>|-rise_to<rise_to_list>|-fall_to<fall_to_list>]
[-disable]
命令中各个参数的含义说明如下，方括号表示该参数为可选值，尖括号表示
参数值或参数列表，*表示该参数可以重复，| 表示或符号，同级的多个选项只
能使用一个：
[-setup] ：表示进行的是setup 分析
[-hold] ：表示进行的是hold 分析
[-from] ：<from_list>表示path 的startpoint，可以通过get_ports、get_cells、
get_pins、get_clocks 得到。
[-rise_from] ：该参数只能指定为时钟clocks，表示该时序路径起点被时钟
上升沿触发，此处的时钟上升沿指的是时钟定义点的上升沿。
[-fall_from] ：该参数只能指定为时钟clocks，表示该时序路径起点被时钟下
降沿触发，此处的时钟下降沿指的是时钟定义点的下降沿。
[-through] ：<through_list>表示 path 经过的中间点，可以通过 get_cells、
===PAGE 88===
2.UCE约束命令介绍
87/126
get_pins、get_nets 得到。
[-to] ：<to_list>表示path 的endpoint，可以通过get_ports、get_cells、get_pins、
get_clocks 得到。
[-rise_to] ：该参数只能指定为时钟clocks，表示该时序路径终点被时钟上升
沿触发，此处的时钟上升沿指的是时钟定义点的上升沿。
[-fall_to] ：该参数只能指定为时钟clocks，表示该时序路径终点被时钟下降
沿触发，此处的时钟下降沿指的是时钟定义点的下降沿。
[-disable] ：使本条约束不生效。
2.2.5Other约束命令
2.2.5.1set_disable_timing
Set_disable_timing用于disable某段时序弧。命令格式如下：
set_disable_timing
[-from<from_pin_name>]
[-to<to_pin_name>]
<object_list>
[-disable]
命令中各参数含义说明如下，方括号表示该参数为可选值，尖括号表示该参
数为必选值：
-from：表示时序弧的起点，只有object_list 指定的对象为lib_cell 和Inst 时
可用，在指定cell 中只disable 起点为此from_pin 的timingarc，from_pin_name
应对应object_list中lib_cell 或Inst 的pinname。
-to：表示时序弧的终点，只有object_list 指定的对象为lib_cell 和Inst 时可
用，在指定cell 中只disable 终点为此to_pin 的timingarc，to_pin_name 应对应
object_list中lib_cell 或Inst 的pinname。
<object_list>：表示指定对象的list，对象可以为lib_cell、inst、pin、port，
目前不支持hierarchicalinst。
[-disable]：使本条约束不生效。
===PAGE 89===
2.UCE约束命令介绍
88/126
2.3 逻辑约束
在UCE 表格中Attributes 和Device 界面中可以编辑生成define_attribute 命
令和define_global_attribute命令。如下图所示：
图 2-1Attribute 表格
2.3.1define_attribute命令
define_attribute 命令可以为单个design 对象(port/instance/pin/net)设置属性。
其命令格式如下：
define_attribute:[-disable]
port/inst/pin/netname
attribute
attributevalue
其中中括号中的值为可选值。
[-disable]: 表示这条命令将不会被执行
port/inst/pin/netname: 指定需要约束属性的对象，根据属性的不同，对象可
以分别是portname、pinname、netname或designinstname
attribute ：指定所需要指定的属性，例如PAP_REGION
attributevalue ：指定对应属性的值
实例：
define_attribute {i:T_GTP_LUT5_4}{PAP_REGION}{reg}
给T_GTP_LUT5_4 这个designinstance 指定一个PAP_REGION 属性，规定
其必须放置区域reg 内，该reg 需要先由define_global_attribute声明才能使用。
define_attribute{i:T_GTP_LUT5_4}{PAP_IO_LOC}{CLMA_63_0}
给T_GTP_LUT5_4 这个instance 指定一个PAP_IO_LOC 属性，规定其必须
约束在floorplan 上的坐标CLMA_63_0 上。
===PAGE 90===
2.UCE约束命令介绍
89/126
2.3.2define_global_attribute命令
define_global_attribute命令可以设置全局属性。其命令格式如下：
define_global_attribute:[-disable]
attribute_name
attribute_value
其中中括号中的值为可选值。
[-disable] ：表示这条命令将不会被执行
attribute_name：属性名,目前只允许为PAP_REGION/PAP_SITE_PRESERVE
/PAP_CLOCK_DEDICATED_ROUTE 其中一种，且每种属性在保存文件中最
多只允许添加一条命令。
attribute_value ：指定约束属性的多个对象，对象之间用分号隔开。若属性
为PAP_REGION，则属性值为一个或多个region，且属性采用先声明后使用的方
式，如：先通过define_global_attribute{PAP_REGION}
{reg1(1,2,3,4);reg2(2,6,2,6)}[CLMA,CLMS]定义了两个区域reg1,reg2，且标记支
持资源类型为 CLMA，CLMS（该资源类型可以缺省），则后续可以使用
define_attribute{i:T_GTP_LUT5_4}
{PAP_REGION}{reg1}来使用已经通过define_global_attribute声明的区域reg1。
若属性为 PAP_SITE_PRESERVE, 则属性值为一个或多个 device instance，如
{CLMA_6_4;CLMA_6_7}。若属性为PAP_CLOCK_DEDICATED_ROUTE，则属
性值为TRUE/FALSE。
实例：
define_global_attribute {PAP_REGION} {reg1(1,2,3,4);reg2(2,6,2,6)}
[CLMS，CLMA]
通过两个全局的区域约束属性定义了两个区域，分别是reg1 和reg2；
define_global_attribute{PAP_SITE_PRESERVE}{CLMA_6_4;CLMA_6_7}
定义两个deviceinstance 的全局约束属性，将两个deviceinstance 设置为不
可用（预留），即约束和布局的时候都不会使用这两个deviceinstance。
===PAGE 91===
2.UCE约束命令介绍
90/126
2.3.3define_compile_points命令
define_compile_attribute命令可以设置不需要重新综合的约束Module。即需
要重新综合整个design 时，可以选择只重新综合与修改相关的design，其他的模
块不需要综合，以节省运行时间。其命令格式如下：
define_compile_points:[-disable]
[-common]
[modulename]
[-type]
其中中括号中的值为可选值。
[-disable] ：表示这条命令将不会被执行
[-common] ：该option 用于进一步描述该CompilePoints 相关的特性，目前
忽略。
[modulename] ：表示不需要重新综合的Modulename。
[-type] ：表示Compile Points 类型，共分为 black-box/hard/locked/soft 四种
类型。
实例：
define_compile_point -comment {first time} {v:CLM_LUT} -type
{black_box}将用户design 文件中的某个CLM_LUTmodule 设置为compile
points，该module将不会重新综合；
2.3.4UCE 中属性的设置
UCE 支持对属性进行设置。属性保存文件根据是否使用综合工具、保存的
文件类型不同，使用综合工具(集成版)时，属性会保存在约束文件(.fdc)中；不使
用综合工具(后端版)时，属性会保存在逻辑约束文件(.lcf)中。属性的保存格式在
两种情况下均使用define_attribute命令格式。
设置instanceattribute 目前有两种用法：
1、在UCE 的Attribute表格中设置属性
===PAGE 92===
2.UCE约束命令介绍
91/126
2、直接在.v 或.vm里利用verilog 语法进行设置
这两种方法设置的attribute都可以在flatten和map后通过DB文件传递下来。
2.3.4.1PAP_GROUP
功能：PAP_GROUP 是作为RTL 中自定义的module 实例的attribute，可以
对逻辑进行分组，布局时会尽量将同组的逻辑放置在靠近的位置。
对象：作用对象是RTL中自定义的一个module的实例。
属性值：属性值的形式可以是符合命名标准的任意字符串。
描述：PAP_GROUP属性是通过DB文件向下传递的，作用对象是一个module
instance 实例，该moduleinstance 在flatten 后的topinstance 以及map 后转换的
所有gopinstance都会拥有该属性。
使用说明：在UCEAttribute表格可以设置该属性。
实例：
define_attribute{u_top_module.sub_module}{PAP_GROUP}{group_01}
2.3.4.2PAP_CLOCK_ASSIGN
功能：PAP_CLOCK_ASSIGN属性的作用对象是net、pin 或port，在布局布
线时会根据该属性的值来决定是否使用全局时钟（信号）、局部时钟、水平时钟
等。
对象：作用对象是designnet(未连接port，且存在driverpin)；port(非output)；
designpin(必须是output)。
属 性 值 ： 属 性 值 的 形 式 是 GTP_CLKBUFR 、 GTP_CLKBUFG 、
GTP_CLKBUFX、GTP_BUFGS 和GENERAL。其中GTP_CLKBUFR（Compact
系列不支 持）表示走局 部时钟，GTP_CLKBUFG 表示走全 局时钟，
GTP_CLKBUFX 表示走HCKB（Logos2，Titan2 系列支持），GTP_BUFGS 表示
走USSMBUF（Compact 系列支持），GENERAL 表示不走时钟路线。
描述：用户可以将该attribute设置到designnet、port、designpin。根据设置
的对象，最后都会annotate 到对应的net 和instance(driverpin 所在的instance)上。
===PAGE 93===
2.UCE约束命令介绍
92/126
使用说明：在UCE 的Attribute表格中可以设置该属性。
表现形式：DE 里可看到作用对象连接的是否与所设值一致。
实例：
define_attribute {n:net}{PAP_CLOCK_ASSIGN}{GTP_CLKBUFR}
define_attribute {n:u_top_module.sub_module_net} {PAP_CLOCK_ASSIGN}
{GTP_CLKBUFR}
define_attribute{t:instance.pin}{PAP_CLOCK_ASSIGN}{GTP_CLKBUFG}
define_attribute {p:port} {PAP_CLOCK_ASSIGN}{GENERAL}
2.3.4.3PAP_IO_REGISTER
功能：PAP_IO_REGISTER 属性的作用对象是register，在map 时会根据该
属性的值来判断是否将register 与IOpack 到一起。该属性不支持option-disable
和-comment。
对象：作用对象是可以与IO 相连的register。
属性值：属性值的形式是TRUE 和FALSE。
描述：用户可以将该attribute 设置到register 上，后台都全部设置为port 连
接的buf上。
使用说明：在UCE 中设置PAP_IO_REGISTER 属性时，目前支持对属性对
象和属性值进行检查。
表现形式：DE 里可看到作用对象register 是否与IOpack 到一起。
实例：
define_attribute {i:register} {PAP_IO_REGISTER} {TRUE}
define_attribute {i:u_top_module.sub_module_inst} {PAP_IO_REGISTER}
{TRUE}
2.3.4.4PAP_PLL_FEEDBACK_DELAY
功能：PAP_PLL_FEEDBACK_DELAY 属性的作用对象是PLL 实例，作用
是配置PLL 的反馈端的delay。
===PAGE 94===
2.UCE约束命令介绍
93/126
对象：作用对象是PLL 实例。
属性值：属性值的形式是数字加单位，如：120ns，目前只支持ns。
描述：用户可以将该attribute 设置到PLL 实例上。
使用说明：在UCE 中设置PAP_PLL_FEEDBACK_DELAY属性时，目前仅
logos 系列支持。
表现形式：无。
实例：
define_attribute {i:pll}{PAP_PLL_FEEDBACK_DELAY} {120ns}
2.3.4.5PAP_DONT_TOUCH
功能：PAP_DONT_TOUCH属性的作用对象是GTP类型的inst实例和module
实例，作用是保持该实例在DeviceMap 一步不被改变。
对象：作用对象是GTP 类型的inst实例和module实例。
属性值：属性值的形式是TRUE 和FALSE。
描述：用户可以将该attribute 设置到inst实例上。
使用说明：在UCE 中设置PAP_DONT_TOUCH 属性时，在DeviceMap 一
步该inst将不被优化不被改变。FFpack 的时候无视DNOT_TOUCH属性。
表现形式：DE 里可看到该实例没有被优化掉。
实例：
define_attribute {i:GTP_LUT6}{PAP_DONT_TOUCH}{TRUE}
2.3.4.6PAP_LOC
功能：PAP_LOC 是位置约束，map 时会转化为pcf 中的位置约束命令def_
inst_site。
对象：作用对象通常是一些可以place 到特殊资源(如APM)的一些instance。
属性值：属性值的形式是一个具体的deviceinstance 的名字。
描述：PAP_LOC 属性是通过DB 文件向下传递的，作用对象通常是一些可
以place 到特殊资源的一些instance，在map 的过程中，这个属性会传递给这个
top转化的gop 对象。
===PAGE 95===
2.UCE约束命令介绍
94/126
使用说明：在UCE 中设置PAP_LOC 属性时，支持对属性对象和属性值进
行检查。此命令只在约束文本中编写，界面操作可以在上述“Device 界面操作”
章节查看。
表现形式：在UCE 的Device 界面可以看到初始阶段的约束，最终属性的表
现形式在PCE中可以看到，指定的约束对象会在属性值所指定的位置上被约束。
实例：
define_attribute {i:instance} {PAP_LOC} {APM_134_172}
define_attribute {i:u_top_module.sub_module_inst}{PAP_LOC}
{APM_134_172}
define_attribute {i:instance} {PAP_LOC} {CLMA_5_4:FGA}
表示约束到某个具体的LUT 上。
2.3.4.7PAP_REGION
功能：PAP_REGION 是区域约束属性，dev_map 一步会将逻辑约束文件（.lcf）
里的区域约束转化为物理约束文件（.pcf）中的区域约束命令 def_region 和
def_inst_region。
对象：约束对象是一个库单元（GTP）实例或者是RTL 源码中定义的module
的实例；如果仅仅定义一个区域，则不需要指定约束对象。
属性值：属性值的形式是以region 名字开头，然后加上(x1,x2,y1,y2)格式的
坐标值，即：
region_name(x1,x2,y1,y2)中间允许有空格，这些坐标值表示floorplan 坐标系中位
置（x1,y1）和位置（x2,y2）为对角线点的矩形区域，（x1,y1）表示左下角的坐
标，（x2,y2）表示右上角的坐标，所以要求0<=x1<=x2，0<=y1 <=y2，但
x1,x2,y1,y2 不能同时为0，并且是合法的floorplan 坐标
描述：PAP_REGION 属性是通过DB 文件沿着flow 向下传递的，如果它的
约束对象是一个GTPinstance，那么在dev_map 的过程中，这个属性会传递给这
个由该GTP实例转化成的所有GOP实例；如果约束对象是一个自定义的module
实例，那这个module 实例flatten 后的所有GTPinstance 以及这些GTPinstance
===PAGE 96===
2.UCE约束命令介绍
95/126
在dev_map 时转换成的所有GOPinstance 都会拥有该属性；全局的区域约束采
用先声明后定义的使用方式。
使用说明：在UCE 中设置PAP_REGION 属性时，支持对属性对象和属性值
进行格式和内容方面的合法性检查。此命令只在约束文本中编写，界面操作可以
在上述“Device 界面操作”章节查看。区域约束需要遵循，先声明后使用的原则，
即：先定义区域后使用该区域。
表现形式：属性的约束效果在UCE 的Device 界面或者PCE 中可以看到，
指定的约束对象转换的GOPinstance 会在属性值所指定的区域被约束。
实例：
define_attribute {i:T_GTP_LUT5_4} {PAP_REGION} {region1}
define_global_attribute{PAP_REGION}
{region2(69,78,50,64)[CLMA,CLMS,APM,DRM];}
define_attribute{u_top_module.sub_module}{PAP_REGION}
{region(1,2,3,4)}
2.3.4.8PAP_SITE_PRESERVE
功能：PAP_SITE_PRESERVE会将指定的某个deviceinstance 设置为不可用
（预留），即约束和pnr的时候都不会使用该device。
对象：预留的deviceinstance。
属 性 值 ： 多 个 具 体 的 device instance 的 名 字 ， 形 式 为
{CLMA_6_4;CLMA_6_7}。
描述：PAP_SITE_PRESERVE 是将指定的deviceinstance 设置为不可用。
使用说明：在UCE 中设置PAP_SITE_PRESERVE属性时，支持对属性对象
和属性值进行检查。此命令只在约束文本中编写，界面操作可以在上述“Device
界面操作”章节查看。
表现形式：最终属性的表现形式是在PCE和DE 中该指定的deviceinstance
都不能被使用。
实例：
===PAGE 97===
2.UCE约束命令介绍
96/126
define_global_attribute{PAP_SITE_PRESERVE}{CLMA_6_4;CLMA_6_7}
2.3.4.9PAP_CLOCK_DEDICATED_ROUTE
功能：
用于控制时钟走线。未设置该属性或该属性设置为TRUE 的情况下不允许
时钟走SRB 之间的互连通道；如果希望时钟走SRB 之间的互连通道，需要将
"PAP_CLOCK_DEDICATED_ROUTE"属性设置为FALSE。
若时钟没有布局到专用时钟端口并最终上了时钟网络，PDS 流程运行到
place&route会报错(报错编号为E:Place-0084)，如果将该时钟相关的net 或该net
的驱动pin脚设置该属性为FLASE，则PDS 流程会在place&route 中将报错降级
为CriticalWarning（C:Place-2028）。
对象：outputpin或net 或不指定对象(全局属性)。
属性值：TRUE/FALSE。
描述：PAP_CLOCK_DEDICATED_ROUTE 随DB 向下传递
在place&route阶段中的place 阶段，当用户在做IO 约束的过程中，如果将
clock端口放置到了非专用时钟端口，则place阶段会给出报错提示从而停止flow，
如果用户希望flow 继续运行，则可以将该时钟相关的net 或该net 的驱动pin脚
设置该属性为FALSE，或者直接将全局属性设置为FALSE，之后流程就会将报
错调整为警告，从而继续运行流程而不会停止。需要注意的是，在Place 阶段中，
对net 或者pin 脚设置的单条降级属性在优先级上大于全局属性的降级；
在place&route阶段中的route阶段，全局属性将不起作用，只有对单条net、
pin 设 置 降 级 属 性 ， 才 会 在 详 细 布 线 阶 段 ， 检 测 到 设 置 的
PAP_CLOCK_DEDICATED_ROUTE 属性；
使用说明：在UCE 中设置PAP_CLOCK_DEDICATED_ROUTE 属性时，支
持对属性对象和属性值进行检查。
局部属性：object 为与时钟IO 相连net，或者是output 类型的pin；attribute
为PAP_CLOCK_DEDICATED_ROUTE；value 值为FALSE。
全局属性：object 为空，attribute 为PAP_CLOCK_DEDICATED_ROUTE；
value值为FALSE（全局属性会有将应该报错的error降低级别到criticalwarning，
===PAGE 98===
2.UCE约束命令介绍
97/126
所以需慎用）。
上述两种属性任意一种设置保存后，在PNR 阶段就不会上报时钟端口没有
从clockpad输入上时钟网络的Error，只会报CriticalWarning（例如：C:Place-2028:
GLOBAL_CLOCK: the driver clk_ibuf/opit_1 fixed at IOLHR_16_1008 is
unreasonable.Sub-optimalplacementforaclocksourceandaclockbuffer.）
表现形式：最终属性的表现形式为PDS流程在place&route 阶段不会报错停
止而是以报警告代替。布线可以选择是否走SRB之间的互连通道。
实例：
define_attribute{n:net}{PAP_CLOCK_DEDICATED_ROUTE}{FALSE}
define_attribute{t:pin}{PAP_CLOCK_DEDICATED_ROUTE}{FALSE}
define_global_attribute{PAP_CLOCK_DEDICATED_ROUTE}{FALSE}
2.3.4.10PAP_KEEP_CHAIN
功能：在CarryChain 的instance 上添加属性，控制CarryChain 不折断。
对象：CarryChain 的instance。
属性值：TRUE/FALSE。
描述：假设折断的条件是长度等于200，默认行为是可能会折断：长度小于
等于200 不折断，大于200 折断。参数设置TRUE，所有长度都不折断。
使用说明：在UCE 中设置PAP_KEEP_CHAIN 属性时，支持对属性对象和
属性值进行检查。
实例：
define_attribute{i:T_GTP_LUT2}{PAP_KEEP_CHAIN}{TRUE}
2.3.4.11PAP_ALLOW_RETIMING
具体描述见ADS 用户手册syn_allow_retiming 属性的用法。
===PAGE 99===
2.UCE约束命令介绍
98/126
2.3.4.12PAP_ALLOWED_RESOURCES
具体描述见ADS 用户手册syn_allowed_resources 的用法。
2.3.4.13PAP_DSP_STYLE
具体描述见ADS 用户手册syn_dspstyle 的用法。
2.3.4.14PAP_HIER
具体描述见ADS 用户手册syn_hier的用法。
2.3.4.15PAP_MAX_FANOUT
具体描述见ADS 用户手册syn_maxfan 的用法。
2.3.4.16PAP_MIN_CONTROLSET_SIZE
具体描述见ADS 用户手册syn_reduce_controlset_size的用法。
2.3.4.17PAP_UNCONNECTED_INPUTS
具体描述见ADS 用户手册syn_uncounnected_inputs 的用法。
2.3.5Device 中的I\OTable相关配置
图 2-2I\OTable 表格
（1）UCE 的IOTable中能传递下去的属性
各个系列的器件的UCE 的IOTable中能传递下去的属性包括：
===PAGE 100===
2.UCE约束命令介绍
99/126
属性名 TITAN LOGOS COMPACT TITAN2 LOGOS2
PAP_IO_DIRECTION Y Y Y Y Y
PAP_IO_LOC Y Y Y Y Y
PAP_IO_VCCIO Y Y Y Y Y
PAP_IO_STANDARD Y Y Y Y Y
PAP_IO_DRIVE Y Y Y Y Y
PAP_IO_PMOS_FINGER Y N N N N
PAP_IO_NMOS_FINGER Y N N N N
PAP_IO_SLEW Y Y Y Y Y
PAP_IO_OPEN_DRAIN Y Y Y Y Y
PAP_IO_IN_DELAY Y Y Y Y Y
PAP_IO_OUT_DELAY Y Y Y Y Y
PAP_IO_PULLUP Y Y Y Y Y
PAP_IO_PULLDW Y Y Y Y Y
PAP_IO_KEEPER Y Y Y Y Y
PAP_IO_UNUSED Y Y Y Y Y
PAP_IO_VREF_MODE Y Y Y Y Y
PAP_IO_VREF_MODE_VALUE Y Y Y Y Y
PAP_IO_DDR_TERM_MODE Y Y Y Y Y
PAP_IO_DIFF_IN_TERM_MODE Y Y Y Y Y
PAP_IO_REGISTER Y Y Y Y Y
PAP_IS_VIRTUAL_IO Y Y Y Y Y
PAP_IO_IPT N Y Y Y Y
PAP_IO_CAL_MODE N Y Y N Y
PAP_IO_DDR_RES N Y Y Y Y
PAP_IO_DIFFOUT_DYN_EN N N Y N N
PAP_IO_DIFFIN_DYN_EN N N Y N N
PAP_IO_HYS_DRIVE_MODE Y Y Y N Y
PAP_IO_OFF_CHIP_TERMINATION Y N N Y Y
PAP_IO_CLAMP N N Y N N
表 2-1 属性
这些属性分别将IOTable 中的对应选项值以属性的形式记录在约束文件中
或design 文件中，并通过DB 文件向下传递，在map 后又会将这些属性转化为
pcf文件中的define_port 命令。
实例:
define_attribute{p:GTP_LUT2_Z}{PAP_IO_LOC}{A17}
define_attribute{p:GTP_LUT2_Z}{PAP_IO_VCCIO}{3.3}
===PAGE 101===
2.UCE约束命令介绍
100/126
define_attribute{p:GTP_LUT2_Z}{PAP_IO_STANDARD}{LVCMOS33}
define_attribute{p:GTP_LUT2_Z}{PAP_IO_SLEW}{FAST}
define_attribute{p:GTP_LUT2_Z}{PAP_IO_DRIVE}{4}
define_attribute{p:GTP_LUT2_Z}{PAP_IO_PULLUP}{TRUE}
define_attribute{p:GTP_LUT2_Z}{PAP_IO_OPEN_DRAIN}{OFF}
define_attribute{p:GTP_LUT2_Z}{PAP_IO_REGISTER}{TRUE}
转化为pcf后：
def_port GTP_LUT2_Z LOC=A17 IOSTANDARD=LVCMOS33
VCCIO=3.3PULLUP=TRUE DRIVE=4 SLEW=FAST OPEN_DRAIN=OFF
（2）PAP_IO_REGISTER 属性说明
PAP_IO_REGISTER 属性并不会转化为pcf 约束命令，该属性是用来设置该
port 是否使用IORegister。
（3）PAP_IS_VIRTUAL_IO 属性说明
PAP_IS_VIRTUAL_IO 属性即设置虚拟IO，其相关的功能及使用方法如下：
1）主要功能：在用户设计或移植工程初期阶段，用于评估CLM 资源使用
情况，此阶段不考虑IO 数目和放置限制，故设置虚拟IO。
2）作用对象：只能为IO。
3）约束方式：
支 持 命 令 约 束 。 在 fdc 中 约 束 ， 如 ： define_attribute {p:CLK}
{PAP_IS_VIRTUAL_IO}{TRUE}
支持界面约束。在UCE的IOTable中设置，如：勾选对应管脚的VIRTUAL_IO
项。
4）属性特点：
a. 虚拟IO 不会转化为pcf约束命令，且进入PCE 界面时也不会加载该IO。
b. 虚拟IO 不会参与布局布线。
c. 禁止对虚拟IO 做其他属性设置操作。
d. 只支持PDS的简单PNR 流程，支持DE 打开布局布线结果。
===PAGE 102===
2.UCE约束命令介绍
101/126
e. 不支持MPNR、timing 分析和报告以及位流生成。
（4）在IOTable增加批量操作功能，该功能可以选中特定的列进行批量操作。
多个Port进行批量操作时，可设值为多个Port对应值的交集，如果交集不存在，
那么不能进行批量操作。其中Clear Constraint菜单的功能是清除高亮的约束，
ClearAllConstraint菜单的功能是清除IOTable所有的约束，具体操作如下图所示
图 2-3 具体操作
（5）PG2T390H新增了3个IO约束，分别是PAP_IO_DIFFOUT_CM、
PAP_IO_PREEMP、PAP_IO_OUTPUT_IMPEDANCE。具体作用如下图所示
Parametername Description
PAP_IO_DIFFOUT_CM 差分输出驱动器共模电平控制，包括：0.2V，0.9V，1.2V，1.25V
PAP_IO_PREEMP TX 预加重使能配置，包括：OFF，ON
PAP_IO_OUTPUT_IMPEDANCE
驱动器输出阻抗，包括：27Ω（部分支持），34Ω，40Ω，48Ω，60
Ω，当IO约束到R5/R6/R7BANK上，且IOSTANDARD选择支持该属性的值
时才可设置
表 2-2PAP_IO_PREEMP、PAP_IO_OUTPUT_IMPEDANCE 作用
（6）PG2T390H相同HPIOBANK接口标准兼容规则
1) 输出标准兼容规则
具有相同VCCIO的输出标准可以约束在相同BANK；
例如：LVCMOS15、SSTL15D_I可以约束在相同BANK；
2) 输入标准兼容规则
a. 具有相同VCCIO；
===PAGE 103===
2.UCE约束命令介绍
102/126
b. 输入参考电压相同或是无需参考电压；
如：SSTL15、HSTL_II、LVCMOS15可以约束在相同BANK；
3) 输入和输出标准兼容规则
a. 输入标准和输出标准具有相同VCCIO；
b. 输入标准具有相同参考电压或是无需参考电压；
例如：LVCMOS18输出和HSTL18_I、SSTL18_I、LVSMOS18输入可以约束
在相同BANK；
4) 双向IOB标准兼容规则
满足前面3条兼容规则的可以约束在相同BANK；
例如：LVCMOS12、SSTL12、HSTL12_I、HSUL12D双向标准可以约束在相
同BANK；
5) 其他兼容规则
a.HPIOBANK：LVDS_18输入可以和其他任何输入、输出、双向标准约束
在相同BANK；
b.HRIOBANK：LVDS25、RSDS、PPDS、MINI-LVDS输入可以和其他任何
输入、输出、双向标准约束在相同BANK；
（7）PGT180H的PAP_IO_DRIVE 与PAP_IO_PMOS_FINGER、
PAP_IO_NMOS_FINGER 之间的对应说明
PGT180H 可 以 选 择 设 置 PAP_IO_DRIVE ， 也 可 以 选 择 设 置
PAP_IO_PMOS_FINGER和PAP_IO_NMOS_FINGER，它们之间存在的对应关系
详见下表：
Finger
PGT180H的IOB驱动器P管/N管finger数量对应的电流(mA)
Vccio=3.3V Vccio=2.5V Vccio=1.8V Vccio=1.5V Vccio=1.2V
1 9 7.5 5.2 3.8 2.2
2 18 15 10.4 7.6 4.4
3 27 22.5 15.6 11.4 6.6
===PAGE 104===
2.UCE约束命令介绍
103/126
4 36 30 20.8 15.2 8.8
5 45 37.5 26 19 11.2
6 54 45 31.2 22.8 13.2
表 2-3PGT180H 的IOB 驱动器P管/N 管finger 数量的电流对应表
说明：
1）测试条件为ttcorner。
2）表 中 的 Finger 列 表 示 PAP_IO_PMOS_FINGER 或
PAP_IO_NMOS_FINGER 设置的数值。
2.3.6IPFDC 支持指定子module
仅支持手写fdc，格式：define_current_designcurrent_design_name
当约束文件中设置该命令，后续命令将针对current_design 做约束。重复该
过程，可以切换module。
说明：
1、首次使用需将该命令define_current_design 放置fdc 首行，否则报错。
2、不支持对子module的端口做约束
2.3.7Fdc 约束文件逻辑约束支持通配符
格式：define_attribute{p:men_dq*}{PAP_IO_DIRECTION}{INOUT}
Port 中*匹配的对象支持该属性约束。
2.3.8UCE 属性使用实例
属性的传递可以通过两种方式：
a.通过逻辑约束文件传递
b.在RTL代码中直接编写
2.3.8.1 通过逻辑约束文件传递
在逻辑约束文件中编写命令可以采取两种方式：
通过UCE 中的Attribute和IOTable中编辑生成属性命令。
目前IOtable 默认保存格式是多行单属性格式，格式如下:
define_attribute{p:port_name}{attribute1}{value1}
define_attribute{p:port_name}{attribute2}{value2}
===PAGE 105===
2.UCE约束命令介绍
104/126
……
综合工具仅ADS 同时支持单行多属性格式，可通过手动编辑，格式如下：
define_attribute –attributes {attribute1 value1 attribute2 value2······}
{p:port_name}。
保存规则需注意以下两点：
1、对于IOtable 读取fdc 中单行多属性格式，若有新增、修改属性，按单行
多属性格式保存，保持原用户格式不变。
2、同一port 约束命令同时存在单行多属性格式及多行单属性格式，若有新
增、修改属性，按默认格式多行单属性。
Fdc 中存在的单行多属性需要切换综合工具OEM 使用时，可通过使用转换
工具转行成多行单属性。（转换工具入口->选中约束文件右键-Convert
ConstraintStyle）
b.直接手动编写约束文件
这两种方式生成的命令格式应该符合上面的属性介绍。
2.3.8.2 在RTL代码中直接编写
在RTL代码中写属性命令:
在.v 和vm中描述属性方法是一样的，如下为一段.v 文件部分示例：
modulecase_test(
sclk,
xrst,
wptr,
if_data,
of_data
);
(*PAP_IO_STANDARD="LVCMOS33",PAP_IO_LOC="A1"*)inputsclk;
inputxrst;
input[7:0]wptr;
input[7:0]if_data;
===PAGE 106===
2.UCE约束命令介绍
105/126
output[7:0]of_data;
wire[7:0]of_data;
(*PAP_REGION="reg(1,2,3,4)"*)regcnt2;
在上面的.v 文件中给 input sclk 设置了属性 PAP_IO_STANDARD 和
PAP_IO_LOC 属性，给reg cnt2 设置了PAP_REGION 属性，这里等同于在fdc
约束文件中写属性命令：
define_attribute{p:sclk}{PAP_IO_LOC}{A1}
define_attribute{p:sclk}{PAP_IO_STANDARD}{LVCMOS33}
define_attribute{cnt2}{PAP_REGION}{reg(1,2,3,4)}
在综合工具处理之后会将这些属性传递到约束文件lcf中，对应与其等同的
design 文件中描述部分如下：
(*PAP_IO_STANDARD="LVCMOS33",PAP_IO_LOC="A1"*)inputsclk;
(*PAP_REGION="reg(1,2,3,4)"*) GTP_DFF_ACcnt2(
.Q(cnt2_Z),
.D(cnt2_i_0),
.CLK(sclk_c),
.ACLR(xrst_c_i_0)
);
属 性 最 终 会 跟 随 DB 文 件 传 递 下 来 ， 对 于 属 性 命 名 以 PAP_IO_
（PAP_IO_DIRECTION 和PAP_IO_REGISTER 除外）开始的属性，均会转化存
放在物理约束文件中。
2.4 查询命令
2.4.1get_cells
get_cells 用于返回所有满足条件的cell 的集合。命令格式如下：
get_cells [-hierarchical] [-hscseparator] [-regexp] [-nocase] <patterns>
-hierarchical ：匹配完整层次名，例如 A*C 可以匹配到完整层次名为 A/B/C
的对象。
===PAGE 107===
2.UCE约束命令介绍
106/126
-hscseparator ：hierarchical 分隔符。如果该cell 是hierarchical，那么在书写
名字的时候应该加上module的名字，并且用分隔符隔开，例如，假设分隔符为
‘_’moduleA 中有 cell 名字为 unst，A 被例化为 a，那么 cell 的名字应该写为
a_unst。
-regexp ：表示支持正则表达式而不是简单通配符。
-nocase ：表示不关心pattern 的大小写。
patterns ：instance 的名字。
2.4.2get_nets
get_nets 用于返回所有满足条件的net 的集合。命令格式如下：
get_nets [-hierarchical] [-hscseparator] [-regexp] <patterns>
-hierarchical ：匹配完整层次名，例如 A*C 可以匹配到完整层次名为 A/B/C
的对象。
-hscseparator ：hierarchical 分隔符。如果该net 是hierarchical，那么在书写
名字的时候应该加上module的名字，并且用分隔符隔开，例如，假设分隔符为
‘_’moduleA 中有net 名字为reset，那么net 的名字应该写为A_reset。
-regexp ：表示支持正则表达式而不是简单通配符。
-nocase ：表示不关心pattern 的大小写。
patterns ：net 的名字。
2.4.3get_pins
get_pins 用于返回所有满足条件的pin的集合。命令格式如下：
get_pins [-hierarchical] [-hscseparator] [-regexp] [-nocase]<patterns>
-hierarchical ：匹配完整层次名，例如 A*C 可以匹配到完整层次名为 A/B/C
的对象。
-hscseparator ：hierarchical 分隔符。如果该pin 是hierarchical，那么在书写
名字的时候应该加上module的名字，并且用分隔符隔开，例如，假设分隔符为
‘_’moduleA 中有pin 名字为reset，那么pin 的名字应该写为A_reset
-regexp ：表示支持正则表达式而不是简单通配符。
-nocase ：表示不关心pattern 的大小写。
===PAGE 108===
2.UCE约束命令介绍
107/126
patterns ：pin 的名字。
2.4.4get_clocks
get_clocks 用于返回所有满足条件的clock 的集合。命令格式如下：
get_clocks [-regexp] [-nocase] [-include_generated_clocks] <patterns>
-regexp ：表示支持正则表达式而不是简单通配符。
-nocase ：表示不关心pattern 的大小写。
-include_generated_clocks ：返回的时钟里面包括匹配到的patterns 时钟所驱
动的generatedclocks。
patterns ：clock 的名字。
2.4.5get_ports
get_ports 用于返回所有满足条件的clock 的集合。命令格式如下：
get_ports [-regexp] [-nocase] <patterns>
-regexp ：表示支持正则表达式而不是简单通配符。
-nocase ：表示不关心pattern 的大小写。
patterns ：port 的名字。
2.5 常见约束错误
约束文件中，差分端口放置相反时，ADS 流程synthesize阶段约束检查报错
报错信息：E:ConstraintEditor-0063:Differentialportisnotproperlyplaced.
该规则适用于GTP_INBUFDS、GTP_OUTBUFDS、GTP_IOBUFDS
修改建议，检查差分端口放置是否匹配
===PAGE 109===
2.UCE约束命令介绍
108/126
2.6 通用IO 属性默认值
以下，根据不同器件，对通用的IO 属性的默认值进行说明。当用户通过约
束文件约束了IO，但是没有对该属性进行设置，则后续会根据默认值来进
行赋值。NA表示没有默认值。
2.6.1Compact(PGC2KG)
Direction I/OStandard 默认值
DRIVE SLEW BUS_KEEPER
Input
LVTTL33
NA NA
PULLUP
PCI33
LVCMOS12
LVCMOS15
LVCMOS18
LVCMOS25
LVCMOS33
LVDS
NONE
LVPECL33
LVTTL33D
LVCMOS33D
LVCMOS25D
MLVDS25
BLVDS25
LVCMOS18D
GTL1P0_2V5
VREF
GTL1P0_3V3
Output
LVTTL33
4
SLOW NONE
PCI33
LVCMOS33
LVCMOS25
LVCMOS18
LVCMOS15
LVCMOS12 2
===PAGE 110===
2.UCE约束命令介绍
109/126
LVDS 3.5 NA
LVPECL33
8
SLOW
BLVDS25
MLVDS25
LVTTL33D
LVCMOS33D
4
LVCMOS25D
LVDS25E 8
LVCMOS18D 4
Inout
LVTTL33
4
SLOW
NONE
PCI33
LVCMOS33
LVCMOS25
LVCMOS18
LVCMOS15
LVCMOS12
2
MIPI
LVDS 3.5 NA
LVPECL33 8
SLOW
MLVDS25
12
BLVDS25
LVCMOS33D
4LVCMOS25D
LVTTL33D
LVDS25E 8
LVCMOS18D
4GTL1P0_2V5
GTL1P0_3V3
表 2-4Compact(PGC2KG)
2.6.2Logos(PGL50H)
Direction I/Ostandard
默认值
DRIVE SLEW BUS_KEEPER
Input
LVTTL33
NA NA NONE
PCI33
LVCMOS12
LVCMOS15
LVCMOS18
LVCMOS25
LVCMOS33
===PAGE 111===
2.UCE约束命令介绍
110/126
SSTL25_I
SSTL25_II
SSTL18_I
SSTL18_II
SSTL15_I
SSTL15_II
SSTL15D_I
SSTL15D_II
HSTL18_I
HSTL18_II
HSTL18D_I
HSTL18D_II
HSTL15_I
LVDS25
LVDS33
MINI-LVDS
SUB-LVDS
SSTL25D_I
SSTL25D_II
SSTL18D_I
SSTL18D_II
HSTL15D_I
TMDS
BLVDS
PPDS
RSDS
LVPECL
Output
LVCMOS33
8
SLOW
LVCMOS25
LVCMOS18
LVCMOS15 4
LVCMOS12 2
PCI33 1.5
LVTTL33 8
SSTL25_I 8.1
SSTL25_II 16.2
SSTL18_I 6.7
SSTL18_II 13.4
SSTL15_I 7.5
===PAGE 112===
2.UCE约束命令介绍
111/126
SSTL15_II 8.8
HSTL18_I 8
HSTL18_II 16
HSTL15_I 8
LVDS25
3.5
NA
LVDS33
MINI-LVDS 3
SUB-LVDS 1.5
TMDS 9
BLVDS
16
SLOW
PPDS
RSDS
LVPECL
SSTL25D_I 8.1
SSTL25D_II 16.2
SSTL18D_I 6.7
SSTL18D_II 13.4
SSTL15D_I 7.5
SSTL15D_II 8.8
HSTL18D_I 8
HSTL18D_II 16
HSTL15D_I 8
Inout
LVCMOS33
8
SLOW
LVCMOS25
LVCMOS18
LVCMOS15 4
LVCMOS12 2
LVTTL33 8
PCI33 1.5
SSTL25_I 8.1
SSTL25_II 16.2
SSTL18_I 6.7
SSTL18_II 13.4
SSTL15_I 7.5
SSTL15_II 8.8
HSTL18_I 8
HSTL18_II 16
HSTL15_I 8
LVDS25 3.5 NA
===PAGE 113===
2.UCE约束命令介绍
112/126
LVDS33
MINI-LVDS 3
SUB-LVDS 1.5
SLVS 2
TMDS 9
BLVDS
16
SLOW
PPDS
LVPECL
RSDS
SSTL25D_I 8.1
SSTL25D_II 16.2
SSTL18D_I 6.7
SSTL18D_II 13.4
SSTL15D_I 7.5
SSTL15D_II 8.8
HSTL18D_I 8
HSTL18D_II 16
HSTL15D_I 8
表 2-5Logos(PGL50H)
2.6.3Logos2(PG2L100H)
Direction I/Ostandard 默认值
DRIVE SLEW BUS_KEEPER
Input
LVTTL33
NA NA
NONE
PCI33
LVCMOS12
LVCMOS15
LVCMOS18
LVCMOS25
LVCMOS33
SSTL18D_I
UNUSED
SSTL18D_II
SSTL18_I
SSTL18_II
SSTL15_I
SSTL15_II
HSTL15_II
HSTL15D_I
===PAGE 114===
2.UCE约束命令介绍
113/126
HSTL18_I
HSTL18_II
HSTL18D_I
HSTL18D_II
HSTL15_I
HSTL15D_II
SSTL135_I
SSTL135_II
SSTL135D_I
SSTL135D_II
HSUL12
HSUL12D
SSTL15D_I
SSTL15D_II
LPDDRD
LPDDR
LVDS25
NONE
MINI-LVDS
BLVDS
PPDS
RSDS
TMDS
Output
LVPECL
4
FAST
LVCMOS33
LVCMOS25
LVCMOS18
LVCMOS15
LVCMOS12
LVTTL33
PCI33 0.1
LPDDR 8
UNUSED
SSTL18_I 13.4
SSTL18_II 8.9
SSTL15_I
13
SSTL15_II
HSTL18_I 8
HSTL18_II 16
HSTL15_I 8
HSTL15_II 16
===PAGE 115===
2.UCE约束命令介绍
114/126
SSTL135_I 8.9
SSTL135_II 13
HSUL12 0.1
LVCMOS12D 4
BLVDS 8
LVDS25 3.5
NA
MINI-LVDS 4.5
TMDS 5
RSDS 3.5
PPDS 2.5
LPDDRD 0.1
FAST
SSTL18D_I 8
SSTL18D_II 13.4
SSTL15D_I 8.9
SSTL15D_II 13
HSTL18D_I 8
HSTL18D_II 16
HSTL15D_I 8
HSTL15D_II 16
SSTL135D_I 8.9
SSTL135D_II 13
HSUL12D 0.1
Inout
LVCMOS33
4
NONE
LVCMOS25
LVCMOS18
LVCMOS15
LVCMOS12
LVTTL33
PCI33 4
LPDDR 0.1
UNUSED
SSTL18_I 8
SSTL18_II 13.4
SSTL15_I 8.9
SSTL15_II 13
HSTL18_I 8
HSTL18_II 16
HSTL15_I 8
HSTL15_II 16
SSTL135_I 8.9
===PAGE 116===
2.UCE约束命令介绍
115/126
SSTL135_II 13
HSUL12 0.1
LVDS25 3.5
NA
NONE
MINI-LVDS 4.5
TMDS 5
BLVDS 8
FASTRSDS 3.5
PPDS 2.5
MIPI 4 NA
LPDDRD 0.1
FAST
UNUSED
SSTL18D_I 8
SSTL18D_II 13.4
SSTL15D_I 8.9
SSTL15D_II 13
HSTL18D_I 8
HSTL18D_II 16
HSTL15D_I 8
HSTL15D_II 16
SSTL135D_I 8.9
SSTL135D_II 13
HSUL12D 0.1
Inout LVCMOS12D 4 NONE
表 2-6Logos2(PG2L100H)
2.6.4Titan(PGT180H)
Direction I/Ostandard
默认值
DRIVE SLEW BUS_KEEPER
Input
LVTTL33
NA NA UNUSED
PCI33
LVCMOS12
LVCMOS15
LVCMOS18
LVCMOS25
LVCMOS33
SSTL25_I
SSTL25_II
SSTL18_I
===PAGE 117===
2.UCE约束命令介绍
116/126
SSTL18_II
SSTL15_I
HSTL18_I
HSTL18_II
HSTL15_I
HSTL15_II
LVDS
SSTL25D
SSTL18D
SSTL15D
HSTL18D
HSTL15D
Output
LVCMOS33
4
SLOW
UNUSED
LVCMOS25
LVCMOS18
LVCMOS15
LVCMOS12 2
PCI33 1.5
LVTTL33 4
SSTL25_I 8.1
SSTL25_II 16.2
SSTL18_I 6.7
SSTL18_II 13.4
SSTL15_I 7.5
SSTL15_II 8.8
HSTL18_I 8
HSTL18_II 16
HSTL15_I 8
LVDS 3.5
NARSDS
2
PPDS
LVDS25E
4
SLOW
RSDS25E
PPDS25E
LVPECL33E
SSTL25D_I 8.1
SSTL25D_II 16.2
SSTL18D_I 6.7
SSTL18D_II 13.4
===PAGE 118===
2.UCE约束命令介绍
117/126
SSTL15D_I 7.5
SSTL15D_II 8.8
HSTL18D_I 8
HSTL18D_II 16
HSTL15D_I 8
Inout
LVCMOS33
4
LVCMOS25
LVCMOS18
LVCMOS15
LVCMOS12 2
LVTTL33 4
PCI33 1.5
SSTL25_I 8.1
SSTL25_II 16.2
SSTL18_I 6.7
SSTL18_II 13.4
SSTL15_I 7.5
SSTL15_II 8.8
HSTL18_I 8
HSTL18_II 16
HSTL15_I 8
LVDS 3.5
NARSDS
2
PPDS
SSTL25D_I 8.1
SLOW
SSTL25D_II 16.2
SSTL18D_I 6.7
SSTL18D_II 13.4
SSTL15D_I 7.5
SSTL15D_II 8.8
HSTL18D_I 8
HSTL18D_II 16
HSTL15D_I 8
表 2-7Titan(PGT180H)
2.6.5Titan2(PG2T390H)
#hrio
===PAGE 119===
2.UCE约束命令介绍
118/126
Direction I/Ostandard
默认值
DRIVE SLEW BUS_KEEPER
Input
LVTTL33
NA NA
NONE
PCI33
LVCMOS12
LVCMOS15
LVCMOS18
LVCMOS25
LVCMOS33
LPDDR
UNUSED
LPDDRD
SSTL18_I
SSTL18_II
SSTL15_I
SSTL15_II
SSTL18D_I
SSTL18D_II
HSTL18_I
HSTL18_II
HSTL18D_I
HSTL18D_II
HSTL15_I
HSTL15_II
HSTL15D_I
HSTL15D_II
SSTL135_I
SSTL135_II
SSTL135D_I
SSTL135D_II
HSUL12
HSUL12D
SSTL15D_I
SSTL15D_II
LVDS25
NONE
MINI-LVDS
BLVDS
PPDS
RSDS
===PAGE 120===
2.UCE约束命令介绍
119/126
TMDS
Output
LVCMOS33
4
SLOW
NONE
LVCMOS25
LVCMOS18
LVCMOS15
LVCMOS12
LVTTL33
PCI33 1.5
LPDDR 0.1
UNUSED
SSTL18_I 8
SSTL18_II 13.4
SSTL15_I 8.9
SSTL15_II 13
HSTL18_I 8
HSTL18_II 16
HSTL15_I 8
HSTL15_II 16
SSTL135_I 8.9
SSTL135_II 13
HSUL12 0.1
LVDS25 3.5
NAMINI-LVDS 4.5
TMDS 5
BLVDS 8 SLOW
RSDS 4
NA
PPDS 3
LPDDRD 0.1
SLOW
SSTL18D_I 8
SSTL18D_II 13.4
SSTL15D_I 8.9
SSTL15D_II 13
HSTL18D_I 8
HSTL18D_II 16
HSTL15D_I 8
HSTL15D_II 16
SSTL135D_I 8.9
SSTL135D_II 13
HSUL12D 0.1
Inout LVCMOS33 4 NONE
===PAGE 121===
2.UCE约束命令介绍
120/126
LVCMOS25
LVCMOS18
LVCMOS15
LVCMOS12
LVTTL33
PCI33 1.5
LPDDR 0.1
UNUSED
SSTL18_I 8
SSTL18_II 13.4
SSTL15_I 8.9
SSTL15_II 13
HSTL18_I 8
HSTL18_II 16
HSTL15_I 8
HSTL15_II 16
SSTL135_I 8.9
SSTL135_II 13
HSUL12 0.1
LVDS25 3.5
NA
NONE
MINI-LVDS 4.5
TMDS 5
BLVDS 8
SLOWRSDS 4
PPDS 3
MIPI 4 NA
LPDDRD 0.1
SLOW UNUSED
SSTL18D_I 8
SSTL18D_II 13.4
SSTL15D_I 8.9
SSTL15D_II 13
HSTL18D_I 8
HSTL18D_II 16
HSTL15D_I 8
HSTL15D_II 16
SSTL135D_I 8.9
SSTL135D_II 13
HSUL12D 0.1
表 2-8Titan2(PG2T390H)hrio
===PAGE 122===
2.UCE约束命令介绍
121/126
#hpio
Direction I/Ostandard
默认值
DRIVE SLEW BUS_KEEPER
Input
LVCMOS12
NA NA
NONELVCMOS15
LVCMOS18
SSTL15_I
UNUSED
SSTL18_I
SSTL18D_I
HSTL18_I
SSTL18_II
SSTL15_II
SSTL18D_II
HSTL18_II
HSTL18D_I
HSTL18D_II
HSTL15_I
HSTL15_II
HSTL15D_I
HSTL15D_II
SSTL135_I
SSTL135_II
SSTL135D_I
SSTL135D_II
HSUL12
HSUL12D
SSTL15D_I
SSTL15D_II
===PAGE 123===
2.UCE约束命令介绍
122/126
SSTL12
HSTL12_I
SSTL12D
HSTL12D_I
POD12
POD12D
SSTL18_I_CAL
SSTL18_II_CAL
SSTL15_I_CAL
SSTL15_II_CAL
SSTL18D_I_CAL
SSTL18D_II_CAL
HSTL18_I_CAL
HSTL18_II_CAL
HSTL18D_I_CAL
HSTL18D_II_CAL
HSTL15_I_CAL
HSTL15_II_CAL
HSTL15D_I_CAL
HSTL15D_II_CAL
SSTL135_I_CAL
SSTL135_II_CAL
SSTL135D_I_CAL
SSTL135D_II_CA
HSUL12_CAL
HSUL12D_CAL
SSTL15D_I_CAL
SSTL15D_II_CAL
SSTL12_CAL
HSTL12_I_CAL
SSTL12D_CAL
HSTL12D_I_CAL
POD12_CAL
POD12D_CAL
LVCAL_15
LVCAL_18
HSLVCAL_15
HSLVCAL_18
LVDS_18 NONE
===PAGE 124===
2.UCE约束命令介绍
123/126
Output
LVCMOS18 12
SLOW
LVCMOS15
2
LVCMOS12
SSTL18_I 8
UNUSED
SSTL18_II 13.4
SSTL15_I 8.9
SSTL15_II 13
HSTL18_I 8
HSTL18_II 16
HSTL15_I 8
HSTL15_II 16
SSTL135_I 8.9
SSTL135_II 13
HSUL12 0.1
HSTL12_I 6.3
SSTL12 14.25
POD12 NA
LVDS_18 3.5 NA
SSTL18D_I 8
SLOW
SSTL18D_II 13.4
SSTL15D_I 8.9
SSTL15D_II 13
HSTL18D_I 8
HSTL18D_II 16
HSTL15D_I 8
HSTL15D_II 16
SSTL135D_I 8.9
SSTL135D_II 13
HSUL12D 0.1
HSTL12D_I 6.3
SSTL12D 14.25
POD12D NA
Inout
LVCMOS18 12
NONELVCMOS15
2
LVCMOS12
SSTL18_I 8
UNUSED
SSTL18_II 13.4
SSTL15_I 8.9
SSTL15_II 13
===PAGE 125===
2.UCE约束命令介绍
124/126
HSTL18_I 8
HSTL18_II 16
HSTL15_I 8
HSTL15_II 16
SSTL135_I 8.9
SSTL135_II 13
HSTL12_I 6.3
SSTL12 14.25
POD12 NA
HSUL12 0.1
MIPI 2
NA NONE
LVDS_18 3.5
SSTL18D_I 8
SLOW
UNUSED
SSTL18D_II 13.4
SSTL15D_I 8.9
SSTL15D_II 13
HSTL18D_I 8
HSTL18D_II 16
HSTL15D_I 8
HSTL15D_II 16
SSTL135D_I 8.9
SSTL135D_II 13
HSUL12D 0.1
HSTL12D_I 6.3
SSTL12D 14.25
POD12D
NA
Output
LVCAL_18
NONE
LVCAL_15
SSTL18_I_CAL
UNUSED
SSTL18_II_CAL
SSTL15_I_CAL
SSTL15_II_CAL
HSTL18_I_CAL
HSTL18_II_CAL
HSTL15_I_CAL
HSTL15_II_CAL
SSTL135_I_CAL
SSTL135_II_CAL
HSUL12_CAL
===PAGE 126===
2.UCE约束命令介绍
125/126
HSTL12_I_CAL
SSTL12_CAL
POD12_CAL
HSLVCAL_18
NONE
HSLVCAL_15
SSTL18D_I_CAL
UNUSED
SSTL18D_II_CAL
SSTL15D_I_CAL
SSTL15D_II_CAL
HSTL18D_I_CAL
HSTL18D_II_CAL
HSTL15D_I_CAL
HSTL15D_II_CAL
SSTL135D_I_CAL
SSTL135D_II_CA
HSUL12D_CAL
HSTL12D_I_CAL
SSTL12D_CAL
POD12D_CAL
Inout
LVCAL_18
NONE
LVCAL_15
HSLVCAL_18
HSLVCAL_15
SSTL18_I_CAL
UNUSED
SSTL18_II_CAL
SSTL15_I_CAL
SSTL15_II_CAL
HSTL18_I_CAL
HSTL18_II_CAL
HSTL15_I_CAL
HSTL15_II_CAL
SSTL135_I_CAL
SSTL135_II_CAL
HSTL12_I_CAL
SSTL12_CAL
POD12_CAL
HSUL12_CAL
SSTL18D_I_CAL
SSTL18D_II_CAL
===PAGE 127===
2.UCE约束命令介绍
126/126
SSTL15D_I_CAL
SSTL15D_II_CAL
HSTL18D_I_CAL
HSTL18D_II_CAL
HSTL15D_I_CAL
HSTL15D_II_CAL
SSTL135D_I_CAL
SSTL135D_II_CA
HSTL12D_I_CAL
SSTL12D_CAL
POD12D_CAL
HSUL12D_CAL
表 2-9Titan2(PG2T390H)hpio
