1979711854/riscv-cpu-fpga/doc/reports/2026-10-17_qa_compliance.md

# 赛题一答疑对照 —— 我们的项目合规性核查（2026-10-17）

> 来源：腾讯文档《2026FPGA大赛紫光同创杯答疑表》
> `https://docs.qq.com/sheet/DRUdIa2ZkSmZpbk9r?tab=BB08J2`
> 取数时间 2026-10-17 15:30，表格最后保存时间 2026-10-17 15:13。
> 表格共 198 行，赛题一（CPU 设计）相关约 40 余条；其中多条官方**尚未答复**，
> 本文用「未答」显式标出，**不得把未答条目当成已合规**。
>
> 对照对象：主线仓 `D:\riscv-cpu-fpga_merged`，分支 `dualissue`，
> 交付跑分档 `c6af65be`（rev1027）：85.0051 MHz、CoreMark **391.66 经典分 / 4.6064 主分**、
> LUT 7,767 / FF 3,691 / DRM 101.5、CPU 域 **+0.277 ns / 0 失败端点 / Fmax 87.0549 MHz**。
> 演示档 `5909a2d0`：同一份 `rtl/**` + RT-Thread 五子棋固件。

---

## 1. 结论

**大方向符合，但有 1 条硬性不符、1 条呈现风险、2 条不得误报。**

| # | 事项 | 判定 |
|---|---|---|
| 1 | 「跑分和应用必须是同一个 bit 流」 | **[OK] 已解决**（2026-10-17 18:54 板上双路径实测，`b45941d6`，见 §3.1.2） |
| 2 | 「时序违约不被接受」 | **[OK] CPU 域 +0.304 / 0 失败端点；`Design Summary: All Constraints Met`**（跨域伪影在该布局上未出现，仍需备说明） |
| 3 | 高阶任务①「总线突发传输效率」 | **[X] 没做** —— 只有片上 BRAM，没有 DDR3/AXI 突发，不得声称完成 |
| 4 | 初赛提交物要演示视频 | **[X] 缺** —— 有日志/ILA/HDMI 实拍证据，缺完整录像 |

其余条目（应用优先、纯逻辑、资源同等功能对比、板卡范围、AI 非强制等）均符合，
详见 §2。官方未答条目见 §5。

---

## 2. 赛题一答疑逐条对照

> 问答按表格内容配对；原表部分行只有问题、没有答复（即「未答」）。

| 答疑要点 | 我们的情况 | 判定 |
|---|---|---|
| 报告要有**资源使用说明、时序说明、CPU 结构框架**；整体基于应用场景，综合考虑 CoreMark 等 | `doc/reports/2026-10-16_paper_v1.md` 有 SoC 框图、地址表、资源/时序 | [OK] |
| **先有应用场景能力，再同步考虑 CPU 性能**；不接受仅针对 CoreMark 的跑分优化 | 有 RT-Thread + 五子棋 + HDMI 完整应用；CPU 优化均为通用微架构 | [OK] 但报告叙事需按此顺序 |
| 指令/数据存储可以只用 DRAM，没有限制 | 我们用片上 BRAM，更优 | [OK] |
| 硬件加速可以支持 | PPU / 视频子系统为自研逻辑加速 | [OK] |
| **时序违约一律不被接受** | CPU 域 +0.277 ns；跨域伪影见 §3.2 | [!] |
| AI 加速不是必须，AI 只是推荐方向，可选更好的应用场景 | 不做 AI，做五子棋/图形显示 | [OK] |
| **不能使用硬核 ARM / NPU**；可用软 ARM 和自研纯逻辑 | HDMI 由 `rtl/video/` 的 TMDS + PPU 实现，**不经过板载 RK3568**；CPU 纯逻辑 | [OK] 报告应写明这句 |
| 资源使用量在**同等功能**下对比，功能更全不因此扣分 | BTB/RAS、异常/中断、可选 I/D Cache 都是可列出的功能集 | [OK] 可主动引用 |
| 跑分时可以关闭外设 | 跑分时视频逻辑空闲即可，无需真关电路 | [OK]（但与「同一 bit 流」合并看，见 §3.1） |
| 推荐板卡 50k~200k；200k mini 可用；非推荐板卡要清晰说明资源 | 本地盘古 2L200H 属 200k 档 | [OK，需确认型号] |
| 初赛提交：设计文档、设计代码、演示 PPT、演示视频一整套 | 文档/代码/板上日志齐全 | [X] 缺视频 |
| 不能只停留在仿真上 | 有 UART 日志、ILA 波形、HDMI 实拍 | [OK] 但仍应补视频 |
| 同一应用下再比跑分；资源量在同等功能下比较 | 跑分档与演示档同一份 `rtl/**` | [OK] |
| 用 BRAM 时 i-cache 收益问题（官方未答） | 实测无 Cache 85 MHz / 391.66，带 Cache 76.5 MHz / 325.96 | 有数据可答 |
| **跑分和应用必须在同一个 bit 流**（第 53 问，答「同一个」） | 现为两颗位流 | **[X] 见 §3.1** |
| 评审顺序：场景特性指标 → 同等指标下比资源/时序 → 同级再比 CoreMark | 与我们的报告结构可对齐 | [OK] 报告顺序需调整 |

---

## 3. 必须处理的四条

### 3.1 [重点] 「跑分和应用必须是同一个 bit 流」—— 目前不符

答疑第 53 问：

> 问：跑分和应用的展示，是在同一个 bit 流文件中？还是跑分时可以把应用相关电路关闭，
> 两部分分别跑两个 bit 流出来？
> 答：**同一个。**

同时第 25 问答「跑分时可以关闭外设吗」→「可以」。两者如何统一，已有选手追问
（「是否指同一个比特流文件、运行时通过软件关闭应用相关电路；CoreMark/LUT 的 LUT
统计范围是 CPU Core、CPU+Cache 还是完整 SoC」），**官方尚未答复**。

我们的现状：

| 档位 | 位流 | 固件 | 说明 |
|---|---|---|---|
| 跑分 | `c6af65be` | CoreMark | 391.66 / 4.6064 |
| 演示 | `5909a2d0` | RT-Thread 五子棋 | HDMI + 按键 |

两者是**同一份 `rtl/**`、不同 `mem.hex` 与 `DEBUG_LED`**，但物理上是两颗 `.sbit`。
按第 53 问的字面答复，这**不符合**；按第 25 问的解释空间，可以争辩「应用电路仍在同一
设计里，只是运行不同固件」，但这属于赌官方未答的澄清，不建议。

**修法：扩到 128KB，做单一位流 + 运行时选择。**
一颗位流里同时装下 CoreMark 和 RT-Thread 五子棋两个程序，复位后由按键/串口菜单选择
（或 0 级 boot selector 跳转）。跑分时只运行 CoreMark（应用线程不调度），应用时只跑五子棋。
这样既满足「同一个 bit」，也不牺牲跑分。核算见 §4。

#### 3.1.2 已落地（2026-10-17，**板上实测**）

| 项 | 值 |
|---|---|
| 位流 | `pds/RV32I_1/generate_bitstream/cpu_top_board.sbit`，md5 **`b45941d6`**，2026-10-17 18:11 |
| 镜像 | 一份 `mem.hex`，19,710 字 / 39,420 行 = **boot selector 17 + CoreMark 8,552 + RT-Thread 11,141** |
| 选路 | 复位后 `boot.S` 读 GPIO 的 **key[2]（SW6，低有效）**：按住 → `0x1000`（CoreMark），松开 → `0x10000`（RT-Thread） |
| 时序 | CPU 域 **+0.304 ns / 0 失败端点（21,135）**，Fmax 78.3269，**All Constraints Met** |
| 资源 | LUT 7,740 / FF 3,692 / DRM 165.5（40%）—— **与单跑 CoreMark 的 `6074c89c` 逐项相同** |
| 板上 | 默认复位：banner → `[boot] heap = 4840` → render/ai 线程 → `[hb] alive`（连续 3 次）；<br>按住 SW6 + SW3：`Total ticks 846,440,591` / 11.06 s / 四 CRC `e9f5 e714 1fd7 8e3a` / `Correct operation validated` |
| 日志 | `doc/board/uart_20261017_185444.txt` |

⇒ **第 53 问从"设计意图"变成"板上可复现的事实"。** 报告口径：
「同一颗位流、同一颗 CPU，运行时二选一；跑分时 RT-Thread 不启动、HDMI 无应用负载。」
（对应 §3.1.1 对第 25 问"跑分时可关外设"的保守解释：关的是应用，不是另做一颗流。）

> [!] 顺序约束：这个决定必须**先于 ILA 抓波形**。`.fic` 与 `.sbit` 必须来自同一次综合，
> RTL 一改（14→15 位地址），91 根探针的通道映射全部作废。

#### 3.1.1 「跑分时可以关闭外设」怎么理解

官方对第 25 问只答了「可以」，**没有说明是"运行时软件关闭"还是"另综合一颗不含应用外设的位流"**。
已有选手按这个歧义追问（同一份追问里还问了 LUT 统计范围），**官方未答**。

保守解释（也是我们应采用的口径）：

- **同一颗位流**，跑分时让应用相关外设/程序**不工作**，而不是另出一颗精简位流。
- CoreMark 自身必需的 **UART（打印结果）和定时器（`0xFFF4` 周期计数器）不能关**。
  所谓「关闭外设」指的是五子棋/视频这类应用外设，不是把跑分打印也关掉。
- 对我们的 128KB 菜单方案：选 CoreMark ⇒ RT-Thread 不启动、render/AI 线程根本不存在、
  HDMI 无输出。视频逻辑即使仍被时钟驱动，也不抢取指/访存周期，**CoreMark 周期数与今天一致**。
  不需要真的做时钟门控（门控还要改 RTL/约束，收益为零）。
- **不要**为跑分另做一颗「删掉视频逻辑」的位流：
  1. 会落入第 53 问禁止的「两个 bit 流」读法；
  2. LUT 统计范围官方未答（见 §6），不能靠删应用逻辑去抬 `CoreMark/LUTs`；
  3. 第 54 问也明确「资源使用量在同等功能下对比」，功能集应完整呈现。

### 3.2 [重点] 时序报告的呈现风险

CPU 域是过的：**+0.277 ns / 0 失败端点 / Fmax 87.0549 MHz**（rev1027，钉 `gplace_seed 5`）。
但跨域 `CPU→pix_clk` 有 **−1.074 ns / 21 端点**，导致 PDS 的 Design Summary 显示
`Some Constraints Violated`。

我们已经查清这是 **0 级逻辑的同步器 STA 建模假象**（两条路径纯走线，STA 按 pix_clk
周期 39.215 ns 去卡 12+9 位同步器），且 `.fdc` 四种写法全部无效（见
`2026-10-12_session_state.md` §15，其中两种还会让综合中止）。

但评委如果只看汇总数字，会直接判「时序违例」。应对：

- 提交材料明确给出 **CPU 域 path group** 的 WNS / Fmax / 失败端点数；
- 附一页说明这 21 条是 CDC 同步器的建模假象，不是功能路径；
- 不要只丢一份 `multiseed_result.csv`（它的 `Setup(Slow)` 列恰恰是全设计最差 = 这个伪影，
  PDS 选种也会因此挑错布局，见 `2026-10-16_handover_p3_6.md`）。

### 3.3 [X] 高阶任务①的「总线突发」不能声称完成

赛题高阶①包含「存储优化 + 总线突发传输效率」。我们只有单周期片上 BRAM，
有可选 I/D Cache 探索，但**没有 DDR3/AXI 总线突发**。
答疑里「用厂商 DDR3 控制器 IP 的原生突发接口是否满足」这一条**官方未答**。
报告只能写「存储系统做了 Cache 探索」，不能写「完成总线突发优化」。

### 3.4 [X] 演示视频 / 照片缺失

已有 `doc/board/` 的串口日志、ILA 波形、HDMI 实拍证据，但缺一段完整演示录像。
答疑明确「不能只停留在仿真上」、提交物要「演示视频」。这是低成本高收益项。

---

## 4. CoreMark 与应用程序「一起跑」的性能影响

### 4.1 结论

**「同一个 bit 流」不等于「同时调度」**。按推荐做法（同一镜像、运行时二选一），
CoreMark 分数**不会大幅下降**；真正并发调度才会明显下降。

### 4.2 三种跑法

| 跑法 | CoreMark 影响 | 说明 |
|---|---|---|
| **A. 同一镜像，复位菜单二选一（推荐）** | **≈0** | 跑 CoreMark 时 RT-Thread 根本不启动；与今天裸机跑 CoreMark 完全一致。唯一变量是 128KB 改动可能带来的 Fmax 变化，需实测 |
| B. CoreMark 作为 RT-Thread 线程，其他线程挂起 | 约 **−0.2% ~ −1%** | CoreMark 计时源是自由跑周期计数器 `0xFFF4`（`core_portme.c`），tick 中断每 1 ms 一次（`RT_TICK_PER_SECOND=1000`，85 MHz 下 85,005 周期/次）。11.7 s 约 11,700 次 tick，ISR 开销全部计入 ticks |
| C. CoreMark 与五子棋 render/AI 线程**真并发** | **明显下降，接近按 CPU 份额打折** | 计数器计的是墙钟周期，被别的线程占用的周期全部算进 CoreMark 的 `Total ticks`。两个等高优先级线程对半 → 分数约腰斩；AI 搜索占空比越高，掉得越多。单口 BRAM 的取指/访存/视频争用还会再放大 |

### 4.3 答辩与演示建议

- 演示视频用 **A**：开机菜单 → 选 CoreMark，串口打出 391.66（约 11.7 s）→ 复位 → 选五子棋，
  接 HDMI 下完一局。旁白强调「**同一颗 bit 流、同一颗 CPU**」。
- 如果一定要在游戏画面里出现分数，显示**已跑出的存档分数**，不要让 CoreMark 与游戏并发。
- 不要把 C 的分数当成「加了应用后的 CoreMark 分数」对外报 —— 那不是同一测评条件，
  且与答疑「同等应用下看跑分」的口径不符。

---

## 5. 128KB 是否必须 —— 体积核算

### 5.1 实测段大小（2026-10-17，`riscv-none-elf-size -A`）

| 程序 | .text.init | .text | .rodata | .data | .bss | mem.hex 镜像 | 含 .bss 常驻 |
|---|---:|---:|---:|---:|---:|---:|---:|
| CoreMark | 3,356 | 28,188 | 2,640 | 24 | 2,020 | **34,208** | 36,228 |
| RT-Thread 五子棋（T6） | 52 | 31,140 | 12,673 | 188 | 10,696 | **≈44,056** | **54,749** |
| 合计 | | | | | | **78,264** | **90,977** |

- 当前 64KB 存储器的程序区是 `0x1000~0x10000`，可用 **61,440 B**。
- **即使两份 `.bss`/栈不同时存在（运行期复用），78,264 B 仍超出 61,440 B 约 16.8 KB。**
- 128KB 下程序区 `0x1000~0x20000` = **126,976 B**：
  - 按 mem.hex 镜像 78,264 B，余 **48,712 B**；
  - 按含 `.bss` 的 90,977 B，余 **35,999 B**。
  都够。

### 5.2 结论

**如果要求「一颗 bit 流里同时装下两个完整程序」，128KB 是必须的；64KB 装不下。**

赛题本身没有规定存储容量，强制项是答疑第 53 问的「同一个 bit 流」。绕开 128KB 的替代路径：

| 替代 | 是否可行 | 代价 |
|---|---|---|
| 只用裸机五子棋 + CoreMark | 体积 25.1 + 34.2 = 59.3 KB，名义上塞得下 | 只剩约 2 KB 栈，AI 递归要用栈 ⇒ 实际不可行；且丢掉 RT-Thread 应用分 |
| 大幅裁剪 RT-Thread / CoreMark | 需砍约 17 KB 代码/rodata | 风险高、要重写移植层，不比扩存储便宜 |
| 外存（SPI Flash / DDR）加载第二个程序 | 板上无现成方案 | DDR 控制器 / Flash 驱动工作量大，且引入启动延迟 |
| 维持两颗位流，赌未答的澄清 | 不合规风险自负 | 0 成本，但可能被判不符合 |

### 5.3 代价与顺序

128KB 不是免费的：

1. RTL：`core.v` 的 `imem_addr` / `imem_addr2` / `ld_addr` 14→15 位，
   `mem_bus.v`、`unified_mem.v`、`sim/mem_model.vh` 同步改。
   **`imem_addr2` 在关键路径上**（P3.5 专门修过），改完必须重跑时序。
2. 内存映射与链接脚本：`addr_map.vh` / `addr_map.h`、`scripts/rtthread/bsp/link.ld`、
   `scripts/demo/link.ld`、`scripts/coremark_port/link.ld`。
3. 全套回归：riscv-tests 49/1/0、own_tests、CoreMark 四 CRC、RT-Thread 四配置。
4. **重扫 `gplace_seed`**：净表一变，钉住的 seed 5 余量（+0.277 ns）作废。
   A1 的教训：LUT +122 就把 +0.277 打成 −0.156。
5. 重出一颗合并位流、板上重验、**然后**才能抓 ILA。

估计 1.5~2 天。**决定必须在 ILA 之前做。**

---

## 6. 官方未答条目（不确定性清单）

以下条目截至 2026-10-17 15:13 **没有官方答复**，相关判断不能当合规依据：

- CoreMark/LUT 的 **LUT 统计范围**（CPU Core / CPU+Cache / 整 SoC）；
- 最高工作频率是**上板验证**还是 PDS 推算；
- 用 BRAM 是否可以不使用 I-Cache；
- 高阶任务①「总线突发」的评定口径、厂商 DDR3 原生突发是否算；
- 高阶任务③选「图形加速」时是否仍需「边缘 AI 加速单元」表述；
- 多核是否允许、RV64 是否允许、AI 辅助编码是否加分；
- 非推荐板卡的资源证明细则（只给了原则）。

我们的答辩准备：

- LUT 同时准备「全设计」与「CPU 域」两个口径；
- 主频用**板上实测 + PDS 报告**双口径（我们已满足）；
- BRAM/i-Cache 用现有实测数据回答（无 Cache 85 MHz / 391.66 vs 带 Cache 76.5 MHz / 325.96）；
- 高阶①②③按实际完成度写，不碰未答条目的解释空间。

---

## 7. 行动清单

| 优先级 | 动作 | 依据 |
|---|---|---|
| P0 | 决定并执行 128KB 扩展，做单一位流 + 运行时选择 | 答疑第 53 问 |
| P0 | 128KB 完成后重扫 seed、重出位流、再抓 ILA | `.fic`/`.sbit` 同源约束 |
| P1 | 报告结构改为「场景指标 → 资源/时序 → CoreMark」 | 答疑第 54 问（评审顺序） |
| P1 | 时序页单列 CPU 域 WNS/Fmax/失败端点 + 跨域伪影说明 | 答疑第 3/4 问 |
| P1 | 补演示视频：同一颗位流先跑 CoreMark 再下五子棋 | 答疑「不能只停留仿真」 |
| P2 | 高阶①按「Cache 探索」写，不写「总线突发完成」 | 答疑未答 + 实际未做 |
| P2 | 板卡型号与推荐清单核对；非推荐则备资源对比说明 | 答疑第 54 问第 2 条 |

---

## 8. 决策记录与执行计划（2026-10-17 定）

### 8.1 已定决策

| # | 决策 | 说明 |
|---|---|---|
| D1 | **采用「同一颗位流 + 运行时选择」**，跑分时不启动应用 | 128KB 镜像内同时驻留 CoreMark 与 RT-Thread 五子棋；复位后由按键/串口菜单二选一。跑 CoreMark 时 RT-Thread 不启动、render/AI 线程不存在、HDMI 无输出；UART 与 `0xFFF4` 计数器保持工作。周期数与今天一致 |
| D2 | **不做「总线突发」** | 后端是 1 拍命中的片上 BRAM，没有地址/握手开销可省；当前 Cache 行 = 1 字，没有行填充，突发**无处可挂**。要交这条只能人为改成多字行，miss 惩罚变长、性能为负，是纯功能分。理由与 2026-09-27「不要为了总线突发而做突发」一致。报告按「Cache 已实现并量化；总线突发经评估不做」如实写 |
| D3 | **128KB 扩展在 ILA 抓波形之前完成** | `.fic` 与 `.sbit` 必须同源；RTL 一改，91 根探针通道映射作废 |

### 8.2 执行顺序（按截止 2026-11-04 估算，剩约 18 天）

| 阶段 | 内容 | 估时 | 出口判据 |
|---|---|---|---|
| P0 | 冻结当前交付档 `c6af65be` / `5909a2d0`，归档 md5 + 时序报告 | 0.5 h | 可随时回退 |
| P1 | 128KB RTL + 映射/链接脚本 + 启动选择 | 1~1.5 天 | 两个程序能各自启动 |
| P1.5 | 全套回归 | 0.5 天 | riscv-tests 49/1/0、own_tests 6/0、CoreMark 四 CRC + 周期数不变、RT-Thread 四配置、五子棋端到端 |
| P1.6 | PDS 综合 + **重扫 `gplace_seed`** | 0.5~1 天 | CPU 域 WNS > 0，Fmax 不低于 85.0051 |
| P1.7 | 单一位流上板验证 + 归档 | 0.5 天 | 菜单选 CoreMark 得 391.66；复位选五子棋能下完一局 |
| P2 | ILA 抓波形（新位流 + 新 `.fic`） | 0.5~1 天 | 91/91 存活、波形归档、`.dprj` 保存 |
| P3 | 演示视频 + 报告整合 | 1~2 天 | 同一颗位流：跑分 → 复位 → 五子棋；报告按「场景 → 资源/时序 → CoreMark」 |
| P4 | 缓冲 / 可选 | — | 有余力才碰总线突发；不得影响已冻结交付 |

### 8.3 风险与回退

- **时序风险**：14→15 位会动到关键路径上的 `imem_addr2`，CPU 域余量只有 +0.277 ns。
  改完必须重扫 seed；若收敛不了，优先用 P3.5 的「窄加法/解耦」手法，而不是直接降频。
- **回退点**：P1.7 失败且临近截止 ⇒ 退回两颗位流（`c6af65be` + `5909a2d0`），
  在报告里如实说明；但这是合规风险，不作为首选。
- **不要**为了追总线突发而推迟 P1~P3：它是功能分，P1~P3 影响的是合规与主体评分。

---

## 9. 原表核对（2026-10-17 17:05，逐行）

> **来源换成原件**：`D:\download\2026FPGA大赛紫光同创杯答疑表.xlsx`
> （单工作表「工作表1」，**135 条有内容行**；下文的 `R##` 就是该文件的 Excel 行号）。
> 解析方式：xlsx = zip + XML 直读（`openpyxl` 对该文件样式表报
> `TypeError: Fill() takes no arguments`，不可用）。
>
> 结论：本文 §2/§3/§5/§6 的**大方向全部与原文一致**，但有 **7 条需要修正或补记**（§9.2）。
> 之前那份是 15:30 从腾讯文档网页抄的，**行数记成 198 是错的**（网页含空行）。

### 9.1 与原文逐条对上的（可直接引用）

| 本文口径 | 位置 | 原文（节选） |
|---|---|---|
| 第 53 问「同一个 bit 流」 | R99 | 问「…在同一个 bit 流文件中？还是…分别跑两个 bit 流出来」→ 答「**同一个**」 |
| 跑分可关外设 | R10（序号 25） | 「跑分时可以关闭外设吗？」→「**可以**」 |
| 时序违约不接受 | R4（序号 7） | 「…**时序违约都是不被接受和允许的**」 |
| 先场景后性能、不接受只针对 CoreMark | R2（序号 4）/ R6（序号 11） | 「先有作品场景应用能力，再同步考虑 CPU 性能」/「不接受仅针对 coremark 等的跑分优化」 |
| 资源同等功能下对比 | R20（序号 46）/ R106（序号 63） | 「类似资源量的对比和跑分都是**基于同等功能下的对比**」/「有关资源使用量的都是**在同等功能下**才去做对比的」 |
| 禁硬核 ARM/NPU；可用软 ARM + 自研纯逻辑 | R104（序号 54）第 3 条 | 「**不能使用硬核的 ARM、NPU**，可以使用软 ARM 和自研纯逻辑 NPU」 |
| 评审顺序 | R104（序号 54）第 4 条 | 「先评审作品基于场景的特性指标，同等指标情况下，才比较…逻辑资源和时序表现，同等条件下，再是 cpu 性能…如 CoreMark」 |
| 初赛四件套 | R107（序号 71） | 「设计文档、设计代码、演示 PPT、演示视频这样一整套是最佳的」 |
| 不能只停留在仿真 | R31（序号 93） | 「从赛题解读来看两者都需要，**不能只停留在仿真上**」 |
| AI 非必须 | R30（序号 84） | 「AI 加速只是一个推荐方向」 |
| 硬件加速支持 / 可扩展指令集 / 可用 RVV | R9（序号 9）、R29（序号 79）、R11（序号 12） | 「支持」/「可以」/「可以使用」 |

### 9.2 需要修正或补记的 7 条

1. **R36 是一条同义但未答的提问**（本文原先没记）：
   > 「要把应用程序和 coremark 跑分都做成机器码**烧成一个 bit 文件**去上板吗」
   → **无答复**。
   ⇒ 口径不变（仍按「同一颗」做），但报告/答辩要写清：**同义两问，一条（R99）答了、一条（R36）未答**。
2. **Cache 相关其实有两条，本文写得不准**：
   - **R38**：「处理器部分如果使用 bram 的话…**请问使用 bram 是否可以不使用 i cache**」→ **未答**；
   - **R106（序号 68）已答**：「用了载体就必然有延时，**1 个时钟周期都算**…正常来说 Cache 的容量较小会用 Bram 来做…外部 DDR 到内部逻辑也是有一级 BRAM 缓冲的」。
   ⇒ **官方从未说「BRAM 可以不用 I-Cache」**；它反而在强调延时客观存在。
   答辩口径改为：「Cache 已实现并量化；本设计后端是 1 拍 BRAM，实测负收益，故默认关」——
   **不要**引用「官方说 BRAM 不用 I-Cache」（未答，且与 R106 的语气相反）。
3. **漏了一条与降频直接相关的未答项**：**R127「对频率是不是有限制」→ 未答**。
   ⇒ 76.5 MHz 是**我们自己 P&R 收敛的结果**（128KB + 85 MHz 收不住），报告里不能写成"官方频率限制"。
4. **板卡型号已有官方答复**（本文原写"需确认型号"）：
   - **R112（序号 90）**：线上平台板卡 =「**200K MINI**」；
   - **R12/R16**：可以使用 100k mini 和 200k mini；**R24**：可以使用盘古 200pro+。
   ⇒ 我们用的 **PG2L200H 属 200k 档但不是"200k mini"**，按 R104 第 2 条备**资源证明页**（非推荐板卡需说明资源不超过推荐板卡）。
5. **LUT 统计范围确认仍未答**：R100（序号 54）只答了 4 条（板卡/非推荐说明/禁硬核/评审顺序），**没有回答 LUT 范围**；R124 追问也未答 ⇒ 本文的双口径做法正确。
6. **高阶①总线突发评定仍未答**（R42）⇒ 继续"如实写不做"，correct。
7. **行数口径修正**：原文"表格共 198 行"→ 实际 **135 条有内容行**（网页版含空行/合并行）。

### 9.3 这些核对对当前决策的影响

| 决策 | 是否改变 | 说明 |
|---|---|---|
| 128KB + 单一位流 + 运行时二选一 | **不改** | R99「同一个」是唯一明确答复；R36/R124 未答 ⇒ 我们取的已是最保守解 |
| 交付档 Cache 关 | **不改** | 官方**没有**"必须含 Cache"的要求；R106 只谈延时常识。报告写「已实现/默认关/负收益」即可 |
| 76.5 MHz | **不改**，只改措辞 | 写成"128KB 存储 + P&R 收敛结果"，不是官方限制 |
| 板卡说明 | **要补** | 2L200H 不在推荐型号字面清单，按 R104 第 2 条备资源证明 |
| 报告结构 | **要改** | 按 R104 第 4 条「场景指标 → 同等指标下资源/时序 → CoreMark」 |
