1979711854/riscv-cpu-fpga/doc/board/preview_cm_result.bmp

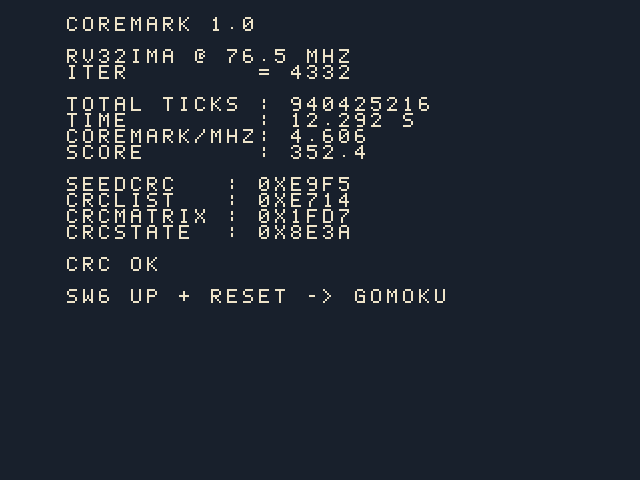
doc/board/preview_cm_result.bmp
