1979711854/riscv-cpu-fpga/doc/figures/pipeline_hazard_mix.png

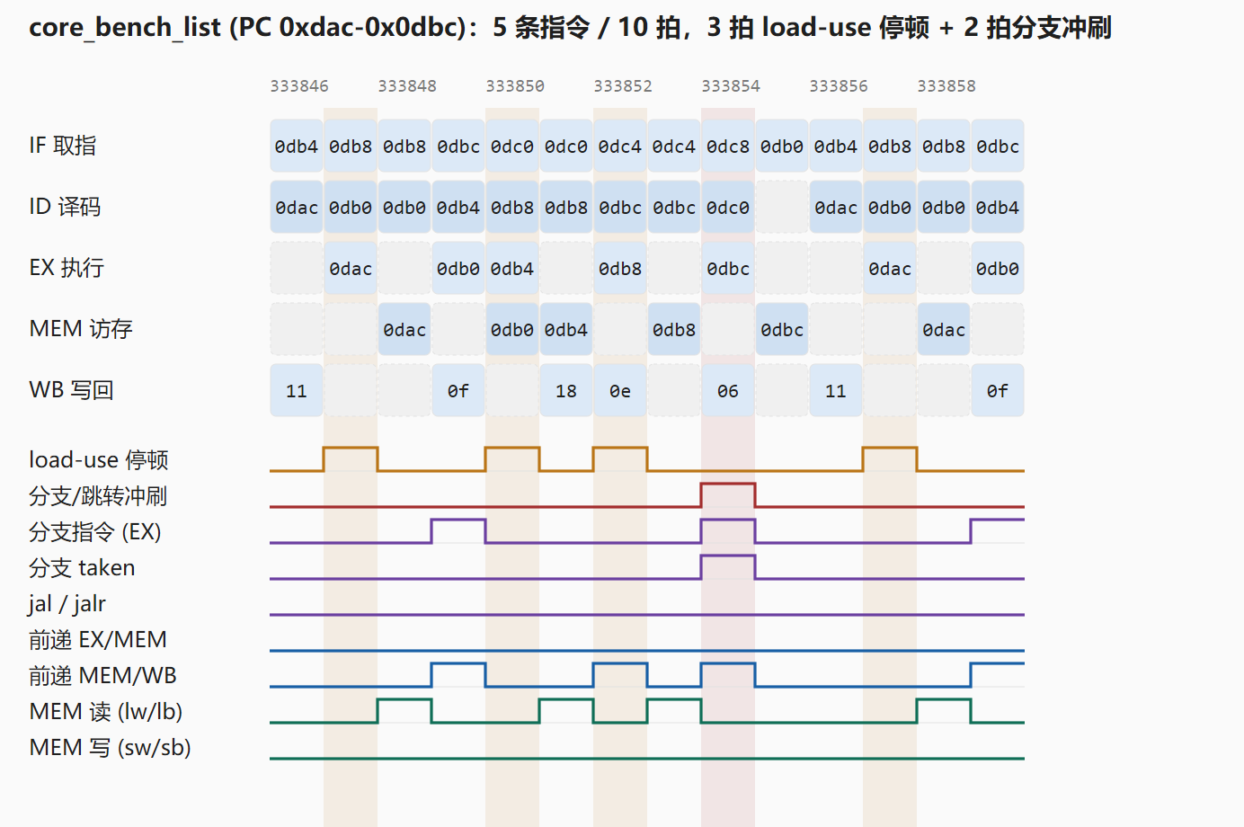
doc/figures/pipeline_hazard_mix.png
