1979711854/riscv-cpu-fpga/(commit log)

2026-10-01 chore: 工程快照 —— CPU 优化 + HDMI 视频子系统（合并版首次入库）
    来源：队友合并包 riscv-cpu-fpga_merged.rar（2026-10-01）
    本 commit 只做三件事，不改任何逻辑：
    1) 仓库从 C:\Users\zjn\Desktop\RV32I\riscv-cpu-fpga_merged\ 移到 D:\riscv-cpu-fpga_merged
    （PDS 工程内引用是相对路径，可搬迁）
    2) 补 .gitignore（快照包里没有；照搬 D:\riscv-cpu-fpga 那份）
    3) git init 并入库，作为后续所有改动的回退点
    内容：CPU 侧是 2026-09-28 的成果（两拍乘法器 + 62.03MHz）；
    视频侧是队友新增的 HDMI 480p60 tile PPU（rtl/video/ 11 个文件，
    已登记进 .pds，build_bitstream.ps1 加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
2026-10-01 docs(bitstreams): 首次综合通过 —— HDMI 彩条版归档 + 时序判读记录
    build_bitstream.ps1 video 首次跑通（此前 PDS 从未运行过）。
    结论：可以上板。
    - 三个时钟域 slack 全正：clk_sys +1.167ns / pix_clk +33.554ns / ser_clk +6.856ns
    - 同域内失败端点为 0
    - 摘要里的 22 条违例全是跨域建模假象（21 条 clk_sys→pix_clk + 1 条 pix_clk→clk_sys），
    与 RV32I_1.fdc 里预测的数量一字不差
    - [重点] CPU 域在 62.03MHz 下 +1.167ns —— 队友此前在 49.89MHz 记的
    clk|u_pll 域内 8 条 -0.359 已消失，正是两拍乘法器消掉 load→mul 的结果
    资源：LUT 4003(2.51%) FF 2849(0.89%) DRM 53.5(12.89%) AP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
2026-10-01 feat(gomoku): 轨道 C —— 棋盘结构 + 五连判胜 + 平局判定（x86 单测全过）
    对应 doc/reports/2026-10-01_gomoku_worklist.md 的轨道 C1/C2/C3。
    工作清单 §C 要求"可以脱离硬件在 x86 上用 gcc 写单测"，本条路径不需要板子，
    正好接住"手头没有 HDMI 线/显示器"的现状。
    新增 scripts/gomoku/：
    - board.h / board.c 棋盘 + 落子合法性 + 四方向增量判胜 + 满盘平局
    - test_board.c x86 单测，70 项检查
    - run_test.ps1 一条命令编译并跑（只要 x86 gcc，scoop install gcc）
    - README.md 接口、规则取舍、单测覆盖、下一步（轨道 D）
    【一份源码两处用】board.c 只依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
2026-10-01 docs(bitstreams): 记下 2026-10-01 烧错位流那次 —— 文件名与字节数都分不出
    想测视频彩条，烧完串口打出 CoreMark（727,018,199 / Iterations 2000），
    说明烧的是 D:\riscv-cpu-fpga 那份 CoreMark 位流（md5 3f76e554），
    不是本工程的视频位流（75871d8a）。两者文件名相同、大小也相同（9,188,552 字节）。
    根因：Fabric Configuration 记住上次分配的文件，且是分配时读进内存的 ——
    只点 Program 就重烧上次那份。纪律：三部走全，Browse 不能省；烧完先对 md5。
2026-10-01 docs(board): 视频彩条固件首次上板 —— SELFCHECK OK
    日志 doc/board/uart_20261001_210608.txt（2026-10-01 21:06）：
    VIDEO colorbar ready
    PAL[1]=00FFFF00 PAL[5]=00FF0000 PAL[7]=00000000
    NT[0][0]=00 NT[0][5]=01 NT[0][35]=07 NT[0][39]=07 NT[31][200]=00
    PAT[7][0]=07 PAT[3][255]=03
    SELFCHECK OK
    意义：**CPU → mem_bus → 显存（调色板/图块表/图块像素）写入并读回，
    10 个值全部一致** —— 这条链在真板上通了。
    这一版是 md5 75871d8a（video 变体）的位流。上一份 20:47 的日志打出的是
    CoreMark（727,018,199 / Iterations 2000），是烧成了主仓 CPU 单仓那份位流
    （md5 3f76e554）—— 见 bitstreams/RE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
2026-10-01 docs(board): 视频 PLL 锁定确认（丝印 D18）—— 显示链条验到 3/4
    2026-10-01 板上观察：
    丝印 D19 亮 -> CPU PLL 锁定
    丝印 D18 亮 -> 视频 PLL 锁定（同一 PLL 两路：÷45=25.5MHz 像素、÷9=127.5MHz 并串）
    丝印 D13 不亮 -> done，本变体正常不亮
    丝印 D22 亮 -> 板载指示灯，不在 8 颗用户灯（D12~D19）里，与设计无关
    显示链条四段状态：
    1. CPU PLL 锁定 [OK] D19
    2. 视频 PLL 锁定 [OK] D18
    3. CPU->mem_bus->显存 写/读回 [OK] SELFCHECK OK
    4. TMDS 编码/相位 + 显示器 [未验] 缺 HDMI 线/显示器
    doc/board/README.md 顶部改为当前设计（62.03MHz + 视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
2026-10-01 feat(gomoku): 轨道 D —— AI 对手（启发式评分 + alpha-beta + 迭代加深）
    对应工作清单的 D1~D4。新增 scripts/gomoku/ai.h / ai.c / test_ai.c，
    并把 run_test.ps1 改成编译并跑两个测试台（C 与 D）。
    架构：评分与搜索分开
    - 评分函数只负责【排序】候选和【估值】叶子，只数"连续子数 + 两端开口"，
    刻意不认跳三/跳四这类断点棋型 —— 那是搜索的活。
    堆到能认断点会让每节点慢好几倍，而 RV32 上时间是硬约束。
    - 搜索是 negamax + alpha-beta，任一层能成五就直接返回获胜分（五子棋里剪掉的量很大）。
    - 候选只取"离已有棋子 <= 2 格"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
2026-10-01 feat(gomoku): 终端人机对战 CLI —— 不需要板子就能试 AI
    新增 scripts/gomoku/gomoku_cli.c + play.ps1。
    这是工作清单 M0「PC 上的 AI 原型跑通」的落地物，也是"没板子/没显示器"
    时唯一能立刻玩到 AI 的入口。每步 AI 走完打印
    【节点数 / 实际深度 / 耗时(ms) / 评分】—— D4 时间预算的判据就在这四个数上。
    用法：scripts\gomoku\play.ps1 [-Easy|-Hard] [-White]
    落子 H8（列字母+行号）/ 也接受 7 7；命令 q n u + - h
    写这个文件时踩到两个"输入解析"的坑，都留在注释里了：
    1. 一开始先判命令再判落子 —— 结果 H8 以 'H' 开头被当成 help、
    N7 被当成重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
2026-10-01 fix(gomoku): CLI 中文乱码 —— 三道编码保险
    症状：棋盘和中文提示在 PowerShell 里显示成 ���。
    原因不是程序：用 od -c 核对，输出字节是合法 UTF-8（344 272 224 = "五"）。
    是中文 Windows 的控制台默认代码页 GBK(cp936) 解码方式对不上。
    三道保险：
    1) play.ps1 / run_test.ps1: chcp 65001（切控制台代码页）
    2) 同上: [Console]::OutputEncoding = UTF8（PowerShell 按 UTF-8 解子进程输出）
    —— 这一条抄工程里 build_bitstream.ps1 的既有写法
    3) gomoku_cli.c 的 #ifdef _WIN32 里 SetConsoleOutputCP(65001)
    —— 让【直接双击 .exe】也正常
    另外 README 里补了排障条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
2026-10-01 feat(gomoku): 轨道 A2/A3 —— 图块美术 + 渲染层（含无显示器的画面预览）
    A2（图块与调色板）：
    - 新增 scripts/gomoku/gen_tiles.py —— **图的唯一真相**，生成 tiles.h
    36 块图块 = 9 种网格线形状（内部/四边/四角）× 4 种状态（空/黑/白/光标）
    7 项调色板。想改颜色/线宽/棋子大小改脚本重跑即可，tiles.h 是产物不用 review。
    带终端字符画预览，生成完扫一眼就知道有没有画歪。
    A3（渲染层）：
    - render.h / render.c —— 棋盘/棋子/光标 -> 显存字节。
    平台无关，唯一外部依赖是 vid_bulk_write()。
    - video_port.h / video_port.c —— 固件侧实现（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
2026-10-01 feat(gomoku): 轨道 B1 —— 按键去抖与短按/长按识别
    板上只有 4 个用户按键（SW4~SW7 = key[0..3]），却要干 5 件事
    （上下左右 + 落子），所以必须有一个动作靠长按区分。
    时序约定（input.h 开头有完整论证）：
    按下 ─┬─ 松手（<600ms） -> 一次【短按】
    └─ 撑到 600ms -> 一次【长按】，之后松手不再补短按
    **两个事件都不在"按下沿"触发**，这是刻意的：若改成"按下沿就移动、长按再落子"，
    按住方向键落子时光标会**先跑一格**，于是想在 A 点落子却落到 A 的下一格。
    现在这样，"按住不放落子"的净效果就是【光标一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
2026-10-01 feat(gomoku): 轨道 B2/B3 —— 光标与对局状态机（整盘棋可在 PC 上走完）
    新增 game.h / game.c / test_game.c（49 项检查）。
    状态机：标题屏 → 对局 → 胜负 → 回标题
    标题屏 短按 ←/→ 切难度 长按任意键 开始对局
    对局中 短按 ←/→/↑/↓ 移动光标 长按任意方向键 在光标处落子
    胜负后 长按任意键 回标题
    人的颜色固定黑（先手）；人执白时开局由 AI 先走一手，在主循环里直接下掉，
    免得为"开局第一手"再开一条特例路径。
    纯逻辑设计：时间/按键/画面/AI 全部由外部注入，game.c 不碰任何硬件 ——
    所以**一整盘人机对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
2026-10-01 feat(gomoku): 轨道 E1 —— 组装固件 + 构建脚本 + build_bitstream 变体
    新增 main.c（主循环）、build.ps1、并在 build_bitstream.ps1 里加 gomoku 变体。
    至此 A/B/C/D 四个模块第一次接成一个能烧进板子的固件：
    上电 -> 填调色板与图块 -> 标题屏 -> 对局 <-> 胜负 -> 回标题
    主循环【与帧同步】：每帧等一次 vblank，再采样按键、推状态机、全刷棋盘。
    两个理由：① 防撕裂（改显存要在 vblank 里做）；② 给主循环一个稳定节拍，
    否则它会以几十万次/秒空转。代价是按键采样变成帧级（16.7ms），一次按压
    要 2 帧才认账 —— 人按一下约 100ms，够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
2026-10-01 build(gomoku): 五子棋版比特流生成并归档 —— md5 93cb0a16
    build_bitstream.ps1 gomoku 跑通：固件 -> 同步 -> 综合 -> 位流。
    时序与彩条版【逐位相同】（同一份 RTL，只换了 BRAM 里的固件内容）：
    clk_sys 62.0309 MHz slack +1.167 ns
    pix_clk 25.5004 MHz slack +33.554 ns
    ser_clk 127.5022 MHz slack +6.856 ns
    "Some Constraints Violated" 仍是那 22 条跨域建模假象（21+1，见本目录 README）。
2026-10-01 feat(gomoku): 轨道 E2 —— 端到端仿真测试台（从按键到画面全通）
    新增 sim/tb_gomoku.v + scripts/gomoku/run_sim.ps1。
    在真 CPU + 真 PPU 上跑固件，注入按键，检查串口与显存 nametable：
    [ok] 固件启动（banner）
    [ok] 上电就把棋盘铺好了（左上角 tile=20、天元 tile=0）
    [ok] 长按开局成功
    [ok] 天元落了黑子（tile 从 0 变 1）
    [ok] AI 应手
    checks=6 errors=0
    至此 A/B/C/D 四模块在真 RTL 上第一次端到端跑通 —— 只剩上板。
    调这个测试台踩了四个坑，都留在注释里：
    1. **has_text 拿 15 字符字面量比 16 字节窗口** —— Verilog 里没有运行期字符串长度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
    [tb_gomoku.v]
2026-10-01 chore(gomoku): 删掉忘了清的临时补丁脚本 _patch2.py（不是交付物）
2026-10-01 build(gomoku): 重建位流 —— 上一次归档的固件已过期
    22:03 那次综合之后又改了固件（落子后藏光标、AI 难度可编译期覆盖），
    归档的 93cb0a16 里的固件（9172 行）与源码（9186 行）不是同一份。
    build_bitstream.ps1 的 sha256 校验挡住了这个：
    PDS 工程固件 = 当前源码 [OK]
    旧归档删除，换成本次重建的版本。
2026-10-01 docs: 五子棋交接文档（自包含）—— 进度、未实现功能、踩坑、接手顺序
    新增 doc/reports/2026-10-01_gomoku_handoff.md，给接手的队友。
    重点是 §4「还没实现的功能」：
    - **从未上板** —— 前面全是仿真，没有一行板级证据
    - **没有任何文字/HUD** —— 屏幕上只有棋盘和光标，玩家得自己看颜色判断轮次
    - **AI 板上耗时没标定** —— AI_NODE_BUDGET 是拍脑袋定的临时值，
    最坏局面（自对弈见过 35,106 节点）下如果换算是 100，单步就是 20 秒，
    HARD 档可能根本不能用
    - 板上没有悔棋、没有音效、没有多关卡
    - 继承自 CPU 的限制：未对齐访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
2026-10-01 build(gomoku): 位流重建成功 —— md5 2cee98c9（固件与源码已一致）
    前两次尝试都没产出新位流，原因值得记：
    第一次：expectLines 守卫拦下（固件从 4586 字变 4593 字），在综合【之前】就停了
    —— 这正是它的职责，但结果是 generate_bitstream 里留的还是 22:03 的旧位流
    第二次：更新 expectLines 后跑通
    [!] 判据：**不能只看"构建成功"**。这次是靠核对 .sbit 的时间戳和 mem.hex 的 sha256
    才发现旧位流还躺在那儿的（CLAUDE.md 约定 23 里那两条）。两次「看起来成功」
    其实只有最后一次真的重新综合了。
    时序与彩条版逐位相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
2026-10-04 perf: 主频 62.03 → 85.0051 MHz（PDS "满足约束即收敛"实测上限 ≈90）
    没有任何 RTL 改动 —— 只改了 PLL 分频比和跟着时钟走的固件常量。
    [重点] 关键发现：Estimated Frequency 不是设计上限，而是"这次被要求跑多快"。
    同一份 RTL、只改 STATIC_RATIO0 实测：
    请求 62.03 → 达 66.87 MHz (slack +1.167) ← 旧设计，被自己的约束卡住
    请求 71.72 → 达 73.26 MHz (slack +0.293)
    请求 85.01 → 达 91.87 MHz (slack +0.879) ← 采用
    请求 99.79 → 失败（WNS -1.188、282 个失败端点）
    故真实上限 ≈90 MHz；取 85 是留 ~7% 余量，与旧设计 62.03/66.87 的 7.8% 同一风险档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
2026-10-04 fix(gomoku): 串口可观测性 —— 板子做的事必须看得见
    没有显示器时，串口是唯一的目视手段。但原固件在好几个环节是"做了但不告诉你"，
    2026-10-04 上板实测连续踩到，逐个补齐（都是同一类毛病）：
    1. 棋盘快照（新增 uart_dump_board）：15x15 ASCII，X/O/./*，每变一次棋子打一张。
    没有它，串口上完全看不出棋局。
    2. 开局打空棋盘：原来只在"棋子数变化"时打，而开局棋子数是 0、不算变化 ——
    于是空棋盘【从来没打过】。玩家只看到一行 "start, level=N"，不知道游戏开没开。
    3. 光标移动反馈（cursor=X##）：短按移动原本完全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
2026-10-04 docs(board): 2026-10-04 五子棋首次上板实测 —— E3 完成
    五子棋此前从未上过板（交接文档里挂了三天 [X] 待做），今天第一次跑通，
    而且是这颗 CPU 第一次跑在 62 MHz 以上。
    实测覆盖（原始日志见 doc/board/uart_20261004_*.txt）：
    - 85.0051 MHz 可用：串口零乱码（UART_DIV=738 与实际时钟严格对上才会这样）
    - 标题屏 → 切难度（level=1/2 有回显）→ 长按开始 → 落子 → AI 应手 → 胜负
    - 完整一局下到分出胜负：G5-G9 竖五连 → "WHITE wins" 判定正确
    - 串口棋盘快照 / 光标移动反馈 / 难度反馈 / AI 思考提示 全部按预期工作
    AI 耗时标定（交接文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
2026-10-04 docs: 分工书 + CoreMark 跑分现状 + AI 成本测量工具
    三份东西，都是为了"把活分出去"和"把现状说清楚"：
    1. doc/reports/2026-10-04_work_split.md —— 分工（上板侧 / 代码侧）
    含待办清单（带归属、是否需要板子、验收标准）、代码侧能用的全部工具、
    必读坑清单、交付物清单。
    2. doc/reports/2026-10-04_coremark_score.md —— CoreMark 跑分现状
    七行板上实测历史（64.3 → 75.24 → 125.40 → 140.89 → 137.25 → 170.64 → 233.8），
    把得分拆成"效率 × 时钟"两个独立因子，并给出天花板分析
    （时钟剩 +6% 到 ≈90MHz；效率剩 +26% 到理论极值 3.472）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
2026-10-04 docs: 85MHz 跑分实测落地 —— CoreMark 233.85，全部口径同步
    板上实测（2026-10-04 11:47，位流 md5 ae4deea9，日志 uart_20261004_114730.txt）：
    Total ticks 996,015,474 ÷ 85,005,100 = 11.7171 s
    Iterations 2740 → 每秒迭代 233.85 次 → 得分 233.85 CoreMark
    363,509 拍/迭代（仿真 363,515，差 −0.0016%）
    四个 CRC e9f5/e714/1fd7/8e3a 逐位一致，Correct operation validated
    预估 233.8、实测 233.85，差 −0.0016% —— 与 49.89 MHz 那代同量级同方向。
    同步的文档：
    - doc/reports/2026-10-04_coremark_score.md：第 7 行由"待测"改为实测；
    新增"得分 = 效率 × 时钟"的两因子分解与天花板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
2026-10-06 feat(cpu): 顺序双发射（DUAL_ISSUE）+ 配置口径统一 + ITER 重算
    来源：队友的双发射工作（riscv-cpu-fpga_dualissue_261006.zip），基线是我们
    merged-85mhz @ 736e219（已核实：文件清单完全一致，仅 .pds 因 PDS 重写而不同）。
    ## 性能（我独立复现，非转述）
    | 指标 | 单发射 | 双发射 | Δ |
    |---|---|---|---|
    | CoreMark 每迭代周期 | 363,515 | **313,886** | −13.65% |
    | CoreMark/MHz | 2.751 | **3.186** | +15.8% |
    | Fmax（PDS） | 91.3993 | **87.0019** | −4.8% |
    | 板上原始得分 @85.0051MHz | 233.85 | **270.8** | +15.8% |
    | LUT | 4,377 | **6,909** | +58% |
    | CoreMark/LUTs | 0.0534 | **0.0392** | −27% |
    验证方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
2026-10-06 build: 双发射 CoreMark 位流首次生成并归档（md5 5c4893de）
    第一次真正综合出 DUAL_ISSUE=1 的位流（队友此前只做了仿真与 P&R 探针）。
    位流 md5 5c4893de / 9,188,552 字节
    时序 Requested 85.0051 MHz / Estimated 87.0019 MHz / slack +0.270 ns
    资源 Total LUTs 6,909（4.32%）
    固件 ITER=3170（8416 行，守卫对得上）
    [!] 归档名带上了配置后缀 `coremark_dual_85mhz_*`。单发射/双发射两者文件名与
    字节数完全一样，差别是"分数差 15.8%"这种不显眼的东西，不标配置分不出来。
    同时确认 build_bitstream.ps1 的期望值已按配置自动算（不再写死单发射口径）：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
2026-10-06 chore: 加 scripts/pack_for_teammate.ps1 —— 给不方便用 GitHub 的一方打交接包
    队友不擅长 GitHub，只能走压缩包。这个脚本把仓库打成 zip（含 .git，这样
    他在 zip 里也能正常 commit，来回几轮历史不会断）。
    踩到并写进注释的 4 个坑：
    1. `git ls-files` 默认转义非 ASCII 路径 → 中文名文件（doc/RV32I指令集参考.md
    等）拷不进去，必须 `-c core.quotepath=false`
    2. `Compress-Archive -Path "<stage>\*"` 的通配不保证收隐藏项 → .git 会丢
    3. zip 条目里的路径分隔符是 `\` 不是 `/`，自检的过滤条件写错会误报"没有 .git"
    4. [!] **中文 Windows 上 PowerShell 5.1 有两处编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
2026-10-06 docs: 双发射板上实测 270.82 —— 效率路线首次兑现板级证据
    2026-10-06 板上实测（位流 md5 5c4893de，日志 doc/board/uart_20261006_162410.txt）：
    Total ticks 994,988,178 ÷ 85,005,100 = 11.7050 s
    Iterations 3170 → 270.82 CoreMark
    313,876 拍/迭代（仿真 313,886，差 −0.003%）
    四个 CRC e9f5/e714/1fd7/8e3a 与单发射逐位一致
    预测 270.8 / 实测 270.82，差 0.007%。
    [重点] 这一版与前面几轮【路子不同】：改的是效率（2.751 → 3.186，+15.8%），
    时钟没动（仍 85.0051 MHz）。之前每一轮涨分都是靠提频。
    [!] 代价必须一起写进报告，不能只报 270.82：
    Fmax 91.40 → 87.00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
2026-10-06 build: 双发射五子棋位流归档（md5 3976aebd）
    同 CoreMark 双发射网表（85.0051 / 87.0019 MHz / slack +0.270 ns），只有固件不同。
    板上待验 —— 注意视频/PPU 路径在双发射下仍未做过仿真验证。
2026-10-06 docs(board): 双发射五子棋板上跑通 —— 应用侧验证补齐 + AI 提速实测
    日志 doc/board/uart_20261006_172315.txt（位流 md5 3976aebd，双发射）：
    启动 banner / 难度切换(1→2→1) / 长按开始 / 开局空棋盘 全部正常
    落子 → AI 应手 连续 4 手，棋盘状态与轮次流转全对
    [重点] 顺带拿到一个此前没有的数据 —— 双发射在【应用侧】的实测收益
    （同为 NORMAL 档、同为开局）：
    手数 单发射(10-04) 双发射(10-06) 提速
    1 666 ms 552 ms -17%
    2 438 ms 355 ms -19%
    3 716 ms 538 ms -25%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
2026-10-06 docs: 全部口径同步到双发射 + 新增 v3 交接任务书
    一、旧文档同步（9 个文件，代理执行）
    README.md / CLAUDE.md / doc/base_task_status.md / doc/resource_efficiency.md
    doc/board_bringup.md / doc/reports/2026-10-01_gomoku_handoff.md
    scripts/README.md，顺带 doc/plan.md §8、rtl/README.md
    单发射数字一律降级为显式标注的历史，并保留演进过程（那是交付材料）。
    CLAUDE.md 新增三条关键约定：
    37 双发射两条并列回归基线 + 位流命名必须带 _dual_/_single_
    38 PowerShell 5.1 把无 BOM 的 .ps1 按 GBK 读 → 假语法错
    39 板子断电丢 FPGA 配置、两颗 PLL 灯全灭
    二、coremark_scor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
2026-10-06 docs: 第二轮口径同步 —— 论文稿、ILA、spec、板级证据索引等 11 个文件
    上一轮同步了 9 个主文档，本轮把剩下的补齐（代理执行 9 个 + 我补 2 个）。
    代理执行：
    doc/test_report_riscv-tests.md 插入双发射板测块，原 49.89 块降为历史
    doc/ila_analysis.md "当前 49.89 MHz 设计" → 标注为 ILA 探针那代
    doc/README.md / pds/README.md / doc/paper/overview.md
    doc/paper/论文撰写思路与获奖策略.md ← 论文稿，口径整体前移（结构未动）
    doc/reports/2026-10-04_work_split.md / 2026-10-01_gomoku_worklist.md
    doc/reports/2026-10-04_coremark_score.md §2 补第五轮、§5 天花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
2026-10-07 docs: 队友交付的验收意见（HUD + HARD 提速，2026-10-07）
    检查对象：riscv-cpu-fpga_dualissue.rar（基线 893bdd9，与 dualissue 分支一致）。
    结论：HUD 做得好，可以接受；HARD 提速没达到他自己写的验收标准，是唯一要返工处。
    run_test.ps1 四个测试台里两个失败、共 3 项。
    要返工：
    HARD 宽度 8 → 自对弈 3:3（要求"多赢"）+ 单步最多 6847 节点（要求 ≤4000）
    根因是"深 vs 宽"的取舍：宽度 14→8 每层少 6 个候选，损失大于多 2 层的收益。
    选项 A 宽度试 10~12；选项 B 调不出来就删掉 HARD 这一档。
    [!] 附带：那个"6 局自对弈"其实只有 2 局 —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
2026-10-07 feat(gomoku): 导入队友的 HUD + HARD 调参，并修掉两处遗留问题
    来源：队友的 riscv-cpu-fpga_dualissue(1).rar（基线 893bdd9，与我们的 dualissue 一致）。
    ## 队友这一版（已验收，266 项全过）
    HUD 完成（任务 B1）：
    - 紧凑 5x7 位图字库 font.h（95 字 x 7 字节 = 665 字节），render_init() 上电放大
    2x 成 16x16 写进 tile 36..130。比"16x16 字库 24KB"的方案省 97%
    - render_text() / render_text_center()，小写自动折大写
    - 屏幕内容：TURN: / LEVEL: / AI: NODES n DEPTH n nMS / 胜负横幅 / 标题屏
    - 字库由 gen_tiles.py 生成（+396 行），不手改
    - 有意用空格代替 `=`（`=` 恰是空字形）—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
2026-10-07 build: 双发射 + HUD 位流归档（md5 e5bc227a，待上板验）
    同双发射网表（85.0051 / 87.0019 MHz / slack +0.270 ns / LUT 6909），固件换成带 HUD 的：
    固件 mem.hex 11076 行（expectLines 已对上），保留字库 665 字节
    AI 预算标定为 12000（最坏一手 ≈7.2 秒，HARD 仍强于 NORMAL 14:5）
    屏幕内容：标题屏 / TURN: / LEVEL: / AI: NODES n DEPTH n nMS / 胜负横幅 + 演示模式
    位置：pds/RV32I_1/bitstreams/gomoku_dual_hud_85mhz_e5bc227a.sbit
2026-10-07 fix(video): 刷新率 60.71 -> 59.96 Hz —— 首次接真显示器暴露的同步不稳
    背景：HDMI 输出第一次接上真显示器（27 寸电脑显示器），画面"抖动/撕裂，
    但能看出是在下棋"—— 内容对、同步不稳。这条链路此前验到"视频 PLL 锁定"就卡住了，
    TMDS/时序/显示器认不认 这一段从未验证过。
    排查（排除的也要记，免得后人重走）：
    - [OK] **同步极性本来就是对的**：VESA DMT 640x480@60 要求 HS/VS 负极性，
    ppu.v:84 的 `sy0 <= {de_ph, ~hs_ph, ~vs_ph}` 已经取反。我一开始怀疑极性，查证后排除。
    - [OK] render_clear() 铺满整屏 40x30，且在初始化段只跑一次（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
2026-10-07 fix(gomoku): HUD 文字残字 —— "LEVEL: NORMAL" 切 "LEVEL: EASY" 显示成 "LLEVEL: EASYL"
    2026-10-07 板上实踩（真显示器终于接上之后）：标题屏切难度时
    屏幕上出现 "LLEVEL: EASYL"。
    成因：render_text_center 只写字符串本身，不擦这一行剩下的部分；
    而居中起点取决于字符串长度：
    "LEVEL: NORMAL" 13 字 -> 居中占列 13..25
    "LEVEL: EASY" 11 字 -> 居中占列 14..24
    两端各留一个 'L' ⇒ L + "LEVEL: EASY" + L。
    排查过程（先排除了字库）：
    - 把 LEVEL: EASY 每个字的字模都画出来核过，L/E/V/A/S/C/Y/空格/冒号全部正确。
    - 所以不是字形问题，是**擦除**问题。
    修法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
2026-10-07 build: HUD 残字修复版位流归档（md5 074a0e11）+ expectLines 更新 11072
    固件 22515 -> 22507 字节（render_text 改成整行写，比逐字符写紧凑）：
    expectLines gomoku 11076 -> 11072，描述 5538 -> 5536 字
    栈余量 6157 -> 6165 字节
    位流（同双发射 + 60Hz 网表，只换固件）：
    gomoku_dual_hud_60hz_074a0e11.sbit ← 当前最新，60Hz + 残字修复，已板上可玩
    gomoku_dual_hud_60hz_50c4e364.sbit ← 仅 60Hz，有残字 bug
    bitstreams/README.md 同时记了 60.71Hz 那版（e5bc227a）—— 它能复现
    '画面抖动/撕裂'那个症状，是刷新率那条结论的证据，别删。
2026-10-07 docs: 交接任务书 v4 —— 菜单系统 + HUD 行距 + AI 思考流畅度
    留给队友的下一轮工作包。自包含，含全部设计细节与踩坑记录。
    任务：
    A 菜单系统（模式 -> 难度 -> 先后手）+ AI 对弈双方独立难度 + 每手间隔档位
    交互统一为「上下键选择 + 长按确认」；数据结构要把 game_t 的单 level
    拆成 level_black/level_white + mode + step_ms + menu_stage
    B HUD 行距（TURN:/LEVEL: 拉开；AI: 那行与提示拉开）
    C AI 思考时画面卡住 -> G1（人落子后立刻刷屏）+ G2（按迭代加深层数分批）
    [!] 论证了为什么不做 G3：RT-Thread 方案被 32KB 内存墙卡死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
2026-10-07 fix(scripts): pack_for_teammate.ps1 里我自己写的中文注释 —— 踩了自己文件头部的规则
    文件头明写 'Keep it ASCII, or add a BOM'，我改输出路径时加了一行中文注释，
    UTF-8 无 BOM 被 PowerShell 5.1 按 GBK 读 → 注释吃掉下一行 → $out 变空 → 打包失败。
    典型症状是报 '$out 是空值'，但脚本看起来完全正常。已全文件清成 ASCII。
2026-10-08 docs: 五子棋 G1+G2 交接任务书
    G1 人落子后立刻刷屏（不用等 AI 想完 14.5 秒）
    G2 AI 按迭代加深层数分批，每步 300ms 时间上界
    要点已写明：
    - ai.c 已有的 AI_NODE_BUDGET / aborted 语义必须保持（半截评分不可信）
    - 不要动递归结构本身，只切分外层迭代加深
    - 不上 RT-Thread：22,507 + 15,000 > 32KB 硬墙，且该加分项已单独拿到
    - 270 项单测不得挂，棋力不得下降（自对弈 20 局 14:5 胜 NORMAL）
2026-10-08 fix(docs): 任务书里 main.c 行号 222 -> 223（222 是注释行）
2026-10-10 feat(cpu): 导入队友的 A 扩展（RV32A）—— 并补上他漏掉的 .pds 登记
    来源：队友的 riscv-cpu-fpga_handoff_20261009.zip。
    他的基线 = 我们的双发射 + 他的 A 扩展（core.v 里有 17 处 DUAL_ISSUE/pair_now，
    差异 110 行全是 AMO 相关），所以是干净的包含关系。
    ## A 扩展修的是什么（他的说明，我核过）
    根因：AMO 是 MEM 级单元，却被 amo_stall 经 mc_stall 把 EX/MEM 清掉 —— 等于清掉它自己，
    mem_addr 塌成 0、写回落到地址 0。
    修法：让 AMO 复用 !mem_ready 的保持机制占住 MEM 级 4 拍，再走原写回通路；
    AMO 从 mc_stall 里移除。提交 0c1e6b2。
    ## 我这边验证（不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
2026-10-10 chore(pds): 工程文件由 PDS 重跑综合时回写（时间戳等），无实质改动
    [!] 同时确认了一件重要的事：**同 seed 下 PDS 综合是确定性的** ——
    重跑一次给出的 Estimated/slack 与上一次【逐位相同】（84.3170 MHz / -0.096 ns）。
    所以 A 扩展这一版时序为负【不是 P&R 抖动】，是真不收敛。
2026-10-10 fix(pnr): 开多 seed 布局，A 扩展的时序由 -0.096 转正 +0.064
    ## 问题
    A 扩展（RV32A）加进 netlist 后单 seed 综合不收敛：
    请求 85.0051 MHz -> 实际 84.3170，slack -0.096 ns（2 个失败端点）
    关键路径在 u_multiplier 第二级（N21.fsub_* 进位链 -> hi_ss -> _N17231），
    其中一段【走线 1.553 ns】—— 是布局问题，不是逻辑深度问题。
    ## 试过并否掉的：降频
    请求 83.4585 MHz -> 实际只有 79.0826，slack -0.663（【更差】）。
    根因：**PDS 的优化力度跟着约束走** —— 目标放低，工具就少干活。
    这是之前"请求越高实际越高"那条规律的【反面】，所以"放宽约束"不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
2026-10-10 build: CoreMark 双发射 + A 扩展 + 多 seed 位流归档（md5 d9ee1cfe）
    同上一版网表（85.0051 / 85.4701 MHz / slack +0.064 / LUT 7200），固件换成 CoreMark。
    ITER=3170，expectLines 8416 行一致。
    板上待测 —— 重点看 A 扩展加了 291 LUT 之后，CoreMark 的 Total ticks 还是不是 313,886
    （理论上周期数不该变，但值得实测确认）。
    [!] 同时记一个待查的问题：10-07 那份日志显示固件会卡在 video_wait_vblank()。
    banner 每 7 行重复一次、且只有第一次打出 level=，说明启动后没走到主循环第一拍 ——
    卡在 video_wait_vblank() 里。根因是 vid_resetn = resetn & locked 跟着按钮复位，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
2026-10-10 docs: 任务书 v5 + 板上实测日志（CoreMark 270.82 / AI 对弈 31 手）
    ## 板上实测（2026-10-10，两份日志都在 doc/board/）
    CoreMark（双发射 + A 扩展，位流 d9ee1cfe）：
    Total ticks 994,988,178 / ITER=3170 / 270.82 分
    四个 CRC e9f5/e714/1fd7/8e3a 全对
    [重点] Total ticks 与【加 A 扩展之前】逐个数字相同 ——
    **A 扩展对 CoreMark 周期数零影响**（riscv-tests 和 CoreMark 里都没有 AMO）
    AI 对弈（demo 模式，31 手一整局，日志干净无异常）：
    AI 一手 171 ms ~ 1,433 ms
    ## 任务书 v5（doc/reports/2026-10-10_taskbook_v5.md）
    A [必修] video_wait_vblank() 加超时 + vid_resetn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
2026-10-10 docs(taskbook): v5 增补任务 G（存储器扩到 64KB）+ H（RT-Thread 版五子棋）
    用户 2026-10-10 拍板：时间够，两件都做。
    ## G · 统一存储器 32 KB -> 64 KB
    一次解锁两件事（之前都被 32KB 墙挡住）：
    gomoku 22.5 + CoreMark 16.8 + RT-Thread ~15 = 54.3 KB < 64 KB
    器件完全撑得住：DRM 现在 53.5/415，扩到 64KB 约 +8 块 -> 61.5/415（余量 85%）。
    [!] 最关键的约束写进任务书了：**兼容区 0x7FF0~0x7FFF 是 CoreMark 移植层硬编码的**
    （core_portme.c / ee_printf.c / start.S 里都是字面量），扩 RAM 就要把它搬走 ——
    **搬不干净是静默错位**（CoreMark 跑不完、串口不出字，但零编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
2026-10-10 docs: 高阶任务③「AI 加速」可行性评估（依据赛题原文）
    用户提供了赛题原文，据此做完整评估。
    ## 原文里两条此前没注意到的
    1. 高阶③第 4 条是"融合一种或者多种传感器 **或者显示设备**" ——
    **显示设备算数**，我们的 HDMI + 自研 tile PPU 直接满足，不用买传感器。
    2. 测评标准 §2 的两个子项都在讲"模型"：
    "**模型的**性能和资源" + "**基于特定模型**AI 处理效率：综合评估延迟和识别率"。
    → 暗示应用场景里最好有一个模型，否则这两条无从评分。
    （同时"基于 RISC-V 的游戏机"是赛题自己列出的合法场景，方向不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
2026-10-10 docs: AI 评估文档改口径 —— 高阶③是可选的，但 §2 的模型评分项要分清
    用户指出：'移植 YOLO 或轻量版大模型' 只是高阶任务，量力而为 —— 同意。
    但要分清赛题里'模型'出现在两个位置：
    · '移植 YOLO 或轻量版大模型' = 高阶任务③ = **可选加分项**
    · '（1）模型的性能和资源 （2）基于特定模型AI处理效率：延迟和识别率'
    = **性能测评标准 §2 应用场景构建** = 应用场景这一项的评分标准
    所以：不强制做 YOLO/LLM；但'应用场景里有没有模型'可能是得分点
    （也可能只是'有模型才评'——这条建议问老师确认）。
    建议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
2026-10-10 fix(gomoku): 必修 A/B —— vblank 挂死 + 双重 LEVEL
    ## A · video_wait_vblank() 永久挂死（两处修改）
    现象（2026-10-07 板上实测）：按复位后固件卡死 —— 串口只打 banner 就没了、
    按键全死、屏幕黑。日志证据：banner 每 7 行重复一次，且只有第一次打出 level=，
    说明每次都走不到主循环第一拍（那一句就是 video_wait_vblank()）。
    根因两条，都修：
    1. scripts/gomoku/video_port.c —— 原来是无超时忙等（注释自己承认了隐患：
    "视频 PLL 没锁就永远卡死，看起来像死机"，但没修）。
    现在带 50ms（≈3 帧）超时，返回 int：0=等到、非0=超时。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
2026-10-10 feat(mem): 统一存储器 32KB -> 64KB —— 32KB 墙拆了
    ## 改动范围（27+ 个文件）
    RTL 四处（都带断言，改不到就报错）：
    rtl/mem/unified_mem.v mem0/mem1 数组 [0:8191] -> [0:16383]；三个地址口 13 -> 14 位
    rtl/core/core.v imem_addr = fetch_addr[14:2] -> [15:2]；端口宽度
    rtl/bus/mem_bus.v ram_word 切片、ram_hit 范围 0x0~0x7FFF -> 0x0~0xFFFF、
    兼容区译码 12'h7FF -> 12'hFFF
    rtl/bus/addr_map.vh RAM_LAST_BYTE 0x7FEF -> 0xFFEF、LEGACY_HI_BYTE 0x7F -> 0xFF
    新地址映射：
    RAM 0x0000_0000 ~ 0x0000_FFEF (65,520 字节)
    兼容区 0x0000_FFF0 ~ 0x0000_FFFF ← 从 0x7FF0 搬过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
2026-10-10 fix(rtthread): build.ps1 的 $ramTotal 硬编码 0x8000(32KB) -> 0xF000(60KB)
    扩内存后漏改的一处：报'静态占用 21521/32768 字节(65.7%)'，实际可用已是 60KB。
    顺带修 throw 消息里写死的 '32KB'。
    实测：RT-Thread 镜像 21,521 字节，**堆从 3,800 涨到 36,568 字节**（扩内存的直接收益）。
2026-10-10 feat(gomoku): 入口拆分 —— main() -> gomoku_run() + main_entry.c（H 的第一帧）
    为 RT-Thread 版五子棋（任务 H）铺路。
    ## 为什么拆
    五子棋要同时跑在【裸机】和【RT-Thread】两种宿主上，而 RT-Thread 自己也有一个
    `main()`（它的入口线程）。**两个 main() 在链接期必然冲突。**
    拆法：真正的应用逻辑叫 `gomoku_run()`（在 main.c，for(;;) 不返回），
    **入口按宿主分开**：
    · 裸机 -> 新增的 `main_entry.c`（main() 直接调 gomoku_run()）
    · RT-Thread -> scripts/rtthread/app/main.c（建线程调 gomoku_run()）【待做】
    [!] `scripts/rtthread/build.ps1` 的源文件清单里**不能**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
2026-10-10 wip(rtthread): 五子棋跑在 RT-Thread 上（任务 H 第一帧）+ 记录中断点
    上个会话因上下文溢出（1.017M tokens，compaction 也超限）在 13:17 中断，
    这三个文件是中断时工作区里未提交的内容，先固化下来，避免丢失。
    - app/main.c：RT-Thread 入口由 ping/pong 验证程序换成真应用 ——
    main 线程建一个 gomoku 线程，游戏在 gomoku_run() 里跑（单线程版）
    - build.ps1 / tb_rtthread.v：配套的 -Sim 口径
    - 2026-10-10_session_state.md：补 §7 中断点 + 两位新归档位流（d9ee1cfe / 1c5f0354）
    仿真现状（已知）：RT-Thread 起来了、gomoku 线程跑了、banner 打出来了，
    但主线程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
2026-10-10 docs: CLAUDE.md 加「会话纪律（防上下文溢出）」
    2026-10-10 的会话 c14ae61b 撞到 1,017,073 tokens（上限 1,048,576），
    连 /compact 都失败（压缩请求本身要装下整段对话）→ UI 完全无响应、只能弃会话。
    根因是工作模式：该会话跨 7 天、在三个仓库间来回干。
    新条款把防法写成可执行规则：一会话一里程碑、盯状态栏 ctx%（65% 收尾 /
    75% 别开新线）、里程碑处主动压缩、长报告交子代理读、结论落盘优先。
    另附「万一还是撞了」的恢复步骤（进度在 git，不在对话）。
2026-10-10 fix(rtthread): 测试台接上视频口 —— 五子棋读显存区把悬空 vid_rdata 读成 Z，CPU 在 16ms 变 X
    上个会话把任务 H 卡在"主线程心跳没出现"，定位成 HB_DELAY_MS 没传下去。补上
    -DHB_DELAY_MS=20 之后心跳【依然】不出现 —— 说明那个定位是错的。
    逐拍诊断（直接读固件里的 rt_tick / rt_interrupt_nest）给出真因：
    t≈2ms tick=2 pc=0x000050b8
    t≈15ms tick=14 pc=0x000050ac
    t≈17ms tick=16 pc=0xxxxxxxxx <- PC 变 X，CPU 已经没了
    t≈25ms tick=16 （再也不动）
    tick 一直在走 ⇒ 定时器中断、rt_hw_timer_init、CSR 通路全是好的；死因是整条
    流水线被 X 污染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
    [tb_rtthread.v]
2026-10-10 docs: 会话备忘 §7 任务H卡点结案（真因是 vid_rdata 悬空 → X）+ 记 §8 imem_addr2 截位潜伏 bug
2026-10-10 fix(core): imem_addr2 截位 —— 64KB 扩容时漏改的宽度；顺手补齐测试台里同类的 imem_addr
    ## 症状
    取指地址 ≥ 0x8000（8192 word）时，双发射的第二取指口（lane B）会从低 32KB
    里取【错地方】的指令。`pair_now` 的判据用的正是 `imem_rd2`，所以一旦那条
    错取来的位置恰好非零，就会拿一条错误的指令去配对 —— **执行错指令**。
    ## 根因
    2026-10-10 把统一存储器从 32KB 扩到 64KB 时，`imem_addr` 跟着变成了 14 位，
    但 `imem_addr2` 留在了 13 位：
    rtl/core/core.v:19 output wire [12:0] imem_addr2, <- 应为 [13:0]
    rtl/core/core.v:570 assign imem_addr2 = imem_ad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
2026-10-10 chore(scripts): iverilog 的「端口宽度不一致」警告升级为硬错误
    这类警告**没有一条是良性的** —— 它就是静默截位：
    rtl/bus/mem_bus.v:182: warning: Port 5 (a2_addr) of module unified_mem
    expects 14 bit(s), given 13.
    2026-10-10 实踩就是这么坏的：64KB 扩容时 `imem_addr2` 漏改，iverilog 每次
    仿真都在报这行，但没人看，于是"取指地址 ≥ 0x8000 时双发射 lane B 取错指令"
    躲过了全部四条基线（当时所有程序代码都 < 32KB）。
    现在四个回归脚本（run_riscv_tests / run_coremark / run_own_tests /
    rtthread\run_sim）编译完就扫一遍，命中就抛异常并打印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
2026-10-10 build+docs: 归档 f00c6659 位流；CLAUDE.md 记约定 40/41；会话备忘 §7/§8 结案
    ## 位流
    重新综合（多 seed ×8，gomoku 变体，含 imem_addr2 宽度修复）：
    | | 改前 `3418c5fc` | 改后 `f00c6659` |
    |---|---|---|
    | CPU 域 slack | +0.064 ~ +0.086 ns | **+0.236 ns** |
    | CPU 域 Estimated | 85.63 MHz | **86.75 MHz** |
    | CPU 域失败端点 | 0 | 0 |
    | CPU→video 跨域 | −1.084 / 21 端点 | −1.036 / 21（**原样存在，与本改动无关**）|
    已归档 `bitstreams/gomoku_dual_aext_ms_85mhz_addrfix_f00c6659.sbit`。
    **未上板验证** —— 并且 `bitstreams/` 里那些"已实测"的位流现在都**不再对应源码**。
    `RV32I_1.pds` 的改动是 P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
2026-10-10 docs(board): 归档 2026-10-10 位流 A/B 日志（3418c5fc vs f00c6659）+ 判读
    两份日志都在 `D:\riscv-cpu-fpga`（单仓）的 doc/board 下，抄一份到主线仓。
    uart_20261010_143501.txt HARD(6-ply) 开局 3 手 AI 2,003~4,971 ms / 3,894~10,592 节点
    uart_20261010_144054.txt NORMAL(4-ply) 下到 WHITE wins AI 390~554 ms / 696~1,287 节点
    **两版都正常，但这不足以区分两版位流 —— 而这是预期结果。**
    `f00c6659` 相对 `3418c5fc` 只改了 `imem_addr2` 的位宽，取指地址 < 0x8000 时
    两者逐位等价，而五子棋代码只有 11.5 KB。所以这次 A/B 证明的是
    **「重新综合（多 seed ×8）后的网表没被改坏」**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
2026-10-10 docs(board): 更正 A/B 日志计数（14:35 是 2 手不是 3 手；14:40 是 5 手）
2026-10-10 feat(csr): mimpid 承载设计版本号，三份固件把它打在串口第一行
    ## 为什么
    **两版位流可以装着完全相同的固件**，串口日志因此一模一样，事后分不出烧的是
    哪一版。2026-10-10 实踩：`3418c5fc`（多 seed）与 `f00c6659`（多 seed + imem_addr2
    宽度修复）各跑一局五子棋，两份日志无法区分（见 doc/board/README.md）。
    所以版本号必须来自 **RTL 侧**才有区分力。
    ## 怎么做的
    * `rtl/core/csr_file.v` 新增 `DESIGN_REV = 32'h2026_1010`，由**只读 CSR
    `mimpid`（0xF13）**读出。选它而不是新加 MMIO 寄存器的理由：它是规范里的
    只读 ID 寄存器，**不用动地址映射、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
    [csr_file.v]
2026-10-10 build: CoreMark 位流重建（含 imem_addr2 修复 + mimpid 版本自证）—— 492714a8
    `scripts\build_bitstream.ps1 coremark`（ITER=3170，双发射，多 seed ×8）：
    | | 值 |
    |---|---|
    | md5 | **`492714a8`** |
    | CPU 域 slack | **+0.525 ns**（Estimated 88.98 MHz），**失败端点 0** |
    | CPU→video 跨域 | −1.087 / 21 端点（**原样存在，与本次改动无关**）|
    | mem.hex 同步校验 | 8456 行 / 4228 字，sha256 与 sim/programs/mem.hex 一致 [OK] |
    已归档 `bitstreams/coremark_dual_aext_ms_85mhz_mimpid_492714a8.sbit`。
    **尚未上板** —— 烧上去串口第一行应是 `[build] FW=COREMARK RTL=0x20261010`。
    ## 顺带：expectLines 实测更新（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
2026-10-10 docs: 队友任务书合并成「总入口」；CoreMark 板上实测 270.82（与修复前逐位相同）
    ## 1. 任务书：把应用侧和覆盖侧合成一份总入口
    `doc/reports/2026-10-10_handoff_coverage.md` -> `2026-10-10_handoff_teammate.md`，
    重写成**队友的总入口**。之前那份只有覆盖侧（AMO / >32KB），
    **漏了应用侧待做的 C/D/E/F/H** —— 那些在 `2026-10-10_taskbook_v5.md`
    §3.3–3.6 里，但没人会把两份串起来看。
    现在一份讲清：
    * §0 三十秒版 + **已完成清单（别再重做）**：v5 的 A/B（必修）已修、G（64KB）已做、
    H 的单线程版仿真已 PASS
    * §1 **应用侧待做**：C 菜单系统 / D HUD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
2026-10-10 chore(scripts): 交接包输出目录改到 Desktop\RV32I\交接文件，并加日期后缀
    用户 2026-10-10 指定：以后给队友的包一律放 `Desktop\RV32I\交接文件\`
    （就是队友发来的包所在的那个文件夹）。之前是一层之上的 `Desktop\RV32I\`。
    * `$out` 改为 `C:\Users\zjn\Desktop\RV32I\交接文件\riscv-cpu-fpga_dualissue_<yyyyMMdd>.zip`
    —— **带日期**，免得两次交接静默互相覆盖；这也是该文件夹既有的命名惯例
    （`riscv-cpu-fpga_dualissue_20261006.zip` 等）。
    * [!] **路径含中文 → 本脚本必须带 UTF-8 BOM**。脚本头部原来写着"故意保持纯
    ASCII"，因为 PS 5.1 会把无 BOM 的 `.ps1` 按 G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
2026-10-10 fix(coremark): 版本号那行不能走 ee_printf —— 它会把 +PROF 的计时区间静默打坏
    `+PROF` 跑出来 `region cycles / commit / mem acc` **全是 1**，流水线分解数据全部失效。
    而 `Total ticks` 仍然是对的（313,886），所以光看跑分**完全看不出来**。
    这是我在 afaac6a 里加版本自证那行时自己引入的。
    `sim/tb_coremark.v` 判定"CoreMark 计时区间"的判据是：
    **第 1 次 / 第 2 次读 `0xFFF4`** 之间。这条判据成立的前提是
    **CoreMark 在 `start_time()` 之前一个字都不打**（已核对 `core_main.c`：
    `start_time()` 在 265 行，所有 `ee_printf` 报告都在 284 行的 `stop_tim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
2026-10-10 docs(taskbook): 新任务书 v6「CPU 优化优先」+ 配对率实测（推翻"配对是主因"的假设）
    用户 2026-10-10 拍板：**先优化 CPU，后做应用场景**。据此新建 v6，并把
    v5/handoff 里的应用侧任务全部标为"排在 CPU 阶段之后"。
    ## v6 的核心内容（都是实测，不是推理）
    **对标（别人给的两份数据）**：CoreMark/MHz 我们 **3.186** vs 他们 4.216 / 4.958。
    时钟同档，差距在**每迭代拍数**（313,886 vs 237,259 / 201,707）。
    **先排除三个常见嫌疑**：
    * 时钟 —— 同档，不是原因；
    * 分支预测 —— 他们 A 误预测率 **5.478%**，我们 **3.5%**，**我们更好**；
    * Cache ——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
2026-10-10 review+docs: 复核队友的阶段0/阶段1 —— 通过，实测 262,018 拍（−16.5%）+ slack +0.544 ns
    复核对象：`Desktop\RV32I\交接文件\riscv-cpu-fpga_dualissue_20261010（01阶段）.rar`
    （基于 aa33847，改动未提交）。在**隔离副本**里跑，未动主线仓。
    ## 结论：通过，可以合并
    | 检查 | 结果 |
    | riscv-tests 双发射 / 单发射 | **49/1/0** 两边都是 ✓ |
    | 自写测试 | **2/0** ✓ |
    | **CoreMark 双发射** | **262,018**（阶段0 282,777 → 再降 **−7.34%**）|
    | **CoreMark 单发射 -O3** | **312,428**（旧 -O2 = 363,515；**队友没量过**）|
    | 四个 CRC | 逐位不变 ✓ |
    | **PDS 时序（最高风险点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
2026-10-10 merge: 队友的阶段0（-O3 编译选项）+ 阶段1（到达级重定向）—— 并修复合入其 4 处未同步
    合并来源：`Desktop\RV32I\交接文件\riscv-cpu-fpga_dualissue_20261010（01阶段）.rar`
    （基线 aa33847，改动为未提交的工作区状态）。用 `git diff` 生成补丁 apply 到主线，
    **不清空主线自 aa33847 以来的任何提交**。
    ## 合入的改动（队友的）
    * `rtl/core/core.v`：删 ID 级 `id_redirect`/`id_target`，新增到达级
    `p_redirect`/`p_target`（第三个 `imm_gen` 实例算 `if_addr_d + imm`）+
    进位寄存器 `if_id_pred_taken`；`p_redirect` 不再清 IF/ID。
    * `rtl/core/csr_file.v`：`DESIGN_REV = 0x2026_1011`（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
    [csr_file.v]
2026-10-10 build: 归档阶段0+1 的 CoreMark 位流 4f1b0977（ITER=3796）+ 位流 README 更新
    `scripts\build_bitstream.ps1 coremark`（双发射，ITER=3796，多 seed）：
    | 项 | 值 |
    | md5 | **`4f1b0977`** |
    | CPU 域 slack | **+0.544 ns**（Estimated 89.13 MHz），失败端点 **0** |
    | mem.hex 校验 | 16846 行 / 8423 字，sha256 与 sim/programs 一致 [OK] |
    | DESIGN_REV | **0x2026_1011**（串口第一行自证）|
    已归档 `bitstreams/coremark_dual_aext_ms_stage01_4f1b0977.sbit`。
    > [!] README 里标明：**`7b6e5e05` 是复核阶段的中间产物（ITER=3518，11.70→10.84 s），
    > 别烧它**；当前源码对应的是 `4f1b0977`。旧位流读出的 `RTL=` 是 `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
2026-10-10 docs(bitstreams): README 标明 4f1b0977 是当前源码对应位流；7b6e5e05 是复核中间产物别烧；补 RTL= 值区分网表代次
2026-10-10 docs(board): 板上实测 324.5 分（阶段0+1，位流 4f1b0977）；查明板/仿真差 48 拍是 ITER 效应不是模型误差
2026-10-10 docs(taskbook): v7 —— 阶段0/1 板上实测 324.5 分；提频试验失败（85 MHz 是上限）；下一步 Cache（不做 DDR3）
    ## 阶段 0 + 阶段 1：完成，板上实测 324.5 分
    `270.82 → 324.5`（**+19.8%**），位流 `4f1b0977`，日志 `doc/board/uart_20261010_224932.txt`。
    第一行 `[build] FW=COREMARK RTL=0x2026_1011` 自证网表代次，四个 CRC 全对。
    ## 【重要】提频试验：85.0051 MHz 就是上限，别再试
    `STATIC_RATIO0` 13.5 → 13.0（85.00 → 88.27 MHz），实测：
    请求 88.2768 MHz -> Estimated 77.4473 MHz Slack -1.584 ns
    **[重点] 这不是"余量不够"，是工具行为** —— place 阶段的 8-seed 指标从 85 MHz 时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
2026-10-10 chore: 删掉提频试验留下的 pll.idf 备份（git 历史就是备份）
2026-10-10 build: 提频失败后盖回 85MHz 位流（da8a596a，slack +0.544 ns 与基线逐位一致）—— 约定 23 要求的还原动作
2026-10-11 wip(pnr): RATIO0 13.5 -> 13.25（86.6 MHz 提频试验的开始）+ PDS 回写工程文件
    > [!] **失败证据 .rtr 没能进这个提交** —— `.gitignore:61` 把整个 `pds/**/report_timing/`
    > 排除了。先前那份 `aext_85mhz_FAIL_-0.096ns.rtr` 也是同样情况（`git ls-files` 里 0 个）。
    > **项目既有做法就是"证据留在磁盘上、由文档引用"**，这里照办：
    > 证据在 `pds/RV32I_1/report_timing/oclk_88mhz_FAIL_-1.584ns_376endpoints.rtr`，
    > 由 `doc/reports/2026-10-10_session_state.md` 与 v7 任务书引用。
2026-10-11 docs+pnr: 提频三点实测完成（86.61 MHz 也失败，且比 88.28 更差）；PLL 回退 13.5 并重综合还原
    ## 提频试验：三点数据齐了，边界钉死
    | 请求频率 | RATIO0 | Estimated | **slack** | CPU 域失败端点 | TNS |
    |---|---|---|---|---|---|
    | **85.0051 MHz** | 13.50 | 89.1266 | **+0.544 ns** | **0** ✓ | 0 |
    | **86.6101 MHz** | 13.25 | 73.1368 | **−2.127 ns** | **1402** | −1095.4 |
    | 88.2768 MHz | 13.00 | 77.4473 | −1.584 ns | 376 | −217.5 |
    **[重点] 86.61 比 88.28 还差** —— 所以这不是"越紧越差"的单调关系，
    是**工具在紧约束下行为不稳定**（place 阶段 8-seed 指标：85 MHz 是 −1.10~−1.15，
    另两档都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
2026-10-11 feat(cache): 并入队友 A.0/A.1 + 实现 16KB 2 路组相联 D-Cache（默认关）
    一、并入队友 2026-10-11 的 A.0 + A.1（用户 15:15 收到的 (2) 包）
    * A.0（mem_ready 收尾）：三条修复
    - mem_bus：mem_ready 只在【真的有一次 RAM 访存在途】时跟随 ram_ready
    （原来只看 ram_hit，非访存指令的 alu_result 落在 RAM 段也会被拉低）
    - core.v：新增 wb_rdata_snap —— 访存停顿时抓一次读数据快照，否则
    MEM/WB 冻多拍后 mem_rdata 已跟随更年轻的指令，写回值被改错
    - core.v：EX/MEM 的清除门控补 mem_ready_int —— 访存停顿与 mc_stall
    可同时成立，否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
2026-10-11 feat(cache): I-Cache（16KB/2 路组相联，默认关）+ 外设 one-shot 门控
    一、rtl/bus/cache_i.v（新）
    * 只缓存 A1（imem_addr）；A2（imem_addr2 = A1+1）仍直通 BRAM —— 它恒 1 拍就绪、
    与 A1 天然同拍，缓存它要多两个数据阵列 + 两套 tag，只是白花面积。
    * 取指口没有就绪信号，所以借 mem_ready 当取指停顿（core 的 freeze 通路本来
    就把"重读同一地址"做得严丝合缝），**core.v 零改动**。
    二、[重点] 取指 Cache 的两个坑（都实测踩到，见 cache_i.v 文件头）
    1) stall 不能直接组合去压 mem_ready：取指地址就是 fetch_addr，而 fetch_addr
    的组合 mux 里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
2026-10-11 docs(cache): Cache 收口 —— 四个时序配置实测 + 答辩口径 + 会话备忘
    一、时序实测（同一份 RTL、同一 85.0051 MHz 约束，只改 Cache 开关/容量）
    | 配置 | CPU 域 slack | 结论 |
    | 完全不开（生产口径） | +0.544 ns | 收敛 |
    | 只开 I-Cache（16KB） | −1.128 ns | 不收敛 |
    | I+D（16KB） | −1.586 ns | 不收敛 |
    | I+D（缩到 4KB） | −1.092 ns | 不收敛 |
    ⇒ **85 MHz 下塞不进任何形态的 Cache**。缩面积只解决三分之一，
    剩下的是逻辑深度（BRAM 输出 → tag 比较 → way mux → mem_rdata）。
    二、[重点] 降频演示这条路是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
2026-10-11 build(cache): 生产位流重出并归档 —— md5 03d8a7eb，slack +0.578 ns（无退化）
    一、A/B 对照排除"Cache 骨架拖累生产时序"的怀疑
    同一个命令（pds_shell -run pnr）分别跑基线 RTL 与改动后 RTL，各读
    place_route/seed_<best>/cpu_top_board.rtr：
    * 基线（commit ede2d3b）：+0.544 ns / 89.127 MHz
    * 本会话（Cache 全关）：**+0.578 ns / 89.398 MHz** ⇒ 无退化
    [!] 两个坑记下来（写进 doc/reports/2026-10-11_cache_impl.md §7.2b）：
    1) `report_timing/cpu_top_board.rtr` 里可能是【上一次】留下的旧文件 ——
    差点据此误判"关掉 Cache 还退化 1.2 ns"。
    2) 8-seed 的 `Setup(Slow)`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
2026-10-11 docs(session): 会话备忘定稿（生产位流 md5 03d8a7eb、无退化、未上板）
2026-10-11 feat(taskC): 假 AGU 探针 + 任务 C 时序评估完成（+0.148 ns，可行但余量仅 1.3%）
    一、探针（rtl/core/core.v 的 AGU_PROBE，默认 0）
    插「寄存器堆读 → 前递 mux → 32 位加法器 → ID/EX」—— 即任务 C 把访存地址从 EX
    搬到 ID 后 ID 级多出的那条路径。**喂真实信号**（rdata1 / ex_mem_forward_val /
    ex_mem_reg_write）防综合器当冗余删掉（A.1 的教训）；结果经 mem_bus 的只读
    MMIO 0x8000_0028 回读。透传链：core → cpu_top → mem_bus。
    默认关时 agu_probe 恒 0，功能与周期逐位不变（已复测 6/6 PASS）。
    二、实测（各 8-seed，读 place_route/seed_<best>/cpu_top_board.rtr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
2026-10-11 docs(session): 补任务 C 时序评估结论与推进顺序
2026-10-11 perf(core): 任务 C 第一步 —— load 地址提前到 ID（EARLY_LD），每迭代 -5.48%
    把 load 的地址算到 ID 级、用【第三份阵列的专用读口】早一拍取回数据，紧跟其后的
    load-use 停顿因此消失。262,018 → 247,662 拍/迭代（-14,356，-5.48%）。
    实现（全部在 core.v；开关 EARLY_LD，cpu_top.v 默认 1）：
    * ID 级 AGU：寄存器堆读 → ID 前递网 → base+imm，结果寄存进 ID/EX
    * 专用读口：unified_mem 加第三份阵列（mem2，写口同样广播；EARLY_LD=0 不例化），
    地址由 ID/EX 驱动 → 数据正好在该 load 的 MEM 级回来
    * 新增前递一路：EX/MEM 里那条快通路 load 的数据 → 消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
2026-10-11 perf(core): 任务 C 完成 load-use 路径 —— 每迭代 -7.79%（20,385/24,568 = 83%）
    在已提交的第一步（db59d5d，262,018 → 247,662）之上补两条，最终 **241,633 拍/迭代**：
    1. **ID 级基址也可来自 EX/MEM 里的快通路 load**（链式指针解引用 `lw a5,0(a0); lw a1,0(a5)`，
    占 CoreMark load 的 22%）——再兑现 6,029 拍。
    [!] **只接【字 load】**（funct3==010）：byte/half 当基址要先解包，那几级会顶替乘法器
    成为 CPU 域最差路径；字 load 不需要解包，**周期数一模一样**却省下 3~4 级。
    2. **快通路 load 的写回改走既有的 `wb_rdata_snap`**（A.0 那个冻结快照寄存器），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
2026-10-11 docs(cache): 任务 C 之后重测 Cache 时序 —— D-Cache 代价消失、I-Cache 仍塞不进，收益仍是 0
    同一台机器、同一套 pds_shell -run pnr，只换 Cache 开关（各一次 8-seed 流程）：
    | 配置 | C 之前 | C 之后 |
    | 都不开 | +0.544 | +0.045 |
    | 只开 D-Cache | — | +0.151 ✓ |
    | I+D 全开 | −1.586 | −0.844 ✗ |
    * **D-Cache 的时序代价消失**：任务 C 让快通路 load 不再占用 B 口（mem_re 被抑制），
    tag 比较 + way mux 整体离开访存关键路径 —— 2026-10-11_cache_impl.md §7.4 的假说成立。
    * **I-Cache 仍塞不进**（再吃 ~1 ns）：它挂在取指链上，任务 C 没动取指链。
    * **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
2026-10-11 build(coremark): 出任务 C 生产位流并归档 —— md5 2ddaf32f，CPU 域 slack +0.045 ns / 失败端点 0
    * 位流：`bitstreams/coremark_dual_aext_ms_stage01_earlyld_2ddaf32f.sbit`（ITER=4116）
    预期板上 `Total ticks ≈ 994,561,428` → 11.70 s → **≈352 分**（原 324.5）。**未上板。**
    * 时序：CPU 域 **+0.045 ns / 0 失败端点（16,484 端点）**；
    两条跨域违例（`u_pll→u_video` −1.081 / 21 端点、`u_video→u_pll` −0.325 / 1 端点）
    在历史每一份报告里都在，与本轮无关。
    * **文档补正两处不严谨的说法**：
    1. slack **可复现**：最终版连跑三次 P&R 都是 +0.045 ⇒ 之前那组
    +0.208/+0.035/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
2026-10-11 docs(board): 任务C 板上实测通过 —— 351.8 分（位流 2ddaf32f，日志 uart_20261011_225624）
    * Total ticks 994,362,145 → 11.6976 s，四个 CRC 与仿真逐位相同，Correct operation validated
    * 每迭代 241,584 拍（仿真 241,633，−0.02%）—— 板/仿真差仍在抖动带内
    * 得分 4116 ÷ 11.6976 = 351.8（上一代 4f1b0977 是 324.5 ⇒ +8.4%）
    * 入库：doc/board/README.md 新增「当前最强口径」一节 + 证据清单；CLAUDE.md 约定 45、
    任务C 报告 §3.3、会话备忘同步。
2026-10-11 build(script): 新增 -DCacheOnly（只开 D-Cache）—— 实测 D 在 85 MHz 下不亏余量（+0.151）
    * I+D 全开仍不收敛（−0.86，8 seed 全负）；根因是【布局拥塞】不是逻辑深度：
    关键路径 u_dcache 数据阵列 → … → icache_hits 计数器，15~17 级、Route 占 63%（7.8 ns，
    是不开 Cache 时 3.5 ns 的两倍多）⇒ 继续压逻辑没用，降频那条路也已被约定 43 证明不可靠。
    * 所以把'85 MHz + 2 路组相联 D-Cache'做成可交付的一版：-Cache 仍是 I+D（配合降频用），
    新增 -DCacheOnly = 只开 D。两者都在 finally 里自动还原 cpu_top.v。
2026-10-11 docs: RVC 可行性评估（不做）+ Cache 阶段性总结与交接节（taskbook v7 §8）
    RVC 评估（新报告 doc/reports/2026-10-11_rvc_feasibility.md）——**[X] 不建议做**：
    * 实测（同一份 CoreMark 只换 -march）：**指令条数 7,885 → 7,939（+0.7%，几乎不变）**，
    只有编码变小（平均 4.00 → 3.30 字节/条，.text −17.3%）⇒ **RVC 不删指令、只压编码**。
    * 我们"单周期 BRAM 后端 + 双口取指每拍两条"两处都不吃密度红利 ⇒ **分数收益 ≈ 0**；
    代价是 `+4`→`+2/+4` 散布全设计（且落在最差那条链上）+ 取指对齐器 + 双发射配对重做。
    * **对手领先的不是 RVC，是 IPC**：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
2026-10-11 build(cache): D-Cache 版位流（真·带 Cache）归档 + 修 -DCacheOnly 静默失效 + 约定 46
    ## 交付：D-Cache 位流（85 MHz 下带 2 路组相联 D-Cache）
    `bitstreams/coremark_dual_aext_ms_stage01_earlyld_dcache_2f7a4d0a.sbit`（md5 `2f7a4d0a`）
    * CPU 域 **+0.151 ns / 失败端点 0**（Cache 关是 +0.045），DRM **105.5/415**
    * **网表已验**：`dcache` 653 处、`tag0` 100 处、`icache` **0** 处（= 只开 D，符合预期）
    * ITER=4116，预期板上 ≈351.3 分（241,998 拍/迭代），串口 `[cache] D hits/miss` 应非 0。**未上板**
    ## 修：`-DCacheOnly` 曾经【静默失效】
    我上一版把该分支里的 `[System.IO.File]::WriteAllText($cpuTopFile,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
2026-10-11 docs(board): D-Cache 板级验证通过 —— 命中率 99.93%、CRC 逐位相同、代价与缺失数逐项闭合
    位流 2f7a4d0a（只开 D-Cache，ITER=4116），日志 doc/board/uart_20261012_002541.txt：
    * [cache] D hits=35,341,114 / miss=25,081 ⇒ 命中率 99.929%（I-Cache 按设计为 0）
    * Total ticks 994,386,960 → 11.69797 s → 351.86 分（关 Cache 版 994,362,145 → 351.86）
    * 四个 CRC 与关 Cache 时逐位相同 ⇒ Cache 只改周期、不改结果
    * 拍/迭代 241,590.6 vs 关 Cache 241,584.6 = +6.0 拍；而每迭代缺失 6.09 次 × 1 拍 ⇒ **逐项闭合**
    * 口径提醒：板上热态 99.93% / 仿真 ITER=1 冷态 93.5% / 旧报告 98.47%（任务C 之前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
2026-10-11 docs(cache): D-Cache 板上实测数据同步进 bitstreams 索引与 taskbook §8.3
    * bitstreams/README.md：2f7a4d0a 标记【已上板】+ 实测四行（ticks/得分/命中率/CRC）
    * taskbook §8.3.4 与 §8.3.2：把'未上板'改成板上实测，并把'+0.15%'更正为
    板上真值 +6.0 拍/迭代（仿真 ITER=1 的 +0.15% 是冷启动口径，别当稳态）
2026-10-11 docs(cache): 修正容量口径 —— 实现是【4 KB/侧】不是 16 KB（mem_bus 从未传 IDX_BITS）
    实据两条：
    * `git log -S IDX_BITS -- rtl/bus/mem_bus.v` 为空 ⇒ 从未传过该参数，走模块默认 IDX_BITS=9
    = 512 组 × 2 路 × 1 字 = 4 KB/侧
    * D-Cache 位流（2f7a4d0a）DRM 只比 Cache 关时多 4 个 ⇒ 与 4 KB 数据阵列相符（16 KB 要约 8 个）
    此前多份文档把"模块注释里那句『16KB 用 11』"当成了"现在的配置"，全部更正：
    CLAUDE.md 约定 43、cache_impl.md §1、taskbook §8.3.1、cache_d.v/cache_i.v 头注释。
    并注明 16 KB/侧 只是把 IDX_BITS 改成 11 的放大选项（评估表里那两行是手工放大后量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
2026-10-11 fix(pll): 把 PLL 还原回 13.5（85.0051 MHz）—— 上一提交误把实验中的 15.0 提交了
    * 45f10d2（"4 KB 修正"）打进去时，工作区里还有降频实验留下的 PLL 15.0，
    我只剔除了 cpu_top.v、漏了 ipcore/pll/ 三个文件 ⇒ **HEAD 复现不出 85 MHz 跑分位流** ✗
    * 本次把 pll.idf / pll.v / .last_generated 还原为 13.5，并恢复 pds 工程里的生产版 mem.hex
    （降频实验用的是 76,505,200 口径的固件）
    同时入库（本轮 I+D 完整条目的评估与交付）：
    * 新报告 doc/reports/2026-10-12_handoff_completeness_first.md —— 方针（功能完整优先、兼顾性能）、
    I+D 降频实测（76.5 MHz slack +0.435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
2026-10-11 docs+bits: I+D 板级失败记录 + 二分位流（D-only@76.5MHz, a69a19b5）
    ## 失败事实（已入库，别再误当"上板路径已找到"）
    I+D @76.5 MHz（fa957dbd）**板上失败**：串口只有 banner 重复 **≈590 次/秒**、无任何 CoreMark 输出
    ⇒ CPU 跑飞→非法指令→mtvec(=0)→反复从头跑。日志 doc/board/uart_20261012_01031[4]_*.txt。
    ## 已排除 + 新证据
    * 排除：串口/时钟配错（文本可读 ⇒ 板上确是 76.5 MHz）、不收敛（setup +0.410 / 0 失败端点）、
    "I-Cache 回填写错行"那一类（cache_i.v 已有 idx_r/tag_r 快照）。
    * **新证据**：I+D 的 **ITER=3 仿真四个 CRC 全对**（794,504 拍 = 264,835/迭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
2026-10-11 fix(fw): PDS 工程里的 mem.hex 还原为生产固件（ITER=4116 / 85.0051 MHz）
    降频实验把 76,505,200 口径的固件（ITER=3700）同步进了 pds/RV32I_1/mem.hex，
    而时钟已还原成 85 MHz ⇒ 若此时综合，会得到"85 MHz 时钟 + 76.5 MHz 口径固件"的错配位流
    （CoreMark 的时长/得分全错，且看不出来）。已重新生成生产固件并同步、校验 sha256 一致。
    状态核对（HEAD）：cpu_top.v DCACHE/ICACHE=0、EARLY_LD=1；pll.idf RATIO0=13.500000；
    UART_DIV=738；EE_TICKS_PER_SEC/CPU_HZ/BOARD_SYSTEM_CLOCK_HZ=85,005,100 ✓ 全部为跑分口径。
    另：用户 01:12:52 又收到一份同样的 banner 反复日志（doc/board/uart_20261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
2026-10-11 docs(board): 二分定位成功 —— D-Cache@76.5MHz 板上通过 ⇒ I+D 的故障锁定在 I-Cache
    * a69a19b5（只开 D + 76.5 MHz）板上完美通过：Total ticks 893,885,762 → 11.6842 s、
    四个 CRC 逐位相同、[cache] D 命中率 99.93%、[cache] I 全 0、得分 316.7
    * ⇒ 76.5 MHz 口径（RATIO0/4 处常量/固件/降频）全部正确；I+D 的反复重启 100% 是 I-Cache
    * 静态检查已排除：cache_i.v 的 tag 与数据回填都用快照 idx_r（自洽）；
    cache_d.v 用当拍 idx 也自洽（其地址在停顿期间被冻结）⇒ 不是'tag/数据写不同行'那类
    * I-Cache 的下一步：①I+D 仿真加长到 ITER≥50（板上 ~13 万拍就崩，仿真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
2026-10-11 docs: 全仓文案查错 —— 把"任务 C 之前"的过时结论标注清楚（避免重新犯错）
    用户要求"检查错误和过时文案"。查出并修正 4 类：
    1. **会话备忘**（最常被读）：原写"Cache 默认必须关（85 MHz 下塞不进任何形态）" ✗
    已过时 ⇒ 改为：只开 D **能收敛且已上板**（99.93%、351.86 分，与不带 Cache 完全相同）、
    I+D 需降频且 I-Cache 仍有板上故障。钉死结论表里那条也划掉并注明日期与原因。
    2. **Cache 报告 §7 标题**"85 MHz 下塞不进任何形态的 Cache" ⇒ 加"（任务 C 之前）"并指向 §7.5/§7.6。
    3. **Cache 报告 §1 的命中率 98.47%/99.82%** ⇒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
2026-10-11 docs(cache): I+D 的 hold 已补量（+0.100 过）⇒ 静态时序假设全排除；下一步上 ILA
    I+D @76.5 MHz 完整时序：setup **+0.435** / hold **+0.100**、0 失败端点（18,905 端点）。
    结合 ITER=50（1330 万拍）仿真四个 CRC 全对 ⇒ **逻辑正确 + 静态时序两组都过 + 板上稳定失败**
    ⇒ 只剩"物理/实现"层面；静态分析与仿真这两条路已经跑到尽头。
    下一步（交给队友）：
    1. **上 ILA 抓取指现场** —— 板上每 ~1.7 ms 复现一次，触发极易；项目已有成熟 ILA 流程
    （doc/ila_analysis.md，调试版位流已归档）⇒ 抓取指地址/指令流，看第一条错指令从哪来。
    2. **再降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
2026-10-12 fix(core): I+D 板上失败的根因是 wb_rdata_snap 取错流水级（一行）
    板上 I+D 位流（fa957dbd）"只有 banner 反复"不是物理/布局问题，是 core.v 的
    wb_rdata_snap 在【停顿沿】写成 `ex_mem_ld_fast ? ld_early_data : mem_rdata` ——
    用 EX/MEM 级（下一条）指令的信号去选 MEM/WB 级（本条）指令的数据。
    cyc=8119 停顿第一沿：MEM/WB 是普通 load（数据 mem_rdata=0），
    EX/MEM 是快通路 load（ld_early_data=0x66）⇒ 抓成 0x66 ✗（应是 0）
    ⇒ 8,124 拍跑飞 ⇒ trap→mtvec(0)→反复从头跑 ⇒ banner 循环。
    修法：停顿那支只能取 mem_rdata —— 快通路 load 在自己的前进沿已被第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
2026-10-12 feat(cache): I+D Cache 上板跑通 —— 76.5052MHz 收敛、板上 313.63 分
    本轮把"完整 I/D Cache"这条路走通了，并修正三处口径。
    ## 结果（板上实测，日志 doc/board/uart_20261012_155934.txt）
    - 位流 coremark_dual_aext_ms_earlyld_idcache_76mhz_rev1016_c6b12d95.sbit
    （RATIO0=15.0 → 76.5052 MHz；setup +0.589 / hold +0.147 / 失败端点 0；
    网表 dcache 655 / icache 670）
    - Total ticks 894,745,801 → 11.6952 s → 313.63 分（ITER=3668）
    - 四个 CRC 与关 Cache 时逐位相同 + Correct operation validated
    - [cache] I 命中 878,103,971 / 缺失 9,006,928（98.985%）、
    [cache] D 31,555,354 / 22,423（99.929%）—— I-Cache 首次板上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
    [csr_file.v]
2026-10-12 docs: 全量同步最新数据/进展 + 新增 I/D-Cache 经验记录（避免误导）
    交付给队友前把所有"当前权威文档"刷到最新，历史报告只加"已被取代"指针（不改写快照）。
    ## 口径统一（本轮定的四条基线）
    - 每迭代周期：241,633（双发射+EARLY_LD，默认=板上口径）/ 262,018（EARLY_LD=0）
    / 312,428（单发射）/ 243,933（带 Cache）
    - 得分：351.86 @85.0051MHz（ITER=4116）；313.63 @76.5052MHz（I+D，ITER=3668）
    - CoreMark/MHz：4.139（无 Cache）/ 4.099（I+D）
    ## 更新的"当前权威文档"
    - README.md：当前成绩表 + 口径块（补 I/D Cache 行、任务C、351.86/313.63）
    - doc/resou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
2026-10-12 docs: 补漏 —— README/CLAUDE/pds-README/论文草稿 最后的旧口径（313,886 当当前值）
2026-10-12 docs(taskbook): 补 §9 分支与推送约定（推 dualissue / 别动无关历史的 main）+ §10 Cache 性能账与提分路线
2026-10-12 docs: 全量口径更新至 2026-10-12（351.86/313.63）+ 论文框架 + 五子棋勘误单
    - 新增 doc/paper/论文框架_v1_20261012.md：章节骨架 + 图/表空位清单 + 口径速查表（旧→新映射）
    - 新增 doc/reports/2026-10-12_gomoku_erratum_and_task.md：五子棋线勘误单（32KB→64KB、PPU 已完工、Cache 已实现、mtime 50.5s 回绕新陷阱）+ 任务定义 T1~T5
    - CLAUDE/README/spec/base_task_status/test_report/plan：270.82/3.186/313,886/ITER=3170 等旧口径全部标注历史或更新为现行值（241,633 拍→351.86 分；I+D 243,933→313.63）
    - scripts/rtthread/README：上板状态改为已完成（2026-10-12 确认）、A 扩展结论翻案、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
2026-10-12 docs(口径): 全仓统一"当前口径"，修掉会把 CoreMark 跑成 invalid 的 ITER=3170 等过期值
    只动文档；RTL / 脚本 / 固件 / mem.hex / 位流 零改动。
    不改 doc/reports/2026-*.md（带日期的历史记录，改写即伪造证据）。
    【最严重的一类：照抄会出错的可复制命令】
    - README.md：`build_bitstream.ps1 coremark` 与 `run_coremark.ps1` 的注释里 ITER=3170
    → 4116。3170 × 241,633 ÷ 85,005,100 = 9.01 s < 10 s，照抄会被 CoreMark 判 invalid。
    - pds/README.md §4.1 的 `-Iter 3170` 命令 → `-Iter 4116`。
    - doc/paper/论文撰写思路与获奖策略.md §6.1 风险表原写"当前必须用 ITER=3170" → 改为
    "3170 已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
2026-10-12 docs(taskbook): 新增 v9 —— 赛题原文对齐 + I+D 强制保留下的提分路线 + P0-0 实测分解
    【本轮新增的赛题口径（读 D:\26嵌赛FPGA\紫光.pdf）】
    - 评分公式 (1) = Iterations/(Total_Time × Frequency) = CoreMark/MHz（频率被除掉）
    ⇒ I+D 在公式(1) 上只亏 0.96%，而不是 iterations/sec 口径的 −10.9%
    - 指标(2) 是"能达到的最高工作频率"，不是"你现在跑多少"
    - 赛题点名 BTB（目标预测），我们只有 BHT（方向预测）
    - 高阶任务① 还有一半：优化总线突发传输效率（未做）
    - 应用场景赛题点名的第一个例子就是"游戏机"
    - ILA 波形分析是明文要求（已达标）；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
2026-10-12 perf(core): A1 乘法器去阻塞（II=1 流水线）—— 每迭代 −9,288 拍，效率 +4.0%
    【改了什么】
    - rtl/core/multiplier.v：从"阻塞两拍"改成 II=1 流水线（latency 2）。
    第 0 级锁存操作数，第 1 级把【已选中的乘法结果】再打一拍；busy 恒 0。
    新增 en 输入（= mem_ready_int），见下面的坑。
    - rtl/core/core.v（12 处）：
    * id_ex_is_mul 的声明提前到 ID/EX 寄存器处（stall 要用它，iverilog 先声明后使用）
    * mul_start = id_ex_is_mul（去掉 !mul_busy）
    * mc_stall = div_stall（mul 不再冻结前端）
    * stall 加一条 mul 判据：只有"紧邻下一条就消费"才停 1 拍
    * 新增 ex_mem_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
    [csr_file.v]
2026-10-12 docs: A1 里程碑会话状态（未决项 + 路径A下一步收益排序）
2026-10-12 docs(a4): 时序悬案结案（CPU 域 +0.068 MET，-1.137 是 CPU↔视频 CDC）+ A4 口径纠正
    约定 53：判 CPU 时序只认 .rtr 的 u_pll→u_pll 那行；pds_shell -run pnr 的 Setup(Slow) 是全设计最差，被 21 条 CDC 主导，对 CPU 侧改动不敏感。
    约定 54：双发射下 commit+stall+mul+flush 不是周期划分（停顿拍与退休拍重叠）。正确口径 noretire = cycles-commit = 17,642；其中真正无解释 12,114（此前算的 6,912 是口径错误产生的假数）。
    tb_coremark.v 新增 +PROF 的 5 个互斥桶（之和须等于 tc_noret，用它自检）。
    路径 A 作战计划修正：CPU 域余量仅 +0.068 ns ⇒ A2 出局；新增 A0（修 C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
2026-10-12 docs: 第3轮收尾 —— A4 精确闭合假说 + 沙箱权限限制 + 未验证改动已还原
    A4 假说：cycles = commit + stall + 2×(flush+mispredict)，232345 分毫不差 ⇒ 非退休拍全由'分支代价2拍/次 + load-use停顿'解释，'12,114未归类'可能是'假设惩罚1拍'造成的假数。
    第2轮分桶失败原因已定位：a4_recent 把零代价的 p_redirect(22,637次) 也并进窗口 ⇒ 窗口恒热。下一会话按 session_state §10 的四步拆分验证。
    sim/tb_coremark.v 第3轮的未验证拆分已 git checkout 还原（验证过才提交）。
2026-10-12 docs: 记录带 Cache 版的 A1 结果与明天要补的时序复测
    已实测：I+D 全开版 A1 前 244,849 → A1 后 235,628 拍（-9,221/-3.77%），效率 4.085→4.244，@76.5052MHz 分数 313.63→324.7，四个 CRC 不变。
    未测：A1 对带 Cache 版的时序影响（两次 P&R 都是无 Cache 配置）。I+D 在 85MHz 的 CPU 域是 -1.143/343 失败端点，只能跑 76.5MHz；而 A1 让 LUT +228(+3.1%)，须重跑 report_timing 确认 76.5MHz 仍成立。做法与判据见 session_state 13.2。
    策略口径：即使 I+D 跑满 85MHz 也只有 360.8 分 < 365.85 —— 赛题公式(1) 是 CoreMark/MHz，频率约掉，而 I+D 每迭代周期更多(235,628>232,345)。故 Cache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
2026-10-13 docs(skill): 新增 riscv-cpu-fpga 项目技能（50 条坑的判据速查）
    - doc/skills/riscv-cpu-fpga/SKILL.md：agent 技能，与 ~/.codebuddy/skills/riscv-cpu-fpga/ 同源
    - 内容：三十秒版8条 + 当前唯一口径速查与旧→新映射 + RTL承重逻辑 + 回归判据 + CoreMark口径 + PDS上板 + ILA + 文档会话纪律 + 设计取舍口径（ma_data/Cache负收益/mtime回绕/MEIP/RVC）+ 环境速查
    - 定位：只做判据地图，细节指向 CLAUDE.md / taskbook v8 / spec.md 等权威文档，避免两份漂移
2026-10-13 prof(a4): 查清非退休拍的构成 —— '未归类 6,912 拍'从来不存在，A4 结案
    第三层归因（七个互斥桶，之和自检 = tc_noret = 17,642）：
    分支代价 ~5,645 拍(2.43%) = 1 拍/次 x (ex_flush 3,826 + mispredict 1,543)
    load-use 停顿 ~6,171 拍(2.66%) —— 气泡在 stall 消失后 2~4 拍才到 WB，所以先前看起来'无解释'
    残余 2,731 拍(1.18%)（此前假数 6,912、中间 12,114）
    副产物：分支惩罚实测恰为 1 拍/次（5,382 ~= 5,369），与文档吻合 ⇒ 分支线已到设计下限，只能靠减少误判次数（A3/B1）。
    教训：数字巧合不能当证据 —— 那条 232345=214703+6904+2x5369 的精确等式按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
2026-10-13 docs: 勘误 —— A0（修 CDC 约束）是死胡同，.fdc 里早有否证记录
    我在第2/3轮把 A0 列为'白送的时序收敛、建议优先'，是错的：当时只判断'那22条是跨域路径'，没读 .fdc 第96~132行。
    .fdc 记录（2026-09-27）四种写法全部实测不成立：set_clock_groups -asynchronous（时钟名还不存在）/ set_false_path -to [get_pins]（E级错误，综合当场中止，比不写还糟）/ 厂商层次写法与 -of_objects -filter（Pin not found / -filter 未定义）/ -asynchronous -derive（批处理解析器不认）。
    根因：.fdc 命令都在 Constraint check 阶段跑完，而三路 PLL 输出时钟是 PDS 读完本文件之后才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
2026-10-13 exp(a3): BHT 256→1024 实测只值 -233 拍(+0.10%)，已回退 —— 路径 A 榨干
    四条并列基线一致：232345→232112 / 252730→252497 / 303140→302908 / 235628→235372，四个 CRC 全不变。
    证伪：任务书'扩到1024/4096预计回收约1%'（源自2026-09-25'341静态分支里149冲突'）—— 别名冲突不是误判主因。
    A4 的数据能解释：jalr 冲刷 1374 拍 BHT 压根不管；条件分支误判 ~3995 拍是 2 位计数器固有的，换大表也学不会。实际只回收 233 拍。
    回退理由：表面积约 4 倍（bht_valid 256→1024 位、ctr/tag 表各4倍）、关键路径 bht_valid 读选 256:1→1024:1 在取指链上，而 CPU 域余量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
2026-10-13 docs: 新增【路径B 交接说明】给队友；并修 v9/CLAUDE.md 里被实测推翻的过时结论
    新增 doc/reports/2026-10-13_handoff_pathB.md：现状一句话 / 当前四条并列基线（A1 之后的 232345 等）/ 已完成与未完成边界 / A4 关键数据 / B1 B2 B3 的任务说明与验收判据 / 纪律与坑 / 文档索引 / 怎么跑。
    v9 修正两处：§1.2 曾把 BTB 写成'本轮最高性价比的动作' —— A4 已定量其性能上限只有 +0.59%（jalr 1,374 拍），价值在功能分/措辞；§5 P1-D 表四项全部补上实测结论（A1 已做/A2 出局/BHT 扩容实测 +0.10% 已回退）。
    CLAUDE.md 约定 37：两条叙述里的旧基线 241,633/262,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
2026-10-13 perf(a1): 板上实测 A1 乘法器 II=1 —— 365.93 CoreMark（+4.00%）+ 工具与口径同步
    ## 板上实测（本次核心交付）
    位流 `coremark_dual_aext_ms_earlyld_a1_85mhz_rev1017_bcd8fdd2.sbit`（md5 bcd8fdd2），
    已归档到 `pds/RV32I_1/bitstreams/` 并登记进该目录 README。
    [build] FW=COREMARK RTL=0x20261017 <- 版本自证，对上 A1 的 DESIGN_REV
    Total ticks : 994,229,330
    Iterations : 4280
    Correct operation validated
    seedcrc 0xe9f5 / crclist 0xe714 / crcmatrix 0x1fd7 / crcstate 0x8e3a <- 四个 CRC 与仿真逐位相同
    => 994,229,330 / 85,005,100 = 11.6961 s -> 365.93 CoreMark
    => 232,296.6 拍/迭代（仿真 232,345，差 -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
2026-10-13 docs: 把 A1 前那一代板上实测标为历史（口径收尾）
2026-10-13 docs(skill): 位流归档定为硬纪律 —— 每块上板实测的位流必须归档 + 登记 bitstreams/README
2026-10-13 feat(cache): I+D 与 D-only 两版上板实测 —— D-Cache 几乎零代价，I+D 完整档跑通
    ## 板上实测（2026-10-13，日志 doc/board/uart_20261013_195230.txt）
    | 配置 | 时钟 | 拍/迭代 | 得分 |
    | 无 Cache（基线）| 85.0051 MHz | 232,296.6 | **365.93** |
    | **D-Cache only** | 85.0051 MHz | 232,302.6 | **365.92** |
    | **I+D Cache 全开** | 76.5052 MHz | 234,706.8 | **325.96** |
    两次都 `Correct operation validated`，四个 CRC 与仿真逐位相同。
    ## 结论
    1. **D-Cache 几乎不要钱**：只多 6.0 拍/迭代（+0.003%），得分掉 0.01。
    ⇒ 高阶任务① 的 D 侧可以常规开着，不损失分数。
    2. **I+D 完整档跑通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
2026-10-13 test(tb): 新增被动探针 +JALRTRACE —— 逐条流出跳转 {类型,pc,目标,rd,rs1}
    用途：B1（BTB/RAS）的尺寸决策。jalr 的目标依赖 rs1、取指级无前递通路，所以
    现在完全不预测 —— 到底该做多大的 BTB、还是要 RAS，先量了再说。
    纯被动：不带 +JALRTRACE 时 Total ticks 逐位不变（已验证 232,345）。
    实测结论（CoreMark ITER=1，1374 条 jalr/迭代，全部是 ret 形态）：
    | 结构 | jalr 捕获率 |
    | 直接映射 BTB（16~16384 项，1/2/4 路组相联）| 6.40% |
    | 每点位记最近 2 / 4 / 8 个目标 | 22.7% / 85.9% / 94.6% |
    | **RAS 8 / 16 / 32 项** | **99.93%** |
    ⇒ **这个 workload 上"BT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
2026-10-13 docs: 2026-10-13 会话状态备忘 + jalr 局部性分析脚本落盘
    本会话的里程碑已收口（A1 集成 + 板上验证 + Cache 实验 + BTB/RAS 勘察），
    这份备忘给下次开工用：
    - §3 当前口径：四条并列基线 + 三块板上实测位流（md5/ITER/得分/日志名）+ 时序余量
    - §4.1 Cache：D-Cache 几乎零代价（+6 拍/迭代）；**ITER=1 的仿真会高估 Cache 代价一个数量级**
    （冷 Cache 的缺失全被计进周期）⇒ 判带 Cache 的配置只认板上数
    - §4.2 [核心] **BTB/RAS**：1,374 条 jalr 全是 ret 形态；**直接映射 BTB 只有 6.40%**（加组相联无用），
    **RAS 8 项 99.93%** ⇒ 性能要拿靠 RAS（+0.5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
2026-10-13 merge(app): 并入队友 T1/G3 交接包 —— 五子棋拆 render + AI 两线程
    队友 2026-10-13 21:54 的包（`.rar`，fork 自路径B 交接点 20ecd0e，改动**未提交**）。
    **纯固件改动，rtl/ 一行未动**（差异只在 scripts/ 与 sim/）。
    ## 并进来的东西
    * `game.{h,c}`：把同步 `run_ai_move` 拆成 `game_ai_begin`（幂等派单 + 拷盘
    `ai_snap`）/ `game_ai_finish`（落子 + 收尾）/ `game_ai_snapshot` /
    `game_ai_run_sync`（同步便捷封装），并加 `ai_gen` 派单序号用于丢弃过期结果。
    * `main.c`：新增弱函数 `gomoku_ai_pump`（裸机默认同步算），宿主可强覆盖。
    * `video_port.c`：新增弱函数 `video_vbla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
2026-10-13 docs(taskbook): BTB/RAS 任务书 + 打包脚本加 -Tag（避开同日撞名）
    ## 1. BTB/RAS 任务书（`doc/reports/2026-10-13_handoff_btbras.md`）
    **取代 `2026-10-13_handoff_pathB.md` 的 §5-B1** —— 那一节写的"直接做 BTB（目标
    预测）"已被本会话的 `+JALRTRACE` 实测**推翻**：
    省 2026-10-13 会话状态 §4.2 的勘察结论：
    * jalr 1,374 条/迭代，**100% 是函数返回**；
    * 直接映射 BTB（16~16384 项、1/2/4 路）捕获率**恒为 6.40%** —— 不是冲突问题，
    是**单个点位自己就有 8 个目标**（0x4af0 被 8 个调用点调用的函数的返回）；
    * **RAS 8 项 = 99.93%**，且比 BTB 便宜（栈顶索引的 8 选 1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
2026-10-13 bits(rtthread): 归档 T1/G3 位流 8894cdcb（RT-Thread 版五子棋，待上板）
    队友 T1/G3 的两线程改动此前只有 x86/仿真证据，**归档里一个 rtthread 位流都没有** ——
    也就是这条线从来没上过板。先把位流量出来并归档，上板后再回来更新本条目。
    - `scripts\build_bitstream.ps1 rtthread` 全流程通过，**mem.hex 行数守卫（刚补的
    20270）也过**：20270 行 / 10135 字，sha256 与源一致。
    - CPU 域 **WNS +0.068 ns / 0 失败端点 / 17,216**，与已被板上验证的跑分版
    `bcd8fdd2` **逐位相同** —— RTL 没动，只换了 BRAM 初始化，所以时序没有新增风险。
    - 已把 `pds\RV32I_1\mem.h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
2026-10-13 test(rtthread): T1/G3 首次上板 —— 串口侧全通；但发现一处 vblank 采样问题
    日志 `doc/board/uart_20261013_224652.txt`（60 s）。位流 8894cdcb。板上未接显示屏。
    ## [OK] 通了什么（这才是这一版要验的）
    * `FW=RTTHREAD-GOMOKU-G3 RTL=0x20261017`；render + AI 两条线程都起；
    `[hb]` 每 5 s 一条、单调到 50000、全程无断。
    * **[重点] 两线程之间的邮箱往返真通了**：`AI moved, nodes=10592 depth=6 t=5068ms`
    / `nodes=3894 depth=6 t=2040ms`。RT-Thread 固件链的是 app/main.c 的**强定义** pump
    （异步），弱定义没进 ELF —— 子落得下来，就说明"派单 → AI 线程算 → 邮箱送回 →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
2026-10-13 docs: 全仓口径同步到 2026-10-13 当天（转交前统一）
    两件事容易误导，这次一并改掉。
    ## 1. [!] 全仓多处写着 "BTB"，但设计里【没有 BTB】
    设计里只有 **BHT（条件分支方向）**：`jal` 走静态预测、`jalr` **完全不预测**，
    从来不预测"目标"。而赛题原文点名的是"动态分支预测器（**如 BTB**）"——
    之前多处（`base_task_status.md` 的行标题、CLAUDE.md 的赛题对齐表、
    `resource_efficiency.md` §11 的标题）把它写成"BTB/BHT 已完成"，
    **评委一验证就穿帮**。现在统一改成"**做的是 BHT（方向），赛题点名的 BTB 未做**"，
    并挂上 10-13 的实测结论（jalr 10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
2026-10-13 docs(taskbook): 拆成两份自包含任务书 —— CPU/RTL 线 v10 + 五子棋线 v2
    两条线现在**并行**，所以各要一份**自包含**的任务书（不需要先读旧文档），
    并且要把"谁碰哪些文件"写死，否则撞文件等于白干。
    ## 1. `2026-10-13_taskbook_v10_cpu.md` → 发 `RISC-V_CPU优化任务书_v10_20261013.md`
    读者：CPU/RTL 线。**取代 v8/v9 的"路径 B / B1"** —— 那版写的"直接做 BTB"已被 10-13 实测推翻。
    * **顺序：覆盖 A/B（热身）→ RAS → BTB。**
    * 覆盖 A/B 是 10-12 就分给 CPU 线的（`tb_amo_cpu.S` 转 tohost、`hi_fetch.S` >32KB 取指），
    一直没人做；也是建立"弄坏了能 FAIL"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
2026-10-13 test(rtthread): I+D Cache @76.5MHz 位流 c10a2478 归档 —— 上板确定性挂死，转仿真复现
    - rtthread + I+D Cache @76.5052MHz（RATIO0=15.0/UART_DIV=664/board.h 76,505,200，构建后已全部还原）
    - 网表自证 dcache=1188/icache=1208/tag0=205；CPU 域 +0.904ns/0 失败端点，76.5MHz 下 CDC 也收敛，全设计 0 失败端点
    - 上板三次抓取逐字节相同：仅一行损坏输出（AI 第一手后第一张棋盘快照处挂死，无 [hb]）；同一固件在无 Cache 8894cdcb 上正常
    - 根因待查：I+D+EARLY_LD+中断路径 RTL bug（约定47 同族）；tb_rtthread 此前无 Cache 开关覆盖（新增约定54）；串口 ASCII 解码坑（新增约定55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
2026-10-13 investigate(cache): RT-Thread + Cache 仿真归因 —— 不是"有 Cache 就不行"，是"两个 Cache 都能打挂它"
    上一轮（4055052）把 `c10a2478` 挂死记录在案、给 tb_rtthread 补了 Cache 开关。
    本文是补完开关之后的**仿真归因**（100MHz 下时序不参与，挂=功能问题）：
    | 配置 | 串口 | render | AI | [hb] | 结果 |
    | 无 Cache | 168B | OK | OK | OK | **PASS** |
    | 只开 D | 168B | OK | OK | — | **崩**（走得远，之后寄存器转储）|
    | 只开 I | **13B** | — | — | — | **崩得早**（banner 都没出来）|
    | D + I | **13B** | — | — | — | **崩得早** |
    ⇒ **不是"有 Cache 就不行"**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
    [tb_rtthread.v]
2026-10-13 docs(taskbook): 把 Cache 挂死这条回填进两份任务书（正要发出去）
    两份任务书刚写好就要发给队友，而 2026-10-14 的 Cache 归因改变了优先级，不写进去会让人白跑。
    * **CPU 线 v10**：任务表最前面加一条 **P0 缺陷「Cache 在 RT-Thread 固件上会挂」**
    （排在覆盖 A/B 热身之前），新增 §3.1 写清：四种配置的仿真对拍表、已排除项、
    最强怀疑、**证实的断言写法**、复现命令、验收判据，以及"修好前 `c10a2478` 与
    00:57 那颗 D-only@85 都勿烧、提交档一律 Cache 全关"。
    * **五子棋线 v2**：§1 基线后面加一条 [!] —— **别碰 Cache 开关、别去查 C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
2026-10-13 docs: 定死 `pds/RV32I_1/mem.hex` 的入库口径 = 生产固件（CoreMark）
    `mem.hex` 是【有意入库】的（PDS 综合读的就是它），但**旧文档只写了"有意入库"，
    没写是哪一个固件** —— 两条口径因此在仓库里并存过：
    * 约定一直暗示"生产固件"，`6e57aa9` 也是这么修的（"还原为生产固件"）；
    * 4055052 又把 RT-Thread G3 固件快照入了一次库。
    **定死为生产固件 = CoreMark**（双发射 + `EARLY_LD` + A1 @85 MHz，ITER=4280，**17104 行**
    = 脚本里的 `expectLines['coremark']`），理由：
    * **在 PDS GUI 里手工综合的人读的就是这份**；`build_bitstream.ps1` 每次都会重新生成并覆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
2026-10-13 docs(pds): pds/README §4.1 补"入库哪个固件"的规矩 + 修过期的核对基准
    * 新增 [!]：本目录 `mem.hex` **有意入库**，内容定死为**生产固件 = CoreMark（17104 行）**
    —— 理由同 CLAUDE.md 约定 8：PDS GUI 手工综合读的就是这一份。**跑完任何变体构建、
    提交前 `git checkout -- pds/RV32I_1/mem.hex` 还原。**
    * **修过期基准**：本节"核对方法"里写的 "CoreMark 固件是 **4209 字 / 67,693 字节**"
    是 **62 MHz 时代**的值。改成"以 `build_bitstream.ps1` 的 `expectLines` 为准"，
    并列出当前四个变体的实际行数/字数（coremark 17104/8552、rtthread 20270/10135、
    gomoku 11268/5634、demo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
2026-10-13 docs(taskbook): 标题补上 2026-10-14 的修订标记（内容已含 Cache 一条，标题别让人以为没含）
    两份任务书是 10-13 立的、10-14 补了 Cache 那条结论，标题却仍只写 10-13 ——
    队友拿到会以为这版不含最新发现。标题改成 '…2026-10-13 立，2026-10-14 补：…'。
    未 push。
2026-10-14 fix(core): ID/EX 清零补 mem_ready 门控 —— Cache + RT-Thread 挂死根因 #1（DESIGN_REV 0x20261018）
    - 根因：ex_flush/ex_mispred/stall_int 是 EX 里那条指令【自己】发出的；流水线被访存停顿冻结（mem_ready_int=0）时清 ID/EX = 把发冲刷的指令自己杀掉 ⇒ jal/jalr 链接值写回永久丢失（_start 0x2ac 的 jalr 被清 ⇒ ra 停留在前一条 auipc 的 0x72a8 ⇒ ret 跳飞）
    - 修法一行：if (!resetn || trap || ((ex_flush||ex_mispred||stall_int) && mem_ready_int))；照抄 EX/MEM 的 A.0 门控；trap 保持无条件（肇事指令必须死）
    - 验证：-ICache 仿真 13 字节挂死 -> 完整启动 + render/AI 两线程；riscv-tes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
    [csr_file.v, tb_rtthread.v]
2026-10-14 docs(handoff): Cache 修复线交接 —— 根因 #1 已修，根因 #2 待修（自包含）
2026-10-14 fix(core): CSR 写/mret 副作用补 mem_ready 门控 —— Cache+RT-Thread 挂死根因 #2（DESIGN_REV 0x20261019）
    根因：CSR 写是 EX 级提交（约定 21），而'离开 EX'发生在 mem_ready_int=1 那个沿。访存冻结那一拍 CSR 已写进寄存器组，而 ID/EX 按约定 56 保持不动 => 下一拍 alu_result 里的 csr_rdata 已是写后值 => csrrw rd,csr,rs1 的 rd 拿到新值而不是旧值。
    触发者：RT-Thread 中断入口/出口各一条 csrrw sp,mscratch,sp（rd=sp, interrupt_gcc.S:101/109）。冻结撞上它 => sp 不切到中断栈、处理函数跑在线程栈上；出口那条再把 mscratch 写坏 => 之后每次中断 sp 漂移 => 踩坏内核链表 =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
    [csr_file.v, tb_rtthread.v]
2026-10-14 chore(scripts): Run All 排除表补 tb_gomoku —— 既有断点（它漏在表外会让后面的测试台全不跑）
    tb_gomoku.v 需要 cpu_top/video_core，Run All 默认不编 rtl/top => 走到它就报 Unknown module type: cpu_top，排在它后面的 tb_multiplier/tb_ppu/... 全不跑。表头的注释本来就要求跟着新增 tb 一起维护。
    另两处既有断点这次没动（都不编 core.v，与本次改动无关）：tb_ppu/tb_video* 需要 rtl\\video；tb_multiplier 是约定 52（A1）之前的握手测试台。详见 doc/reports/2026-10-14_cache_fix_bug2.md §7。
2026-10-14 docs: 根因 #2 报告 + 约定 57 + 三处过期口径加横幅
    新增 doc/reports/2026-10-14_cache_fix_bug2.md（定位方法/根因/证据/验证/顺带查清）。
    CLAUDE.md：新增约定 57（EX 级副作用必须门控 mem_ready_int，与约定 47/51/56 同族）；待办改为'两条根因都已修、只差重出 rev>=1019 的 Cache 位流'；顺手标注 56 号重复（serial_monitor 那条）。
    三处横幅：bug1 §5、handoff §3/§5、bisect §4 —— 原文里'#2 未修/最强怀疑'都按新结论更新，历史正文留原样。bitstreams/README 的 c10a2478/9feaa089 两条同步。
2026-10-14 docs(bitstream): 归档 rev1019 的 rtthread + I+D @76.5MHz 位流（根因 #1/#2 修复后重出）
    bitstreams/rtthread_dual_aext_ms_earlyld_a1_gomoku_g3_idcache_76mhz_rev1019_90944754.sbit —— 网表自证 dcache1190/icache1216/tag0 196；All Constraints Met，CPU 域 +0.534ns / 0 失败端点（18997），两条 CDC 也 0 失败；首行自证 RTL=0x20261019。尚未上板。
    约定 50 的四件套（RATIO0=15.0 -> ip_generate -> UART_DIV=664 -> rtthread board.h 76505200）构建后已全部还原并核对（工作区只剩本次归档的文档改动）。
2026-10-14 fix(fw): 横幅主频改为从 BOARD_SYSTEM_CLOCK_HZ 算 —— 不再写死 @85.0051MHz
    实踩：烧 76.5052MHz 的 rev1019 位流（90944754），横幅却打 @85.0051MHz（app/main.c:173 是字符串字面量），看着像烧错位流。同一份固件要装进 85.0051/76.5052 两种位流，写死必然有一种是错的。
    改为 rt_kprintf(...@%d.%04dMHz, CLOCK/1e6, (CLOCK%1e6)/100)，并 include bsp/board.h（-I bsp 在搜索路径里且在 gomoku/board.h 之前）。
    顺带更正 board.h 头部注释：板上两档（85.0051/76.5052，由位流里的 PLL 决定）、仿真 100MHz（不是 27MHz）。
    验证：板级口径与仿真口径都编得过；-Sim 重编后跑 run_sim.ps1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
2026-10-14 docs(board): rev1019 位流（rtthread + I+D @76.5）上板串口侧通过 + 约定 58（别写死频率/只认 mimpid）
    证据 doc/board/uart_20261014_135935.txt：RTL=0x20261019（RT-Thread 与五子棋两侧自证）+ render/AI 两条线程都起来 + [hb] uptime 5000..20000 每 5s 一条无断 => 之前'带 Cache 必挂'的组合现在通了（对照 c10a2478 死在 AI 第一手后的棋盘快照、9feaa089 卡在 heap=9368 循环重启）。
    新增 CLAUDE.md 约定 58：位流身份只认 mimpid（RTL= 行）；固件里由 RTL/编译宏决定的数字一律算出来不许写死；串口文本可读 = 时钟与固件编译口径一致的旁证。
    记录未验项（落子/对局、显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
2026-10-14 feat(bitstream): 重出 rev1019 横幅自洽版位流 53b81dfe（rtthread + I+D @76.5052MHz）+ 两份队友任务书
    位流：RTL 与 90944754 逐位相同（网表 dcache1190/icache1216/tag0 196、CPU 域 +0.534ns / 0 失败端点 18997、CDC 0 失败、All Constraints Met），只换固件（横幅主频从 BOARD_SYSTEM_CLOCK_HZ 算 => 打 @76.5052MHz）。约定 50 四件套构建后已还原并核对。
    build_bitstream.ps1：expectLines rtthread 20270->20276（守卫按设计拦下了一次固件改动）；构建日志改为从 board.h 读频率打印，不再写死 85.0051MHz（约定 58）。
    位上证据补齐：14:11 那份 413 行日志 —— 真按键完整下完一局判出 W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
2026-10-14 docs: 复位确认为人工按键；vblank timeout 定性为'同步未工作'并给三方案；rev1017 生产档重出定论
    1) 14:11 日志末尾 3 次重启 = 用户按 SW3（设计上的复位键），不再列为待查项。
    2) vblank timeout 查清：不是显示坏，而是 video_wait_vblank 每次靠超时兜底 —— 固件 1ms 采样 vs RTL 62.7us vsync 脉冲（video_core.v:139，命中率约 0.4%）。给三方案（降级日志 / 换 1.04ms 消隐窗 / 加只读帧计数器，推荐 A）并标明归口（rtl/video 属视频线）。
    3) rev1017 生产档要不要重出：Cache 全关时 b_ready 硬连线 1'b1（unified_mem.v:80）⇒ mem_ready_int ≡ !amo_hold；两交付固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
2026-10-14 docs: 修正 vblank 那条的定性（命中是概率事件，不是'完全没同步'）
    按 firmware 源码重算：video_port.c:62 等的 VIDEO_STATUS bit0 是 62.7us 脉冲，RT-Thread 侧 yield=mdelay(1) 使采样周期约 1ms => 命中率量级 6~12%（脉冲宽/采样周期），等不到由 VIDEO_VBLANK_TIMEOUT_MS=50ms 兜底；告警按设计只打一次，所以日志只有一行。裸机版无 yield（紧忙等）必命中，故 23 份裸机日志无此句。三处文档同步更正。
2026-10-14 test(bitstream): rev1019 的 85MHz 生产档重出【时序不过】=> 生产档保留 rev1017；expectLines 改成一组可接受值
    实测：CoreMark aad1e2ac 与 rtthread 382ce876（两次独立运行）都给出 CPU 域 -0.153ns / 16 失败端点（Some Constraints Violated），对照 rev1017 的 bcd8fdd2 = +0.068 / 0；两次逐位相同 => 确定性，不是 8-seed 抖动。成因：两处修复的 AND 加在 mem_ready_int 这条本来就很晚的使能信号上（ID/EX、EX/MEM、MEM/WB、乘法器共用），把只剩 0.068ns 的余量吃掉。=> 生产/交付档继续用 rev1017（功能逐位等价已证），两颗重出件按 _wns-0.153ns_ 命名归档并标勿烧。
    build_bits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
2026-10-14 docs(taskbook): v11_cpu 补 §2.4 —— 两处修复吃掉 85MHz 余量（-0.153/16 端点），并把它列为独立时序优化候选题
2026-10-14 docs: 定稿【提交档声明】+ 位流清单（md5/主频/得分）—— 消除'两颗 CPU'的口径歧义
    doc/paper/论文框架 新增 §0.1：提交档 = 双发射+EARLY_LD+Cache 全关 @85.0051（bcd8fdd2 365.93 / 8894cdcb 演示）；评估档 = 56374a08(D-only@85 365.92)、da8ffd31(I+D@76.5 325.96)、53b81dfe(修复后带 Cache rev1019)；附五条口径纪律（只有一个'我们的分'、不是两颗 CPU、三口径一起给、演示只烧提交档、rev1017 vs rev1019 差异）。
    论文框架 §0 补两处过期数：功能完整档改成 A1 后板上实测 325.96（ITER=3800/da8ffd31），并新增 D-Cache only 行（365.92，同频只掉 0.01 分）；§5 提交口径决策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
2026-10-14 docs(口径大扫除): 全仓活文档刷成 2026-10-14 口径 + 历史报告加横幅（47 文件）
    当前口径（唯一真相 doc/paper/论文框架_v1_20261012.md §0/§0.1）：跑分档 365.93@85.0051（bcd8fdd2）；I+D 档 A1 后板上实测 325.96@76.5052（ITER=3800，891,885,963 ticks=11.6578s，位流 da8ffd31，拍/迭代 234,706.8）；DESIGN_REV=0x2026_1019。
    一、事实性更新（不只是数字）：\n* Cache 说法：'已实现但负收益/默认关' + '两条挂死根因（约定 56/57）已修、2026-10-14 上板验证' ⇒ README.md 根、doc/README.md、doc/plan.md、doc/base_task_status.md、pds/README.md（'未做'→'已实现'）、doc/board_bringup.md（'推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
2026-10-14 docs(v10 taskbook): 给 P0 缺陷条（Cache 在 RT-Thread 上会挂）标上【已完成】+ 指向 bug1/bug2 与已上板位流
2026-10-14 fix(core): AMO 后紧跟分支用陈旧前递值解析方向并提交错误路径（同族第三条）+ 覆盖 A/B
    任务书 v11 §3 的 P0 热身「覆盖 A」「覆盖 B」一并提交（同一里程碑）。
    覆盖 A —— tb_amo_cpu.S 转 tohost 判分、摘出 $skipThese、首次端到端跑即 FAIL(testnum 9)：
    * fix(core): ex_flush/ex_mispred 的【源】补 && mem_ready_int。AMO/LR/SC 占 MEM 的 4 拍里
    前递的 amo_wb_data 还是【上一条】AMO 的陈旧值，紧跟其后的分支据此解析错方向并拉高
    ex_flush；而 ex_flush 在 fetch_addr 里优先级高于冻结兜底、IF/ID 冲刷清空又没被门控
    ⇒ 错误路径被取出并提交（bnez a0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
    [csr_file.v]
2026-10-14 feat(core): B1-RAS 返回地址栈 —— ret 在到达级预测并同拍重定向（+§7 预测目标校验）
    - RAS_DEPTH=16：call 在 EX 提交那拍 push id_ex_pc+4；ret（jalr x0,0(x1|x5)）在到达级命中
    即 p_target=ras_top，折进【既有】p_target 腿（不新增 fetch_addr 的腿）；p_pred_taken=1
    ⇒ ret 独占发射，行为同原 jalr
    - §7 目标校验：ret 的预测目标与真实链接值不符即并入 ex_flush 纠正。用 rs1_val&~1 直比、
    经 ex_target 加法器；imm≠0 的 jalr x0,off(ra) 强制冲刷（-- 第一版直比 ex_target 曾把取指
    临界路径打负，见下）
    - EX push/pop 门控 mem_ready_int && !mc_stall && !trap（= 提交到 E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
2026-10-14 merge(gomoku): 并入队友 T2/T3 交接包（标题屏多级菜单 + HUD 重排）
    来源：riscv-cpu-fpga_dualissue_20261014_gomoku(1).rar = 队友仓库 feat/gomoku-t2 的工作区改动（7 文件）。本仓 dualissue 与该分支共同基点 5b16140，RTL 侧零分歧，合入是纯固件/测试台层。
    整合期修掉 3 个问题（均在队友未提交改动里）：
    1. game.h:110 注释里 level_*/step_ms 的 */ 提前闭合块注释 => x86 单测编译失败（该包没在 x86 单测里编过 test_game.exe，前四个测试台不含 game.h 所以前四项全过、第五项才炸）。已修。
    2. game.c:187 同一处（game_start 注释）。已修。
    3. test_game.c 两个死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
    [tb_gomoku.v]
2026-10-14 docs(taskbook v4): T2/T3 上板验证结论（CPU 无问题）+ T6 GUI 重设计任务书交接
    板测（dd4fecb4 @76.5052，RTL=0x20261019）：人机局 + AI 对弈局两局，串口 29 快照经 replay_log.py 复盘零冲突——零非法落子/零棋子变色/判胜正确（AI 挡四后 G5 竖五连胜）；用户问的'CPU 跑五子棋有没有问题'结论=没有。三个固件小瑕疵（回标题假 AI moved / AI thinking 死路径 / t= 低 10%）归五子棋线。
    任务书 v4：用户原话（主菜单竖排+上下选择+长按进二级菜单+子菜单选参数）+ 外部建议文档摘要，并按平台真实约束逐条修正（4 用户键非 5、SW3 是复位、内存 64KB 非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
2026-10-14 feat(core): B1-BTB 分支目标缓冲 —— 间接 jalr 到达级预测（+§7 放宽到所有被预测 jalr）
    256 项直接映射 BTB（索引 pc[9:2]、tag pc[31:8]，与 BHT 同形），只预测间接 jalr
    目标（条件分支/jal 的 PC+imm 现算已对，不重复存）。到达级命中即折进既有的
    p_target 腿（优先级 RAS > BTB > PC+imm），绝不新增 fetch_addr 的腿。EX 级提交
    那拍训练（门控同 RAS）。§7 目标校验放宽到所有被预测 jalr（id_ex_pred_taken 门控
    ⇒ 没被预测的 jalr 逐位不变；imm≠0 强制冲刷 ⇒ 不比"不预测"差；imm=0 仍用
    rs1_val&~1 直比，不碰 ex_target 加法器）。parameter BTB_EN=1 + -DNOBTB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
2026-10-14 docs: session_state §9.8 标注 B1-BTB 改动已提交 51fa969
2026-10-14 docs(bitstream): B1-RAS/BTB 跑分位流 f64b977 归档 + 口径同步（ITER 4332 / 229,597 拍）
    - 位流 coremark_dual_aext_ms_earlyld_a1_ras_btb_85mhz_rev1022_f64b977.sbit：
    2026-10-14 23:04 综合，CPU 域 u_pll→u_pll +0.034ns / 0 失败端点（20,507），
    85.0051→85.2515MHz；网表自证 Cache 全关 + BTB/RAS 在；LUT 8104/5.07%
    - ITER 4280→4332（229,597 拍口径重算），build_bitstream.ps1 默认值与 cpiCycles 同步
    - CLAUDE.md / 论文框架 §0+§0.1 / 技能两份副本刷成 rev1022 口径；交付档仍是 bcd8fdd2（f64b977 待上板）
    - 新增 rtthread 固件口径守卫：build.ps1 -Sim 写 .sim_build_ok 标记，
    run_sim.ps1 -NoBuild 缺标记即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
2026-10-14 docs(board): B1-RAS/BTB 上板通过 370.23 分（f64b977）+ CPU 线交接书
    - 上板日志 uart_20261014_233933.txt：RTL=0x20261022、Total ticks 994,412,748
    = 11.6980s、370.23 分（+1.17% vs bcd8fdd2）、四 CRC 逐位一致、
    229,574.8 拍/迭代（仿真 229,597，-0.0097%）
    - 提交档 bcd8fdd2 -> f64b977；CLAUDE.md / 论文框架 §0+§0.1 / 位流索引 /
    技能两份副本全部刷成上板实测口径
    - 新增 doc/reports/2026-10-14_handoff_cpu_b1verified.md：CPU 优化线交接书
    （当前基线/时序口径 +0.034ns/0 端点/后备动作/纪律/剩余可做项）
2026-10-14 docs(board): 归档 B1-RAS/BTB 上板串口日志 uart_20261014_233933.txt（370.23 分）
2026-10-14 docs(paper): 可达频率口径刷成 B1 后实测（85.2515MHz/+0.034ns，提频路已堵死）
2026-10-15 docs(eff): 新增 §15 —— 存储层次：官方口径 vs 实测（"Cache 负收益"的根因 + 答辩话术）
    赛题 Q&A 官方给了一条关于存储层次的答复（"用了载体就必然有延时，1 个时钟周期都算；
    Cache 小所以用 BRAM 做才快，外部 DRAM 必然更慢；外部 DDR 到内部逻辑也有一级 BRAM 缓冲，
    否则前后端速率不对等会引发问题"）。**它正好从原理上背书了我们"Cache 负收益"的结论**，
    所以把它 + 我们的对照 + 板上实测整理成可直接引用的一节。
    ## §15 里写了什么
    * **15.1** 官方原文；**15.2** 三句拆开解读 —— 核心是
    `Cache 价值 = (后端延时 − 命中延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
2026-10-15 docs: 会话收尾线 65%/75% → 85%/90%（用户 2026-10-15 决策）+ 记下 autoCompactWindow 的更早闸门
    用户放宽了收尾线。依据是拿转录大小对撞墙会话做的标定：
    c14ae61b 撞到 1,017,073 tokens（≈97% of 1M）时转录是 8.8 MB ⇒ 粗算 ≈116K tokens/MB，
    65% 那条线在实际会话里触发得偏早。
    [!] 同时记下一个更要紧的事实：用户 ~/.claude/settings.json 里 autoCompactWindow=800000
    （1M 的 80%），**它会先于 85% 触发** —— 想让新线真正生效，得把它一并抬到 ~850000。
    （没动那个文件，仅记录在案。）
    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
2026-10-15 bits(rtthread): 演示档重出 rev1022（176e0028，+0.034 ns 达标）—— 推翻"交付档继续用 rev1017"
    ## 为什么值得做（不是重复劳动）
    归档索引里原有一条 2026-10-14 的结论：**"生产/交付档继续用 rev1017 的
    `bcd8fdd2` / `8894cdcb`，不要换成 rev1019"** —— 依据是当时重出的两颗 rev1019
    85 MHz 位流都 **−0.153 ns / 16 失败端点**（确定性，非 seed 抖动）。
    **但 rev1022（= rev1019/1020 + B1-RAS/BTB）的跑分档 `f64b977` 实测 +0.034 ns /
    0 失败端点，并且已经上板 370.23 分。** ⇒ 那条结论**对 rev1019 成立、对 rev1022 已不成立**。
    本轮把 **演示档**（RT-Thread 五子棋）也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
2026-10-15 docs(timing): 约定 45 剩余两项的可行性评估 —— 两项都做不了，且原因就在关键路径上
    用户问"约定 45 剩余两项能不能做"。做的是**判据先行的评估**（不写代码，先定结论）。
    顺带把**真正的抓手**定位清楚了。
    ## 结论：在当前 rev1022 的 P&R 上，两项都做不了
    而且原因比"余量小"更具体 —— **它们要加的位置，正好就是当前关键路径本身**：
    | 项 | 插入点 | 关系 |
    | 基址在 EX（4,744 拍 / 1.81%）| EX→ID 前递 → `ld_base` → `ld_id_addr` | 就在 `… → load_data → rs1_val → …` 那一段 |
    | 紧前是 store（1,869 拍 / 0.71%）| store→load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
2026-10-15 docs(timing): PCE 区域约束尝试记录 —— 没做成，但把路探清楚并定位了卡点
    承接 `2026-10-15_earlyld_rest_timing_assessment.md`：那份查出关键路径**约 60% 是布线**
    （`ram_rdata_eff[27]` 一根 **fanout=1 却走 1.925 ns** 的网线），结论是"抓手是布局不是逻辑"。
    本文是把那个抓手**真正试一遍**的记录。
    ## 结论：没做成 —— 卡在两处都依赖 GUI / 未文档化的东西上
    **已查实的（下次别再重查）**：
    * **PCF 就是文本文件**，且**工程已引用**（`RV32I_1.pds:266` 有 `(_file "device_map/cpu_top.pcf" (_format pcf))`）；
    内容 = `.fdc` 生成的 `def_port`，当前**无任何 region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
2026-10-15 docs: 把 PCE 手册收进 doc/（工程里本来就引用这个路径）+ 一份可搜索的文本提取版
    `doc/reports/2026-10-14_handoff_completeness_first.md` 里已经写着
    "只能走 PCE 图形界面（`doc/Physical_Constraint_Editor_User_Guide.pdf`）"，
    但那份 PDF **一直不在仓库里** —— 这次从 Pango 安装目录补齐：
    * `doc/Physical_Constraint_Editor_User_Guide.pdf`（原文件，8.7 MB，取自
    `D:\pango\PDS_2022.2-SP6.4\doc\`）
    * `doc/Physical_Constraint_Editor_User_Guide_文本提取.txt`（pypdf 提取，62 KB，
    **方便 grep/复制**；PDF 本身没法直接搜中文时用这份）
    > [!] 这是 Pango 随工具发行的官方手册，属**供应商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
2026-10-15 docs: 补《User Constraint Editor User Guide》（V1.7，比 PCE 手册新）—— 区域约束的正确操作在里面
    PCE 手册（V1.2）里的 `region -create/-add` 在本版本**根本不存在**（实测
    `E: Flow-0073: Option '-add' is not defined for command 'region'`），
    而 UCE 手册（**V1.7 / 2022.10.26**）里有正确的做法：
    * 建区域：工具栏 **region mode** → floorplan 右键 **Draw Region** → 鼠标变**十字形**画出范围
    （或 Region 窗口右键 **New Region**）
    * 把实例约束进去（**两种**）：① DesignBrowser 里**拖**到区域上；
    ② **更可靠：选中 instance/module → 右键 `Assign to Region`**
    * **成功标志**：被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
2026-10-15 docs: 2026-10-15 会话状态 —— 演示档 rev1022 / 约定45 评估 / PCE 区域约束实验（半途）
    本会话三件事：两件收口，一件**只差改 2 处配置 + 重跑**，下个会话直接从 §2 接。
    ## §2 [!] 正在半途：PCE 区域约束
    **目标**：把 `u_soc/u_core` 与 `u_soc/u_bus/u_mem` 约束进同一物理区域 —— 关键路径上
    `ram_rdata_eff[27]`（fanout=1）走了 **1.925 ns**，判断是"BRAM 离消费它的逻辑太远"。
    成功的话余量（当前 +0.034 ns）应显著回升，进而解锁提频/配对放宽/约定 45 三件事。
    **已完成（别重做）**：
    * 命令全试通：`region -create region1 <x1> <x2> <y1> <y2> {CLMA CLMS DRM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
2026-10-15 docs: PCE 区域约束实验收口 —— 结论负收益（u_pll slack +0.034 → -0.755 ns）
    接 2026-10-15_session_state §2 那个"半途实验"，当晚做完并收口。
    数据（判据见约定 53，只看 .rtr 的 u_pll 行）：
    基线 rev1022 +0.034 ns / 85.2515 MHz / CPU 域违规端点 0
    区域约束版 -0.755 ns / 79.8786 MHz / CPU 域违规端点 3
    还原后重跑 +0.034 ns / 85.2515 MHz（逐位回到基线）
    把 u_soc/u_core + u_soc/u_bus/u_mem 框进 29% 的 die 反而更糟：PDS 本来就会把
    有连接的东西放近，人为加限制只换来拥塞（约定 43 的镜像面：收紧约束会塞车）。
    新增 doc/reports/2026-10-15_pce_region_res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
2026-10-15 fix: `pds/RV32I_1/mem.hex` 入库快照更新到 ITER=4332（原 4280 是 B1-RAS 之前的口径）
    bfd7c14 把入库口径定死为"生产固件 = CoreMark"，但那时（10-14 凌晨）生产固件
    还是 ITER=4280。同日 B1-RAS/BTB 落地后每迭代从 232,345 降到 229,597 拍，
    `build_bitstream.ps1` 的默认 Iter 已重算为 4332，入库快照却没跟着走。
    后果：**在 PDS GUI 里手工综合的人会拿到 4280 的固件**（4280 x 229,597 / 85,005,100
    = 11.56 s，仍有效，但与归档位流 f64b977 的 4332 口径对不上）。
    本次把快照更新到 4332：17104 行不变，只差 @2298 一个字
    （0x10B8=4280 -> 0x10EC=4332 —— 那个字就是 ITER 常量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
2026-10-15 docs: 双发射配对率实况 —— 周期侧只剩"lane B 加访存"一条（上界 +7.46%）
    起因：PCE 区域约束判死"提频/时序侧"之后，清点周期侧还剩什么。
    用 pair_analyze.py 的规则框架做离线复放（trace 288,056 行 = 每迭代指令数，
    三个自检逐位复现原脚本的 ①②③ 三档）。
    [!] 关键发现：pair_analyze.py 的模型与实现已脱节
    该模型写于 2026-10-10（双发射尚未实现），BREAK 把 lane A 是 branch/jal/
    jalr/system/fence 一律判"本组 1 宽"；而 pair_now（core.v:696）实际只门控
    !p_pred_taken 与 mul/div/amo，对 lane A 没有 opcode 限制
    => "预测不跳转的分支可以配对"【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
2026-10-15 docs: lane B 访存改造任务书（方案定稿，RTL 未改）
    承接 2026-10-15_pair_rate_analysis.md §5 —— 周期侧唯一剩下的实质机会。
    离线规则复放（pairtrace 288,056 条）：
    现状 k=72,256 基准
    只放 load + "每对最多一条访存" k=80,122 ≈ +3.5%
    load+store（同约束） k=80,655 ≈ +3.8%（边际仅 +0.26%）
    load+store（不限同拍访存） k=88,198 ≈ +7.2%
    推荐【只放 load】。理由：
    - store 边际只 +0.26%，却引入"ex_flush 拍 lane B store 静默写坏内存"
    这类测试测不出的风险；
    - 方案 B 的"端口仲裁"实为存储子系统重构：16,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
2026-10-15 docs: 会话状态补当晚三件事 + 指向 lane B 任务书
    §5 新增 pair_rate_analysis / laneb_mem_plan 两份文档；
    §6「下个会话起手」改为指向 lane B 访存任务书（从 P0 开始），
    并给出性能线现状的一句话（频率侧堵死、周期侧只剩 +3.5% 一条），
    同时点明两个此前流传的虚数（+7.46% 未扣端口约束、+12.31% 重复计了分支配对）。
    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
2026-10-15 docs(p0): lane B 访存 P0 完成 —— 四条基线实测复现，三条文档值已陈旧
    P0 判据按字面不通过，但偏差已定量归因（不是 RTL 问题）:
    - 229,597 (dual+EARLY_LD) 实测分毫不差 = 当前唯一现行的文档值
    - 249,982 / 300,392 与文档 252,730 / 303,140 各差【恰好 2,748】= 23ff4b3 记载的
    B1-RAS 收益，一位不差 ⇒ 文档那三条是 pre-RAS 口径（CLAUDE.md:138 自己标注过
    "后三个均未含 RAS，未重测"，计划书 §6 照抄了进去）
    - 233,013 vs 235,628 差 2,615 = RAS 在带 I-Cache 配置下的收益，同因不同量
    四 CRC（四条配置逐位一致）: e9f5 / e714 / 1fd7 / 8e3a
    与 10edfd0 记录的历史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
2026-10-15 docs(p0): 补 §7 —— 复核出 P4 时序闸门 79.1MHz 是方案B的盈亏平衡点（方案A 应为 82.09MHz）；换算真实延迟预算为 +0.45ns
2026-10-15 perf(area): A 扩展（RV32A）改为 parameter 且默认关 —— 省 444 LUT / 224 FF，零性能代价
    赛题通知（2026-10-15）：主分 = Score = Iterations/(Total_Time×Frequency)，化简即
    CoreMark/MHz ⇒ 【主频与面积都不进主分】，面积只进指标(3) CoreMark/LUTs。
    两个交付固件都不含原子指令 ⇒ A 扩展对分数零贡献，纯面积开销 ⇒ 关掉。
    用户批准（"RV32A 可以砍"）。
    改动（只动开关与例化，不删代码 —— 验证口径要保住）:
    - core.v 新增 parameter A_EXT = 0；amo_unit 用 `generate if (A_EXT!=0)` 包住，
    不例化时给常量 0 让下游 mux 折向另一条腿被综合裁掉。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
2026-10-15 bits(coremark): A 扩展默认关版位流 55fae69e（rev1023）—— LUT −441 / 余量 +0.034→+0.330 ns
    `build_bitstream.ps1 coremark` 全流程（固件 ITER=4332 / mem.hex 17104 行 ✓）:
    配置：双发射 + EARLY_LD + A1 + RAS/BTB，Cache 关，85.0051 MHz，A_EXT=0
    DESIGN_REV 0x2026_1023（串口首行应打 RTL=0x20261023）
    对比 `f64b977`（同 RTL + A 扩展）:
    LUT 8,104 → 7,663（−441 / −5.44%）
    FF 3,899 → 3,675（−224 / −5.74%）
    DRM 101.5 → 101.5（不变）
    CPU 域 u_pll→u_pll +0.034 → +0.330 ns，可达 85.2515 → 87.4585 MHz，0 失败（18,785）
    指标(3) CoreMark/LUTs +5.8%；指标(2) Fmax +2.6%；指标(1) 不变（229,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
2026-10-15 fix(sim): 修 Run All 的两个"静默不跑/静默全红"—— 三个测试台从来没跑过
    背景：`run_sim.ps1 -NoWave` 的输出被当成"全绿"用，实际有两个洞。
    1) tb_ppu.v 不在排除表里 ⇒ Run All 走到它就抛 "Unknown module type: sync_vg"
    异常中断，**排在它后面的一律不跑**。排序上 tb_ppu 之后是 tb_rvc /
    tb_uart_fifo / tb_uart_rx ⇒ 这三个【自 tb_ppu 存在以来从没跑过】。
    这正是脚本第 18-23 行注释自己警告过的坑（tb_rtthread 踩过、tb_gomoku 踩过、
    这次是四个视频台）。已把 tb_video / tb_video_bars / tb_video_core / tb_ppu
    一并补进 $externalProgramTbs（它们都要编 rtl/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
2026-10-15 feat(pair): pair_analyze 加 ④ 档「lane B 放 load」—— 模型给出 +6.0% 周期，但比任务书大 1.7 倍
    任务书 §4(L) 要求：改 RTL 的配对规则前，先把模型改好，**P1 判据从这里来**。
    改动（纯离线，不碰 RTL）:
    - `reads()` 支持 LOAD（读 rs1 基址）
    - 新增 `is_simple_b(instr, allow_load)`；**load 不能用 f7 判** —— 它的
    instr[31:25] 是立即数高位，实现里 `p_f7_b != 1` 必须收窄成只对 OP_REG
    （任务书 §7 R3：不收窄会"少配一对"，不报错、CRC 也不变）
    - `_pair_reason()` 加 `allow_load_b` + **每对最多一条访存**（mem_both）
    - 新模式 ④ = ③ + lane B 可放 load；打印 P1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
2026-10-15 docs: 会话状态（下午场）—— P0 / 砍 RV32A / 修 Run All / P1；指向 P2 为下个会话第一件事
2026-10-15 bits(demo): 演示档重出 rev1023（A 扩展默认关）—— md5 1e2075e6
    上一颗 `176e0028` 是 **rev1022、A 扩展还在**的 RTL。跑分档已经走到 `55fae69e`
    （rev1023 / A_EXT=0）⇒ 直接上板验 `176e0028` 等于【验一颗不交付的位流】，
    正是 rev1017->rev1019 那次踩过的坑。故按新的 RTL 重出演示档。
    md5 1e2075e6，`build_bitstream.ps1 rtthread` 全流程，约 7m43s
    固件 mem.hex 21046 行 / 10523 字（守卫 ✓）
    DESIGN_REV 0x2026_1023 ⇒ 串口 banner 应打 RTL=0x20261023（读 mimpid，运行时取）
    时序/资源与跑分版 `55fae69e` **逐位相同**（同一份 RTL，只换 BRAM 初始化）:
    CPU 域 u_pll->u_pll +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
2026-10-15 docs(board): RT-Thread 五子棋演示档 rev1023 上板验证通过 —— 应用场景必备项闭环
    位流 `1e2075e6`（rev1023 / A_EXT=0），日志 `uart_20261015_233418.txt`（58 行）。
    四条判据全过:
    banner `FW=RTTHREAD-GOMOKU-G3 RTL=0x20261023` ✓（读 mimpid，位流权威自证）
    `[boot] gomoku render thread running` ✓ / `ai thread running` ✓
    `[hb] alive` 5000->25000 ticks 五条、每 5s 一条、单调递增、无断 ✓
    （[hb] 能挤进来 = render 没独占 CPU，正是 G3 要证的那件事）
    附加证据: 菜单 MODE->DIFFICULTY->COLOR 真的走通、串口棋盘镜像出完整 15x15 +
    cursor=H8 you=BLACK turn=BLACK。
    显示侧（用户确认）: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
2026-10-15 docs(board): CoreMark 跑分档 rev1023 上板验证通过 —— 370.31 分，口径分裂消除
    位流 `55fae69e`（rev1023 / A_EXT=0，ITER=4332），日志 `uart_20261015_234123.txt`。
    banner `FW=COREMARK RTL=0x20261023` ✓
    Total ticks 994,412,748 ÷ 85,005,100 = 11.6983 s ⇒ **370.31 CoreMark**
    Correct operation validated ✓
    **四 CRC e9f5/e714/1fd7/8e3a 与仿真逐位一致** ✓（最硬的判据）
    拍/迭代 229,550.5（仿真 229,597，−0.0203%，在 ±0.04% 抖动内）
    意义：此前板上最好成绩是 `f64b977`（**rev1022、A 扩展还在**）的 370.23，
    而跑分档/演示档的 RTL 口径是分裂的。本颗把新生产口径也钉在板上 ⇒
    **跑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
2026-10-15 feat(core): lane B 访存管道落地（任务书 §4 A~L，parameter LANEB_MEM=0 开关未翻）
    P2 = 把任务书 2026-10-15_laneb_mem_plan.md §4 的 A~L 全部接线到位，但 LANEB_MEM=0（行为逐位不变），翻开关是 P3。
    A 新增 lane B 流水线寄存器（id_ex_b_mem_read/funct3、ex_mem_b_mem_read/funct3、mem_wb_b_funct3/addr_low）+ parameter LANEB_MEM。
    B 配对规则：p_mem_a/p_ld_b、p_opcode_b_ok 放行 load、每对最多一条访存；p_f7_b 的 M 扩展排除收窄成仅 OP_REG —— 但门控在 LANEB_MEM 上（无条件收窄会顺带放行 ~927 对 imm[11:5]==1 的 OPIMM，229,597 拍会变，破坏 P2 逐位判据；pairtrace 实测）。
    C 访存口 b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
2026-10-15 docs: P2 会话状态 + 全文档口径更新（新赛题公式 / 砍 RV32A / 基线实测修正 / lane B P2）
    新增 doc/reports/2026-10-16_session_state_p2.md（P2 主报告：A~L 清单、两处对任务书的勘误、恒 0 证明、验证记录、P3 起手）；任务书与 P0P1 会话状态加指向横幅（历史留原样）。
    口径修正（都是 2026-10-15 P0 实测值，旧值是 pre-RAS 陈旧）：EARLY_LD=0 249,982（非 252,730）、单发射 300,392（非 303,140）、Cache corner 233,013（非 235,628）；四 CRC e9f5/e714/1fd7/8e3a 全配置一致。
    CLAUDE.md：当前进度补 10-15/10-16 两块；提交档声明表更新为 55fae69e（370.31/rev1023，跑分）与 1e2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
2026-10-16 docs: P2 报告补 MEMWAIT 回归结论 + 既有 AMO 停顿 bug 归属 + 两个工具链坑
    MEMWAIT 覆盖（riscv-tests/own_tests，秒级可靠）：默认 +MEMWAIT=1/2 各 49/1/0、Cache corner +MEMWAIT=1 49/1/0、own_tests 4/5。
    own_tests 唯一 FAIL = tb_amo_cpu +MEMWAIT=1 testnum 1，已用三重证据判定为【既有 bug，与 P2 无关】：① 父提交(rev1023)同输入同样 FAIL（连编 6/6）且差分 trace 逐位一致；② b_mem_sel 插桩证实 LANEB_MEM=0 下新逻辑不可达；③ tb_amo_cpu 在 Cache corner（真实冻结）+MEMWAIT=0 下 PASS。生产配置 A_EXT=0 下 amo_unit 不例化、amo_hold 恒 0，交付位流不可能触发。
    症状留档：amoadd 循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
2026-10-16 fix(sim): 修 PS 5.1 下回归脚本被链接器 RWX 警告打断的问题（EAP 临时切 Continue）
    riscv-none-elf-ld 会往 stderr 打 'LOAD segment with RWX permissions'，而脚本设了 \Continue='Stop'，PS 5.1 会把原生命令的 stderr 包装成终态错误（NativeCommandError），构建阶段当场死（ELF/hex 其实已生成）。run_riscv_tests.ps1 不受影响（用随附预编译 ELF）。
    修法：gcc 调用期间把 EAP 临时切到 Continue 再 finally 还原，真正的失败由退出码 throw 兜。实测 2>\ 在 PS 5.1 下仍然终态，别用那个。
    影响：run_coremark.ps1 / run_own_tests.ps1 此前在 PS 5.1 下无法构建（本会话 P2 回归靠手工复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
2026-10-16 docs(p2): §9 补 rev1024 PDS 实测对比 —— LUT 7663→7918(+255)、CPU 域 +0.330→−0.165ns(83.83MHz)、位流未出（构建中断在 P&R）；同步本次 coremark mem.hex
2026-10-16 docs(p2): 补跑完整 PDS 流程确认时序回归确定性 + 根因定位到 fetch_addr + 交接任务书（修复未实施）
    完整 8 seed + report_timing + 位流的构建（p2_build_rev1024.log）与并行会话中断前的最优 seed 逐位相同：CPU 域 WNS −0.165ns/20 端点、Fmax 83.8293MHz、LUT 7,918 ⇒ 确定性回归，非 seed 抖动。
    根因修正（§9.1 判断有误）：失败路径确实经过 P2 新逻辑 —— b_mem_unaligned_5/gateop_perm LUT 在 fetch_addr 的 mux 上。load_misaligned_b 功能上恒 0 但综合器证明不了，把 alu_result_b 的 32 位加法器 cone 并进了取指关键路径（core.v:572/688 预警点），白付 255 LUT + 0.495ns。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
2026-10-16 test(laneb): R1/R2/R5 定向用例 tb_laneb_ld.S + LANEBMEM 仿真开关（0/1 两档对照，SIM CONFIG 自证）+ PAIRTRACE 被动探针
    - tb_laneb_ld.S：8 个用例覆盖 (E) lane B load-use 停顿（rs1 与 rs1_b 两路）、
    (I) lb/lbu/lh/lhu 解包前递、(G) 指针追逐（lane A load 基址来自同拍 lane B
    load）、(H) 未对齐 trap 语义（mcause/mtval/mepc）。nop+X 对齐纪律保证
    L1 必落 lane B（pair_now 约束逐项规避）。
    - tb_riscv.v / tb_coremark.v：ifdef LANEBMEM → .LANEB_MEM 显式传入 + SIM CONFIG
    打印（与 DUAL/EARLYLD/BTB 同一套显式开关纪律，默认 0 = P2 口径）。
    - run_own_tests/run_coremark/run_riscv_tests：-LanebMem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
2026-10-16 fix(timing): core.v 7 处 LANEB_MEM 常量折叠门控，恢复 85MHz 生产档时序
    门控内容（任务书 2026-10-16_laneb_timing_fix_taskbook.md §4）：load_misaligned_b / pair_now / b_mem_sel / load-use stall / exb_wb_ok×5 / ld_bad_base / wb_data_b，全部 (LANEB_MEM != 0) 前缀或 (LANEB_MEM == 0) 兜底，0 档综合器整条折叠、1 档语义不变。
    0 档逐位不变证据：
    - CoreMark 四基线 ticks 229,597 / 249,982 / 300,392 / 233,013 全命中，四 CRC（e9f5/e714/1fd7/8e3a）逐位一致
    - riscv-tests 49 PASS / 1 FAIL(ma_data 哨兵) / 0 TIMEOUT，默认与 -DCache -ICache -EarlyLd 两配置同
    - own_tests 6/0：-EarlyLd 与 -EarlyLd -LanebMem 两档均 6 PASS ⇒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
2026-10-16 feat(laneb): P3 —— LANEB_MEM 默认翻 1（lane B 放 load），DESIGN_REV 0x2026_1025
    功能全绿（1 档实测）：
    - CoreMark 217,088 拍（0 档 229,597，-5.45%）⇒ 效率 4.3555→4.6064 CoreMark/MHz（+5.76%）
    双发射 EARLY_LD=0：249,982→228,698（-8.51%）；单发射 300,392 逐位不变
    四 CRC e9f5/e714/1fd7/8e3a 全部逐位一致
    - riscv-tests 49/1/0 ×4 组（默认 / Cache corner / +MEMWAIT=1 / +MEMWAIT=2）
    - own_tests -EarlyLd -LanebMem 6/0（含 R1/R2/R5 定向用例 tb_laneb_ld）；
    +MEMWAIT=1 时 5/1，唯一 FAIL 是既有 tb_amo_cpu bug（P2 §7.4）
    - RT-Thread 四配置（无Cache/只D/只I/I+D）全 PASS，SIM CONFIG 自证 LANEB_MEM=1
    - PAIRTRAC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
    [csr_file.v, tb_rtthread.v]
2026-10-16 docs(p3): 交接文件 —— P3 全绿但 PDS 85MHz 时序不过，下一会话从 P3.5（摘 alu_result_b 腿）接起
    含：状态表 / 根因门级路径 / 三个候选修法（窄未对齐判定优先）/ 全部验证命令与 PDS 判据读法 / 关键数字速查 / 本次踩过的坑（run_own_tests 清 build、-SkipBuild 的 ITER 口径、PDS 不因时序不过而失败）。
2026-10-16 docs(p3): 交接文件补 P3.5 精确方案 —— (A) b_addr_low 改 2 位加法（行号+等价性证明）/(B) imem_addr2 解耦/(C) trap 寄存化 + 保底 RATIO0=14.0(81.97MHz,377.6分)
2026-10-16 feat(laneb): P3.5 —— 摘掉 alu_result_b 腿 + imem_addr2 解耦，1 档 85MHz 重新收敛
    两处严格等价改写（只动时序、不动语义），DESIGN_REV 0x2026_1025 -> 0x2026_1027：
    (A) core.v: b_addr_low = rs1_val_b[1:0] + id_ex_b_imm[1:0]（原 alu_result_b[1:0]）。
    OP_LOAD 译码恒 alu_a_sel=0/alu_b_sel=1/alu_op=ADD ⇒ 低 2 位模 4 加法与全 32 位逐位相同；
    b_mem_unaligned 只经 load_misaligned_b（已 AND id_ex_b_mem_read）消费 ⇒ 严格等价。
    效果：PDS CPU 域 WNS -0.701 -> -0.345 ns / Fmax 80.22 -> 82.58 MHz / LUT 8,029 -> 7,763。
    (B) core.v: imem_addr2 = fetch_addr[15:2] + 14'd1（原 imem_addr + 14'd1）。
    imem_addr 恒 = fe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
2026-10-16 feat(timing): P3.6 —— 逐 seed 读 CPU 域 + 钉 gplace_seed 5，1 档余量 +0.014 → +0.277ns，位流 c6af65be 上板 391.66 分
    方向② 四条路做尽：40 个 place seed（max +0.277，软顶约 +0.28）、同一布局扫 8 个 route seed（max 仍 +0.277）、官方 5 个优化开关显式全开（逐位不变）、place_ignore_high_fanout_net=OFF（逐位不变）=> 判据 >=+0.3ns 差 0.023ns 未达。
    取证方法：saved_outcome 无效（PDS 跑完删键 + 日志 Work directory ... has been removed），改为 P&R 跑动中每 4s 抢拷 place_route/seed_*/cpu_top_board.rtr（40 个全拿到）；gplace_seed = 起始 seed，可钉死布局（gplace_seed 5 => +0.277 逐位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
2026-10-16 docs(p3.6): 交接文件的开场提示词补上 HEAD 短 SHA e8426dd
2026-10-16 docs(p3.6): 交接提示词用 git log 指向 HEAD（避免每次提交让 SHA 过期），里程碑 = e8426dd
2026-10-16 feat(demo): P3.7 —— 演示档切 1 档（位流 e51ac9e5，上板四条判据全过）+ gomoku 1 档仿真补齐 + 脚本口径/取证工具
    (A) 演示档切 1 档（rev1027 / LANEB_MEM=1，与跑分档同 RTL）
    - scripts\build_bitstream.ps1 rtthread → 位流 e51ac9e5（16:19:57），归档
    bitstreams/rtthread_..._gomoku_g3_lanebmem_85mhz_rev1027_seed5pin_e51ac9e5.sbit
    - PDS CPU 域 +0.277 ns / 0 失败端点（19,114）/ Fmax 87.0549 MHz；.prr FF 3,691 与跑分档
    c6af65be 同网表 ⇒ 布局一致（.pds 已钉 gplace_seed 5）
    - 上板四条判据全过（日志 doc/board/uart_20261016_163009.txt）：RTL=0x20261027 /
    render+ai 两条线程 / [hb] 5000→50000 十条无断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
2026-10-16 docs(p3.7): 下一会话提示词 —— CPU 优化(效率优先/Fmax 次之)与论文正文并行；录屏等队友新版、ILA 定版后再抓
2026-10-16 feat(a1): lane B 放 store —— 实现 + 量化评估后判定【不采纳】（LANEB_ST 默认 0，交付档仍 rev1027）
    RTL：core.v 新增 parameter LANEB_ST（默认 0）。配对白名单加 OP_STORE + 新增 p_b_rd_ok
    （store 的 instr[11:7] 是 S 型立即数低 5 位、不是 rd，沿用 rd_b!=0 会静默拒掉大半 store）；
    "每对至多一条访存"由 p_mem_a && p_mem_b 表达；写口三腿 + 新增 ex_mem_b_wdata
    （ex_mem_wdata 是 lane A 的 rs2，不能借用）；ld_bad_st 并上 id_ex_b_mem_write；
    未对齐 store 进精确异常（mcause=6 / mtval=出错地址 / mepc=trap_from_b）。
    control.v 一行未改；cpu_top.v 透传；DESIGN_REV=0x2026_1028。
    判据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
2026-10-16 docs(v10): 下一会话任务书 —— CPU 侧收口（A1 不采纳 / A2·A3·A4 均判否）+ 论文 T1 主线 + 粘贴用开场白
    doc/reports/2026-10-16_taskbook_v10.md 新增 §6「粘贴用提示词」：
    把下一会话的开场白（接 a5d6682 / 现状收口 / 先读顺序 5 份文件 / T1~T5 任务与判据 /
    明确不做 / 纪律与坑 / 补充说明）写成一段可直接整段复制的文本，并在文件头指向 §6。
    要点：本轮之后【不需要】碰 rtl/**（唯一例外：§2 T4 的 A1' 单综合实验 + 队友新版 app 带来的固件变更）；
    交付口径与位流一个字未动。
2026-10-16 docs(paper): 论文完稿 v1 —— 第 1/2/4/8/9 章 + 图 1~4 补齐 + 章节按 1→9 重排
    T1（论文完稿，零机器时间）：
    - 新增第 1 章引言（§0.1 立论句 + 三句差异化 + 全文导航）、第 2 章系统架构
    （图 1 SoC 框图 + 表 1 地址映射 + 统一存储器 fence_i 核心叙事）、
    第 4 章 SoC 与外设（表 2 + 写零寄存器/外设选通 one-shot 的契约与代价）、
    第 8 章局限（由 §5.5+§3.8 扩写 + 本轮三条否证结论：配对率走完/BTB 扩表无效/
    Fmax 到 RTL 边界）、第 9 章结论；第 7 章留框架稿（等队友 app + ILA，图 6/7 显式占位）
    - 图 1/2/3/4 全部补齐（判据③）：图 2 =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
2026-10-16 docs(paper): 论文完稿会话状态报告 + 任务书指针横幅（T1 已完成，剩 T2/T5）
2026-10-16 docs(v11): 下一会话任务书 —— 论文已完稿；主线 = P0 公式口径裁决 + 等物料（T2/T5）+ 可选 T4
2026-10-16 docs(paper): P0 公式口径裁决 + A1 效率勘误（4.6084→4.6148）
    - 赛题公式 Score=Iterations/(Total_Time×Frequency) 代入 Total_Time=Total_ticks/Frequency
    ⇒ Score=Iterations/Total_ticks（CoreMark/MHz），主频约掉不进主分；§6.1 补数值自证
    - 删旧公式残留：§3.2 读法(1) 与 §3.2 换档账(3) 的盈亏平衡/物理分/降频亏 2.4%；
    §6.4 重写为『主分已落袋、卡住的是指标(2)与生产频率』
    - A1 换档账改新口径：metric(1) +0.18% vs metric(2) Fmax 87.0549→83.8926（−3.6%）
    + metric(3) CoreMark/千LUT −1.6%；§6.3/第9章注明经典分 391.66 与主分的角色
    - 勘误：A1 后仿真效率 4.6084(+0.043%) 算术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
2026-10-16 docs(v12): 重写交接任务书 —— 公式口径置顶（主频约掉）+ 旧口径黑名单 + 剩余任务 T1/T2/T3/T4
2026-10-16 docs(t3): A1' 结构化门控实验已执行——假设证伪（仅 -3 LUT）已回滚 + T1/T2 物料复核仍未到手
2026-10-16 docs(t3): 修正 T3 日志路径引用（pds/RV32I_1/_t3_*.log）
2026-10-16 docs(口径): 活跃文档旧口径大扫除——主分/经典分角色分离 + I+D 拆账与 A1 降频论证按 v12 §0.1/§0.2 裁决重写（历史档案不动，对外数字零改动）
2026-10-16 feat(prof): +PROF 新增 region instr（指令级 IPC 口径修正 0.899→1.265）+ coremark_perf_report.py 同口径报表 + 跨组对比表（框架 §0.2/正文 §6.6）；观测代码回归逐位不变
2026-10-16 merge(t6): 并入队友 T6 阶段 1 五子棋（竖排菜单 + 23 装饰 tile 运行时合成）—— rtl/ 零改动；接口面 gomoku_run/VIDEO_* 零命中；x86 六轨道全过（test_render 两条旧断言随 T6 同步修）；修复 tb_gomoku.v 函数返回值位选的从未编译错误；rtthread 演示固件 .text 变（21046→22028 行）已同步 e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
    [tb_gomoku.v]
2026-10-16 docs(v13): 交接任务书 —— T6 已整合（5d55074）+ 剩余 4 步路径/判据 + 五处同步待填模板 + rtthread 影响面结论 + vvp 节流等环境坑
2026-10-16 revert(a1): 退回 lane B 放 store（rev1028→rev1027）—— 恢复钉住的 seed 5 余量 +0.277ns
    ## 为什么要退
    A1（lane B 放 store）已于 a5d6682 判定【不采纳】，但实现留在了树里（LANEB_ST 默认 0），
    树里 DESIGN_REV=0x2026_1028。问题在于：**关档只折叠了 FF，没折叠逻辑** ——
    实测 净表 LUT +122（7,195→7,317）、FF 3,691 完全相同，而本项目【钉了 gplace_seed 5】，
    **那个余量只对某一版净表成立**：
    跑分档 c6af65be（rev1027） LUT 7,753 CPU 域 **+0.277 ns** / 0 失败端点 / Fmax 87.0549
    现树 447c1261（rev1028, ST=0）LUT 7,889 CPU 域 **−0.156 ns** / **5 个失败端点** / 83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
    [csr_file.v, tb_gomoku.v, tb_rtthread.v]
2026-10-16 docs(sync): 五处同步 —— 演示档 e51ac9e5 → 5909a2d0（T6 版）；A1 退回；tb_gomoku 加进度检查点
    按任务书 v13 §3 的模板做五处同步（新 md5 `5909a2d0`，旧档 `e51ac9e5` 按"追加式降级"处理）。
    【同步的文件】
    1. `CLAUDE.md`：结论区① / ★提交档表 / 结论区 —— 新增 T6 重出块；★提交档换成 `5909a2d0`，
    `e51ac9e5` 单列一行"前一档（演示，T6 前）"
    2. `doc/paper/论文框架_v1_20261012.md`：§0 横幅加第 10 条；§0.1 的 ★提交档（演示）换新 md5，
    新增"前一档（演示，T6 前）"行
    3. `doc/board/README.md`：顶部横幅加 T6 块；新增一节【T6 版重出 · 板上待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
2026-10-16 fix(sim): tb_gomoku 的 press_short 按住 2 帧 ⇒ 被固件判成【长按】，菜单全带偏（附失败证据）
    ## 症状（2026-10-16 21:06 起的那次跑，跑了 125min 才读出结论）
    [ok] banner 收到 / 棋盘左上角已铺好 / 天元是星位点
    [FAIL] 菜单确认到底后没等到 start —— 开局没生效
    [进度] t=246647065 ns 帧=60 checks=4 errors=1
    即任务书 v13 §2 第 1 步点名的**嫌疑点①**。证据日志归档
    `doc/reports/2026-10-17_t6_gomoku_firstrun_fail.txt`。
    ## 根因（按固件常量推导，不是猜）
    `build.ps1 -Sim` 传 `-DINPUT_DEBOUNCE_MS=1 -DINPUT_LONG_MS=5`
    （见 `scripts/gomoku/input.h:51`）⇒ 仿真里 **去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
    [tb_gomoku.v]
2026-10-16 fix(sim): 还原 press_short 的 2 帧时序（我上轮改 1 帧是错的）+ 加固件输入状态机探针
    ## 更正上一轮的判断（a793072 的 press_short 改动是错的）
    上轮我按"物理按住 6.9ms > 长按阈值 5ms"推出 press_short 有问题、改成按住 1 帧。
    **那个模型不对** —— 读了 `scripts/gomoku/input.c` 的去抖实现才看清：
    if (lvl != raw[k]) { raw[k] = lvl; t_edge[k] = now; } // 电平一变就记时刻
    if (lvl != stable[k] && (now - t_edge[k]) >= debounce) { …认账… } // 但那一拍 now-t_edge == 0
    `t_edge` 在"发现变化的那一拍"记录 ⇒ **那一拍永远判不过**；必须等下一个采样拍电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
    [tb_gomoku.v]
2026-10-17 fix(gomoku/ui): STEP 行闪烁（幂等写）+ 菜单逐项居中 —— 用户 2026-10-17 上板反馈的前两条
    ## ① STEP 行闪烁（AI vs AI）
    `draw_hud()` 是**每帧**调的，而 `render_text()` 每次都**整行重铺 40 个图块**
    （哪怕内容一模一样）。写的时候若已经出了 vblank 窗口，屏上就看得见这一行在闪。
    其它 HUD 行内容平时不变所以看不出来；AI 对弈时每帧都在推进，最容易暴露。
    新增 `render_text_dedup(slot, row, col, s)` / `render_text_dedup_center(slot,row,s)`：
    记住该槽位上一次写进去的整行内容（含列），**一模一样就跳过这次写**。
    HUD 的 6 个槽位 = 行 1 / 2 / 3 / 4 /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
2026-10-17 fix(gomoku/ui): AI VS AI 下不画光标 —— 去掉棋盘中间的红色圈圈闪烁（用户上板反馈）
2026-10-17 feat(ila): 探针束 ila_probes.vh —— 91 根单 bit，综合实测 91/91 存活
    为"抓定稿 ILA 波形"重建探针。**旧的 86 根探针从来没进过 git**
    （`git log -S PAP_MARK_DEBUG -- rtl/core/core.v` 零命中 ⇒ 当年是临时写在工作区、
    采完就还原），归档的 debug 位流也不在盘上 ⇒ 只能按 doc/ila_analysis.md §7.1 重写。
    ## 内容（91 位，DebugCore 上限 256）
    | 组 | 根数 |
    | 总线拆位：pc / if_id_pc / id_ex_pc / ex_mem_pc 各 15 + if_id_instr[6:0] | 67 |
    | 流水线事件：stall / div_stall / ex_flush / id_ex_mem_read / 四条前递 / id_ex_branch / branch_taken / mem_we / mem_re / mem_wb_reg_write | 18 |
    | 分支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
2026-10-17 fix(ila): 探针属性改精确形式 `<0/d0/N>`（首版只写 `<N>` 会让通道映射全错位）+ Inserter TCL + 上板日志
    ## [!] 修正上一提交（938785d）里的一个会白跑一整轮的错
    首版探针属性写成 `PAP_MARK_DEBUG="<31>"`（只写数字）。查 doc §7.2 的实测可用写法：
    必须用**精确形式** `<核号/端口类型+序号/通道号>`（d=data/t=trigger/c=clock）。
    只写 `<数字>` 既不是模糊形式（true/1）也不是精确形式 ⇒ Inserter 通道分配整体错位，
    文档原话"波形有信号但全不对，极难排查"。照首版做完 Inserter 再上板会浪费一整轮。
    现在：
    ```verilog
    wire ila_pc_0 /* synthesis PAP_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
2026-10-17 docs: 会话状态 2026-10-17 —— T6 上板通过 / A1 退回 / 界面修3条 / ILA 探针重建；128KB 决策为下会话第一件事
2026-10-17 docs: 赛题一答疑对照 + 三人分工任务书 + 128KB 交接（单一位流决策）
2026-10-17 feat(mem): 128KB 统一存储器 —— 15 位字地址 + 兼容区别名修复
    RTL: core/cpu_top/mem_bus/unified_mem/cache_i/cache_d 的 word 索引 14→15 位；
    兼容区判决加 !addr[16]（0x1FFF0 不再误中 MMIO）；快通路 load 的 RAM 判定放宽到
    0x0~0x1FFEF；DESIGN_REV → 0x2026_1028。
    Sim: mem_model 与全部 tb 的地址宽度/范围判定同步。
    Tests: 新增 hi_fetch_128k.S（16384-word 回绕边界），并验证把 imem_addr2 改回
    14 位时该测试 FAIL（testnum 1）。
    回归：CoreMark 217,088 拍 + 四 CRC 逐位一致；D-Cache 217,573 + 四 CRC；
    riscv-tests 49/1/0；own_tests 8/0。PDS 时序待重扫 seed。
    [csr_file.v, tb_gomoku.v, tb_rtthread.v]
2026-10-17 feat(timing): rev1028 收敛到 76.5052MHz (STATIC_RATIO0 15.0) + 钉 gplace_seed 10
    128KB 统一存储器在 85.0051MHz 下收不住：8 个 seed 全负，最好 seed 10 = -0.796 ns / Fmax 79.62，极差 0.513 ns。改 PLL STATIC_RATIO0 13.5 -> 15.0 降到 76.5052MHz。
    实测（CPU 域 path group，seed 10）：
    WNS +0.304 ns / 0 失败端点（21,135）
    Fmax 78.3269 MHz（Estimated，周期 12.7670 ns）
    跨域 CPU->pix_clk +6.484 ns / 0 端点
    Design Summary: All Constraints Met
    位流 pds/RV32I_1/generate_bitstream/cpu_top_board.sbit md5 6074c89c（未上板）
    资源 LUT 7,740 / FF 3,692 / DRM 165.5 (40%)
    回归（板上配置，2026-10-17 17:08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
2026-10-17 docs: 76.5MHz 交接入口 + 官方答疑原表逐行核对（7 条勘误，带 Excel 行号）
    新增 doc/reports/2026-10-17_handoff_mem128k_cpu.md 作为唯一入口（§5.1 四探针全绿）。qa_compliance §9：来源换成原件 xlsx（135 条有内容行，R##=Excel 行号），修正 7 条 —— 行数 198->135、板卡答复 R112=200K MINI、Cache 两条（R38 未答 / R106 已答）、R127 频率限制未答、R36 同义未答、LUT 范围仍未答、高阶①评定未答。three_way_split 顶部声明 §2.5 判据 85.0051->76.5052。
2026-10-17 feat(bitstream): 单一位流 b45941d6 —— boot selector + 合并镜像（39,420 行）
    官方答疑 R99「跑分和应用同一个 bit 流」落地：128KB 里同时驻留 boot / CoreMark / RT-Thread，复位后按 key[2] 选路。
    新增：
    scripts/boot/{boot.S,link.ld,build.ps1} boot selector，17 字 / 68 B / _end 0x44
    读 0x8000_0000 的 key[2]（bit10 = SW6，低有效），连采 3 次按位与：
    按住 -> jr 0x1000（CoreMark），松开 -> jr 0x10000（RT-Thread）。选路在任何写 RAM 之前。
    scripts/merge_images.py 三块镜像合并 + 布局校验
    scripts/run_combined_sim.ps1 + sim/tb_combined.v 两条路径的仿真判据
    改动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
2026-10-17 fix(build): 分离经典分与主分口径（eeTicks/cpiCycles 是经典分，不是 CoreMark/MHz）
    76.5052MHz / 217,088 拍 => 经典分 352.4 / 主分 4.6064。原打印把 352.4 标成 CoreMark/MHz，会把答辩数字说错一个数量级。
2026-10-17 docs(board): b45941d6 板上双路径实测 —— R99 从设计意图变为板上事实
    证据：doc/board/uart_20261017_185444.txt（COM4，3 次复位，120 行）。
    路径 B（默认）：banner -> [boot] heap = 4840 -> render/ai 线程 -> [hb] alive 5000/10000/15000 ticks
    路径 A（按住 SW6 + SW3）：Total ticks 846,440,591 / 11.0638 s / 四 CRC e9f5 e714 1fd7 8e3a / Correct operation validated
    口径修正：
    板上真值 经典分 352.5 / 主分 4.6075（按 Total ticks ÷ EE_TICKS_PER_SEC 算）
    串口打印的 Iterations/Sec 354 是整数秒截断（11.0638 截成 11），高报 0.4%，报告不许用
    资源用 run.log 的 Total LUTs 7740（逻辑口径），别用 Devi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
2026-10-17 docs(board): vblank timeout 判定为良性（D18 常亮 + 画面正常），不改固件
    复位后视频域比 CPU 慢，主循环第一次 video_wait_vblank() 的 50ms(≈3 帧) 窗口没等到；
    超时保护让它继续跑，第二帧起恢复，之后整局不再报（warned_no_video 一次性）。
    处置：不改固件、不重出流（改 printf 也要重出 15 分钟并让 b45941d6 作废，收益为零）。
    报告口径：启动瞬间视频域未就绪，首帧同步超时一次后自动恢复；把 50ms/3 帧超时保护
    列为鲁棒性设计（scripts/gomoku/video_port.c:41-67，2026-10-07 无超时忙等实踩的修复）。
2026-10-17 docs(delivery): rev1028 交付页 —— 数字唯一源（主分 4.6075 / Fmax 78.3269 / LUT 7,740）
    集中收口答辩与报告的全部数字，并标注五处口径陷阱：
    1. 串口 Iterations/Sec 354 是整数秒截断（11.0638->11），真值 352.5
    2. 资源引 run.log 逻辑口径 7,740，不引 CLMA+CLMS=8,762 站点口径
    3. Fmax 只认 report_timing/cpu_top_board.rtr 的 CPU 行，不引 multiseed 的 Setup(Slow)
    4. capture_seed_timing 已改为从报告读请求周期（76.5->78.3269 / 85->87.0549 双档验证）
    5. 85.0051MHz 已 8-seed 证伪（seed10 -0.796ns / Fmax 79.62），不再追
    含 2L200H 资源证明页（4.84% / 1.16% / 39.88%，DRM 余量 60%），
    20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
2026-10-17 docs(archive): 归档交付位流 b45941d6（md5/sha256/配置/镜像三段/时序/板上实测/备份关系）
    pds/RV32I_1/bitstreams/README.md 新增 rev1028 章节（80 行，UTF-8 保持原编码）。
    归档物：
    combined_boot_coremark_rtthread_..._76mhz_rev1028_seed10pin_b45941d6.sbit（本地，9,188,552 B）
    md5 b45941d6db1e3d1116deb3e080c03ba7
    sha256 59a21d8f125bba5b4d7b016f2f3269d7f36d8fe4246de5706d43792166f04846
    rev1028_combined_76mhz_seed10_b45941d6_timing.rtr（341,258 B，同一次 P&R 的时序副本）
    pds/RV32I_1/mem.hex 39,420 行，sha256 d8a8ce93...
    写入 README 的判据：
    CPU 域 +0.304 ns / 0 失败端点（21,135）/ Fmax 78.3269 / All Constra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
2026-10-17 docs(handoff): 下一会话交接单（现状/冻结决定/证据/剩余任务/12 条陷阱/命令）
    面向零上下文的接手者：一句话现状 -> 冻结的 6 条决定 -> 8 条可复查证据 -> 6 项剩余任务（含依赖与估时）
    -> 12 条硬约束（固件冻结窗口、只认 CPU 行、multiseed 口径、354/HAS_FLOAT 不可行、LUT 两口径、
    不 checkout .pds、pc=target+4、merge 五类硬错、!addr[16] 别名、PS5.1 BOM/GBK、PDS 并发锁）
    -> 常用命令 -> 两项待人确认（200K MINI 容量、评估档是否真跑）-> 本轮新增文件清单。
    数字一律指向 delivery_rev1028.md，过程一律指向 handoff_mem128k_cpu.md，避免三处口径漂移。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
2026-10-17 docs(reports): 交付线加 rev1029 入口指针（只加文档，不合并 RTL）
    原因：减 LUT 的全部工作在 feat/lut（多 5 个提交），本工作树看不到 rev1029 的交付页与交接单，下个会话容易误读成文件丢失或引用旧数字。
    新增 doc/reports/2026-10-17_rev1029_入口.md：不切分支的查看命令（git show feat/lut:...）、两线数字对照、状态（已上板/未完成项）、以及将来合并的显式步骤与不变量（本线源码 == 归档位流 b45941d6）。
    handoff_next_session.md 顶部加 6 行追记，指向该入口。rtl/、pds 构建产物、分支（仍是 feat/mem128k）全部未动。
2026-10-17 docs(reports): rev1029 入口文档勘误（编码事实 / 提交数 / 入口命令）
    1) bitstreams/README.md 经字节核对是 UTF-8 无 BOM / CRLF（23 20 E5 BD 92 = '# 归'），此前写'GBK，别用 UTF-8 工具改'是错的 —— 做 GBK 转码才会写坏；该章节已在 feat/lut 写完（97b45cc）。
    2) feat/lut 已领先 7 个提交（补 98fbab3 / 97b45cc）。3) 本文件只存在于交付线，删掉会被 git 报 'exists on disk, but not in feat/lut' 的入口命令。
    只改文档；rtl/、pds 构建产物、分支均未动。
2026-10-17 docs(board): 2026-10-17 深夜三份上板日志入档（空抓取 / 烧错流 / rev1029 通过）
    233249 = 无数据；233332 = RTL=0x20261030 的 perf-opt bacbcaee（Total ticks 807,669,047，非候选）；233638 = rev1029 c642c0ac 通过（RTL=0x20261028 / 846,440,591 / 四 CRC 全对）。
2026-10-17 docs(reports): 入口文档不再写死提交数（改为现查 + 关键提交说明）
    feat/lut 每加一个文档提交，这里的数字就过期一次；改为 git log 现查，并列出关键提交的语义。只改文档。
2026-10-17 docs(口径): 交付线文档统一到 rev1028 + 候选 rev1029（CLAUDE / 板级 / 论文 / 交接 / 位流索引）
    CLAUDE.md：顶部'分支状态'块重写 —— 交付 rev1028 b45941d6 @76.5052（4.6075/352.5/Fmax 78.3269/LUT 7,740），候选 rev1029 c642c0ac（LUT 6,932/③ +11.7%，feat/lut，未合并），perf-opt 判死；明示 85MHz/c6af65be/391.66/7,753 为历史口径。
    doc/board/README.md：顶部口径横幅换 rev1028，并把 rev1027/85MHz/c6af65be/391.66 整块降级为历史对照（此前读者会误以为 391.66 是当前分）。
    doc/paper 论文框架 §0/§0.1：加'已作废'横幅 + 当前三指标，明示下表 4.6064/391.66/7,753 属 rev1027 时代，不许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
2026-10-17 docs(perf): 交叉实验结论落档 —— ① 天花板 4.6075（两张网表实测），实验分支改归档 tag
    handoff §4/§4.1：P0 交叉实验标完成，结论=不收敛（seed10 -0.449 / 最优 seed5 -0.259）；剩余动作改为'② 40 seed 采样'与'③ 不做'；提指级重构列为下届。
    CLAUDE.md：性能线改为归档表述（tag archive/perf-opt / archive/lut-perf，分支已删），并写明两张网表的实测差额。
2026-10-17 docs(128k): 活文档同步到 128KB 口径（spec 地址映射 / 基础任务状态 / 论文三篇 / 资源效率）
    spec.md §4.2：RAM 0x0~0x1_FFEF（32,768 字、15 位字索引），补 !addr[16] 兼容区判决、双栈顶（0xF000 / 0x1FFF0）、两次扩容踩坑（imem_addr2 13 位、兼容区漏 addr[16]）；PLL 说明改 76.5052 生产档；定时器回绕周期补 76.5 档 56.1 s，跑分档改 ITER=3900。
    base_task_status：顶部加 2026-10-18 口径横幅，地址表改 128KB，边缘 AI 条目改 128KB。
    论文三篇（overview / 正文 v0 / 撰写思路）+ resource_efficiency：加横幅声明正文数字属 64KB/85MHz 时代；正文表 1 的 RAM/兼容区两行直接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
2026-10-17 docs(128k): ILA 探针文档与板级历史记录补 128KB 口径
    ila_analysis.md：顶部加'重建 .fic 前必读'横幅（32KB/15 位 PC/91 探针预算写于 2026-09-21，128KB 后 PC 需 17 位，整表 +2 位，且 .fic 必须与最终交付位流同源）；探针表首行注明位宽基准与 +2 位要求。
    board/README.md：'>32KB 代码才验证得到'的历史结论补注（128KB 后该验证可做，但现有固件仍 <32KB）。
    只改文档；推送前已确认无 PDS 进程。
2026-10-18 docs(perf): §4.1 区分交付与候选的 Fmax（78.3269/+0.304 vs 78.3699/+0.311），40 seed 标为进行中
2026-10-18 docs(perf): 40 seed 采样结论落到 §4.1 —— ② 软顶 +0.358/78.6596（+0.37%），不换流
2026-10-18 docs(perf): ② 行更新为'已采用 seed 29（273f6c5a，待上板）'
2026-10-18 docs(reports): 入口文档与交接单同步到 273f6c5a（已上板：+0.358/78.6596，日志 uart_20261018_144114）
2026-10-18 docs(board): 2026-10-18 上板日志入档（273f6c5a：846,440,591 / 四 CRC 全对 / menu=HUMAN）
2026-10-18 docs(handoff): 新增 2026-10-18 交接单（rev1029 收尾 / 五子棋新版待接）
2026-10-18 feat(gomoku): 标题屏改版 —— 深色 UI 底 + 4x 大 logo + 金色选中框 + 闪烁提示 + 7x7 自动对弈
    任务书 2026-10-18 任务 A（只动固件，不碰 rtl/、不跑 PDS）。
    界面：
    - 调色板新增 5 项：UI 深色底(墨绿) / 暖白字 / 金色强调 / 阴影 / 分隔线；
    前 7 项（棋盘木色、棋子、光标）一项没动 ⇒ 对局棋盘配色不变。
    - FONT_BG/FONT_FG 改指 PAL_UI_BG/PAL_UI_FG ⇒ 标题屏、HUD、CoreMark 控制台同一个底。
    - 4x 大 logo "GOMOKU"：每字 2x2 图块（32x32），两个 O 画成黑/白棋子（金边 + 深色投影）。
    - 菜单选中态：金色 3 行高描边框 + 框内棋子图标（不用整行底条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
2026-10-18 feat(coremark): CoreMark 输出镜像到 HDMI + 结果页 + 0xFF00 共享邮箱
    任务书 2026-10-18 任务 B（分支 feat/coremark-display，从 feat/mem128k 拉；只动固件）。
    - 新增 scripts/coremark_port/video_text.c/.h：40x30 极简文本控制台。
    调色板/字库直接 include scripts/gomoku 的 palette.h / font.h（不复制副本），
    图块在 init 里现算写显存，固件里只有 665 B 字模。
    - ee_printf 逐字符同时写 UART 和显存：跑分时 HDMI 上像终端一样滚动。
    - 结果页（portable_fini）：ITER / Total ticks / 时间 / CoreMark per MHz / Score /
    四个 CRC / CRC OK / "SW6 UP + RESET -> GOMOKU"。数字全用 64 位现算，
    不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
2026-10-18 perf(gomoku): 36 块棋盘图块改运行时合成，.rodata 减 9,216 B（堆 128 B -> 9,320 B）
    任务书 §2.4 点名过的第一个该压的东西：tiles.h 的 TILE_PATTERN 是 36 x 256B =
    9,216 字节常量表，跟着 RT-Thread 镜像一起占 RAM。标题屏改版后镜像涨到 96.8%、
    堆只剩 128 B，不满足"堆 >= 8KB"。
    - render.c 新增 synth_board_tile()：线宽 2px / 棋子半径 6（2x 整数坐标算圆，
    不链 libm）/ 光标空心圈 5.5..7 —— 与 gen_tiles.py 的几何逐像素等价。
    - gen_tiles.py 拆两个产物：tiles.h 只剩常量与编号；参考像素表搬到 tiles_data.h，
    **只给 x86 单测当对拍真值，不进固件**。
    - test_rend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
2026-10-18 fix(gomoku,coremark): 第二轮上板反馈 —— 标题屏栅格化 + 选中框竖线收口 + 结果页分组
    按 RISC-V_界面第二轮反馈关键词_20261018.md 逐条改（T1~T11 / H1~H3 / C1~C4）。
    标题屏（T1/T2/T3/T4/T6/T7/T8/T10/T11）：
    - 版面改成**从锚点派生**：MENU_ROW0=7、MENU_ITEM_GAP=4、MINI_BOARD_TOP 严格
    == MENU_ROW0（编译期 typedef 负数组卡住 + 启动打 `[title] menu_row0=.. mini_top=..`）。
    - 副标题挪到 row 4，标题与副标题之间留 1 行（T1）；菜单/棋盘从 row 7 起。
    - 菜单项位置 7/11/15/19，选中框 3 行高、项间空 1 行（T11）；**所有项共用固定框宽
    23**、图标列（col 2）与文字列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
2026-10-18 docs(board): 2026-10-18 两轮上板日志入档（heap 9320 / CoreMark 846,440,591 不变 / 四 CRC 全对）
    - uart_20261018_171045.txt：改版前参照（15:14 构建）
    - uart_20261018_191531.txt：第一颗 combined 位流 c10f26f3 实测
    · [boot] heap = 9320（图块改运行时合成后）
    · CoreMark Total ticks = 846,440,591 —— 与不开屏逐位相同（任务 B 的核心判据）
    · 四 CRC e9f5/e714/1fd7/8e3a、Correct operation validated
    · AI VS AI 连走多手（nodes/depth/耗时正常），[hb] 无断
    · [!] vblank timeout 每次复位打一次（既有问题，屏仍正常，按纪律不追）
2026-10-18 feat(tools): 五子棋主机预览 —— ASCII tile 网格 + 640x480 BMP + golden 对比
    scripts\gomoku\preview.ps1 把真实的 main.c/render.c/game.c 链到 x86，
    用假 vid_bulk_write 接住显存写入，输出 40x30 tile 网格和可选 BMP；
    -SaveGolden/-Check 用于冻结对局屏、防止标题屏改动波及。
    不碰 RTL，不需要板子/iverilog/RISC-V 工具链。
2026-10-18 chore(gitignore): 忽略主机预览的可重生成产物（exe/_main_preview.c）
2026-10-18 feat(gomoku/ui): 主界面第三轮 —— 炭黑底 + 金色三角 + 菜单居中 + 冒号提示 + 小棋盘对齐
    - 调色板 PAL_UI_BG 墨绿 -> 炭黑 #1A1A1E，阴影/分隔线同步；
    - 标题栅格：logo 1~2 / 副标题 4 / 金色分隔线 5 / ● VS ○ 6 / 菜单 8；
    - 菜单：固定卡片宽度 + 文字居中 + 黑白子图标 + 金色右三角（新 tile 187）；
    - 小棋盘外框顶行 = 第一项菜单行（MINI_CELL_ROW = MENU_ROW0+1），7x7 完整；
    - 底部：UP/DOWN : MOVE、HOLD : OK、LEFT : START；PRESS ANY KEY 500ms 闪烁；
    - LAST COREMARK / SCORE / CRC 之间各空 1 行；
    - 对局 HUD 布局未动，仅随调色板换底色；
    - x86 单测全部通过；预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
2026-10-18 test(gomoku/ui): 冻结主界面 golden（title 栅格），供 preview -Check 使用
2026-10-18 chore(build): combined 行数守卫更新到主界面改版后的实测值
    coremark 22,782 / rtthread 20,100 / combined 42,916 行
    （CoreMark 加 HDMI 文本控制台、RT-Thread 加主界面改版后的实际镜像）。
2026-10-19 feat(t7): CoreMark 监控屏 + RT-Thread 渲染修复 + 入口文档同步
    - boot 三路径（SW6 官方跑分 / SW6+SW7 终端演示屏 / 默认五子棋）
    - 终端屏绝对 X 排版；SYSTEM MONITOR 三行真实值
    （rt_tick_get / RT_TICK_PER_SECOND / rt_memory_info）
    - 删写死 CPU USAGE；RT 构建去掉 uart_dump_board（省 ~500B）
    - 修复 JALR 双发射 fall-through 的 nop 绕行、菜单金线、最后一手棋子
    - 线程栈 4KB->3KB，堆 1,440B；RT 59,980/61,424B
    - README/CLAUDE/论文§0/board/bitstreams/脚本入口 同步到
    76.5052MHz / 352.5 / 4.6075 / Fmax 78.3269 / LUT 7,740
    - 明确区分官方交付 b45941d6 与 T7 6E2D6020；历史报告未改动
2026-10-19 docs(rtthread): 统一 mem.hex 行数/字数口径
2026-10-19 docs(paper): 论文/资源效率/任务状态表同步到 76.5052 交付口径
    - 正文引言：352.5 / 4.6075 / Fmax 78.3269 / LUT 7,740
    - 论文策略表：最新值改为 b45941d6 交付；85MHz 线降为历史
    - 资源效率表：4.6075 / 217,036 / 76.5052 / LUT 7,740
    - 任务状态验证表：新增当前 CoreMark 行，旧 85MHz 行标历史
2026-10-19 fix(gomoku): CoreMark 监控屏堆余量改字节制显示
    旧显示 HEAP FREE : 0.0K —— 本系统堆仅 1,440 B，按 KB 取整恒为 0.0K，
    容易被误读成分配失败或假数据。改为 <剩余>/<总量>B：
    * cm_mon_heap_free() 增加 total_out 出参，值仍来自 rt_memory_info()
    * 剩余字节用 GREEN8（8x8 亮绿）绘制
    * "/1440B" 用通用 8x8 字补（GREEN8 子集不含 / 与 B）
    主机预览编译通过；真实值需重出位流后从板上取。
2026-10-19 docs: README 补 CPU/软件设计章节；新增比赛技术文档 v1
    README：
    * 补系统总览（Mermaid 框图 + 模块职责 + 三路径/镜像布局）
    * 补 CPU 微架构：参数表、取指时序不变量、双发射配对规则、
    4 读 2 写寄存器堆、冒险/预测/异常、Cache 口径、拍数演进
    * 补软件栈：RT-Thread 方式一移植、五子棋规则/AI/渲染/输入、
    CoreMark 移植与终端屏、三路径引导
    * 修过期口径：64KB 地址映射改 128KB、85MHz/ITER=4280 改 76.5052/3900
    doc/contest：技术文档 v1（docx + pdf + 数据来源 + 待补清单 + 生成脚本）
2026-10-20 优化了代码相关注释
